Vlad-alco/BuhloWar/docs/STAGE3_MAX31865_PLAN.md

# Этап 3 — Точные датчики: MAX31865 + Pt100/Pt1000

**Статус: черновик для обсуждения. Код не написан.**
По AI_RULES.md: сначала согласование, код — только после «да» автора.
Дата: 2026-10-27. Согласован со старым анализом: `docs/DS18B20_vs_Pt100_BuhloWar.pdf`.

---

## 0. Резюме (TL;DR)

- Что делаем: заменяем DS18B20 на критичных каналах **TSAR и TANK** (опционально все 4) на платиновые датчики сопротивления **Pt1000** через модули **MAX31865**. SensorManager становится **маршрутизатором источников**: оператор выбирает для каждого слота «DS18B20» или «MAX31865», выбор хранится в EEPROM.
- Зачем: решения движка на TSAR принимаются с шагом 0.06 °C (шпора) и гистерезисом 0.24 °C — это размер одного младшего бита DS18B20 (0.0625 °C). Pt1000 + MAX31865 дают шаг ~0.03 °C, преобразование в 10+ раз быстрее и аналоговую измерительную петлю без «подвисаний» 1-Wire.
- Вся защита Этапа 1 (медиана-5, гейт, stale) и SIM-режим Этапа 2 работают поверх без изменений — они стоят выше по конвейеру данных.
- Ответы на вопросы по железу (кратко, подробно в разделах 3–5):
  1. **Pt1000 класс B, 2 контакта, 2 м силиконового кабеля — ПОДОЙДУТ.** Вклад проводов всего ~0.02–0.05 °C, и он постоянный — убирается штатной калибровкой смещения.
  2. **«Универсальных модулей нет» — почти правда.** Сама микросхема MAX31865 универсальна (Pt100 и Pt1000), но на плате запаян опорный резистор, задающий шкалу: **430 Ом — для Pt100, 4300 Ом — для Pt1000**. Напаивать ничего не нужно, если купить модуль под свой датчик (или плату с перемычкой выбора).

---

## 1. Зачем этот этап (проблема DS18B20 на критичных каналах)

DS18B20 — хороший цифровой датчик, и на TSA/AQUA его хватает с запасом: там управление относительное (охлаждение, безопасность), и даже ±0.5 °C ничего не ломает. Совсем другая ситуация на TSAR (ректификация) и TANK (куб):

- **Шпора**: стабилизация по дельте 0.06 °C, минимальная рабочая дельта 0.12 °C. Разрешение DS18B20 — 0.0625 °C, то есть один квант датчика равен целой рабочей дельте. Малейший шум или дрейф «съедает» сигнал.
- **Гистерезис ректификации** 0.24 °C и сравнения с двумя знаками после запятой.
- **Крепость по температуре**: погрешность 0.5 °C в узле отбора — это 1–2 % об. ошибки крепости (с учётом поправки 0.037 °C/мм рт. ст.).
- **СМЕНА ТАРЫ и БАКСТОП** по TANK: пороги 92 °C и 99 °C — тут запас побольше, но куб — вторая по важности точка.
- **1-Wire как шина**: все 4 датчика на одном проводе GPIO3. Подвисания, отдельные выбросы, обрывы — то, что мы уже огородили фильтрами Этапа 1. Фильтры лечат последствия, но не причину.

Pt1000 через MAX31865 убирает саму причину: измерительная петля аналоговая (провод + резистор), опрос в 10+ раз быстрее, «подвисаний» как у цифровой шины не бывает в принципе.

Сравнение в цифрах (для нашего диапазона 20–100 °C):

| Параметр | DS18B20 (как сейчас) | Pt1000 + MAX31865 |
|---|---|---|
| Разрешение | 0.0625 °C (12 бит) | ~0.03 °C (15-бит АЦП, опора 4300 Ом) |
| Время преобразования | 750 мс | 52–70 мс (фильтр 60/50 Гц) |
| Подвисания шины | бывают (1-Wire) | не бывают (аналоговая петля) |
| Влияние проводов 2 м | нет (цифровой) | ~0.02–0.05 °C (2-пров., Pt1000) — калибруется |
| Точность после калибровки смещения | ±0.2–0.5 °C | ±0.3–0.7 °C (класс B), лучше у класса A |
| Стабильность дельт во времени | шум 1–2 кванта | шум < 1 кванта |
| Цена канала (модуль + датчик) | ~50–150 руб | ~250–500 руб |

Главный выигрыш не в «абсолютной точности» (она сопоставима после калибровки), а в **разрешении, скорости и стабильности** — ровно в том, на чём держится шпора 0.06 °C.

---

## 2. Как это работает (объяснение для новичка)

**Pt1000** — это платиновая плёнка в герметичном корпусе-щупе, чьё сопротивление плавно растёт с температурой: 1000 Ом при 0 °C, ~1385 Ом при 100 °C, примерно +3.85 Ом на каждый градус. Это стандарт МЭК 60751, поэтому зависимость сопротивления от температуры описывается известной формулой (Каллендара–Ван Дюзена) — по измеренному сопротивлению температура вычисляется математически.

**Pt100** — то же самое, но 100 Ом при 0 °C и ~0.385 Ом/°C. Обозначение «B» после названия (Pt1000B) — класс допуска: для класса B погрешность не хуже ±(0.3 + 0.005·|t|) °C; класс A вдвое точнее — ±(0.15 + 0.002·|t|) °C.

**MAX31865** — микросхема-«переводчик» с сопротивления на цифру:

1. Пропускает небольшой ток через датчик и через **опорный (референсный) резистор** на плате.
2. 15-битный АЦП измеряет **отношение** падений напряжения «датчик / опора» (ratiometric-измерение). Поэтому точность почти не зависит от стабильности питания и тока — только от качества опорного резистора (на платах стоит прецизионный, 0.1 %).
3. Пересчитывает отношение в сопротивление, а температуру можно взять из формулы для платины.
4. Умеет аппаратно компенсировать сопротивление проводов в 3-проводной схеме и имеет **регистр неисправностей**: обрыв, короткое замыкание, выход за пороги — всё детектируется аппаратно.

Опорный резистор выбирается по правилу **R_опоры ≈ 4 × номинал датчика**: 400–430 Ом для Pt100, 4000–4300 Ом для Pt1000. Это и есть корень «неуниверсальности» плат — см. раздел 4.

---

## 3. Вопрос 1: Pt1000B, 2 контакта, силиконовый кабель 2 м — подойдут?

**Коротко: ДА, подойдут, и это хороший выбор именно для нашей задачи.** Вот вся математика, чтобы решение было осознанным.

### 3.1. Вклад проводов в 2-проводной схеме

В 2-проводной схеме измеряется сопротивление «датчик + оба провода». Кабель обычно 0.35–0.75 мм², медь ≈ 0.0175 Ом·мм²/м:

| Сечение кабеля | Сопротивление одного провода 2 м | Петля туда-обратно (2 провода) |
|---|---|---|
| 0.35 мм² | 0.10 Ом | 0.20 Ом |
| 0.5 мм² | 0.07 Ом | 0.14 Ом |
| 0.75 мм² | 0.05 Ом | 0.09 Ом |

Переводим в градусы:

- **Pt1000** (3.85 Ом/°C): петля 0.09–0.20 Ом = **+0.02…+0.05 °C** к показаниям. Это сдвиг **постоянный** — убирается один раз штатной калибровкой смещения в меню (она уже есть в системе и действует на любой источник). Дрейф: медь меняет сопротивление на 0.39 %/°C, при колебаниях температуры в помещении ±10 °C показания уплывут на ~0.001–0.003 °C — на фоне допуска самого датчика это в сотни раз меньше.
- **Pt100** (0.385 Ом/°C): та же петля дала бы **+0.24…+0.53 °C** — вот тут 3-проводная схема уже желательна. Это иллюстрация, почему выбран именно Pt1000: он в 10 раз менее чувствителен к проводам.

### 3.2. Класс B — достаточно ли?

Класс B: допуск ±(0.3 + 0.005·|t|) °C → при 78 °C это ±0.69 °C «от завода». Звучит страшно, но смотрим, что реально нужно:

- Шпора и гистерезис — это **дельты и стабильность во времени**, а не абсолютная истина. Платина класса B стабильна и монотонна: два отсчёта через минуту честно показывают разницу 0.03 °C, если она есть.
- Абсолютный сдвиг (если он есть) **калибруется** штатным меню смещения — сверили с эталонным термометром в кубе, внесли поправку.
- Остаточная нелинейность класса B гладкая, рывков по кривой нет.

Если попадётся **класс A** за разумную цену — берите, будет чуть лучше без каких-либо изменений в остальном. Но специально переплачивать не нужно.

### 3.3. Силиконовый кабель

Силиконовая изоляция держит 180–200 °C непрерывно. У нас максимум в точке замера — пар до ~100–120 °C (куб/царга). Запас более чем достаточный, гибкость на холоде тоже плюс.

### 3.4. Вывод по вопросу 1

- Для TSAR и TANK — **Pt1000B 2-провод, 2 м — подойдут**. Сдвиг от проводов ~0.03 °C, калибруется, дрейфа практически нет.
- Если встретите **3-проводную** версию Pt1000 — можно взять (компенсация провода аппаратная, «на вырост»), но обязательности нет.
- А вот для гипотетического Pt100 2-провод на 2 м — 3 провода были бы уже важны. Разница между «2 или 3 контакта» — только в этом.

---

## 4. Вопрос 2: «универсальных модулей нет» — что с этим делать

### 4.1. Что именно не универсально

Микросхема **MAX31865 универсальна**: поддерживает и Pt100, и Pt1000, и 2/3/4-проводные схемы — всё это настраивается. **Не универсальна плата-модуль**, и только в одной детали: на ней запаян опорный резистор, который задаёт шкалу измерения (правило: R_опоры ≈ 4 × номинал датчика):

| Опорный резистор на плате | Подходит для | Нельзя ставить с |
|---|---|---|
| **430 Ом** (маркировка «4300») | Pt100 | Pt1000 — шкала уплывает, ток через датчик в ~10 раз выше проектного → самонагрев растёт в разы; выше ~185 °C упёрлись бы в потолок АЦП |
| **4300 Ом** (маркировка «4301») | Pt1000 | Pt100 — разрешение падает в 10 раз, нижний порог обнаружения отказа теряется |

Так что фраза «для разных датчиков нужно напаивать разные сопротивления» — **верна, но относится к опорному резистору на плате**, и решается проще: **напаивать ничего не надо, если купить плату под свой датчик**.

### 4.2. Практические варианты покупки (для наших Pt1000)

1. **Модули «MAX31865 PT1000»** — на них с завода стоит опора 4300 Ом. Самый простой путь: купил, подключил, работает.
2. **Платы с двумя опорами и перемычкой** (бывают, продаются как «PT100/PT1000»): выбор — переставить джампер/перемычку. Тоже без пайки.
3. **Pt100-платы с перепайкой опоры** — только если очень недорого достались: выпаять 430 Ом, впаять 4300 Ом 0.1 % (SMD, маркировка «4301»). Это 5–10 минут пайки, но требует аккуратности и желательно фена. Для нас — последний вариант.

### 4.3. Как проверить купленную плату (30 секунд)

- Посмотреть маркировку SMD-резистора возле надписи REF: **«4300» = 430 Ом (Pt100)**, **«4301» = 4.3 кОм (Pt1000)**.
- Или мультиметром без питания: сопротивление между контактом REF+ и GND платы ≈ 430 Ом или ≈ 4300 Ом.
- В описании товара должно быть явно: «PT1000» / «4300 ohm reference» / «для Pt1000».

### 4.4. Вывод по вопросу 2

Поняли вы правильно, но пугаться нечего: это ограничение **платы, а не микросхемы**, и оно обходится правильным выбором товара. Для нашего плана нужно искать модули **под Pt1000 (опора 4300 Ом)** — либо платы с перемычкой выбора.

---

## 5. Про 2/3/4 провода — как это устроено на плате

- **2 провода**: простое подключение; на плате надо замкнуть перемычки под 2-проводную схему (на типовых модулях это solder-jumpers, подписаны «2/3 Wire» и «2 Wire» — по маркировке конкретной платы). Сопротивление проводов входит в измерение (для Pt1000 при 2 м это ~0.03 °C — см. раздел 3).
- **3 провода**: третий провод позволяет плате **аппаратно вычесть** сопротивление проводов (режим 3-wire в конфигурации микросхемы). Стандарт для промышленных щупов.
- **4 провода**: максимум точности (полное исключение проводов), для нашего диапазона избыточно.
- На прошивку выбор влияет одним параметром конфигурации канала — закладываем поддержку 2- и 3-проводной схем, по умолчанию — та, под которую куплены датчики.

---

## 6. Список покупок

**Минимум (Этап 3 в базовом объёме — TSAR и TANK):**

| Что | Кол-во | Примечание |
|---|---|---|
| Модуль MAX31865 под Pt1000 (опора 4300 Ом) или с перемычкой 430/4300 | 2 | проверить маркировку REF при получении |
| Датчик Pt1000 щуп, класс B (или A) | 2 | 2-провод ок; 3-провод — «на вырост»; силикон 180 °C+ |

**С запасом (перевести все 4 канала сразу):**

| Что | Кол-во | Примечание |
|---|---|---|
| Модуль MAX31865 под Pt1000 | 4 | TSA и AQUA присоединятся позже программно |
| Датчик Pt1000 | 4 | |

Цена вопроса в базовом объёме — ориентировочно 500–1000 руб за всё. Отдельная линия 1-Wire и её питание остаются как есть — DS18B20 остаются источниками по умолчанию и запасным вариантом.

---

## 7. Подключение к ESP32-S3

SPI у платы уже занят SD-картой — модули MAX31865 садятся **на ту же шину**, у каждого свой выбор чипа (CS). Это штатная практика: SPI мультиплексирует устройства по CS, а разные настройки (SD и MAX31865 используют разные SPI-режимы) применяются в рамках отдельных транзакций.

| Сигнал | GPIO | Откуда | Примечание |
|---|---|---|---|
| SCK | 14 | SD_SPI_SCK | общий с SD |
| MISO | 12 | SD_SPI_MISO | общий с SD |
| MOSI | 13 | SD_SPI_MOSI | общий с SD |
| CS модуля №1 (TSAR) | **10** | свободный | выбор канала MAX #1 |
| CS модуля №2 (TANK) | **11** | свободный | выбор канала MAX #2 |
| VCC | 3.3 В | — | питание модуля (НЕ 5 В) |
| GND | GND | — | общий с платой |

Пояснения и предосторожности:

- **Почему 10 и 11**: заведомо свободны на любых вариантах платы. Ранее в свободных фигурировали GPIO 35–36 — на платах с восьмиканальным (Octal) PSRAM (наш N16R8 как раз такой) они заняты памятью, привязываться к ним не будем. GPIO37 уже занят клапаном голов, GPIO38 — клапаном тела, GPIO39–41/45/0/1 оставляем в резерве на будущее (в т.ч. на случай 3–4 модулей: CS тогда на 39–41).
- Монтажные линии SPI (SCK/MOSI/MISO) от ESP32 к модулям — короче 10–15 см, модули размещаем у блока электроники; датчики соединяются с модулями 2-м кабелем — аналоговой петле длина не страшна (это не 1-Wire).
- В зоне силовых реле/ТЭН кабель датчика — витой, а экран (если есть) сажать на GND платы **одним концом** (двумя концами получится антенна-контур).
- Конденсатор по питанию на каждый модуль обычно уже стоит на плате; дополнительно ничего не нужно.

---

## 8. Архитектура в прошивке (без кода — только принципы)

1. **SensorManager — маршрутизатор источников.** Конвейер Этапа 1 (сырой отсчёт → медиана-5 → гейт → stale-детектор → среднее) не меняется. Добавляется только самый первый узел: «откуда брать сырой отсчёт» — из 1-Wire (DS18B20) или из MAX31865. На каждый слот — свой флаг источника.
2. **Драйвер MAX31865** — отдельный небольшой модуль: настройка канала (тип датчика, число проводов, непрерывный режим), чтение результата раз за цикл опроса (темп опроса остаётся тем же, что у DS18B20 — запас по скорости огромный), чтение регистра неисправностей.
3. **Неисправности → знакомая логика.** Обрыв/КЗ по регистру MAX31865 маппится в «датчик не подключён» (isConnected=false) — счётчики СИГНАЛ, SD-лог и поведение движка работают ровно как с обрывом DS18B20, ничего нового оператору учить не надо.
4. **EEPROM**: флаги источников хранятся в конфиге (новое поле добавляется миграционно-безопасно — с сохранением всех текущих настроек; механика версий конфига в preferences уже есть). После перезагрузки выбор источников сохраняется (в отличие от SIM — он и остаётся «пока не выключили»).
5. **Калибровка**: существующие меню смещений по слотам действуют одинаково для обоих источников — калибруем «то, что показывает система», независимо от железа.
6. **SIM-режим**: в активном SIM данные подменяет симулятор **независимо от выбранных источников** — полигон остаётся консистентным, аналогии с Этапом 1 не ломаются (подтвердить — вопрос 2 в разделе 10).
7. **Веб и LCD**: выбор источника — в веб-настройках слотов; в меню LCD (слоты + предзапусковый экран) источник встраивается в Этапе 4, как и планировалось.
8. **Что НЕ делаем** (по правилу AI_RULES №5 — не усложнять ради гипотетики): никакого автопереключения на DS18B20 при сбое MAX без явного решения автора, никакой двойной параллельной записи телеметрии. SPI-совместное использование решается штатными транзакциями — дополнительная синхронизация сверх этого не планируется.

---

## 9. Поэтапный план внедрения (малыми шагами, проверка после каждого)

Каждый шаг: сборка обоих окружений (core 3.x и 2.x), при затрагивании веба — headless-тесты, запись в CHANGELOG, push. Очередной шаг не начинается, пока предыдущий не проверен.

1. **Шаг 1 — драйвер MAX31865** (отдельный модуль) + сервисный вывод в Serial для стендовой проверки чтения. Логика процесса не трогается вообще.
2. **Шаг 2 — маршрутизатор для слота TSAR**: источник по умолчанию DS18B20, EEPROM-поле, миграция настроек без сброса.
3. **Шаг 3 — веб**: выбор источника TSAR в настройках, счётчики СИГНАЛ для MAX-канала. Headless-тесты обеих страниц.
4. **Шаг 4 — слот TANK** (второй модуль, CS GPIO 11). Повтор шагов 2–3 для второго канала.
5. **Шаг 5 — столовый тест** (это НЕ запуск процесса, риск нулевой): стакан с водой/льдом — 0 °C, воздух — комнатная, сравнение с лежащим рядом DS18B20; калибровка смещения.
6. **Шаг 6 — прогоны в SIM** (источники подменяются симулятором), регрессии сессий 20–22, CHANGELOG, итоговый push.

Тест на реальном процессе по-прежнему невозможен (ограничение до полугода) — Этап 3 закрывается стендом + SIM, как и Этапы 1–2.

---

## 10. Открытые вопросы к автору (нужны ответы до кода)

1. **Объём этапа**: переводим 2 канала (TSAR, TANK) или сразу 4 (модули взять партией)? Рекомендация: купить 4 модуля/датчика сразу (дёшево, останется запас), но программно идти по шагам 2→4 (TSAR, потом TANK).
2. **SIM поверх источника**: подтверждаешь, что в активном SIM симулятор перекрывает выбранный источник (как описано в разделе 8)?
3. **Поведение при неисправности MAX31865**: вариант A — показать «датчик неисправен» и оставить как есть (предлагаю: предсказуемо, без сюрпризов); вариант B — авто-возврат на DS18B20, если он физически подключён. Выбирает автор.
4. **CS на GPIO 10 и 11** — подтверждаешь? (35–36 исключил из-за Octal-PSRAM на N16R8.)
5. **Pt1000B 2-провод** — берем (см. раздел 3); если попадётся 3-провод по хорошей цене — брать, прошивка поддержит оба варианта. Подтверди, что 2 шт. уже почти куплены (TSAR + TANK).

---

## 11. Ссылки

- `docs/DS18B20_vs_Pt100_BuhloWar.pdf` — исходный сравнительный анализ (точность, допуски, пороги BuhloWar).
- MAX31865 datasheet — Analog Devices (измерительное ядро, регистр неисправностей, 2/3/4-провод).
- Adafruit MAX31865 guide — практические схемы подключения и перемычки 2/3-провод (референс 430 Ом 0.1 % — для Pt100; для Pt1000 ищем 4300 Ом).
