Vlad-alco/BuhloWar/docs/USER_GUIDE.html

☰

BuhloWar · Руководство оператора

✕

Развернуть всё

↑

# BuhloWar — подробное руководство для новичка

От первого включения до конца первого процесса: что настроить, зачем, на что это влияет и какие результаты ожидать.

Нажимайте на разделы в меню слева (на телефоне — кнопка ☰ сверху). Все разделы можно раскрывать и сворачивать, есть поиск по тексту.

Прошивка: BuhloWar v2.0 · Контроллер: ESP32-S3 · Интерфейсы: LCD 20×4 + Web · Дистилляция и ректификация

1О системе и как пользоваться руководством▶

BuhloWar — это автоматика для домашнего самогонного аппарата на контроллере ESP32-S3. Она берёт на себя рутинный контроль перегонки: управляет нагревом, водой охлаждения, клапанами отбора и мешалкой, следит за температурами и атмосферным давлением, автоматически проходит все этапы процесса и вовремя останавливает отбор. От вас требуется правильно настроить систему один раз, залить брагу и запускать процесс — остальное система сделает сама.

Система поддерживает два основных процесса:

- Дистилляция (DIST) — обычная перегонка браги на спирт-сырец. Быстро, просто, с автоматической сменой тары и остановкой по температуре куба.
- Ректификация (RECT) — работа с колонной: автоматическая стабилизация «на себя», отбор голов по методу (Стандарт или КСС), отбор тела с двумя методами регулировки (Шпора или Стандарт/Overhist) и автоматическим финишем.

Управлять системой можно двумя способами — они равноправны и синхронизированы между собой:

- Дисплей 20×4 с 4 кнопками (ВВЕРХ, ВНИЗ, SET, BACK) — меню на корпусе: запуск, настройки, калибровка датчиков, экран процесса.
- Веб-интерфейс в браузере — с телефона или компьютера: большие цифры, графики-схема аппарата, мониторинг в реальном времени, калибровочные мастера, профили и инженерное меню.

### Как устроено это руководство

Разделы 1–9 — подготовка (железо, первое включение, калибровки и все настройки с пояснениями «что это и на что влияет»). Разделы 10–11 — пошаговые сценарии обоих процессов «от заливки браги до выключения». Разделы 12–16 — мониторинг, аварийные ситуации, обслуживание, частые проблемы и краткая шпаргалка. Если вы уже настроили систему, для повседневной работы вам достаточно разделов 10–11 и 16.

Условные обозначения
Плашка СОВЕТ — полезный практический приём. ВАЖНО — от этого зависит результат. ОПАСНО — риск для оборудования или человека. Значения по умолчанию указаны так: параметр (по умолчанию).

Важно о данныхВсе настройки хранятся в памяти контроллера (EEPROM) и переживают выключение питания. Калибровки датчиков и клапанов хранятся там же. Сброс настроек к заводским происходит только при намеренной очистке EEPROM.

2Безопасность — прочитать до включения▶

Система автоматизирует процесс, но не отменяет элементарных правил работы с самогонным аппаратом. Автоматика — помощник, а не замена вашей ответственности.

Опасно — обязательно к исполнению

- Никогда не оставляйте работающий аппарат полностью без присмотра на длительное время. Система следит за датчиками, но физические проблемы (протечки, засор, обрыв трубки) датчики не видят.
- Проверяйте подачу охлаждающей воды до начала нагрева. Система открывает водяной клапан и показывает экран «WATER TEST» именно для этого — не пропускайте проверку.
- Электрика: силовая часть 220 В должна быть собрана на реле/контакторах с опторазвязкой, корпус аппарата — заземлён. Не трогайте силовые клеммы во время работы.
- Не герметизируйте систему наглухо — в кубе всегда должен быть безопасный путь сброса давления, предусмотренный вашим аппаратом.
- Помещение — с вентиляцией. Пары спирта горючи; никаких открытых огней рядом.

### Что система делает сама, если что-то идёт не так

- Перегрев по датчику TSA (температура выше выставленного лимита tsaLimit) — зуммер подаёт сигнал (3 коротких сигнала каждые 30 секунд), на экране начинается обратный отсчёт «ALARMTSA». Если за время VREAC (по умолчанию 3 мин) температура не вернулась в норму, система сама переходит к процедуре завершения: гасит нагрев, закрывает клапаны, оставляет воду охлаждения открытой.
- Перегрев корпуса/бокса (датчик BME280, температура выше BOX_TPR) — внимание: 2 коротких сигнала каждые 30 секунд и надпись «ATTENT». Аварийного отключения нет — но вам стоит проверить охлаждение электроники.
- Нерабочий датчик — запуск процесса блокируется с указанием проблемных датчиков, пока вы не откалибруете/не почините их.
- Пропажа датчика во время аварии TSA — тревога не сбрасывается, отсчёт VREAC продолжается: система завершит процесс по правилам аварии.

СоветПервые 2–3 процесса наблюдайте за системой рядом. Автоматика отлично держит процесс, но именно первые запуски покажут, правильно ли собрана обвязка, верно ли стоят датчики и совпадают ли ваши ожидания с настройками.

3Из чего состоит система▶

Коротко о «железе», которым управляет прошивка. Понимание состава поможет вам правильно подключить оборудование и понять, о чём система сообщает.

### Контроллер и индикация

Компонент | Что делает | Комментарий
ESP32-S3 | Мозг системы: логика процессов, веб-сервер, WiFi | Плата ESP32-S3-DevKitC-1 (N16R8)
LCD 20×4 | Меню и экран процесса | Подключение по I2C (адрес 0x27 или 0x3F)
4 кнопки | ВВЕРХ / ВНИЗ / SET / BACK | Навигация по всем меню
Зуммер | Сигналы тревоги и внимания | 3 коротких — тревога TSA, 2 коротких — внимание BOX
Карта microSD | Файлы веб-интерфейса (папка /www), WiFi-конфиг, журналы процессов, профили | Без карты веб-интерфейс не откроется
Часы DS3231 | Реальное время (при наличии интернета сверяется с NTP) | На той же шине I2C

### Датчики

Имя | Типовая точка установки | Для чего используется в процессах
TANK | Куб (брага) | Разгон до уставки RAZGON, смена тары (MIDTERM), аварийный стоп BAKSTOP, расчёт крепости в кубе
TSAR | Царга / колонна | Прогрев колонны (WAITING), стабилизация (NASEBYA), опорная температура тела rtsarM, реакции Δ и «Залёт», крепость отбора при RECT
TSA | Верх колонны / паровая зона | Аварийный контроль: превышение TSA ЛИМИТ запускает отсчёт VREAC и аварийное завершение
AQUA | Вода охлаждения / выход дефлегматора | Мониторинг охлаждения (отображается на экране процесса)
BME280 | В корпусе электроники | Атмосферное давление (поправки порогов и крепости), температура и влажность в боксе (контроль перегрева)

ИнфоВсе четыре DS18B20 подключаются на одну шину 1-Wire (резистор 4,7 кОм на +3,3 В). Какой датчик какую роль выполняет — решаете вы при калибровке (раздел 5): система различает их по нагреву.

### Исполнительные механизмы (выходы)

Выход | Нагрузка | Пояснение
Контактор | Главное силовое реле 220 В | Подача питания на нагрев
ТЭН, канал 1 | Реле «рабочего» нагрева | Держит температуру после разгона
ТЭН, канал 2 | Реле «полной» мощности | Включается на разгоне (если FULL PWR/RECT) для быстрого выхода на режим
Клапан ГОЛОВЫ | Электромагнитный клапан 220 В (НЗ) | Отбор головных фракций
Клапан ТЕЛО | Электромагнитный клапан 220 В (НЗ или НО — настраивается) | Отбор тела и (при отсутствии клапана голов) отбор голов
Клапан ВОДА | Соленоид 12 В | Подача охлаждающей воды
Мешалка | Реле 12 В | Периодическое перемешивание браги в кубе (работает циклами вкл/выкл)

Важно про НЗ и НОНЗ (NC — normally closed) клапан закрыт, когда на реле нет напряжения, и открывается при подаче. НО (NO — normally open) — наоборот. Тип клапана тела задаётся настройкой VALVEBODY (NC/NO). Если указать тип неверно, клапан будет «работать наоборот» — закрыт во время отбора и открыт в паузах. При первом запуске проверьте реакцию клапана кнопками ручного управления или тестом клапана.

### Конфигурации клапанов, которые понимает система

- Конфиг 1: есть клапан голов + клапан тела (НЗ) — полный автомат, оба отбора импульсные.
- Конфиг 2: только клапан голов + клапан тела НО — тело отбирается «открытым клапаном», скорость регулируется вручную/дефлегматором.
- Конфиг 3: клапана голов нет — головы и тело отбираются одним НЗ клапаном тела (для голов используется отдельная пропускная способность BCH).
- Конфиг 4: клапана голов нет, клапан тела НО — головы и тело вручную, система отслеживает объёмы по расчёту.

4Первое включение и подключение к Web▶

### Что подготовить до первого включения

1

Карта microSD. Отформатируйте в FAT32 и запишите: папку /www с файлами веб-интерфейса (index.html, index_landscape_knob.html и остальные файлы из репозитория) — без них браузер покажет «File Not Found».

2

WiFi-конфиг (по желанию). Чтобы система сама подключалась к домашней сети, положите на карту файл wifi_config.txt вида:

ssid1=ИмяВашегоРоутера
pass1=ПарольРоутера
ssid2=ЗапаснаяСеть
pass2=ПарольЗапасной

Вторая сеть необязательна — это запасной вариант (например, дача/гараж). Строки можно не все: минимум нужен ssid1.

3

Подключите оборудование по схеме вашего аппарата: датчики в нужные точки, клапаны, воду, ТЭН через контактор. Проверьте каждую клемму до подачи питания.

### Первое включение: что вы увидите

Подайте питание. На LCD последовательно появятся:

- Starting Web… → Web: 192.168.4.1 — система подняла собственную точку доступа и веб-сервер;
- Connecting WiFi… → далее три варианта: IP: x.x.x.x (подключилась к вашей сети), AP: ESP32 (конфига нет или сети недоступны), OFFLINE Mode (нет карты/сети — управление только кнопками);
- стартовый экран BUHLOWAR SYSTEM, затем главное меню: DIST / RECT / SETTINGS / SENSORS.

Инфо о сетиСистема всегда держит включённой собственную точку доступа: имя ESP32, пароль 12345678, адрес 192.168.4.1. Одновременно с этим (режим AP+STA) она может быть подключена к домашнему роутеру — тогда интерфейс доступен и по локальному IP, который показывается на LCD. Значок сети на экране процесса: W — подключено к роутеру, A — только точка доступа, X — офлайн.

### Заходим в веб-интерфейс

1

На телефоне/ноутбуке подключитесь к WiFi ESP32 (пароль 12345678). Некоторые телефоны предупреждают «нет интернета» — соглашайтесь остаться в сети.

2

Откройте браузер и введите 192.168.4.1. Загрузится тёмный интерфейс. Основной вариант — горизонтальный (landscape) с разделами: Мониторинг, Дистилляция, Ректификация, Датчики, Настройки и большой кнопкой СТАРТ/СТОП. Компактный вертикальный вариант — index.html.

3

Если система подключена к вашему роутеру, удобно заходить по её локальному IP (показывается на LCD) — тогда вы останетесь в домашней сети и получите интернет на телефоне.

СоветФайл wifi_config.txt читается только при старте. Изменили его — перезагрузите систему. Если роутер раздаёт и 2,4 ГГц, и 5 ГГц под одним именем — ESP32 видит только 2,4 ГГц.

### Чек-лист первого включения

- ☐ Карта SD вставлена, папка /www на месте
- ☐ LCD включился, меню реагирует на кнопки
- ☐ Точка доступа ESP32 видна, веб-интерфейс открывается
- ☐ Датчики показывают температуры (раздел «Датчики» в web или меню SENSORS на LCD)
- ☐ Вода: ручное открытие клапана воды даёт поток воды
- ☐ Клапаны щёлкают при тесте (раздел 6), направление действия совпадает с типом (NC/NO)
- ☐ Зуммер: кнопка «ТЕСТ ЗВУКА» в Настройках web

5Калибровка датчиков температуры▶

Все четыре датчика DS18B20 одинаковые — система не знает, какой из них воткнут в куб, а какой в царгу. Калибровка = привязка физического датчика к слоту (TANK, TSAR, TSA, AQUA). Пока датчики не откалиброваны, запуск любого процесса блокируется с экраном «SENSOR NOT READY: …».

### Как это работает

При запуске калибровки система сканирует шину и запоминает показания всех найденных датчиков. Дальше нужно нагреть нужный физический датчик примерно на 5 °C (зажать в ладони, приложить тёплый предмет, окунуть в тёплую воду — не горячее 50 °C) в течение 30 секунд. Система увидит, у какого датчика температура выросла больше чем на 5 °C, и привяжет именно его к выбранному слоту. Адрес сохраняется в EEPROM — повторная калибровка нужна только при замене датчика или смене ролей.

### Способ 1 — через LCD

1

Главное меню → SENSORS. На экране четыре строки: TSA, AQUA, TSAR, TANK; у неоткалиброванных написано NOT CALIB, у откалиброванных — текущая температура.

2

Кнопками выберите слот, нажмите SET. В строке появится heat up.

3

Грейте нужный физический датчик, пока система не определит его (адрес сохранится автоматически, в строке появится температура). BACK — отменить калибровку.

### Способ 2 — через Web

1

Откройте страницу «Датчики». Здесь четыре плитки с текущими температурами и статусами.

2

Нажмите плитку нужного слота (например, TANK) и нагрейте соответствующий физический датчик на 5 °C. Подтвердите сохранение в появившемся диалоге.

Практический приёмКалибруйте датчики по очереди и подписывайте провода. Проверка после калибровки: подогрейте один датчик — его температура должна измениться только в его плитке/строке. Если «поехал» другой — перепутаны датчики на шине, перекалибруйте.

ВажноКалибруйте датчики в том виде, в каком они будут работать: длинный TANK-датчик в гильзе куба нагревается медленнее, чем «голый» — прихватите его в ладони вместе с гильзой или используйте тёплую воду. Таймаут калибровки — 30 секунд, не тяните.

### Проверка давлений BME280

BME280 отдельной калибровки не требует. Убедитесь только, что на странице «Датчики»/в мониторинге отображаются давление (примерно 990–1040 гПа), температура и влажность. Если BME280 отсутствует, система продолжит работать: давление примется равным 760 мм рт. ст. (1013,25 гПа), поправки на давление отключатся, а контроль перегрева бокса не будет выполняться — в логе появятся соответствующие предупреждения.

6Клапаны: типы, тайминги, пропускная способность▶

Отбор голов и тела система выполняет импульсами: клапан открывается на open миллисекунд, закрывается на close миллисекунд — и так по кругу. Средняя скорость отбора = пропускная способность клапана × доля открытого состояния. Поэтому системе нужны две группы данных: тайминги (сколько миллисекунд держать клапан в цикле) и capacity (сколько миллилитров в минуту реально проливает полностью открытый клапан).

### Где что настраивается

Параметр | Где | Что задаёт
HEAD OPN / HEAD CLS (1/10 с) | RECT → SETUP (LCD), страница «Ректификация» (web: тайминги клапанов) | Цикл клапана голов: открытие/закрытие, секунды (1–60)
BODY OPN / BODY CLS (2/10 с) | там же | Цикл клапана тела, секунды (1–60)
HCAP, BCAP, B0CAP (мл/мин) | RECT → SETUP (LCD); web: мастер калибровки | Пропускная способность: клапан голов, клапан тела НЗ, клапан тела НО
BCH (мл/мин) | Web: страница «Ректификация» → «Калибровка клапанов» | Пропускная способность НЗ клапана тела на скорости голов (для конфига без клапана голов; 0 = не калиброван, берётся HCAP)
MINOPEN (100 мс) | LCD SETTINGS, web | Минимальное импульсное открытие. База для расчёта циклов: большие скорости = более длинные импульсы (меньше износ клапана), малые = минимальный импульс и длинная пауза
SP_H_COR, SP_B_COR (100 %) | LCD SETTINGS; web: мониторинг, панель «Головы» и «Тело» (кнопки −/+) | Ручная коррекция скорости отбора голов/тела в процентах (10–200 %). 100 % = номинал. 110 % = отбор на 10 % быстрее
VALVEBODY (NC) | RECT → SETUP, web «Ректификация» | Тип клапана тела: НЗ/НО
USE HEAD VALVE (YES) | там же | Есть ли в вашей системе отдельный клапан голов
VALVE USE (NO) | DIST → SETUP, web «Дистилляция» | Использовать ли клапан отбора в дистилляции (NO = отбор постоянно открыт, как в классической перегонке)

### Мастер калибровки клапанов (Web)

Самый удобный способ узнать пропускную способность — калибровочный мастер. Он есть для трёх клапанов: ГОЛОВЫ, ТЕЛО НЗ, ТЕЛО НО (страница «Ректификация» → «Калибровка клапанов» → кнопка «Калибровать»). Проводится на работающей колонне/аппарате, когда есть что проливать:

1

Пролив (сухой тест). Клапан отрабатывает циклы открыть/закрыть заданное время (ПРОЛИВ, по умолчанию 10 с). Так вы слышите/видите, что клапан щёлкает и жидкость идёт.

2

Замер capacity. Клапан открывается импульсами 1 с/1 с в течение КАЛИБР. CAPACITY (по умолчанию 60 с). Подставьте мензурку и соберите дистиллят.

3

Ввод объёма. Введите собранный объём в мл и нажмите «РАССЧИТАТЬ И СОХРАНИТЬ». Система посчитает мл/мин и запишет capacity в EEPROM.

ВажноЕсли во время шага 2–3 прервать калибровку или ввести 0 — в EEPROM запишется ноль, и система будет считать, что клапан не калиброван (для KSS-отбора включится аварийный минимум 1 мл/мин с предупреждением в логе). После «пустой» калибровки обязательно перекалибруйте клапан.

### Тест клапанов и расчёт без мастера

На web-странице клапанов есть раздельные тесты ГОЛОВЫ/ТЕЛА: клапан работает циклами с текущими таймингами заданное время (TESTTIME/тест, 30–300 с), затем система спросит, сколько мл отобралось, и рассчитает фактическую скорость кнопкой «РАССЧИТАТЬ». Это и проверка механики, и способ откалиброваться вручную. Значения capacity также можно задать просто цифрами в HCAP/BCAP/B0CAP.

СоветКалибруйте клапаны в тех условиях, в которых они будут работать: тот же нагрев, то же давление в колонне, та же температура. Capacity «на холодную» будет заметно отличаться от рабочего.

### Ручное управление

Когда процесс не запущен, веб-интерфейс позволяет включать/выключать нагрев, воду, мешалку и открывать/закрывать каждый клапан вручную — используйте это для проверки обвязки перед первым процессом. На LCD ручное управление недоступно — только через Web.

7Общие настройки (SETTINGS)▶

Это настройки, общие для обоих процессов. На LCD: главное меню → SETTINGS. В Web: страница «Настройки». Изменения сохраняются при выходе из меню (LCD) или кнопкой «СОХРАНИТЬ» (web).

Параметр | Диапазон (по умолчанию) | Что это и на что влияет
VREAC — время аварии | 1–10 мин (3) | Сколько минут система ждёт возврата TSA в норму, прежде чем аварийно завершить процесс. Больше — терпеливее к кратковременным скачкам; меньше — быстрее реагирует на реальную проблему.
NASEB — стабилизация «на себя» | 1–30 мин (10) | Длительность первого этапа NASEBYA в ректификации: колонна работает без отбора и выходит на режим. Слишком мало — голов и тела в колонне не разделятся; слишком много — просто потеря времени.
VKLAP — повторная стабилизация | 1–30 мин (10) | Длительность NASEBYA после «Залёта» (заброса колонны) в методе Стандарт. Логика та же, что у NASEB, но для повторных входов.
BOX_TPR — максимум температуры бокса | 50–70 °C (60) | Порог внимания по датчику BME280: превышение — периодический сигнал и надпись ATTENT. Защищает электронику от перегрева (проверьте вентиляцию корпуса, а не снижайте порог наугад).
POWER — мощность, Вт | 100–7000 (3500) | Самый недооценённый параметр. Это не «уровень нагрева», а число для расчёта: все скорости отбора считаются как мл/ч/кВт × кВт. Если POWER не совпадает с реальной мощностью нагрева, головы и тело будут отбираться быстрее или медленнее расчётных. Ставьте фактическую потребляемую мощность.
AS_VOL — объём спирта-сырца, мл | 1000–10000 (5000) | Сколько абсолютного спирта (АС) вы залили в куб. От него считаются объёмы голов (доли) и прогноз времени тела. Указывайте честно: занизите — голов отберётся меньше (плохой продукт), завысите — отберёте больше голов, чем нужно, с потерями спирта.
MINOPEN — мин. открытие | 50–2000 мс (100) | Базовая длительность импульса клапана (см. раздел 6). Влияет на износ клапана и плавность регулировки.
SP_H_COR / SP_B_COR | 10–200 % (100) | Коррекция скорости голов/тела. Быстрая ручка «на глаз» прямо во время процесса из панели мониторинга.
WIFI CHK | 1–5 мин (5) | Как часто система проверяет WiFi и восстанавливает связь. На домашнюю перегонку влияет слабо.

### Настройки, доступные только через Web «Настройки»

- ГОЛОВЫ (мл) — явный объём голов для метода Стандарт (0 = авто: 10 % от АС). Используйте, если считаете головы по своей таблице, а не по проценту.
- Облако — режим ВКЛ/ВЫКЛ, адрес сервера и ключ: удалённый мониторинг через внешний сервис. Не пользуетесь — оставьте ВЫКЛ.
- Логи — кнопка просмотра журнала процессов (что система делала и когда).
- ТЕСТ ЗВУКА — проверка зуммера.
- Профили — сохранить/загрузить комплекты настроек (раздел 9).

Где физически хранитсяВсе значения живут в EEPROM контроллера. Веб-настройки применяются сразу после «СОХРАНИТЬ». LCD-меню сохраняет при выходе из меню кнопкой BACK.

8Инженерное меню (⚙)▶

Инженерное меню открывается шестерёнкой ⚙ в правом верхнем углу страницы «Настройки» веб-интерфейса. Здесь живут «константы технологии» — то, что обычно настраивают один раз под свой аппарат и больше не трогают. Если не уверены, что понимаете параметр — оставьте значение по умолчанию.

### Скорости отбора

Параметр | По умолчанию | Смысл и влияние
ГОЛОВЫ, мл/ч/кВт | 50 | Скорость отбора голов = 50 × кВт. При 3 кВт — 150 мл/ч. Медленный отбор голов — основа чистого продукта. Увеличивать не стоит; уменьшить — можно (дольше, но чище).
ТЕЛО, мл/ч/кВт | 500 | Скорость тела = 500 × кВт (3 кВт → 1500 мл/ч). Основная рабочая скорость ректификации. Завышение ведёт к «размазыванию» колонны и подмесу голов в тело.
ДООТБОР ГОЛОВЫ, мл/ч | 50 | Пока идёт отбор тела, клапан голов продолжает капать с этой скоростью — «хвосты голов» не остаются в колонне. Независимо от мощности.

### Параметры Шпоры (метод тела при CYCLE=1 и НЗ-клапане)

Параметр | По умолчанию | Смысл и влияние
КОЭФФ. СНИЖЕНИЯ ОТБОРА | 1.13 | Во сколько раз снижается скорость тела, когда температура царги поднялась на Δ выше опорной. Меньше (например 1.08) — мягче реакция, больше снижений; больше (1.2) — редкие, но резкие шаги.
СТАБИЛИЗАЦИЯ, сек | 60 | Минимальная пауза между снижениями скорости: колонне нужно время увидеть эффект шага. Слишком часто менять скорость — «качели».
МИН. СКОРОСТЬ ТЕЛО, мл/ч | 300 | Если после снижений скорость упала до этой — тело закончилось, система завершает процесс автоматически. Повышение порога = раньше финиш, меньше «хвостов» в теле.

### Доли отбора голов (в % от объёма АС)

Параметр | По умолчанию | Когда используется
СТАНДАРТ | 10 % | Метод голов ST: отбор одним этапом 10 % от АС (или явный объём «ГОЛОВЫ, мл», если задан)
КСС СПИТ | 2 % | Метод KSS, этап 1: «плевок» — клапан полностью открыт, самая головная часть отбирается быстро
КСС СТАНД. | 3 % | Метод KSS, этап 2: основной медленный отбор голов
КСС АКАТЕЛО | 15 % | Метод KSS, этап 3: «добор» на скорости тела — переходная зона голов→тело

### Давление

Параметр | По умолчанию | Смысл и влияние
КОЭФФ. КОРРЕКЦИИ ПО АД, °C/гПа | 0.028 | Атмосферное давление меняет температуру кипения. Система запоминает опорное давление в начале отбора тела и сдвигает пороги Δ/Залёт на (текущее − опорное) × 0.028. Меньше коэффициент — меньше чувствительность к погоде.

### Время этапов

Параметр | По умолчанию | Смысл и влияние
ОСТАНОВ ОХЛАЖДЕНИЯ, сек | 300 | Сколько секунд длится финальное охлаждение (FINISHING): нагрев выключен, вода льётся, клапаны закрыты. Затем процесс завершается и вода закрывается.
БАКСТОП, сек | 5 | Задержка между «нагрев выключен» (BAKSTOP в дистилляции) и переходом к охлаждению.
ПРОЛИВ, сек | 10 | Длительность первого шага мастера калибровки клапанов (см. раздел 6).
КАЛИБР. CAPACITY, сек | 60 | Длительность замера capacity в мастере калибровки. Увеличьте до 120–300 с для более точного замера малых скоростей.
ЗАДЕРЖКА T ТЕЛА, мин | 5 (0–60) | Задержка фиксации опорной температуры царги (rtsarM) и опорного давления при входе в этап ТЕЛО. Отбор тела начинается сразу, но реакции Δ/Залёт включаются только после захвата опоры — колонна успевает стабилизироваться после перехода с голов на тело. 0 = фиксировать сразу, как в старых версиях.

ВажноИнженерные параметры действуют на оба процесса там, где применимы (скорости — на ректификацию, охлаждение/бакстоп — на оба). После изменения нажмите «СОХРАНИТЬ». Значения из инженерного меню не попадают в профили (профили хранят обычные настройки).

9Профили настроек▶

Профиль — это снимок основных настроек, сохранённый на SD-карте. Удобно, когда систему обслуживают разные «продукты»: один профиль под брагу сахарную, второй под зерновую, третий под сырец второй перегонки.

### Как пользоваться

1

Настройте систему как нужно (дистилляция/ректификация, тайминги, пороги).

2

Страница «Настройки» → СОХР. ПРОФИЛЬ → введите имя → «СОХРАНИТЬ».

3

В другой раз: ЗАГР. ПРОФИЛЬ → выберите имя → параметры применяются мгновенно.

ИнфоПрофили хранятся на SD-карте (папка профилей), поэтому переживают любые перезагрузки и перешивки. В профиль входят основные процессные настройки; инженерное меню (шестерёнка) в профиль не входит — его значения общие для всех профилей.

10Процесс «Дистилляция» — пошагово▶

Схема этапов, которую система проходит автоматически:

WATER TEST→ RAZGON→ WAITING→ OTBOR→ REPLACEMENT→ OTBOR…→ BAKSTOP→ FINISHING→ ENDED

### Шаг 0. Подготовка

1

Залейте брагу в куб, соберите аппарат, убедитесь, что вода подключена и слив организован.

2

Проверьте датчики (все четыре должны показывать), мощность и мешалку при необходимости.

3

Откройте страницу «Дистилляция» (или LCD: DIST → SETUP) и выставьте параметры:

Параметр | Диапазон (по умолчанию) | Что это и на что влияет
РАЗГОН ДО (RAZGON) | 30–80 °C (78) | Температура куба, до которой система греет на максимальной скорости. По её достижении нагрев сбрасывается на рабочий и открывается вода охлаждения. 78 °C — почти кипение: далее колонна/дефлегматор догревается сама на этапе WAITING.
БАКСТОП (bakStopTemp) | 50–100 °C (99) | Температура куба, при которой отбор прекращается совсем (спирт в кубе практически закончился). 98–99 °C — стандарт. Ниже (97–98) — чуть больше спирта останется в браге, но тело будет чище от хвостов.
СМЕНА ТАРЫ (MIDTERM) | 35,0–96,0 °C (92,0) | Температура куба для автоматической смены приёмной ёмкости: система закроет клапан отбора и покажет диалог REPLACEMENT. Используется, чтобы хвосты не попали в основной продукт. Уставка сравнивается с температурой куба, приведённой к 760 мм рт. ст. — срабатывание не «плывёт» от погоды.
СМЕНА ТАРЫ ОТБОР (крепость, %) | 0–98 (не задано) | Альтернатива MIDTERM: сменить тару, когда расчётная крепость в струе упала до заданной (например 40 %). В web достаточно задать один из двух параметров — второй посчитается сам.
ТИП НАГРЕВА (NAGREV) | TEN / IND | TEN — система сама управляет ТЭНом (каналы 1 и 2). IND — газ/индукция/внешний регулятор: система лишь показывает этап, нагрев вы регулируете сами.
РАЗГОН НА ВСЮ (FULL PWR) | YES/NO (YES) | Гнать ли на полной мощности до РАЗГОН ДО. NO — нагрев вполсилы (меньше брызгоунос на узких кубах).
ИСП. КЛ. ОТБОРА (VALVE USE) | YES/NO (NO) | NO — клапан отбора открыт весь этап OTBOR (классика, скорость задаёт дефлегматор/нагрев). YES — клапан закрывается на смене тары и бакстопе автоматически; в остальное время открыт.
МЕШАЛКА + ВКЛ/ВЫКЛ (с) | YES (30/300) | Периодическое перемешивание: 30 сек мешает / 300 сек пауза. Прижигает меньше, равномернее кипит. MIXER ON 1–300 с, MIXER OFF 1–300 с.

4

Нажмите СТАРТ (web) или LCD: DIST → DIST START. Запуск блокируется, если какой-то датчик не готов — тогда на LCD появится список проблемных датчиков.

### Шаг 1. WATER TEST — проверка воды

Система открывает водяной клапан (и включает мешалку, если она включена) и спрашивает: «вода пошла?» На экране LCD — WATER TEST с вариантами YES/NO; в web — диалог с кнопками ДА/НЕТ. ДА — процесс продолжается, начинается разгон. НЕТ — процесс отменяется, вода закрывается. Это ваша страховка от перегрева без охлаждения: не подтверждайте, пока не увидите поток воды.

### Шаг 2. RAZGON — разгон

Нагрев включён (при TEN — на полную, если включено «РАЗГОН НА ВСЮ»; при RECT всегда полная). Куб греется до РАЗГОН ДО. Мешалка работает циклами. Ожидание: 40–90 минут в зависимости от объёма и мощности. По достижении уставки мощность сбрасывается на рабочую, открывается вода.

### Шаг 3. WAITING — выход колонны на режим

Система ждёт, пока температура в зоне датчика TSAR вырастет на +5 °C от значения на входе в этап — признак того, что пар дошёл до дефлегматора и аппарат вышел на рабочий режим. После этого начинается отбор (OTBOR). В дистилляции этот этап короткий.

### Шаг 4. OTBOR — отбор

Основной этап. Система следит за кубом:

- Температура куба (приведённая к 760 мм рт. ст.) достигла СМЕНА ТАРЫ → клапан закрывается, этап REPLACEMENT: меняете приёмную ёмкость и отвечаете ДА (продолжить отбор) или НЕТ (закончить процесс сейчас). Сменённая ёмкость — «хвосты/второй сорт».
- Температура куба достигла БАКСТОП → этап BAKSTOP: нагрев выключается, через БАКСТОП, сек начинается финальное охлаждение.

Ожидаемый результатПри правильных уставках вы получаете: основной продукт до ~92 °C в кубе (крепость струи к этому моменту около 40–45 %), затем смену тары, и «хвосты» до 99 °C. На LCD строка процесса показывает температуры TSA/AQUA/TSAR/TANK, крепость в кубе и в струе, время процесса и уставку бакстопа.

### Шаги 5–6. BAKSTOP → FINISHING → ENDED

Нагрев выключен, вода продолжает идти заданное время (ОСТАНОВ ОХЛАЖДЕНИЯ, 300 с), клапаны закрыты. По завершении вода закрывается, на экране ENDED — процесс окончен. Можно разбирать аппарат и сливать куб.

ВажноЕсли в процессе температура TSA превысила TSA ЛИМИТ и не вернулась за VREAC минут, система сама уйдёт в FINISHING (аварийное завершение). Причина обычно — потеря охлаждения. Устраните причину до повторного запуска (см. раздел 13).

11Процесс «Ректификация» — пошагово▶

Схема этапов ректификации:

WATER TEST→ RAZGON→ WAITING→ NASEBYA→ VALVE CAL *→ SET PW & AS *→ GOLOVY→ GOLOVY OK?→ TELO→ FINISHING→ ENDED

* этапы появляются в зависимости от настроек CALIBRATE и подтверждений.

### Шаг 0. Подготовка и настройки

Залейте спирт-сырец, соберите колонну. Страница «Ректификация» (или LCD: RECT → SETUP):

Параметр | Диапазон (по умолчанию) | Что это и на что влияет
TSA ЛИМИТ | 40–55 °C (40) | Аварийный порог по датчику TSA (верхняя зона). Если пар там горячее лимита — тревога и отсчёт VREAC. 40 °C — консервативно; выше 50–55 — осторожно, это уже признак проблем с разделением или охлаждением.
РАЗГОН ДО | 30–80 °C (78) | Как в дистилляции: разгон куба до 78 °C на полной мощности.
ЦИКЛЫ (CYCLE) | 1–3 (3) | Сколько раз допускается «Залёт» (заброс колонны) до автоматического финиша, метод тела Стандарт. 1 + НЗ-клапан = включается особый метод тела Шпора (см. ниже).
ГИСТЕРЕЗИС | 0,18–5,00 (0,24) | Порог «Залёта»: насколько температура царги должна подняться выше опорной, чтобы система закрыла отбор (Шпора: финиш; Стандарт: на себя). Меньше — строже контроль, чаще остановки; больше — терпимее к скачкам, но рискуете подмесом.
ДЕЛЬТА | 0,06–0,18 (0,06) | Порог мягкой реакции (только Шпора): превышение опоры на Δ → снизить скорость отбора в 1,13 раза. Это «плавная рулька» метода Шпора.
ТИП НАГРЕВА | TEN / IND | Как в дистилляции. Для ректификации управление мощностью критично — с индукцией точность стабилизации зависит от вашего регулятора.
ИСП. КЛ. ГОЛОВ | YES/NO (YES) | Есть ли отдельный клапан голов.
ТИП. КЛ. ТЕЛО | NC / NO (NC) | Тип клапана тела. НЗ (NC) — импульсный автоматический отбор; НО (NO) — открытый отбор (скорость регулируете вы).
МЕТОД ГОЛОВ | ST / KSS (ST) | ST — один этап отбора 10 % от АС (или заданного объёма «ГОЛОВЫ, мл»). KSS — три этапа: Спит 2 % полным потоком → Стандарт 3 % медленно → Акатело 15 % на скорости тела. KSS быстрее добирает головную зону и обычно даёт более чёткую границу.
КАЛИБРОВКА | YES/NO (YES) | Проводить ли мастер калибровки клапанов прямо на колонне после первой стабилизации (этап VALVE_CAL). Если клапаны уже откалиброваны — можно NO.
Тайминги HEAD OPN/CLS, BODY OPN/CLS, TESTTIME, HCAP/BCAP/B0CAP | см. раздел 6 | Импульсы клапанов и их пропускная способность.

Проверьте также в «Настройках»: POWER (реальная мощность!), AS_VOL (объём АС в кубе), NASEB (первая стабилизация), VKLAP (повторная). В инженерном меню — скорости и доли голов (раздел 8), включая ЗАДЕРЖКА T ТЕЛА.

### Шаг 1–3. WATER TEST → RAZGON → WAITING

Как в дистилляции: подтверждаете воду, куб греется до 78 °C, затем ждём +5 °C на TSAR. При RECТ разгон всегда идёт на полной мощности (TEN).

### Шаг 4. NASEBYA — работа «на себя»

Клапаны закрыты, колонна работает без отбора NASEB минут (по умолчанию 10). Цель — устойчивое равновесие: пар и флегма в колонне уравновешиваются. На LCD/Web виден остаток минут. Ожидание: температура царги стабилизируется и перестанет ползти.

### Шаги 5–6. VALVE CAL (опционально) и SET PW & AS

- VALVE CAL — если включено КАЛИБРОВКА: на горячей колонне проходит мастер калибровки (раздел 6). Пролив → замер capacity → ввод мл. После завершения система сама переходит дальше; в web есть кнопка «ДАЛЕЕ» для пропуска.
- SET PW & AS — финальная проверка перед отбором голов: на LCD меню POWER (Вт) / AS_VOL (мл) / GOLOVYRUN (старт); в web — окно с текущими настройками, кнопки −/+ у объёма голов и кнопка «ДАЛЕЕ». Проверьте мощность и объём АС — от них считаются все скорости и объёмы голов.

### Шаг 7. GOLOVY — отбор голов

Система отбирает головы выбранным методом:

- Стандарт (ST): объём = ГОЛОВЫ (мл) из web, если задан (>0), иначе 10 % от АС. Скорость = 50 мл/ч/кВт × кВт (3 кВт → 150 мл/ч). Отбор импульсами клапаном голов.
- KSS: этап 1 «Спит» — 2 % от АС полным потоком (клапан открыт); этап 2 «Стандарт» — 3 % от АС на скорости голов; этап 3 «Акатело» — 15 % от АС на скорости тела. На web-мониторинге видно текущий подэтап, объём и остаток времени.

### Шаг 8. GOLOVY OK? — ваше подтверждение

Когда целевой объём голов отобран, система останавливается и спрашивает: «головы готовы?» (GOLOVY_OK). Посмотрите на струю/понюхайте: если головной запах ещё сильный — дайте допороться вручную или вернитесь (на LCD — YES после допора; в web — ДА). Нажатие ДА переключает систему в этап ТЕЛО.

### Шаг 9. TELO — отбор тела

Сначала система фиксирует опорную температуру царги (rtsarM) и опорное давление — не сразу, а через ЗАДЕРЖКА T ТЕЛА минут (по умолчанию 5). Задержка нужна, чтобы колонна стабилизировалась после переключения с голов на тело; отбор при этом идёт с начальной скоростью, объём копится. До захвата опоры реакции Δ/Залёт отключены — ложных остановок в первые минуты не будет. В логе это видно: «pending (capture in 5 min)», затем «Reference captured».

Дальше работают два метода (выбор автоматический):

| Метод Шпора (CYCLE=1 + НЗ) | Метод Стандарт (Overhist, иначе)
Начальная скорость | 500 мл/ч/кВт × кВт, импульсный отбор | та же; НО-клапан — отбор открыт
Реакция на +Δ (мягкая) | скорость ÷ 1,13 (не чаще раза в 60 с) | нет
Реакция на Залёт (+ГИСТЕРЕЗИС) | финиш процесса | закрыть отбор → NASEBYA VKLAP минут → если царга остыла ниже порога, продолжить; циклов не больше ЦИКЛЫ, иначе финиш
Автофиниш по скорости | да: скорость упала до МИН. СКОРОСТЬ ТЕЛО (300 мл/ч) → финиш | нет (финиш только по Залётам)
Суть | постепенно «притормаживает» отбор по мере выталкивания хвостов; заканчивает, когда держать скорость больше нельзя | работает до резкого заброса температуры; после нескольких забросов — финиш

Во время тела клапан голов продолжает капать 50 мл/ч (доотбор). На мониторинге видны: метод, текущая скорость, накопленный объём тела, прогноз остатка времени. Поправка на атмосферное давление применяется к порогам автоматически.

Ожидаемый результатТело 96,0–96,6 % (при рабочей колонне). Прогноз объёма тела на экране: АС − головы − 15 % (запас на хвосты). Если система часто «Залетает» и уходит в повторную стабилизацию — скорость слишком велика для вашей колонны: уменьшите ТЕЛО, мл/ч/кВт или усильте дефлегмацию.

### Шаг 10. FINISHING → ENDED

Как в дистилляции: нагрев и клапаны выключаются, вода идёт ещё ОСТАНОВ ОХЛАЖДЕНИЯ секунд, затем процесс завершён. Хвосты в ректификации обычно не отбираются — то, что осталось, уйдёт в следующую варку.

12Мониторинг и веб-интерфейс▶

### Страница «Мониторинг» (landscape)

- Схема аппарата (SVG) — куб, колонна, дефлегматор с живыми температурами в точках: TANK (куб), TSAR (царга), TSA (верх), AQUA (вода/выход). Схема меняется под процесс: ректификационная колонна или дистиллятор.
- Панель «Данные» — мощность (Вт), температура бокса/лимит, влажность.
- Статусная строка — этап (mon-stage: RAZGON, NASEBYA, TELO…), бейдж процесса, статус НОРМА/тревога, время процесса, метод отбора (ST/KSS, Шпора/Стандарт).
- Расчёты «Головы» / «Тело» — целевой и накопленный объёмы, расчётная и реальная скорости, подэтап и остаток времени. Здесь же ручки «Коррекция %» (−/+) для скорости голов и тела — самое частое действие во время процесса.
- Системная панель — крепость в кубе и в струе (расчётная), опорная температура царги и опорное давление тела (REF ЦАРГА / REF АД) — то, от чего система считает Δ и Залёты.

### Индикаторы в шапке

- НАГРЕВ / МЕШАЛКА / ВОДА — точечные индикаторы включённости выходов: всегда видно, что реально включено, независимо от этапа.
- Сеть: точка INET (есть ли интернет), бейдж W/A/X (режим подключения), при включённом облаке — возраст данных.

### Экран LCD во время процесса

Четыре строки вида:

78.12 RECT W  ST     ← TSA, процесс, сеть, метод голов
65.30 TELO 1.52Sp    ← AQUA, этап; для Шпоры — скорость л/ч
73.55 NORMA          ← TSAR, статус безопасности
70.88 01:23          ← TANK, время процесса

В дистилляции дополнительно показываются крепость в кубе (строка 0) и крепость в струе (строка 1). Служебные диалоги (WATER TEST, REPLACEMENT, GOLOVY OK?, мастер калибровки) отображаются вместо строк процесса — с ними работают кнопки ВВЕРХ/ВНИЗ/SET.

СоветДержите на телефоне вкладку «Мониторинг» открытой: крепость в струе при RECT считается по температуре царги и давлению, и её удобно видеть рядом со скоростью отбора. Расчётная крепость появляется, только когда температура достигает рабочей зоны (от ~78,5 °C).

13Аварии, сигналы и защита▶

### Таблица сигналов

Сигнал/экран | Звук | Что означает | Что делать
NORMA | — | Всё в норме | Ничего
ALARMTSA 02:31 | 3 коротких каждые 30 с | Температура TSA выше лимита, идёт обратный отсчёт VREAC | Проверьте воду охлаждения немедленно. Если температура вернётся в норму — тревога снимется сама, отсчёт обнулится
EMERGENCY | серия | VREAC истёк — аварийное завершение (FINISHING) | Устраните причину (обычно вода), разбирайте после охлаждения
ATTENT 65C | 2 коротких каждые 30 с | Перегрев корпуса электроники (BME280 > BOX_TPR) | Проверьте вентиляцию корпуса, близость горячих узлов
SENSOR NOT READY | — | Запуск заблокирован: датчики не откалиброваны/не отвечают | Меню SENSORS / страница «Датчики»: калибровка или проверка проводки

### Как система ведёт себя при отказах

- Пропал датчик TSA во время тревоги — тревога не сбрасывается, отсчёт продолжается: система завершит процесс по VREAC. Честнее ошибиться в сторону безопасности.
- Пропал BME280 на этапе тела — поправка по давлению замораживается на последнем значении; если BME не было вообще — поправка отключена на весь этап (давление принимается 760 мм рт. ст.). При восстановлении BME опорное давление перезахватывается, коррекция продолжается.
- Пропал WiFi — процесс не останавливается: логика крутится на контроллере. Система периодически пытается переподключиться (каждые WIFI CHK минут). Web просто перестанет обновляться.
- Пропала SD-карта — веб-интерфейс и журналы недоступны до перезагрузки с картой; процессы продолжают работать.
- Кнопка СТОП (web или LCD STOP) — не мгновенное отключение, а переход к штатному FINISHING: нагрев выключен, клапаны закрыты, вода идёт положенное время. Это безопаснее для аппарата.

ОпасноЕсли случилось то, чего система не видит (потоп, запах гари, лужа под кубом) — обесточьте систему рубильником/вилкой, не разбирайте горячий узел. Автоматика отключает именно те реле, которыми управляет, и не заменяет главный выключатель.

14Завершение работы и обслуживание▶

### После процесса

- Дождитесь ENDED (или BAKSTOP-охлаждения) — не перекрывайте воду раньше времени, куб должен остыть.
- Слейте продукт, промойте куб. Клапаны: протрите капельники; при частых процессах периодически промывайте клапаны от налипаний.
- Посмотрите журнал (Настройки → ЛОГИ) — там записаны все переходы этапов, реакции на Δ/Залёты, аварии с температурами. По нему удобно «анализировать полёты».

### Обновление прошивки и веб-страниц

- Только веб-интерфейс: достаточно заменить файлы в папке /www на SD-карте и перезагрузить систему. Прошивку трогать не нужно.
- Прошивка: скомпилируйте/залейте прошивку (Arduino IDE / PlatformIO). Настройки в EEPROM сохранятся, но при смене версий читайте CHANGELOG — там указано, чего ждать.
- После обновлений, затрагивающих калибровки, проверьте capacity клапанов тестом (раздел 6).

### Периодическое обслуживание

Периодичность | Действие
Каждый процесс | Визуальный осмотр обвязки, воды, клапанов; проверка датчиков на экране «Датчики»
Раз в несколько процессов | Тест клапанов (щелчки, время срабатывания); подзаряд батарейки DS3231 при сбое времени (по паспорту модуля)
Раз в сезон | Проверка capacity клапанов повторной калибровкой (цифры могут «уплыть» от износа); чистка контактов реле/клемм

15Частые проблемы (FAQ)▶

Симптом | Вероятная причина | Решение
«SENSOR NOT READY: TSA TANK» при старте | Датчики не откалиброваны или не отвечают | Меню SENSORS / страница «Датчики» — калибровка; проверьте 1-Wire шину и резистор 4,7 кОм
Клапан работает «наоборот» (открыт в паузах) | Неверно указан тип клапана тела (NC/NO) | Настройка ТИП. КЛ. ТЕЛО: НЗ ↔ НО
KSS «Спит» заканчивается мгновенно / объёмы голов неверные | Capacity клапана = 0 (пустая калибровка) или AS_VOL не соответствует реальности | Перекалибруйте клапан мастером; проверьте КОЛ-ВО АС
Отбор идёт заметно быстрее/медленнее расчётного | POWER не равен реальной мощности; capacity неактуален | Замерьте фактическую мощность, поправьте POWER; перекалибруйте клапан; либо используйте «Коррекция %»
Частые Залёты в теле, процесс уходит «на себя» | Слишком высокая скорость тела для колонны, нехватка дефлегмации, скачки мощности | Снизьте ТЕЛО, мл/ч/кВт (инженерное меню), увеличьте ГИСТЕРЕЗИС на 0,06, стабилизируйте нагрев
В первые минуты тела система «не реагирует» на рост царги | Это нормально: опорная температура фиксируется с задержкой ЗАДЕРЖКА T ТЕЛА (5 мин) | Подождите; в логе появится «Reference captured». Поставьте 0, если хотите прежнее поведение
Web не открывается по 192.168.4.1 | Телефон не подключён к точке ESP32; SD без папки /www; HTTP-кэш старой страницы | Проверьте подключение к WiFi ESP32; убедитесь, что файлы на карте; обновите страницу с очисткой кэша
Web не открывается по локальному IP | WiFi не подключился (сеть 5 ГГц, неверный пароль) | wifi_config.txt: только 2,4 ГГц; проверьте ssid/pass; IP виден на LCD
«File Not Found: index.html» | На SD нет папки /www | Скопируйте файлы веб-интерфейса на карту, перезагрузите
Смена тары срабатывает раньше/позже, чем ожидал | Уставка MIDTERM задана в целых градусах и «плавает» с давлением | Задайте уставку точнее (с десятыми) или задайте желаемую крепость смены тары — система сама пересчитает температуру
Тревога TSA без видимых причин | Лимит слишком строгий для вашей колонны; плохой контакт датчика TSA | Поднимите TSA ЛИМИТ в разумных пределах (40–55), проверьте посадку датчика
После отключения питания настройки сбросились | EEPROM-память не записала конфиг (редко: сбой питания в момент записи) | Перенастройте; проверьте питание. Значения по умолчанию см. в разделах 7–8

16Шпаргалка: краткая справка▶

### Быстрый старт (когда всё уже настроено)

1

Залейте сырьё, соберите аппарат, включите систему.

2

Web → «Дистилляция» или «Ректификация» → проверьте уставки → СТАРТ.

3

WATER TEST: убедитесь, что вода идёт → ДА.

4

Дальше система сама. Следите за Мониторингом; реагируйте на диалоги (смена тары, GOLOVY OK?).

5

По окончании дождитесь ENDED, слейте продукт, выключите питание.

### Формулы, которые использует система

Величина | Формула | Пример при 3 кВт
Скорость голов | 50 мл/ч/кВт × кВт × SP_H_COR | 150 мл/ч
Скорость тела | 500 мл/ч/кВт × кВт × SP_B_COR | 1500 мл/ч
Объём голов (ST) | ГОЛОВЫ(мл) или АС × 10 % | 500 мл при АС 5 л
Объём голов (KSS) | 2 % + 3 % + 15 % от АС | 100+150+750 мл
Порог Δ (Шпора) | rtsarM + ДЕЛЬТА + поправка давления | см. раздел 11
Порог Залёта | rtsarM + ГИСТЕРЕЗИС + поправка давления | см. раздел 11

### Куда нажимать: шпаргалка по интерфейсу

Задача | Где
Запустить/остановить процесс | Большая кнопка СТАРТ/СТОП внизу web; LCD: DIST/RECT → START/STOP
Поменять скорость отбора на ходу | Мониторинг → «Коррекция %» у панелей Головы/Тело
Откалибровать датчик | Web: «Датчики» → нажать плитку и нагреть датчик на 5 °C; LCD: SENSORS → SET
Откалибровать клапан | Web: «Ректификация» → «Калибровка клапанов» → Калибровать
Изменить скорости/доли/задержку T тела | Настройки → шестерёнка ⚙ (инженерное меню)
Сохранить/загрузить набор настроек | Настройки → СОХР. ПРОФИЛЬ / ЗАГР. ПРОФИЛЬ
Посмотреть журнал процесса | Настройки → ЛОГИ (web)
Проверить звук тревоги | Настройки → ТЕСТ ЗВУКА

Последний советНе меняйте много параметров за один раз. Изменили один — прогнали процесс — посмотрели лог. Так вы всегда будете знать, что именно повлияло на результат. Хорошей перегонки!
