Vlad-alco/BuhloWar/CHANGELOG.md

## [2026-10-27 19:49] — Сессия 24
DOC: Этап 3 (MAX31865 + Pt100/Pt1000) — текстовая раскладка «что, зачем, как» БЕЗ кода, по запросу автора. Плюс разбор двух вопросов автора по железу: (1) подойдут ли датчики Pt1000B 2-контактные с силиконовым кабелем 2 м; (2) про «неуниверсальность» модулей MAX31865 и надобность напаивать разные сопротивления.

Задача
Автор: «просто текстовую раскладку "что, зачем, как", без единой строчки кода, можешь сохранить в файл и разместить в репо» + два вопроса: Pt1000B 2 контакта, кабель 2 м — подойдут? И правда ли, что для разных датчиков на MAX31865 нужно напаивать разные сопротивления?

Решение
- Новый документ docs/STAGE3_MAX31865_PLAN.md (только текст, ноль кода): резюме; зачем (шпора 0.06°C = один квант DS18B20); как работает RTD+MAX31865 для новичка; полный ответ на вопрос 1 (Pt1000B 2-пров. 2 м — ПОДОЙДУТ: петля проводов 0.09–0.20 Ом = +0.02…0.05 °C постоянного сдвига, калибруется штатным меню; дрейф меди ±0.001–0.003 °C на ±10 °C помещения; класс B достаточно, критичны дельты, а не абсолют; силикон 180–200 °C с запасом); полный ответ на вопрос 2 (микросхема универсальна — Pt100/Pt1000, 2/3/4-пров.; неуниверсальна ТОЛЬКО опорный резистор платы: 430 Ом=Pt100 / 4300 Ом=Pt1000; напаивать не нужно — купить модуль «под Pt1000» или плату с перемычкой; проверка платы: маркировка SMD «4300»/«4301» или мультиметром REF+↔GND); схемы 2/3/4-пров.; список покупок (минимум 2 модуля+2 датчика, запас — 4+4); подключение (SPI общий с SD: SCK14/MISO12/MOSI13, CS MAX на GPIO 10 и 11); архитектура прошивки без кода (SensorManager — маршрутизатор источников, драйвер поверх SPI-транзакций, регистр неисправностей → isConnected=false → вся логика Этапа 1 как есть, EEPROM-поле миграционно, SIM перекрывает источник, калибровка общая); поэтапный план 6 шагов с проверками; открытые вопросы к автору.
- Ключевая поправка по пинам: GPIO 35–36 ИСКЛЮЧЕНЫ из ранее считавшихся свободных (на N16R8 с Octal-PSRAM заняты памятью); GPIO 37 уже занят клапаном голов (config.h VALVE_HEAD_PIN). Для CS выбраны заведомо свободные GPIO 10 и 11. Связь с новым правилом AI_RULES п.5: усложнения ради гипотетических гонок SPI-шины не планируются — штатные транзакции решают, сверх этого ничего не добавляем.

Почему так решили
- Автор просил материал для чтения без кода — код по Этапу 3 не пишется до ответов на открытые вопросы (AI_RULES: согласование до реализации). Pt1000 выбран вместо Pt100 осознанно: в 10 раз меньше влияние проводов при 2-проводной схеме (согласовано ранее).

Ключевые детали
- Факты по MAX31865 перепроверены перед написанием: референс 430 Ом 0.1% на типовых платах (Adafruit), преобразование 52 мс (60 Гц)/70 мс (50 Гц), перемычки 2/3-пров. на модулях, регистр неисправностей (даташит).
- Прошивка не тронута: 0 изменений в коде, никаких перезаливок на устройство не требуется.

Изменённые файлы
- docs/STAGE3_MAX31865_PLAN.md: новый документ (раскладка Этапа 3 + ответы на вопросы по железу).
- CHANGELOG.md: эта запись.

Как тестировать на устройстве
Ничего не требуется — на устройство этот коммит не влияет (только документация).

## [2026-10-25 16:20] — Сессия 23
FW+UI: Этап 2.1 (доработка режима SIM по решениям автора): выбор хода СУХОЙ/РАБОЧИЙ (сухой — выходы физически не переключаются; рабочий — физическая коммутация для проверки наводок, только на стенде), ПОЛНОЕ ускорение ×1..×30 (таймерные и объёмные этапы тоже идут в сим-времени — полный цикл проходит сам), авто-стоп рабочего хода через 60 минут реального времени (отключаемый тумблер), метка SIM в шапке LCD.

Задача (от автора, все 3 решения подтверждены)
Сверка с GitHub перед работой показала: Этапы 1–2 уже опубликованы в main (сессии 21–22), реализация SIM — runtime-панель, а не флаг компиляции. Автор подтвердил: (1) работаем в main БЕЗ новых веток и репозиториев; (2) включение SIM через веб-панель оставить как есть; (3) добавить выбор хода СУХОЙ/РАБОЧИЙ (рабочий ход нужен для проверки наводок от физической коммутации реле/клапанов на датчики), полное ускорение всего процесса и авто-стоп рабочего хода 60 мин.

Решение
- Ход СУХОЙ/РАБОЧИЙ: точка гейта — OutputChannel::write() (единственное место digitalWrite в системе). 7 силовых каналов (ТЭН рабочий, ТЭН разгонный, контактор, вода, клапан голов, клапан тела, мешалка) помечены physGated; при активном сухом ходе write() обновляет ТОЛЬКО логическое состояние currentState — digitalWrite пропускается: реле/клапаны/ТЭН физически молчат, а весь UI (веб-панели клапанов, LCD, /api/status, SD-лог) видит «виртуальный» процесс как обычно. Баззер НЕ гейтится — звуковая индикация аварий/подтверждений работает всегда. Выход из сухого хода: физика отстала от логики → флаг resyncRequested → ближайший OutputManager::update() вызывает resyncPhysical() (запись физических состояний по логическим, с учётом NC/activeHigh). SIM_OFF тоже сбрасывает сухой ход (SimSensors::stop → dryRun=false + OutputManager::setSimDryRun(false)) — после остановки симулятора пины гарантированно синхронны с логикой (после ФИНИШа логика = безопасно закрытые выходы).
- Полное ускорение: ProcessEngine::procNow() — статические «часы процесса»: в активном SIM возвращают сим-время в мс (новый SimSensors::simNowMs(), тот же базис, что у кривых сценариев: simMsAtChange + (now − changeMs)×speed; перебазируется при смене скорости/сценария вместе с simSecAtChange — часы не прыгают), вне SIM — обычный millis(). На procNow() переведены ВСЕ таймеры логики процесса: stageStartTime во всех changeStage и инициализациях подэтапов (GOLOVY/ТЕЛО/БАКСТОП), processTime/stageTime для веба и LCD, интеграторы объёма (lastVolCalcTime в GOLOVY и TELO — литры теперь тоже ускоряются), отложенный захват опорной температуры/давления ТЕЛО (teloRefDelayMin), стабилизация Шпоры (shporaStabMs), задержка ФИНИША (БАКСТОП/охлаждение), аварийный отсчёт TSA/VREAC. Сознательно НЕ ускорены (реальное время): таймеры тестов клапанов (меряют РЕАЛЬНЫЙ расход), баззер-паттерны и цикловка клапанов OutputManager (физика и звук не ускоряются — при ×1 всё как в жизни), авто-стоп (реальная безопасность).
- Авто-стоп рабочего хода: дедлайн ставится в startProcess() ТОЛЬКО если SIM активен и ход РАБОЧИЙ: millis() + 60 мин РЕАЛЬНОГО времени (не сим!). Проверка каждый тик update(); срабатывание — штатный путь кнопки СТОП: changeStage(FINISHING_WORK) с полным завершением (охлаждение, вода) + запись в SD-лог «[SIM] АВТО-СТОП: 60 мин рабочего хода SIM (защита стенда)». Тумблер SIM_AUTOSTOP{v} (дефолт ВКЛ) меняется в любой момент активного SIM (влияет только на проверку дедлайна). Для СУХОГО хода дедлайн не ставится — там физически ничего не переключается.
- Гварды новых команд: SIM_DRY{v} — только при активном SIM и ВНЕ процесса (смена хода посреди процесса сделала бы непредсказуемым поведение нагрева/воды; иначе 409 → alert); SIM_AUTOSTOP{v} — при активном SIM когда угодно. Дефолт хода — РАБОЧИЙ (поведение сессии 22 сохранено); dryRun не переживает stop()/перезагрузку.
- Метка SIM на LCD: в активном SIM шапка экрана процесса показывает «SIM» вместо «DIST»/«RECT» (формат %-4s — ширина строки 20 символов сохранена, сетка не съезжает). Часы процесса на LCD (строка TANK) идут в сим-времени — визуально видно ускорение.
- /api/status: объект "sim" расширен полями "dry" (1=СУХОЙ/0=РАБОЧИЙ) и "as" (тумблер авто-стопа) — добавка обратно-совместима, старые страницы поле игнорируют.
- Веб (обе страницы): в панель СИМУЛЯТОРА добавлены кнопки «ХОД: СУХОЙ/РАБОЧИЙ» (метка зелёная для сухого, янтарная для рабочего; включение РАБОЧЕГО хода — через confirm «Реле, клапаны и ТЭН будут переключаться ФИЗИЧЕСКИ… ТОЛЬКО НА СТЕНДЕ, БЕЗ ПОДКЛЮЧЕНИЯ К АППАРАТУ») и «АВТО-СТОП: ВКЛ/ВЫКЛ»; бейдж дополнен режимом хода: «СЦЕНАРИЙ ×скорость · ч:мм:сс · РАБОЧИЙ/СУХОЙ [· ⚠ АНОМАЛИЯ]»; шпаргалка-подпись обновлена: скорость ускоряет кривые, ТАЙМЕРЫ и ОБЪЁМЫ (полный цикл идёт сам, диалоги — ДАЛЕЕ), рабочий ход — только на стенде, авто-стоп 60 мин.

Почему так решили
- Сухой ход закрывает 90% виртуальных прогонов (логика этапов, фильтры, диалоги, аварийные ветки) с нулевым риском; рабочий ход — единственный способ проверить наводки от коммутации силовых реле на датчики (просьба автора), поэтому он остаётся доступным, но обвешан предупреждениями и авто-стопом.
- Полное ускорение устраняет главный недостаток сессии 22: раньше таймерные/объёмные этапы жили в реальном времени и полный цикл «сам» не проходил. Теперь движение времени ЕДИНОЕ для кривых, таймеров и литров (один базис simNowMs) — при ×30 полный цикл дистилляции ≈ 6–8 минут, ректификации ≈ 6 минут + диалоги оператора (ТЕСТ ВОДЫ, ГОЛОВЫ ОК, СМЕНА ТАРЫ — решения человека симулятор не подменяет, их пропускаем ДАЛЕЕ).
- Авто-стоп именно в РЕАЛЬНОМ времени: сим-время при ×30 «убежало» бы за минуты, а опасность забытого стенда существует в реальных часах. Штатный путь FINISHING_WORK гарантирует корректное завершение (охлаждение, вода, лог) — никаких «жёстких» обрывов.

Ключевые детали
- Верификация прошивки: pio core3x (espressif32 7.0.1) SUCCESS 28 с, core2x (6.9.0) SUCCESS 39 с; RAM 15.2%, Flash 17.9% (partition 6.5 MB) — запас прежний. platformio.ini пересобран локально (окружение контейнера обновилось, venv потерян; в git не попадает — .git/info/exclude).
- Верификация веба: headless-Chromium 29/29 PASS, 0 JS-ошибок (scripts/session22_verify.py расширен до 29 проверок): обе страницы — кнопки ХОД/АВТО-СТОП существуют, дефолт РАБОЧИЙ+ВКЛ из статуса, POST-параметры SIM_DRY v:1/v:0 и SIM_AUTOSTOP v:0/v:1, confirm РАБОЧЕГО хода показан и принимается, метки и бейдж переключаются по sim.dry/sim.as (зелёный/янтарный), регрессии панели (SIM_ON/SIM_SPIKE/SIM_SPEED, СИГНАЛ, старая прошивка без sim/sig), в портретной тест переходит на страницу «Мониторинг», где живёт панель (как реальный оператор). Регрессия сессии 20: 23/23 PASS (ДАЛЕЕ/вода целы), 0 JS-ошибок.
- Найдено при верификации: панель СИМУЛЯТОРА в портретной странице находится на вкладке «Мониторинг» (не «main») — обновляется только на активной вкладке; в ландшафте панель всегда на экране мониторинга.
- Не тронуто: сценарии кривых и аномалий SimSensors, гарды Этапа 1 (медиана/гейт/stale), калибровка, api.php, CloudManager, облачная телеметрия, тесты клапанов.

Изменённые файлы
- SimSensors.h/.cpp: поля dryRun/autoStop/simMsAtChange; методы isDryRun/setDryRun/isAutoStop/setAutoStop/simNowMs(); перебазирование simMsAtChange в setScenario/setSpeed/start; сброс dryRun в stop(); snapshot() расширен (dry, as).
- OutputManager.h/.cpp: статика simDryRunFlag/resyncRequested; physGated у OutputChannel + гейт в write(); resyncPhysical() + вызов из update(); begin() помечает 7 силовых каналов; setSimDryRun()/isSimDryRun().
- ProcessEngine.h/.cpp: static procNow(); поле simAutoStopAt; перевод таймеров этапов/объёмов/аварий на procNow (17 точек); вооружение авто-стопа в startProcess(); проверка и штатный ФИНИШ по дедлайну в update(); метка SIM в шапке LCD (DIST/RECT line0).
- AppNetwork.cpp: команды SIM_DRY/SIM_AUTOSTOP (гварды, лог); SIM_OFF дополнен сбросом сухого хода OutputManager::setSimDryRun(false); /api/status "sim" + "dry"/"as".
- index.html: кнопки ХОД/АВТО-СТОП в панели (Tailwind); simDryToggle()/simAsToggle(); updateSimPanel читает dry/as (метки+цвета), бейдж с режимом хода; шпаргалка.
- index_landscape_knob.html: то же в inline-стилях.
- CHANGELOG.md: эта запись.

Как тестировать на устройстве (Этап 2.1)
1. Перезалить прошивку, заменить на SD ОБА файла index_landscape_knob.html и index.html.
2. Мониторинг → СИМУЛЯТОР → СТАРТ ДИСТ/РЕКТ. По умолчанию ХОД: РАБОЧИЙ, АВТО-СТОП: ВКЛ. Для виртуальных прогонов нажмите ХОД → СУХОЙ (реле щёлкать не будут), СКОРОСТЬ ×10..×30, запустите процесс штатно — полный цикл проходит сам, диалоги оператора подтверждайте ДАЛЕЕ; LCD покажет SIM в шапке и ускоренные часы.
3. Проверка наводок (стенд!): ХОД → РАБОЧИЙ (confirm), аппарат НЕ подключён; реле/клапаны щёлкают по синтетике; строка СИГНАЛ и SD-лог покажут, рождают ли коммутации отбросы/подвисания. Через 60 минут реального времени — автоматический ФИНИШ с записью в SD-лог.
4. Гварды: смена хода/выключение SIM во время процесса → alert 409 «Stop process first»; после ОСТАНОВИТЬ СИМУЛЯТОР физика выходов синхронна с логикой (все выходы безопасно закрыты после ФИНИШа).

## [2026-10-25 14:07] — Сессия 22
FW+UI: Этап 2 плана «точные датчики температуры» — режим SIM в прошивке: синтетические датчики со сценариями дистилляции/ректификации, инжекция аномалий (выбросы +5..20°C на 1/8 циклов, подвисание 120 с, обрыв 10 с), множитель скорости ×1..×30; панель «СИМУЛЯТОР» на веб-мониторинге обеих страниц.

Задача (от автора, план одобрен целиком)
Реальные процессы недоступны до полугода — все изменения (гарды Этапа 1, будущий маршрутизатор MAX31865 и предзапусковый экран Этапа 4) проверяются виртуально. Этап 2: встроенный симулятор датчиков, чтобы прогонять ПОЛНЫЙ процесс (РАЗГОН → ... → ФИНИШ) с работающими защитами движка и наблюдать счётчики/SD-лог гардов без железа.

Решение
- SimSensors (новый модуль, ядро симулятора): подмена происходит на входе SensorManager::updateSensorData() — в пайплайн Этапа 1 (медиана-5 → гейт → stale → среднее) попадает синтетический СЫРОЙ отсчёт, дальше всё идёт ровно как на реальном железе: фильтры, счётчики, SD-лог «SIGNAL: …», движок, LCD, веб. В SIM-режиме шина 1-Wire не опрашивается вовсе (ни requestTemperatures, ни чтения), темп опроса штатный (~1 с), слоты обновляются ВСЕ (требование калибровки снято — прогон возможен на любом устройстве; isCalibrated не трогается, меню калибровки честны к железу).
- Инерция состояния: у каналов есть «физическое» значение state, движущееся к целевой кривой с ограничением скорости (0.6°C/с × speed, потолок 1.5°C/с — максимум 2.4°C за цикл опроса, гейт 3.0°C не срабатывает на нормальной кривой). Старт симулятора — с ТЕКУЩИХ отфильтрованных температур: после горячего куба первая синтетика 18°C не застревает в гейте навечно (скачок 60°C медианой не спасается).
- Сценарии (якоря сим-времени): t=3240 с — пар дошёл до царги; t=3600 — куб 78°C (дефолт razgonTemp). DIST: тело куба 78→99°C за 90 мин (СМЕНА ТАРЫ ~92 по живой уставке, БАКСТОП 99 на 9000 с), TSAR = TANK−4 после прихода пара (WAITING «+5°C» выполняется), TSA верх 32–38°C — ниже типового лимита 40–55, авария TSA в симе не шумит; AQUA 14→28°C. RECT: прогрев колонны до 79.5 (WAITING), выход «на себя» 79.5→78.25 к t=5040 (NASEBYA), ТЕЛО: база 78.25 + дрейф +0.012°C/мин — Залёт наступает сам, как на реальном процессе. Кривые проверены численно 13/13 (scripts/session22_curves_check.py): РАЗГОН/WAITING/СМЕНА ТАРЫ/БАКСТОП/Залёт сходятся с условиями ProcessEngine при дефолтных уставках.
- Дрейф ТЕЛО копится в РЕАЛЬНОМ времени с множителем speed (не в сим-времени): NASEBYA/ГОЛОВЫ идут по реальным таймерам и объёму клапана — если бы дрейф жил в сим-времени, длинный NASEBYA при ×30 заранее загнал бы TSAR за порог и ТЕЛО не существовало. При ×1 Залёт ~42 мин (как в жизни), при ×30 ~1.4 мин.
- Шум «живого» датчика: два медленных синуса + детерминированный псевдошум (±0.05°C), ПОСЛЕ квантования 0.0625°C — младший бит дёргается каждые несколько секунд, поэтому stale-детектор молчит в норме (порог 60 с) и однозначно срабатывает при инжекции подвисания. В ТЕЛО RECT шум царги ×0.3 — дельта шпоры 0.06°C остаётся осмысленной, Залёт не вызывается шумом.
- Аномалии (в реальном времени, по выбранному каналу): ВЫБРОС ×1 цикл — одиночный выброс +5..20°C, его гасит медиана-5 (счётчик гейта НЕ растёт — демонстрирует первый барьер); СЕРИЯ ×8 циклов — 8 циклов подряд, медиана уже не спасает (3 из 5 в окне), гейт отбрасывает, серия ≥5 → событие в SD-лог + счётчик отбросов + лог восстановления; ПОДВ 120 с — сырое значение замирает бит-в-бит, stale-детектор даёт эпизод на 60-й секунде и лог завершения; ОБРЫВ 10 с — датчик «отваливается» (-127), isConnected=false, после 5 с resetFilter — проверка сброса фильтров Этапа 1. Повторная инжекция перезаписывает предыдущую аномалию канала.
- Скорость ×1/×5/×10/×30: ускоряет кривые сценариев и дрейф (РАЗГОН 60 мин сим-времени → 2 мин реала при ×30). Таймерные/объёмные этапы движка (NASEBYA, ГОЛОВЫ, задержка БАКСТОПА, охлаждение) идут в реальном времени — их пропускают кнопкой ДАЛЕЕ (сессия 20); подсказка есть в панели.
- Потокобезопасность: состояние крутится между ядром 1 (опрос) и ядром 0 (веб-команды) — короткие portMUX-критсекции только над копированием полей, вся математика кривых вне секций, аллокаций/Serial/SD внутри нет. Состояние SIM НЕ пишется в EEPROM: после перезагрузки SIM всегда ВЫКЛ (тестовый режим не может «прилипнуть» к продуктиву).
- API прошивки: команды SIM_ON{scen}/SIM_OFF/SIM_SCEN{scen}/SIM_SPEED{speed}/SIM_SPIKE{ch,cycles,amp}/SIM_FREEZE{ch,sec}/SIM_DROP{ch,sec} — обрабатываются ПРЯМО в handleApiCommand (ядро 0) без очереди UiCommand: SimSensors — листовой модуль, ProcessEngine/меню не затронуты. Гварды: SIM_ON — только вне процесса и калибровки (иначе синтетика подменила бы живую систему; ошибки 409 текстом в alert), SIM_OFF — только вне процесса (внезапная смерть датчиков посреди процесса уводит движок в аварийные ветки); сценарий/скорость/аномалии — в активном SIM когда угодно. /api/status: объект "sim":{on,scen,speed,t,anom,ch[4]} — state каналов без аномалий + маска активных аномалий (бит на канал); поле отсутствует при выключенном SIM (обратно-совместимо).
- Веб (обе страницы): панель «СИМУЛЯТОР» на Мониторинге. Выключена: строка СТАРТ ДИСТ / СТАРТ РЕКТ с confirm-предупреждением («реальные датчики перестают опрашиваться…»). Активна: бейдж «СЦЕНАРИЙ ×скорость · ч:мм:сс» (+ «⚠ АНОМАЛИЯ» по маске), кнопки СЦЕНАРИЙ (ДИСТ↔РЕКТ) и СКОРОСТЬ (×1→×5→×10→×30 по кругу), выбор канала (TSA/AQUA/TSAR/TANK), 4 кнопки аномалий (ВЫБРОС / СЕРИЯ×8 / ПОДВ 120с / ОБРЫВ) и ОСТАНОВИТЬ СИМУЛЯТОР (с confirm); подпись-шпаргалка что какая кнопка проверяет. Исчезновение поля "sim" из ответа (SIM_OFF на устройстве / старая прошивка) возвращает панель в выключенный вид (в ландшафте — явная очистка currentData.sim, как для sig; бейдж сбрасывается в «--»).

Почему так решили
- Подмена на уровне СЫРОГО отсчёта (а не готовых температур) — единственная точка, которая проверяет ВСЁ: медиана/гейт/stale и их логирование, поведение движка на «живых» кривых, реакции аварийных веток — при этом ProcessEngine не тронут ни строкой.
- Сценарии привязаны к ФАКТИЧЕСКИМ условиям переходов движка (TANK≥razgonTemp, TSAR+5°C, СМЕНА ТАРЫ по живому давлению, БАКСТОП, Залёт rtsarM+histeresis) — полный прогон проходит все этапы при дефолтных уставках и не заваливается на TSA-лимите (кривая верха 32–38°C при типовом лимите 40–55; если у оператора лимит ниже — увидит штатную аварию TSA, это тоже тестируемый путь).
- Тест аномалий разделён на ×1/×8 сознательно: одиночный выброс должен молча гаситься медианой (новое поведение Этапа 1), а серия — доходить до гейта и лога; так на устройстве проверяются ОБА барьера по отдельности.

Ключевые детали
- Верификация прошивки: pio core3x (espressif32 7.0.1) SUCCESS 51 с, core2x (6.9.0) SUCCESS 32 с (platformio.ini восстановлен локально по worklog сессии 21 и НЕ коммитится — .git/info/exclude).
- Верификация веба: headless-Chromium 22/22 PASS, 0 JS-ошибок (scripts/session22_verify.py, мок-сервер): панель выкл/вкл, бейдж «ДИСТ ×10 · 1:02:05»/«РЕКТ ×30 · 12:34:56», ⚠-маска аномалий, POST-параметры всех 7 команд (SIM_ON/SIM_OFF/SIM_SCEN/SIM_SPEED/SIM_SPIKE×2/SIM_FREEZE/SIM_DROP), confirm-диалоги, гвард 409 → alert «СИМ: Process running», исчезновение поля sim, свежие загрузки без sim (сценарий старой прошивки). Регрессии: session20 23/23 PASS (ДАЛЕЕ/вода целы), session21 13/13 PASS (СИГНАЛ цел).
- Память: RAM 15.1%, Flash 34.9% (core3x) — запас прежний.
- Не тронуто: ProcessEngine, OutputManager, LCD-меню, калибровка, api.php, CloudManager, облачная телеметрия.

Изменённые файлы
- SimSensors.h/.cpp (НОВЫЕ): класс-симулятор — сценарные кривые, инерция state, шум+квантование 0.0625, аномалии SPIKE/FREEZE/DROP, скорость/сценарий/сим-время, portMUX-критсекции, snapshot для /api/status.
- SensorManager.cpp: include SimSensors.h; update() — SIM-ветка (штатный темп опроса без обращений к шине); updateSensorData() — сырой отсчёт из sim->rawFor(), все 4 слота без требования калибровки.
- AppNetwork.cpp: include SimSensors.h; блок команд "SIM_" в handleApiCommand (гварды + параметрические команды, прямой вызов без UiCommand); объект "sim" в handleApiStatus (после "sig").
- index.html: панель «СИМУЛЯТОР» под строкой СИГНАЛ (Tailwind-стили); currentData.sim в опросе; simApi/simStart/simStop/simScenNext/simSpeedNext/simAnom/updateSimPanel + вызов из обновления Мониторинга.
- index_landscape_knob.html: та же панель в inline-стилях (+CSS .sim-btn/.sim-danger/.sim-warn); currentData.sim с явной очисткой при исчезновении; тот же JS-блок.
- CHANGELOG.md: эта запись.

Как тестировать на устройстве (Этап 2)
1. Перезалить прошивку, заменить на SD ОБА файла index_landscape_knob.html и index.html (панель скрыта не будет — она работает и со старой прошивкой, но команды вернут 400 Unknown Command).
2. Мониторинг → «СИМУЛЯТОР» → СТАРТ ДИСТ (или РЕКТ) с подтверждением; выставить СКОРОСТЬ ×10..×30. Запустить процесс штатно (СТАРТ в Дистилляции/Ректификации) — синтетика прогонит все этапы; таймерные этапы (NASEBYA, ГОЛОВЫ, БАКСТОП-задержка) — кнопкой ДАЛЕЕ.
3. Гарды Этапа 1: строка СИГНАЛ на Мониторинге — ВЫБРОС ×1 не должен менять счётчики (гасит медиана), СЕРИЯ ×8 растит «отбросы» и пишет событие в SD-лог, ПОДВ 120 с растит «подвисания» через ~60 с, ОБРЫВ проваливает датчик и восстанавливает с чистым фильтром.
4. Аварийные ветки движка тоже проверяемы: CТОП, ручная вода, ДАЛЕЕ на любом этапе; SIM не переживает перезагрузку — после ребута система возвращается к реальным датчикам.

## [2026-10-25 13:19] — Сессия 21
FW+UI: Этап 1 плана «точные датчики температуры» — сигнальные гарды SensorManager против скачков и подвисаний показаний DS18B20: медиана-5 (анти-выброс), гейт правдоподобия (3°C за цикл), детектор подвисания 1-Wire (60 с без изменений бита), SD-лог событий, счётчики в /api/status и строка «СИГНАЛ» на веб-мониторинге обеих страниц.

Задача (от автора, план одобрен целиком)
Автор заметил глюки датчиков (скачки, подозрение на подвисания показаний). Принято решение о переходе на смешанную конфигурацию (TSAR/TANK → Pt100/Pt1000 через MAX31865, TSA/AQUA остаются на DS18B20, выбор источника за оператором) — но железо отложено: реальные процессы недоступны до полугода. Этап 1 делаем СЕЙЧАС: программная диагностика и защита, нужные при любом железе, — заодно соберёт статистику глюков для обоснования замены каналов. Ограничение верификации: только виртуальные тесты и сборка, столовые/процессные испытания невозможны.

Решение
- Медиана-5 перед средним (SensorManager::applySignalGuards): сырой отсчёт кладётся в кольцевой буфер 5 значений, в скользящее среднее уходит СРЕДНИЙ элемент отсортированного окна. Одиночный выброс (мусорный отсчёт датчика) исчезает целиком — он не может оказаться в средней позиции при 4 корректных соседях. Прежнее поведение: выброс размазывался средним на +1/5 величины на 5 секунд.
- Гейт правдоподобия: |кандидат − фильтр| > SIGNAL_MAX_JUMP_C (3.0°C за цикл опроса ~1.6 с; физика куба/колонки — не быстрее ~0.3°C/с, запас >5x) → отсчёт отброшен, rejectedTotal++, среднее не трогается. Серия из SIGNAL_REJECT_LOG_N (5) отбросов подряд → ОДНО событие в SD-лог (не спамим SPI/SD), при восстановлении — лог «сигнал восстановлен после N отбросов». Работает только при валидном фильтре (> -120°C): первый отсчёт после обрыва проходит свободно.
- Детектор подвисания (stale): сырые значения сравниваются бит-в-бит; живой датчик хотя бы изредка «дрожит» на младший бит (0.0625°C). Ровное значение дольше STALE_UNCHANGED_MS (60 с) → эпизод staleEpisodes++, одно событие в лог «сырое значение не меняется Nс — возможное подвисание 1-Wire»; при изменении — лог завершения с длительностью заморозки. Детектор стоит ПОСЛЕ гейта: мусор до него не доходит, frozen-датчик проходит гейт (кандидат равен фильтру).
- Сброс фильтров при обрыве (resetFilter): было — после >5 с без валидных данных очищался только filteredTemperature, а буфер среднего держал старые значения → после переподключения среднее ~5-6 с усредняло старое с новым. Теперь очищаются среднее, медиана и серия отбросов — фильтр собирается заново с чистого листа.
- /api/status: поле "sig":{"tsa":[отбросы,подвисания],"aqua":[...],"tsar":[...],"tank":[...]} — монотонные счётчики из SensorManager (чтение с ядра 0 без блокировки безопасно: 32-битные выровненные, диагностика).
- Веб (обе страницы): строка «СИГНАЛ» на Мониторинге (ландшафт — панель «Система» под сеткой, портрет — под сеткой крепостей), формат «TSAR 3/1 · TANK 0/0 · TSA 0/0 · AQUA 0/0»; зелёная при нулях, янтарная при любом ненулевом счётчике; скрыта, если прошивка не отдаёт "sig" (совместимость; в ландшафте отсутствие sig в ответе явно очищает поле currentData).

Почему так решили
- Диагностика вместо немедленной замены: скачок и подвисание имеют разные причины (мусор датчика/помехи шины vs несостоявшаяся конвертация 1-Wire), медиана лечит первое, stale-детектор доказывает второе. Статистика счётчиков за несколько процессов станет основой решения, какой канал переводить на Pt100 (этап 3).
- Все гарды — внутри SensorManager между чтением и средним: ProcessEngine, меню и калибровка не затронуты, поведение процессов не меняется (единственное поведенческое изменение — сброс буфера среднего после обрыва, устраняющий старый артефакт смешения температур).

Ключевые детали
- Верификация прошивки: pio core3x (espressif32 7.0.1) SUCCESS 105 с, core2x (6.9.0) SUCCESS 22 с.
- Верификация веба: headless-Chromium 13/13 PASS, 0 JS-ошибок (мок /api/status): видимость/текст/цвет строки СИГНАЛ на обеих страницах, зелёный/янтарный по счётчикам, скрытие при отсутствии sig (свежие загрузки — сценарий старой прошивки). Регрессия: session20 23/23 PASS (ДАЛЕЕ/вода не задеты).
- Константы гардов — #define в SensorManager.h (SIGNAL_MAX_JUMP_C 3.0, SIGNAL_REJECT_LOG_N 5, STALE_UNCHANGED_MS 60000) — легко пересмотреть по статистике лога.
- Не тронуто: ProcessEngine, OutputManager, LCD-меню, api.php, CloudManager, облачная телеметрия (buildTelemetryJson без sig — телеметрия не раздута).

Изменённые файлы
- SensorManager.h: #define гардов; SensorData +medianBuffer/stale-поля/счётчики, resetFilter(); декларации applySignalGuards() и геттеров getRejectedTotal()/getStaleEpisodes().
- SensorManager.cpp: applySignalGuards() (медиана-5 + гейт + stale + лог); updateSensorData() — среднее получает отсеянное значение, resetFilter при обрыве; resetFilter() и геттеры — реализации.
- AppNetwork.cpp: include SensorManager.h; блок "sig" в handleApiStatus (после полей температур).
- index_landscape_knob.html: строка mon-sig-row в панели «Система»; 'sig' в списке опроса + очистка при отсутствии; updateSignalRow() + вызов из updateMonitoringHUD().
- index.html: строка mon-sig-row под сеткой крепостей; currentData.sig в опросе; updateSignalRow() + вызов.
- CHANGELOG.md: эта запись.

ВНИМАНИЕ: требуется перезаливка ПРОШИВКИ и замена на SD ОБА файла: index_landscape_knob.html и index.html. Без прошивки строка «СИГНАЛ» просто скрыта (страницы совместимы со старой прошивкой).

## [2026-10-13 14:05] — Сессия 20
FW+UI: (1) безопасность индукции — при нагреве индукцией вода после ФИНИША не закрывается (индукцией управляет оператор вручную, закрытая вода = «спиртовая баня»); (2) ручной переход на следующий этап — кнопка «ДАЛЕЕ» в веб для всех этапов обоих процессов; (3) ручное управление клапаном воды из веб-мониторинга.

Задача (от автора, все 3 пункта одобрены)
1. Если нагрев — индукция (heaterType=1), то при любом окончании работы после этапа ФИНИШ вода отключается, а индукция продолжает греть куб (системой она не управляется — ProcessEngine handleRazgon при IND не подаёт команды нагрева). Требование: при IND после ФИНИША воду НЕ закрывать, пока оператор сам не закроет. При ТЭН оставить как было.
2. Возможность при выполнении любого процесса вручную переводить систему на следующий этап.
3. (по вопросу 3 плана) Добавить кнопку открыть/закрыть воду в веб — иначе после IND-финала воду нечем закрыть с телефона.

Решение
- ФИНИШ при IND (ProcessEngine::handleFinishingWork, блок завершения): closeWaterValve только при heaterType==0; при heaterType==1 вода остаётся ОТКРЫТОЙ, в Serial и SD-лог пишется предупреждение «IND mode - water valve LEFT OPEN». Путь покрывает ВСЕ варианты конца работы: естественный финал по таймеру, СТОП (уходит в FINISHING_WORK), аварию TSA/VREAC (тоже уходит в FINISHING_WORK; прямые emergencyStop() — мёртвый код, никем не вызываются; BOX — только предупреждение). При ТЭН поведение 1:1 прежнее.
- Ручной переход «ДАЛЕЕ» (прошивка): обработчик UiCommand::NEXT_STAGE расширен с CAL/SET_PW_AS на ВСЕ этапы. Механизм — одноразовый флаг skipStageRequested: ставится командой, подхватывается ШТАТНЫМ условием завершения этапа (|| skipStageRequested в 7 местах: RAZGON, WAITING, OTBOR midterm + bakstop, BAKSTOP, NASEBYA + возврат из Залёта, FINISHING-охлаждение), сбрасывается в changeStage(). Благодаря этому переход выполняется ровно тем же кодом, что и естественное завершение (инициализация клапанов, логи, побочные эффекты сохранены), дублирования логики нет. GOLOVY -> finishGolovyStage() (клапан продолжает импульсить до подтверждения, по дизайну GOLOVY_OK); TELO -> finishTelo(); GOLOVY_OK -> эквивалент ДА. Все форс-переходы логируются с пометкой «skipped/forced by operator». Гвард: команда игнорируется без запущенного процесса и в аварии.
- Кнопка «ДАЛЕЕ» (обе веб-страницы): в шапке (ландшафт — рядом с СТОП, портрет — в шапках Дистилляция/Ректификация). Видна ТОЛЬКО при запущенном процессе на этапе без собственного диалога (WATER_TEST/REPLACEMENT/GOLOVY_OK имеют диалоги; VALVE_CAL/SET_PW_AS — свою кнопку ДАЛЕЕ). Нажатие открывает диалог подтверждения «РУЧНОЙ ПЕРЕХОД» с описанием, на этапе ФИНИШ — предупреждение «Процесс будет окончен прямо сейчас». Диалог защищён флагом nextConfirmOpen от перезаписи опросом (checkModals).
- Ручная вода (прошивка): UiCommand::MANUAL_VALVE_WATER_OPEN/CLOSE (объявлены давно, были мертвы) — обработка в handleCommand: ТОЛЬКО когда процесс не запущен (гвард ERROR_BUSY; во время процесса водой управляет логика этапов). Открытие не сработает в аварии (штатный гвард openWaterValve), закрытие разрешено всегда. AppNetwork: команды {"cmd":"WATER_OPEN"} / {"cmd":"WATER_CLOSE"}.
- Ручная вода (веб): панель на Мониторинге — ландшафт: блок «Данные» (строка ВОДА + кнопка), портрет: карточка под статус-строкой. Показывает состояние клапана (ОТКРЫТ/ЗАКРЫТ), кнопка toggle; во время процесса — «АВТО» (заблокирована). Сценарий: IND-финал -> вода открыта -> оператор выключает индукцию -> закрывает воду кнопкой.

Почему так решили
- Флаг skipStageRequested вместо ветвления «форс-переходов» исключает расхождение путей: любое изменение штатной логики этапа автоматически применяется и к ручному переходу. Отдельная точка закрытия воды в FINISHING_WORK покрывает все терминальные пути без вмешательства в аварийные подсистемы. Кнопка воды заблокирована во время процесса, чтобы ручные команды не конфликтовали с логикой этапов (иначе этап тут же переоткрыл бы клапан).

Ключевые детали
- Верификация прошивки: pio core3x (espressif32 7.0.1) SUCCESS, core2x (6.9.0) SUCCESS.
- Верификация веба: headless-Chromium 23/23 PASS, 0 JS-ошибок (мок /api/status + /api/command-ловушка): ДАЛЕЕ скрыта в IDLE/WATER_TEST, видна на RAZGON/TELO/FINISHING; диалог подтверждения переживает тик опроса; POST {"cmd":"NEXT_STAGE"} уходит после подтверждения; на FINISHING диалог предупреждает о завершении; вода: АВТО-блокировка в процессе, POST WATER_CLOSE/WATER_OPEN вне процесса; портретная — те же проверки (8/8).
- Не тронуто: LCD-меню (кнопка SET и так работает как ДА/ДАЛЕЕ на диалоговых этапах), api.php, профили, CloudManager.
- Поведение после фикса: при IND вода открыта после любого конца работы до ручного закрытия кнопкой или следующего процесса (тест воды откроет/отменит).

Изменённые файлы
- ProcessEngine.h: член skipStageRequested (одноразовый флаг ручного перехода).
- ProcessEngine.cpp: handleFinishingWork (IND-вода + досрочное охлаждение); NEXT_STAGE (гварды + ветки RAZGON/WAITING/OTBOR/BAKSTOP/NASEBYA/FINISHING_WORK/GOLOVY/TELO/GOLOVY_OK); MANUAL_VALVE_WATER_OPEN/CLOSE (гвард processRunning); changeStage (сброс флага); условия завершения RAZGON/WAITING/OTBOR(midterm+bakstop)/BAKSTOP/NASEBYA(+Залёт) || skipStageRequested; логи «skipped by operator».
- AppNetwork.cpp: маппинг cmd WATER_OPEN/WATER_CLOSE -> UiCommand.
- index_landscape_knob.html: кнопка next-stage-btn в nav; показ по этапам в updateData; confirmNextStage() (диалог, nextConfirmOpen, гвард checkModals); панель ВОДА в блоке «Данные»; manualWaterToggle()/updateWaterControl().
- index.html: next-stage-btn-dist/rect в шапках; updNextBtn в updateUI; confirmNextStage()/manualWaterToggle()/updateWaterControl(); nextConfirmOpen + гвард checkModals; карточка «Клапан воды» на Мониторинге.
- CHANGELOG.md: эта запись.

ВНИМАНИЕ: требуется перезаливка ПРОШИВКИ и замена на SD ОБА файла: index_landscape_knob.html и index.html.

## [2026-10-04 00:17] — Сессия 19
UI: веб-настройки — устранено «не сохраняются значения инженерного меню» (и опасный откат значений кнопкой СОХРАНИТЬ на страницах настроек). Заморозка configDirty заменена снимком правок pendingCfg (вариант 2). Прошивка не менялась.

Задача (от автора)
Автор подключался по локальному IP (интерфейс с SD-карты), менял в инженерном меню минимальную скорость тела (minBodySpeed), но после сохранения видел прежнее значение. По результатам диагностики (задача 22b) утверждён вариант 2 — системный фикс.

Диагноз (воспроизведён headless-тестом, см. Сессию 18 «диагностика»)
- Флаг configDirty ставился в true ЛЮБЫМ нажатием ±/тумблера на страницах настроек (включая автосохраняемые поля: мощность, объём АС, ГОЛОВЫ ml и др., а также кнопки ± в диалоге SET_PW_AS) и сбрасывался ТОЛЬКО кнопкой СОХРАНИТЬ обычных настроек.
- Пока флаг поднят, опрос /api/status не обновлял currentData.cfg: инженерное меню читало замороженный снимок и показывало старые значения ПОСЛЕ успешного сохранения в EEPROM (сохранение работало, экран — нет).
- Хуже: СОХРАНИТЬ на страницах настроек отправляло на устройство ЦЕЛИКОМ устаревший currentData.cfg и откатывало значения инженерного меню (и автосохранённые поля) к старым.

Решение (вариант 2, обе страницы)
- Убран флаг configDirty; опрос /api/status теперь обновляет currentData.cfg ВСЕГДА.
- Введён снимок правок pendingCfg (ленивая копия currentData.cfg при первой правке ±/тумблера БЕЗ автосохранения): экран настроек держит правки (WYSIWYG), СОХРАНИТЬ публикует снимок и сбрасывает его.
- Автосохраняемые поля (cfgAutoSave) пишутся в живой currentData.cfg + POST одного поля, снимок не создают; если снимок уже существует — значение зеркалится в него.
- Инженерное меню всегда читает живой currentData.cfg.eng; после успешного eng-сохранения новые значения сразу записываются в currentData.cfg.eng и в pendingCfg.eng (write-through) — СОХРАНИТЬ на настройках больше не может их откатить.
- Write-through из опроса: capacity клапанов (valve_head/body/0_body/body_heads) устройство меняет само при калибровке — переносятся в живой снимок, чтобы SAVE их не откатил.
- Облачные input'ы (URL/KEY) не перезаписываются опросом, пока поле в фокусе (можно спокойно печатать).

Почему так решили
- Точечный сброс флага (вариант 1) оставлял семантику «глобальной заморозки» с окнами рассинхронизации. Вариант 2 разделяет живые данные (currentData.cfg, всегда свежие) и несохранённые правки (pendingCfg, WYSIWYG) — источник симптома устранён полностью, поведение предсказуемо: «СОХРАНИТЬ сохраняет то, что видно».

Ключевые детали
- Верификация: headless-Chromium 17/17 PASS, 0 JS-ошибок (мок /api/status+/api/settings): чистый путь eng; исходный сценарий бага (± до eng-правки) — теперь сохранённое значение отображается; SAVE настроек не откатывает eng; автосейв без заморозки; WYSIWYG при живом опросе; write-through capacity/eng; после F5 — значение устройства. Обе страницы: портретная smoke 3/3.
- Совместимость: формат POST /api/settings не менялся (полный cfg как раньше); прошивка, LCD-меню и api.php не тронуты; профили не затронуты.
- Поведение после фикса: несохранённые правки живут до СОХРАНИТЬ или перезагрузки страницы (F5 = «отмена»).
- ВНИМАНИЕ: требуется заменить на SD ОБА файла: index_landscape_knob.html и index.html. Прошивку перезаливать НЕ нужно.

Изменённые файлы
- index_landscape_knob.html: decl pendingCfg+getEditCfg; guard опроса (обновление всегда + write-through capacities); updateConfigDisplay (рендер из снимка, защита input'ов в фокусе); adjCfg/toggleCfg (правки в снимок, автосейв в живой cfg); saveSettings (публикует снимок, сброс, sync); saveEngMenu (write-through eng + sync).
- index.html: тот же паттерн (R1-R7): decl, guard, adjCfg/toggleCfg/saveSettings/updateConfigDisplay, облачные input'ы.
- CHANGELOG.md: эта запись.

## [2026-10-03 23:40] — Сессия 18
FW: ректификация — исправлены тайминги отбора голов для НЗ клапана во всех конфигурациях (есть клапан голов / нет). Плюс диагностика облачной синхронизации настроек (см. ниже).

Задача (от автора)
Сделать так, чтобы независимо от метода (Стандарт или KSS) головы через НЗ клапан отбирались корректно в любой конфигурации клапанов. Дополнительно: проверить, почему не сохраняются изменения в инженерном меню (автор тестирует сток-прошивку/интерфейс без правок Сессий 15-17).

Решение (тайминги голов — реализовано)
- Суть бага: duty-цикл импульсов считается как target / (capacity × 60), где capacity должна быть пропускной способностью ИМЕННО ТОГО клапана, который импульсит. В трёх местах подставлялась чужая capacity — фактическая скорость отбора отличалась от настроенной в N раз, а счётчик объёма голов при этом считал по цели (расхождение объёма = отношение реальной capacity к подставленной).
- Исправление 1 (Стандарт, нет клапана голов, НЗ тело — ProcessEngine.cpp ~1287): fallback capacity для голов заменён valve_head_capacity -> valve_body_capacity. Прежний fallback брал capacity НЕСУЩЕСТВУЮЩЕГО клапана голов (дефолт 100 или 0). BCH (valve_body_capacity_heads) сохранён как приоритет для плат с легаси-2-точечной калибровкой.
- Исправление 2 (KSS Standard, те же конфигурации — ~1389): то же самое.
- Исправление 3 (KSS AkaTelo, ЕСТЬ клапан голов — ~1428): capacity клапана голов valve_head_capacity вместо valve_body_capacity — импульсит-то клапан голов. Прежнее давало фактическую скорость target × HCAP/BCAP.
- Исправление 4 (KSS Spit, НЗ тело — ~1313): расчётная capacity приведена к значению счётчика объёма handleGolovy (BCAP при НЗ-теле). Прежде при BCH>0 длительность этапа считалась по BCH, а накопление — по BCAP; теперь согласовано (для полного открытия BCH неприменим физически).
- В лог добавлена строка выбранных target/capacity при старте голов (ST и KSS Standard, конфигурация без клапана голов) — для проверки на железе.

Почему так решили
- BCH калибровался только в удалённой (коммит b9d0f4e, 27.08.2026) двухточечной калибровке и НЕ задается никаким UI — на всех свежих платах равен 0, поэтому решающее значение имел именно fallback. Дефолт valve_head_capacity = 100 (preferences.h) гарантированно давал неверные тайминги у всех, у кого реальный клапан не 100 мл/мин.
- Формула calcValveTiming и PWM (OutputManager::updateCycling) проверены — корректны; клампы (duty 0.001..0.9, closeMs >= 100) в реальных режимах (duty 1-5%) не срабатывают. Ошибка была только в выборе capacity.

Диагностика (инженерное меню — БЕЗ правок кода, требуется решение автора)
- Локальный режим (прямой доступ к ESP32): цепочка сохранения проверена полностью и ЦЕЛА (UI POST /api/settings -> парсинг всех 15 eng-полей (с 531f02b, 08.04.2026) -> setConfig -> saveConfig (EEPROM 422..481, коллизий адресов нет) -> loadConfig). Если проблема воспроизводится локально — нужен Serial-лог (при сохранении должны быть строки "[API] Settings Save Request received" и "Settings SAVED to EEPROM").
- Облачный режим: НАЙДЕН ДЕФЕКТ. Web UI в облачном режиме шлёт настройки на api.php?settings=1; api.php складывает их в файл на сервере, НО не пересылает на устройство. Обратная доставка должна работать через CloudManager::checkSettings() (опрос ?settings=1 раз в 60 с), однако коллбэк onSettingsReceived() не регистрируется нигде в прошивке -> checkSettings() всегда выходит на первом же if (onSettings == nullptr) -> устройство НИКОГДА не забирает облачные настройки. UI при этом показывает статус с устройства (телеметрия ?status=1) -> старые значения -> выглядит как "не сохраняется". Это касается ВСЕХ web-настроек в облачном режиме (не только инженерного меню); команды (?cmd=) работают, поэтому процессы управляются, а настройки — нет.
- Проверка у автора: в Serial-логе при сохранении из облачного режима строка "[API] Settings Save Request received" ОТСУТСТВУЕТ — подтверждение диагноза.
- Варианты исправления (нужно решение автора): (А) доделать облачную синхронизацию: зарегистрировать onSettingsReceived, вынести парсинг handleApiSettings в общую функцию, применить с setConfig+saveConfig+...+loadConfig, хранить последний применённый cloud-ts в EEPROM (защита от затирания локальных правок после перезагрузки); (Б) убрать из UI облачный путь сохранения настроек с явным предупреждением "настройки — только в локальной сети" (проще и безопаснее, но облачных правок не будет).

Ключевые детали
- Компиляция: pio core3x (espressif32 7.0.1) SUCCESS, core2x (6.9.0) SUCCESS.
- Поведение конфигурации "есть клапан голов" на Стандарт/KSS Standard не изменилось (там capacity правильная была и до этого); изменились только AkaTelo (КСС) и конфигурации без клапана голов.
- ВНИМАНИЕ: требуется перезаливка ПРОШИВКИ (изменён только ProcessEngine.cpp; web-файлы не тронуты).
- Облачная синхронизация настроек осталась как была (не активирована) — ждёт решения автора (вариант А или Б).

Изменённые файлы
- ProcessEngine.cpp: 4 точки выбора capacity для отбора голов + 2 строки лога.
- CHANGELOG.md: эта запись.

## [2026-10-03 21:47] — Сессия 17
DOCS: подробное руководство оператора-новичка — интерактивный HTML-файл docs/USER_GUIDE.html, добавлен в репозиторий.

Задача (от автора)
Создать подробный файл с пошаговой инструкцией «как для новичка»: от первого включения системы и её настройки, настройки для каждого процесса и до окончания процесса. С описанием, что и для чего настраивать, на что это повлияет и какие результаты ожидать. Файл сохранить в репозиторий, желательно HTML с интерактивным меню.

Решение
- Новый автономный файл docs/USER_GUIDE.html (без внешних зависимостей, работает офлайн и с SD-карты): 16 раскрывающихся разделов, боковое меню-оглавление с подсветкой текущего раздела (scrollspy), поиск по тексту с подсветкой, кнопки «Развернуть всё»/«Наверх», адаптивная вёрстка (таблицы с горизонтальной прокруткой на телефоне), версия для печати (автораскрытие всех разделов).
- Содержание: 1) о системе; 2) техника безопасности; 3) состав системы (железо, датчики, выходы, конфигурации клапанов); 4) первое включение (SD, /www, wifi_config.txt, точка доступа ESP32/12345678, 192.168.4.1, режимы W/A/X); 5) калибровка датчиков (метод «нагреть на 5°C», LCD и Web); 6) клапаны: типы НЗ/НО, тайминги, HCAP/BCAP/B0CAP/BCH, мастер калибровки (пролив -> capacity -> ввод мл), тесты, MINOPEN, коррекции скорости; 7) общие настройки SETTINGS (таблица: диапазоны, дефолты, влияние); 8) инженерное меню (скорости мл/ч/кВт, параметры Шпоры, доли голов ST/KSS, коэффициент давления, время этапов, ЗАДЕРЖКА T ТЕЛА — Сессия 16); 9) профили; 10) ДИСТИЛЛЯЦИЯ пошагово (WATER TEST -> RAZGON -> WAITING -> OTBOR -> REPLACEMENT -> BAKSTOP -> FINISHING) с таблицей настроек и ожидаемыми результатами; 11) РЕКТИФИКАЦИЯ пошагово (…NASEBYA -> VALVE CAL -> SET PW&AS -> GOLOVY ST/KSS -> GOLOVY_OK -> TELO: Шпора/Стандарт, Δ/Залёт, отложенный захват опоры) с таблицей методов; 12) мониторинг и web-интерфейс (экраны LCD и landscape-страницы); 13) аварии и поведение при отказах (TSA/VREAC, BOX, пропажа BME/WiFi/SD); 14) завершение работы и обслуживание (обновление прошивки/SD, периодические проверки); 15) FAQ «симптом -> причина -> решение»; 16) шпаргалка (быстрый старт, формулы скоростей, «куда нажимать»).
- Все цифры (диапазоны, дефолты, формулы) взяты из кода: preferences.h, menu_*.h, ProcessEngine.cpp, AppNetwork.cpp, config.h — сверены с прошивкой на коммите 64db728.

Почему так решили
Один самодостаточный HTML-файл — самый простой для автора способ хранить и читать руководство (в браузере/на телефоне/при желании через GitHub Pages из папки docs/). Интерактивное меню делает большой объём навигируемым; печать даёт бумажную версию.

Ключевые детали
- Верификация: headless-Chromium — 0 JS-ошибок; 16 разделов и 16 пунктов оглавления совпадают; клик по оглавлению раскрывает раздел; поиск фильтрует и подсвечивает; «Развернуть всё» переключается; скриншоты desktop 1400px и mobile 390px — вёрстка корректна, таблицы прокручиваются, сайдбар прячется за бургер.
- Файл не трогает прошивку и /www — деплой не требуется; в README.md добавлен блок «Руководство оператора» со ссылкой.

Изменённые файлы
- docs/USER_GUIDE.html — новый: руководство оператора (HTML, ~105 КБ).
- README.md — добавлен заголовок проекта и ссылка на руководство.
- CHANGELOG.md — эта запись.

## [2026-10-03 21:15] — Сессия 16
FW+UI: ректификация — отложенный захват опорной температуры царги (rtsarM) и опорного давления (adPressM) при начале отбора тела: фиксируются не мгновенно при входе в ТЕЛО, а через настраиваемую задержку (инженерное меню, по умолчанию 5 минут). Отбор тела начинается сразу, как раньше.

Задача (от автора)
При начале отбора тела температура в царге сохраняется сразу — нужна задержка 5 минут (колонка должна стабилизироваться после перехода с голов на тело). Уточнения автора: захват давления тоже отложить (согласовано); 5 минут — вынести в инженерное меню (согласовано); после паузы NASEBYA — снова ждать задержку (согласовано по умолчанию).

Решение
- Конфиг: новое инженерное поле SystemConfig.teloRefDelayMin (минуты, дефолт 5, 0 = фиксировать сразу — прежнее поведение), EEPROM-адрес 491 (свободен: последний занятый — headsManualMl 487..490; 491..494 < 512). Миграция не нужна: readInt возвращает дефолт 5 на чистой ячейке 0xFF. Серверный кламп 0..60 (handleApiSettings).
- Движок (ProcessEngine::handleTelo): (1) условие инициализации при входе в ТЕЛО упрощено с «rtsarM < 0.1f || (TELO && prev != TELO)» до «TELO && prev != TELO» — при отложенном захвате (rtsarM=0 в ожидании) прежний член запускал бы ре-инициализацию КАЖДЫЙ цикл loop и постоянно обнулял bodyVolDone/скорость (критично); (2) в момент входа: стартовые параметры (начальная скорость, bodyOpenCor, сброс объёма и счётчика Шпоры) задаются сразу — отбор идёт без остановки; rtsarM НЕ присваивается, teloRefTimerStart = millis(), teloRefCaptured = false; (3) новый блок 1b: когда прошло teloRefDelayMin минут — rtsarM = текущая T царги, adPressM = текущее давление (или 760 мм рт.ст. при отсутствии BME) — оба референса согласованы по времени; (4) гварды teloRefCaptured на трёх порогах: реакция Шпоры на Δ, Залёт Шпоры, Залёт Overhist — до захвата отклонение не от чего считать, скорость остаётся начальной.
- Безопасность в первые N минут: отбор тела и накопление объёма работают; ложных срабатываний Залёта нет (главный риск: с rtsarM=0 порог был бы ~1-2°C и срабатывал бы мгновенно); аварии TSA/бокса независимы и активны; повторный вход NASEBYA (порог rtsarM+histeresis) достижим только после первого Залёта, т.е. уже после захвата — защищено автоматически; кламп отрицательных значений в движке (локальная копия) — отрицательное число не превратится в огромный unsigned-интервал (захват бы никогда не случился).
- API: buildCfgJson — teloRefDelayMin в объекте eng; handleApiSettings — чтение + кламп 0..60. В профили НЕ добавлено (консистентно с остальными инженерными полями — их в профилях нет).
- Web (index_landscape_knob.html): инженерное меню, раздел «ВРЕМЯ ЭТАПОВ» — строка «ЗАДЕРЖКА T ТЕЛА, мин» (−/+, шаг 1, кламп 0..60, автозагрузка из cfg.eng). Портретная index.html не тронута — инженерного меню там нет. LCD не тронут.

Почему так решили
Минимальный дифф: одна точка захвата (блок 1b) вместо мгновенного присваивания; все существующие реакции работают как раньше — меняется только момент фиксации референса. 0 = прежнее поведение — безопасный дефолт отката. Вынесение в инженерное меню (по решению автора) даёт гибкость без перекомпиляции. Гварды порогов обязательны: без них с rtsarM=0 система за секунду ушла бы в ложный Залёт (NASEBYA/финиш).

Ключевые детали
- Верификация: компиляция core 3.x (espressif32@7.0.1) и core 2.x (@6.9.0) — SUCCESS; headless-Chromium на моках: инженерное меню — поле отображается, значение загружается из cfg.eng (5), клик «+» -> 6, POST /api/settings содержит "teloRefDelayMin":6, кламп границ 0 и 60 (10× «−» и 70× «+»), JS-ошибок нет.
- Совместимость EEPROM: на действующих платах в ячейке 491 чистый 0xFF -> дефолт 5 (задуманное поведение сразу после обновления).
- Телеметрия: в первые N минут поле rtsarM в web показывает 0.00 — это ожидаемо (референс ещё не зафиксирован); в логе пишется «TELO Start … rtsarM: pending (capture in N min)» и затем «TELO: Reference captured after N min stabilization. rtsarM: XX.XX C».
- Поведение при teloRefDelayMin = 0: захват на первом же обороте — полностью прежняя логика (возврат к до-сессионному поведению без перекомпиляции).

Изменённые файлы
- preferences.h / preferences.cpp: поле teloRefDelayMin, EEPROM-адрес 491, load/save.
- ProcessEngine.h: поля teloRefCaptured, teloRefTimerStart.
- ProcessEngine.cpp: сброс при старте процесса; handleTelo — упрощённое условие инициализации, блок отложенного захвата 1b, гварды teloRefCaptured на Δ/Залётах (3 места).
- AppNetwork.cpp: buildCfgJson (eng.teloRefDelayMin), handleApiSettings (чтение + кламп 0..60).
- index_landscape_knob.html: строка «ЗАДЕРЖКА T ТЕЛА» в инженерном меню + engFields + engRanges.
- CHANGELOG.md — эта запись.

Для ввода в действия
- Перезалить прошивку (скетч) + заменить на SD /www/index_landscape_knob.html.
- Проверка на железе: старт ректификации -> ТЕЛО: в логе «rtsarM: pending (capture in 5 min)», реакции на Δ/Залёт первые 5 минут не срабатывают, отбор идёт с начальной скоростью; через 5 минут в логе «Reference captured…», регулятор работает от свежей температуры; инженерное меню: «ЗАДЕРЖКА T ТЕЛА» меняется и переживает перезагрузку; значение 0 — поведение как раньше.

## [2026-10-03 20:57] — Сессия 15
BUGFIX (web, только горизонтальная страница): ректификация — после выполнения калибровки клапанов пропускная способность не сохранялась: в EEPROM записывался 0, панель «Пропускная способность» показывала «не калибровался», LCD-меню VALVE CALIBRATION — 0 ml/m. Прошивка не менялась.

Задача (от автора)
В процессе ректификации, на этапе калибровки клапанов, после выполнения калибровки данные о пропускной способности клапанов не сохраняются.

Диагноз (проверено по коду и живым POST-запросом)
- index_landscape_knob.html: submitCalibVolume() вызывала _calibSend('CALIB_SET_VOLUME',{volume:...}), но сама функция была объявлена как _calibSend(cmd) — второй аргумент молча игнорировался, в POST /api/command уходило {"cmd","valve"} БЕЗ поля "volume".
- Прошивка (AppNetwork.cpp, обработчик CALIB_SET_VOLUME): поле "volume" в теле не найдено -> volume=0 -> ProcessEngine -> setVolumeFromWeb(0) -> calculateCapacity(0)=0 -> saveCapacity() записывала 0 в cfg.valve_head_capacity / valve_body_capacity / valve0_body_capacity и сохраняла в EEPROM (saveRectConfig).
- Портретная index.html была корректна: там _calibSend(cmd,extra) мержит extra через Object.assign — поэтому на портретной калибровка сохранялась, на горизонтальной — нет.

Решение
- index_landscape_knob.html: сигнатура _calibSend(cmd, extra) + Object.assign({cmd,valve},extra||{}) — в точности как в портретной странице (вызов submitCalibVolume менять не нужно, он уже передавал {volume}).
- Прошивка, API и логика расчёта не менялись: единый путь CALC: volume -> calculateCapacity(volume, testDurationSec) -> saveCapacity() -> saveRectConfig() (EEPROM) работает как задумано.

Почему так решили
Минимальный дифф в одну строку JS устраняет первопричину (потеря поля при сериализации). Дублирующая защита на стороне прошивки (игнорировать volume<=0, чтобы чужой/битый клиент не мог обнулить калибровку) — предложена автору отдельным пунктом, внедряется только после согласования (AI_RULES).

Ключевые детали
- Верификация: мок-сервер + ловушка POST /api/command (scripts/mock_server.py дополнен do_POST с сохранением тела): горизонтальная страница — CALIB_SET_VOLUME теперь шлёт {"cmd":"CALIB_SET_VOLUME","valve":1,"volume":123} и {"valve":3,"volume":456}; команды без extra (CALIB_START_DRY) не содержат volume, как и раньше; портретная страница — {"valve":2,"volume":77} (контроль); JS-ошибок нет на обеих страницах.
- ВАЖНО для железа: на платах, где уже прошла «пустая» калибровка через горизонтальную страницу, в EEPROM уже лежит 0 — клапаны нужно перекалибровать (или ввести capacity вручную через старый путь панели «Расчёт по мл» / LCD-мастер).

Изменённые файлы
- index_landscape_knob.html: 1 строка — _calibSend принимает и мержит extra (fix потери volume).
- CHANGELOG.md — эта запись.

Для ввода в действие
- Заменить на SD /www/index_landscape_knob.html. Перезаливка прошивки НЕ нужна.
- Проверка на железе: горизонтальная страница -> Панель ректификации -> Калибровка любого клапана -> Dry run -> Замер -> ввести измеренный объём -> «Рассчитать и сохранить» -> в меню калибровки и в панели «Пропускная способность» появятся рассчитанные мл/мин; значения переживают перезагрузку ESP.

## [2026-08-30 18:39] — Сессия 14
FW+UI: ректификация — явный объём голов «ГОЛОВЫ (ml)» для метода ST: если задан (>0), система отбирает ровно его (не считая от АС) и после подтверждения GOLOVY_OK переходит к ТЕЛО; 0 = авто — прежний расчёт от АС. Метод KSS и оба существующих расчёта сохранены без изменений. Ввод только через web (LCD не тронут): Настройки + редактируемая строка в стартовом диалоге SET_PW_AS. Скорость отбора — прежняя (от мощности), меняется только источник целевого объёма.

Задача (от автора)
В ректификации объём голов привязан к количеству АС (ST: 10%, KSS: 2%+3%+15%). Добавить возможность указать явное количество голов (только в ST, без привязки к АС) с переходом к ТЕЛО, не убирая расчёт в обоих методах. Уточнения автора: LCD не трогать; подтверждение GOLOVY_OK оставить; 0..3000 мл шаг 50, 0 = авто; обе web-страницы; в диалоге после стабилизации (SET_PW_AS) — тоже редактируемая строка.

Решение
- Конфиг: новое поле SystemConfig.headsManualMl (мл, дефолт 0 = авто), EEPROM-адрес 487 (свободен: последний занятый — байт версии 486; 487..490 < 512). Миграция версии конфига не нужна: readInt сам возвращает дефолт 0 на чистой/старой ячейке (защита 0xFF), существующие данные не переинтерпретируются. Сохранение — в saveConfig() рядом с asVolume.
- Движок (2 точки, только ST-ветка): startStandardGolovy() — цель отбора = headsManualMl (если >0), иначе АС*headsShareStd; updateRectWebInfo() — та же формула для web-панели (иначе цель на экране и реальная разошлись бы). Завершение подэтапа ST_MAIN как раньше: headsVolSub >= цель -> GOLOVY_OK (вопрос оператору) -> ДА -> ТЕЛО. KSS-подэтапы (Spit/Standard/AkaTelo) не изменялись вообще.
- Телеметрия: headsTotalTarget (handleApiStatus + buildTelemetryJson) в ST при ручном объёме показывает его — шапка «ГОЛОВЫ X/Y» совпадает с реальной целью (раньше там были жёстко 10%/20% АС).
- API: buildCfgJson + handleApiSettings (кламп 0..3000 на сервере) + профили (handleSaveProfile/handleLoadProfile; в старых профилях ключа нет — getInt сохраняет текущее значение, не сбрасывает).
- Web (index_landscape_knob.html и index.html, одинаково): строка «ГОЛОВЫ (ml)» в Настройках под «КОЛ-ВО АС» (кнопки −/+, шаг 50, подпись «0 = авто (10% от АС); ручной объём действует только в методе ST»); в диалоге SET_PW_AS — редактируемая строка «Головы: N ml» с кнопками −/+ и той же подписью; при методе KSS добавляется пометка «метод KSS — не используется». Автосохранение при клике (/api/settings), значение в диалоге обновляется со следующим опросом (1 с). Оба значения (панель Настроек и диалог) читают один cfg — рассинхрона нет.

Почему так решили
Минимальный дифф: точка истины одна (cfg.headsManualMl), формулы цели в двух местах сведены к одному выражению, KSS и GOLOVY_OK не тронуты — существующие сценарии не меняются (0 = авто — дефолт и поведение старых плат после обновления). EEPROM-адрес за байтом версии, чтобы не сдвигать существующие адреса и не трогать механизм миграций. Клампы продублированы на клиенте (0..3000, шаг кнопок 50) и на сервере (constrain) — защита от чужих клиентов. LCD не расширялся: экран SET_PW_AS (20x4) занят полностью (POWER/AS_VOL/GOLOVYRUN), по согласованию с автором ввод только через web.

Ключевые детали
- ЭТАП ВВОДА В ДЕЙСТВИЕ ОТЛИЧАЕТСЯ ОТ СЕССИЙ 12-13: изменена ПРОШИВКА — нужна полная перезаливка скетча ESP32 + заменить оба файла /www/index.html и /www/index_landscape_knob.html на SD. Старая прошивка с новыми страницами безопасна (ключ headsManualMl просто игнорируется), новая прошивка со старыми страницами — тоже (0 = авто).
- Совместимость EEPROM: поле читается с адреса 487; на действующих платах там 0xFF -> 0 (авто) — поведение идентично прежнему до первого задания значения.
- Верификация: компиляция core 3.x (espressif32@7.0.1) и core 2.x (@6.9.0) — SUCCESS; хост-тест логики 20/20 PASS (цель ST авто/manual, KSS без изменений, условие завершения, клампы сервер/клиент, телеметрия total, EEPROM 0xFF); headless-Chromium на моках: обе страницы — строка в Настройках, диалог SET_PW_AS с редактируемой строкой, клики −/+ меняют значение с синхронным обновлением диалога и панели (750->800->750), JS-ошибок нет.

Изменённые файлы
- preferences.h / preferences.cpp: поле headsManualMl, EEPROM-адрес 487, load/save.
- ProcessEngine.cpp: цель ST в startStandardGolovy() и updateRectWebInfo() (ручной объём либо АС*доля).
- AppNetwork.cpp: headsTotalTarget x2 (ручной объём в ST), buildCfgJson, handleApiSettings (кламп 0..3000), профили save/load.
- index_landscape_knob.html: строка Настроек + cfgRanges/cfgAutoSave + updateConfigDisplay + диалог SET_PW_AS.
- index.html: строка Настроек + adjCfg (кламп + автосохранение) + updateConfigDisplay + диалог SET_PW_AS.
- CHANGELOG.md — эта запись.

Для ввода в действие
- Перезалить прошивку (Arduino IDE / PIO), заменить на SD /www/index.html и /www/index_landscape_knob.html.
- Проверка на железе: ST с «ГОЛОВЫ (ml)»=0 — отбор как раньше (10% от АС); задать 750 — отбор ровно 750 мл со штатной скоростью, вопрос «Головы отобраны. Перейти к телу?» по достижении; KSS — доли 2/3/15% без изменений при любом значении поля; значения в Настройках и в диалоге совпадают.

## [2026-08-30 17:31] — Сессия 13
UI (index_landscape_knob.html, SVG-схема аппарата) — доработка по обратной связи к Сессии 12: бак дистилляции ×1.7→×2.0 с перестановкой компоновки (труба/дефлегматор/бутыль подняты в пустую верхнюю зону), все шрифты температур увеличены и выровнены (дистилляция 30/42, ректификация 28), заголовок смены тары увеличен и разбит на 2 строки.

Задача (от автора, обратная связь по Сессии 12)
1) Бак вырос незначительно, а в блоке много свободного места — если с увеличением есть проблемы, обсудить. 2) Увеличены не все значения температур, и даже увеличенные — недостаточно. 3) Заголовок смены тары — слишком мелкий шрифт. Также указано перечитать AI_RULES.md (перечитаны, работа по формату «понял → план → вопрос → код после одобрения»; автор одобрил вариант А).

Диагноз (почему в Сессии 12 бак вырос слабо)
При сохранении исходного расположения элементов бак зажат: слева колонка «дефлегматор (400–504) + бутыль (521–647)» с правым краем x=136, справа граница viewBox (400) — свободная ширина 260 ед. давала потолок ×1.78 (поставлено ×1.7). Реальная пустота — верхняя треть сцены (y≈30–290, 400×260, ~36% холста), где был только тонкий прогон П-трубы (y=320).

Решение (вариант А — перестановка, одобрен автором; физика процесса сохранена)
- Дистилляция, компоновка: горизонталь П-трубы y 320→66 (сразу под заголовком); дефлегматор 400–504→142–246 (висит под трубой, Δy=−258), с ним патрубки воды (штуцеры y 471/419→213/161), змеевик, носик-капельник (246–260) и бутыль (translate y 165→−86 → глобально 270–378). Вертикаль П-трубы у бака x 290→238 (центр нового бака), феррул на стыке (226,388).
- Дистилляция, бак: scale 1.7→2.0 (+38% к исходному ×1.45 Сессии 11-UI, +18% к ×1.7), центр (260,440)→(238,400), низ 660. Правый край со сливным краном 394<400, бутыль (низ 378) над куполом бака (верх 400) — зазор 22, змеевик/пропорции не тронуты (scale всей группы). Нагрев расширен под новый бак (полоса 240, свечение rx 125, центр 238).
- Дистилляция, температуры: правая колонка крупных показаний (правый край x=394) в бывшей пустой зоне: ЦАРГА (y=104, у трубы — пар), ВОДА (y=180), TSA + «Лимит» (y=256/273, у капельника); кегли значений 24/28→30, подписи 12→14. T куба на баке 28→42 (x=238, y=542), «Стоп N°» 12→15. Все значения в кадре: колонка занимает x 288–395, вертикаль трубы 226–250 — не пересекаются.
- Заголовок смены тары: 2 строки по центру (в одну крупный шрифт не помещается: расчётная ширина строки при ×1.4 ≈ 425 > 400): «СМЕНА ТАРЫ» 12.5→18 и «ОТБОР 94.5% · КУБ 92.5° (прив. 760)» со значениями 15→21, суффикс 10→12.5. Блок по факту 35..365 — в кадре. id и логика обновления/скрытия (midterm=0) сохранены без изменений.
- Ректификация (компоновка не менялась — сцена заполнена): все 4 значения 22→28 (TSA над дефлегматором y=28; ВОДА в правый верхний угол с якорем по правому краю x=398 — прежний start-якорь x=315 давал выход «99.99°» за viewBox; ЦАРГА слева x=162; БАК на баке x=212), подписи 11→13.

Почему так решили
Пустая верхняя треть — единственный резерв сцены: подъём «холодной» ветки (труба, дефлегматор, бутыль) освобождает баку всю ширину без взаимных наложений, физическая схема (пар из куба вверх → по П-трубе → вниз в дефлегматор → капает в бутыль) не искажается. Анимации не пострадали (проверено по коду и в браузере): пар в трубе идёт по #pipePath — путь обновлён, JS читает его динамически; капли продукта создаются в локальных координатах бутыли и при новом сдвиге падают точно в жидкость (поверхность 344, траектория 146→341); змеевик/патрубки двигаются группой. Цвета и семантика Сессий 10–12 (прив. 760, десятые доли) не затронуты.

Ключевые детали
- Прошивка не менялась; для ввода в действие — только заменить /www/index_landscape_knob.html на SD. Совместимо с текущей прошивкой.
- Верификация: headless-Chromium, моки телеметрии на худший случай «99.99°», getBBox всех текстов обеих групп (всё в 0..400; T куба ректификации изначально x=204 задевал белый термометр на корпусе 150..160 — сдвинут на x=212, зазор 2 ед.), скриншоты обоих режимов, проверка скрытия/показа заголовка при midterm=0/92.5.
- Итоговые размеры: дистилляция — бак ×2.0, T куба 42, колонка показаний 30, заголовок 18/21; ректификация — значения 28. Для сравнения до Сессии 12 было 22 везде.

Изменённые файлы
- index_landscape_knob.html — SVG-блок #apparatusSvg: компоновка apparatusDist (труба/дефлегматор/бутыль/бак/нагрев), шрифты и позиции температур обеих групп, двухстрочный заголовок смены тары.
- CHANGELOG.md — эта запись.

Для ввода в действие
- Заменить на SD файл /www/index_landscape_knob.html; прошивка ESP32 не требуется.
- Проверка на железе: дистилляция — бак заметно крупнее, температуры/заголовок крупные; ректификация — значения крупнее, ничего не налезает; при midterm=0 заголовок скрыт.

## [2026-08-30 16:45] — Сессия 12
UI (index_landscape_knob.html, SVG-схема аппарата): в дистилляции увеличены бак (×1.45→×1.7) и шрифты температур, добавлена верхняя строка-заголовок «СМЕНА ТАРЫ · ОТБОР …% · КУБ …° (прив. 760)»; в ОБЕИХ процессах температура куба перекрашена из оранжевого в контрастный синий с тёмной обводкой (на светлой браш-стали бака оранжевый читался плохо).

Задача (от автора)
1) В режиме Дистилляции увеличить изображение бака и температур — «сейчас мелковато», сохранив пропорции и расположение всех элементов. 2) В дистилляции добавить верхней строкой (типа заголовка) значения смены тары (приёмной ёмкости): крепость в отборе и температуру в баке, при которой меняется приёмная ёмкость — название и значение. 3) В обоих процессах поменять цвет температуры в баке (кубе) на синий или другой более контрастный — «сейчас плохо читаемо».

Решение (только index_landscape_knob.html, блок #apparatusSvg)
- Бак дистилляции (группа tank-domspirt в apparatusDist): равномерный scale 1.45→1.7 (+17% линейных, пропорции и все детали бака сохранены 1:1); верх якоря (y=440) и феррул входа П-трубы не тронуты. Центр сдвинут x 290→260: при прежнем центре правый край основания и сливной кран выходили за viewBox (400) — при ×1.7 геометрия помещается только при центре 255–264. Нагрев под баком смещён ниже (полоса y 642→666, свечение cy 650→678) и расширен (180→210, rx 95→112) под новый низ бака (y 661 вместо 628.5); нижний край сцены 691 < 720 — всё в кадре.
- Температуры дистилляции: БАК и ЦАРГА 22→28 (+27%), TSA и ВОДА 22→24. Больше 24 в левой колонке физически не влезает: колонка зажата дефлегматором, бутылью и левой стойкой П-трубы — текст «99.99°» при кегле 26+ уходит за левый край сцены (проверено численно). Подписи-подстрочники (Лимит/ЦАРГА/ВОДА/Стоп) 11→12; точки привязки TSA/ВОДА сдвинуты на 2–4 ед. вправо (x 85→89/87), чтобы даже «99.99°» не касался носика-капельника и горлышка бутыли.
- Заголовок смены тары (только дистилляция): строка «СМЕНА ТАРЫ · ОТБОР 91.5% · КУБ 93.2° (прив. 760)» по центру верхней кромки SVG (y=28 — в дистилляции верхняя зона пустая, в ректификации она занята TSA, поэтому строка размещена внутри группы apparatusDist и переключается вместе с ней автоматически). Значения обновляются в updateApparatusSVG() из currentData.cfg.midterm_abv и cfg.midterm — телеметрия уже отдаёт %/°C с одним знаком (Сессия 10), пересчётов на клиенте нет. Крепость — янтарным (#facc15, как кольцо TARA), температуру куба — синим (#4da3ff, в цвет T куба на баке). При незаданной уставке (midterm=0) строка скрывается — по тому же правилу, что и кольцо TARA. Суффикс «(прив. 760)» отражает семантику уставки после Сессии 11.
- Цвет температуры куба: #ff7a2f (оранжевый) → #4da3ff (контрастный синий) в ОБЕИХ группах — svg-rect-tank и svg-dist-tank. Поверх светлой полосы браш-стали добавлена тёмная обводка (stroke #0d1420, 3–3.5, paint-order: stroke): чистый цвет сам по себе контраста на светло-сером градиенте бака не даёт ни тёмным, ни светлым — обводка решает это на любом участке. Подпись «Стоп N°» на баке тоже поднята по читаемости: #6b7688 → #b9c6d2 с обводкой 2–2.5. Синий #4da3ff намеренно глубже голубого ВОДЫ (#8fd4ff), чтобы значения не путались.

Почему так решили
Бак увеличивали чистым scale всей группы: это единственный способ сохранить пропорции и вид «как был, но крупнее»; правки отдельных деталей исказили бы стиль. Сдвиг центра на 30 ед. (7.5% ширины) — минимальное изменение композиции, при котором правый край (сливной кран, x_local 78) остаётся в кадре; точка входа П-трубы и феррул не двигались, поэтому сочленение трубы с баком выглядит как прежде. Левые значения (TSA/ВОДА) ограничены кеглем 24: измеренный в headless-браузере реальный рендер показал, что 26 обрезает цифру слева даже при смещении к горлышку бутыли. Обводка текста вместо смены фона выбрана потому, что фон бака — многостоповый градиент (тёмные края, светлая середина): ни один плоский цвет не контрастен сразу всем участкам, а тёмный кант делает читаемым любой цвет заливки.

Ключевые детали
- Прошивка не менялась: правки только в index_landscape_knob.html (+43/−21). JSON, EEPROM, профили — без изменений; страница совместима и со старой прошивкой (при отсутствии cfg.midterm в телеметрии заголовок просто скрыт).
- Верификация: headless-Chromium с мок-данными телеметрии (системный DejaVu шире мобильных system-ui — проверка с запасом). Числовые getBBox-проверки: все тексты дистилляции в пределах 0..400 (TSA 4..89, ВОДА 2..87, БАК 210..310, заголовок 23..377) на самом широком значении «99.99°»; бак в глобальных координатах 134..395 × 440..661 — в кадре. Скриншоты обеих компоновок: наложений текстов на графику нет, заголовок виден только в дистилляции, скрывается при midterm=0.
- Цвет T куба един на баке и в заголовке (КУБ …°) — значение уставки и живое показание читаются как одна сущность.
- Ректификация не масштабировалась (просьба касалась только дистилляции) — там бак и так крупный относительно сцены; изменён только цвет T куба и подписи «Стоп».

Изменённые файлы
- index_landscape_knob.html — SVG: бак dist ×1.7 со сдвигом центра, нагрев под ним, шрифты температур dist 28/24 (+подстрочники 12), заголовок СМЕНА ТАРЫ + его обновление в updateApparatusSVG(), цвет T куба и «Стоп» в обеих группах.
- CHANGELOG.md — эта запись.

Для ввода в действие
- Только обновить на SD файл /www/index_landscape_knob.html; прошивка ESP32 не требуется, перезагрузка контроллера не нужна (страница читается с SD при открытии).
- Проверка на железе: открыть ландшафтный интерфейс в режиме дистилляции — бак крупнее, температуры крупнее; при заданной уставке сверху строка «СМЕНА ТАРЫ · ОТБОР …% · КУБ …° (прив. 760)»; T куба синим с тёмным кантом на баке в обоих процессах.

## [2026-08-30 15:35] — Сессия 11
Согласование давления: уставка смены тары (MIDTERM) теперь хранится как температура куба, приведённая к 760 мм рт.ст., а триггер использует ЖИВОЕ атмосферное давление на всём протяжении этапа ОТБОР. Устранён сдвиг момента срабатывания до ~1.1°C при давлении 730–745 мм рт.ст.

Задача
Семантика давления не была согласована: уставка при вводе крепости в web пересчитывалась в температуру по ТЕКУЩЕМУ давлению (на момент сохранения настроек), а триггер сравнивал приведённую температуру куба по давлению, ЗАМОРОЖЕННОМУ на старте этапа ОТБОР. При рассогласовании этих двух давлений (погода, настройки сохранены в другой день) момент срабатывания сдвигался на 0.037°C × ΔP — до ~1.1°C при 30 мм рт.ст. Кроме того, предварительный фильтр сравнения «сырой» температуры куба с уставкой при P<760 полностью гасил поправку (поправка положительная, но фильтр не пропускал сравнение, пока сырая T не доходила до уставки). Автор утвердил опцию «уставка в приведённой T к 760 мм».

Решение (семантика: уставка = температура куба при 760 мм рт.ст.)
- Уставка cfg.midterm означает температуру куба, ПРИВЕДЁННУЮ к 760 мм рт.ст. — эталону таблицы крепостей. Хранение x10 (Сессия 10) не менялось, миграция EEPROM не требуется.
- Web (AppNetwork.cpp, handleSettingsSave): конверсия крепость↔температура выполняется строго по эталонному давлению 760 (midtermRefPressure); чтение живого BME из обработчика удалено. Уставка перестала зависеть от давления в момент сохранения настроек.
- Триггер (ProcessEngine.cpp, handleDistOtbor): сравнивается приведённая к 760 температура куба T_прив = T_изм + 0.037×(760 − P) при ЖИВОМ давлении; предварительный фильтр по сырой T удалён (именно он блокировал коррекцию при P<760). Физика: при P<760 срабатывание наступает при более НИЗКОЙ сырой температуре куба (та же концентрация кипит ниже), при P>760 — при более высокой.
- Живое давление: обновляется на каждой итерации при доступном BME; при пропаче датчика остаётся последнее известное значение (data.pressure хранит последний корректный отсчёт — заморозка); при восстановлении/первом появлении слежение возобновляется. Если BME не было доступно ни разу за этап — 760 (коррекция отсутствует, лог WARNING).
- Логи: старт ОТБОР — «BME pressure tracking for Midterm. Pressure: …»; пропажа/восстановление — «BME lost! Midterm pressure frozen at: …» / «BME online. Midterm pressure: …»; срабатывание — «midterm reached. T=… (Reduced to 760: …, set …, P=… mmHg)». Лог старта DIST помечает уставку суффиксом «ref760».
- Экраны: подпись поля в index.html — «СМЕНА ТАРЫ В КУБЕ (°C прив. к 760)», в index_landscape_knob.html — «СМЕНА ТАРЫ КУБ (прив. 760)» + tooltip с пояснением; help.html — назначение BME280 уточнено.

Почему так решили
Единая точка привязки к эталону (760 мм рт.ст.) устраняет целый класс ошибок «какое давление где захвачено»: уставка инвариантна к моменту сохранения, а триггер следует фактическому давлению на всём протяжении этапа (включая дрейф погоды за часы перегонки). Хост-тест показывает ошибку старой логики 0.37–1.11°C на реалистичных парах давлений (сохранение/старт ОТБОР) и нулевую (<0.01°C) у новой. При пропаче BME выбрано замораживание последнего известного давления вместо fallback 760: оно точнее, если датчик уже успел поработать. bakStopTemp/razgonTemp сознательно не корректируются — это безопасные стопы по сырой температуре датчика, а не пороги концентрации.

Ключевые детали
- Числовое значение уставки при обновлении НЕ меняется: операторские значения (например 92.5) трактуются как T при 760 мм рт.ст.; при давлении ~745 фактическое срабатывание наступит при сырой T ≈ уставка − 0.55°C — момент виден в логе срабатывания (Reduced to 760).
- Показание «крепость в отборе» на экранах в момент смены тары теперь совпадает с уставкой крепости независимо от погоды: и триггер, и экранные getABV используют одно и то же приведение T_изм + 0.037×(760 − P).
- Совместимость: структура JSON не менялась (°C/% с одним знаком), страницы и профили конвертаций не требуют.
- Хост-тест scripts/test_midterm_pressure.js — 28 кейсов (точка срабатывания при 6 давлениях, обратимость конверсии, сквозной сценарий с дрейфом давления и пропажей/восстановлением BME, срабатывание на замороженном давлении, сравнение со старой логикой) — 28/28 PASS.
- Компиляция PlatformIO: espressif32 7.0.1 (core 3.x) SUCCESS 12.8 c, espressif32 6.9.0 (core 2.x) SUCCESS 12.7 c.

Изменённые файлы
- ProcessEngine.cpp — живое давление вместо замороженного на старте ОТБОР; триггер по приведённой температуре без предфильтра; расширенные логи давления.
- AppNetwork.cpp — handleSettingsSave: конверсия крепость↔T по эталонному 760, чтение живого давления удалено.
- index.html, index_landscape_knob.html — подписи поля уставки с указанием «прив. к 760» + tooltip.
- help.html — уточнено назначение BME280 (компенсация давления).
- CHANGELOG.md — эта запись.

Для ввода в действие
- Прошить ESP32 (ProcessEngine.cpp, AppNetwork.cpp); обновить на SD /www/ (index.html, index_landscape_knob.html, help.html). Порядок не критичен: старая прошивка с новыми страницами работает (подписи уже новые, семантика уставки не изменится, пока не прошит триггер).
- Проверка на железе: в логе старта ОТБОР — «BME pressure tracking for Midterm»; при смене тары — «midterm reached. T=… (Reduced to 760: …, set …, P=… mmHg)»; уставку можно оставить прежней.

## [2026-08-30 14:58] — Сессия 10
Точность уставки смены тары (MIDTERM): хранение в десятых долях — температура куба и крепость отбора с шагом 0.1 (миграция EEPROM v1→v2); крепость с 1 знаком на всех экранах (веб + LCD + API). Таблица «температура куба ↔ крепость куба ↔ крепость отбора» сверена со справочником — актуальна.

Задача
Параметр «Смена тары» задавался целыми числами: температура куба (°C) или крепость в отборе (%), которую система пересчитывает в температуру. Целый градус не давал указать точный момент смены тары: в рабочей зоне 30–60% об. градиент крепости достигает 1.3–2.9% на 0.5°C, ошибка округления уставки доходила до ±2.3% об. Автор утвердил вариант 2 (десятые доли для обоих параметров) с требованием «крепость с 1 знаком на экранах». Дополнительно — проверить актуальность таблицы температуры/крепостей (выполнено в рамках этой же сессии, см. «Анализ»).

Анализ (сверка таблицы крепостей, preferences.cpp)
- Внутренняя согласованность — OK: монотонность, якорь 100°C→0%, струя крепче куба, азеотроп; формулы getABV/getTempForOutputABV/getOutputABVForTemp взаимно обратимы.
- Сверка со справочником равновесия пар–жидкость этанол–вода при 760 мм рт.ст. (весовые % переведены в объёмные по плотностям): abvPot (куб) совпадает со справочником в ОБЪЁМНЫХ % — среднее |d| 0.83%, макс 1.78% (78.5–98.5°C) — таблица куба АКТУАЛЬНА; abvOut (струя) в рабочей зоне 78.5–94.5°C выше равновесного пара на +0.5…+1.6% об. (правдоподобное укрепление царгой аппарата) — согласована; в хвосте 96.5–98.5°C завышение +5.9…+10.3% об. (аппаратная калибровка/экстраполяция — на смену тары не влияет; для добора хвостов показывать с осторожностью). Негладкость abvOut на 94.0–95.0°C (градиент 2.89→1.05→2.31 %/0.5°C) — стоит перепроверить точки замером ареометра-спиртомера.

Решение (вариант 2 + крепость с 1 знаком)
- Хранение: SystemConfig.midterm/midterm_abv — int в ДЕСЯТЫХ долях (920 = 92.0°C, 430 = 43.0%), рабочий диапазон 0..980. int×10 вместо float — без бинарной погрешности, байтовый формат EEPROM (writeInt) не менялся.
- Однократная миграция EEPROM v1→v2 (preferences.cpp, loadConfig, ADDR_CONFIG_VERSION): ×10 для обоих полей; для свежей EEPROM миграция клапанов (этап 3) уже записывает v1, поэтому корректно и на чистой плате (35 → 350). Даунгрейд на прошивку старее Сессии 10 прочитает 920 как «920°C» — уставку нужно будет переустановить.
- Web/API: /api/settings и /api/loadprofile принимают °C/% с одним знаком (getFloat → ×10 → round, клампы 0..980); buildCfgJson и /api/saveprofile отдают десятые доли °C/% (x10/10.0, один знак). Старые профили (целые) совместимы: 92 → 920, 43 → 430.
- Триггер (ProcessEngine, OTBOR): порог float cfg.midterm×0.1 — момент смены тары больше не округляется до целого градуса; семантика учёта давления (приведение по давлению, замороженному на старте ОТБОРА) не менялась.
- Экраны: index.html и index_landscape_knob.html — кнопки ±0.1, отображение toFixed(1), кламп 0..98; LCD-меню (menu_dist_setup.h) — MIDTERM 35.0..96.0°C с шагом 0.1°C (x10, вывод printTenths «92.5»); текущая крепость куба/отбора — LCD %.1f, /api/status и телеметрия — String(…,1).

Почему так решили
Десятые доли градуса сокращают максимальную ошибку крепости уставки с ±2.3% до ~0.7% (в рабочей зоне 40–60% — ~±0.35%). Вариант «триггер по крепости на лету» не внедрялся (выбор автора — вариант 2): он требует пересчёта таблицы в обоих направлениях на каждом цикле и меняет семантику параметра. JSON оставлен в °C/% (а не в десятых долях), чтобы старые профили на SD и страницы продолжали работать без конвертаций. Учёт давления остался прежним (уставка считается по текущему давлению, триггер — по замороженному): согласование «уставка в приведённой T к 760 мм» обсуждалось как отдельная опция и автором пока не утверждалось; при давлении, заметно отличном от 760 мм рт.ст. или сменившемся с момента задания уставки, возможен сдвиг момента срабатывания до ~0.6–1.1°C.

Ключевые детали
- Пересчёт «температура ↔ крепость» идёт по таблице с интерполяцией в float, промежуточных округлений нет; приоритет последнего введённого параметра сохранён (при вводе температуры крепость пересчитывается и наоборот).
- Совместимость «старая прошивка + новая страница»: шаг 0.1 деградирует до целых (getInt усекает дробь) — изменение применяется при пересечении очередного целого значения, поломки нет. «Новая прошивка + старая страница»: кнопки ±1 и целые значения работают как раньше.
- LCD-строки статуса DIST с «%43.0» занимают ровно 20 колонок (формат %7s/%6s) — ширины 20×4 достаточно.
- Хост-тесты: scripts/test_midterm_ui.js — 19 кейсов (шаг 0.1, клампы, накопление ошибки лестницей, парсинг ×10, float-шум, миграция, ветка крепости) — 19/19 PASS. Компиляция PlatformIO: espressif32 7.0.1 (core 3.x) SUCCESS 119 c, 6.9.0 (core 2.x) SUCCESS 20 c.

Изменённые файлы
- preferences.h — поля midterm/midterm_abv в десятых долях (x10), комментарии.
- preferences.cpp — дефолты, однократная миграция v1→v2 (×10), комментарии в saveConfig/saveDistConfig.
- AppNetwork.cpp — handleSettingsSave (getFloat → x10 + клампы), buildCfgJson/handleSaveProfile (°C/% с одним знаком), handleLoadProfile (совместимость старых профилей), str_bak/str_out с одним знаком (телеметрия + /api/status).
- ProcessEngine.cpp — триггер midterm на float-пороге, лог старта (T °C + %) и лог срабатывания с уставкой, крепость на LCD %.1f.
- menu_dist_setup.h — MIDTERM 35.0..96.0°C, шаг 0.1°C, isTenthsItem/printTenths.
- index.html — кнопки ±0.1, toFixed(1), кламп 0..98 в adjCfg.
- index_landscape_knob.html — то же (кламп cfgRanges [0,98] сохранён).
- CHANGELOG.md — эта запись.

## [2026-08-30 12:30] — Сессия 9
Переработка блока ЛОГИ веб-интерфейса: перестановка панелей (ЛОГИ <-> КОРРЕКЦИЯ, блок ДАННЫЕ), накопительный буфер 50 строк, окно лога в /api/status 10 -> 30 строк, строки лога без даты с переносом на 2-ю строку; температуры 2 знака в index.html.

Задача
1) index.html: температуры показывались с 1 знаком после запятой — нужен 2 знак. 2) index_landscape_knob.html: переставить блоки — ЛОГИ на место КОРРЕКЦИИ (только строки логов, максимум ширины), строки Коррекция % — в строки заголовков блоков ГОЛОВЫ и ТЕЛО (после названия блока: «ГОЛОВЫ • Коррекция % • [-] 100 [+]»), на месте бывших ЛОГОВ — блок «ДАННЫЕ» (МОЩН/BOX C/ВЛАЖН); ширину блоков ГОЛОВЫ и ТЕЛО уменьшить без потери информации. 3) Дату в строках лога убрать; длинные строки — переносить на 2-ю строку. 4) Выяснить, почему в блоке ЛОГИ не видны записи [10:20:19] Stage change: WATER_TEST, [10:20:37] WATER TEST: confirmed by operator, [10:20:37] Stage change: RAZGON, что ещё может не попадать в отображение, и принять решение (важно видеть начало этапов и поведение системы).

Диагноз (ответ на п.4)
Фильтра записей нет: ВСЕ logger.log() пишутся в /system.log. Блок ЛОГИ питается из /api/status: getLastLogLinesJson(10) (SDLogger.h, вызов AppNetwork.cpp:760) читает последний 1KB файла и отдаёт только 10 последних строк — блок был «окном», а не историей. Старт этапа пишет 4-6 строк подряд (Process START + параметры + строки OutputManager о клапанах), поэтому Stage change выталкивался из окна за секунды после записи. Найдено два дефекта: (а) если между опросами /api/status (1-2 с) записано >10 строк — «лишние» строки ни разу не доходили до браузера; (б) окно 1KB могло начинаться с середины строки — «надкусанный» фрагмент показывался мусором. Полный лог при этом всегда доступен по кнопке ЛОГИ (/api/logs, 16KB).

Решение (вариант ПОЛНЫЙ — прошивка + фронтенд, по выбору автора из двух предложенных)
Прошивка: SDLogger.h — окно чтения 1KB -> 4KB, лимит 10 -> 30 строк (AppNetwork.cpp: getLastLogLinesJson(30)); неполный первый фрагмент окна пропускается до '\n'; цикл разбора сканирует всё окно без ранней остановки (раньше при остановке по maxLines остаток после него приклеивался одной склейкой из нескольких строк — с окном 4KB и длинными строками это становилось достижимо). 30 строк делают проскок серий невозможным (самая плотная серия в коде — ~6 строк).
Фронтенд (index_landscape_knob.html): клиентский буфер 50 строк с дедупликацией по полному тексту строки (у каждой записи метка времени до секунды — совпадение текста означает ту же запись); пока страница открыта, записи не исчезают с экрана; перерисовка только при появлении новых строк — скролл истории сохраняется, исчезла ежесекундная полная перерисовка. Дата ДД.ММ.ГГГГ отрезается при отрисовке (regex; формат [123s] до NTP не трогается) — на SD и в полном логе дата сохраняется полностью. CSS .log-line: перенос до 2 строк (-webkit-line-clamp: 2) вместо nowrap+многоточие.

Перестановка панелей (index_landscape_knob.html)
- Нижний ряд: grid-колонки 1fr/1fr/1fr -> minmax(0,1fr)/minmax(0,1fr)/minmax(0,2.4fr) — Головы и Тело уже (все 5/4 строк данных сохранены), третья панель — ЛОГИ (место бывшей КОРРЕКЦИИ) с максимумом ширины; консоль логов 116px со скроллом всей истории.
- Заголовки блоков: «Головы • Коррекция % • [-] 100 [+]» и «Тело • Коррекция % • [-] 100 [+]»; переключатели speedHeadCorr/speedBodyCorr перенесены, ID элементов и вызовы adjCfg не менялись — JS-логика не тронута. Отдельная панель «Коррекция» удалена.
- Левый высокий блок: бывшие ЛОГИ -> «Данные» (МОЩН/BOX C/ВЛАЖН — единственное содержимое, равномерно по высоте, значения чуть крупнее). Скрытые служебные span (val-tsa-hud и др.) сохранены — совместимость JS. Правый блок «Система» (КРЕП.КУБ/ОТБОР/REF) не переименовывался.
- index.html: toFixed(1) -> toFixed(2) — главный экран (val-tsa-m/val-tsar-m/val-tank-m/val-aqua-m) и страница Датчики (setS). Объёмы, влажность, BOX C не тронуты.

Почему так решили
Автор выбрал полный вариант: проскок серий >10 строк происходил именно в моменты смены этапов — то, что автору важно видеть. Окно 30 строк в прошивке + буфер 50 строк на клиенте закрывают проблему полностью; буфер дополнительно убирает churn перерисовки. Нагрузка: /api/status +~2KB, чтение SD 4KB вместо 1KB на каждый опрос — незначительно (readLastLog для кнопки ЛОГИ и так читает 16KB по требованию). Компиляция проверена PlatformIO: espressif32 7.0.1 (Arduino core 3.x) и 6.9.0 (2.x) — SUCCESS, RAM 15.1%, Flash 34.2% (без изменений). Алгоритм чтения лога проверен хост-симуляцией C++-логики (10 кейсов: обрез окна, «надкусанная» строка, окно без '\n', кап maxLines, длинные строки, порядок, пустые строки), клиентский буфер — симуляцией опросов (17 кейсов: дедупликация, порядок, лимит 50, отказ от лишних перерисовок, undefined/null в облачном режиме).

Ключевые детали
- Кнопка ЛОГИ (полный текстовый лог /api/logs) и облачный путь new_logs не менялись.
- Для ввода в действие: 1) прошить ESP32 (SDLogger.h + AppNetwork.cpp); 2) обновить на SD-карте /www/: index.html и index_landscape_knob.html. Совместимость: со старой прошивкой новая страница тоже работает — /api/status отдаст 10 строк, буфер их накопит.
- Дедупликация буфера текстовая: две РАЗНЫЕ записи в одну секунду с одинаковым текстом склеятся в одну (практически недостижимо — метки времени в каждой строке).

Изменённые файлы
- index.html — температуры 2 знака (главный экран, страница Датчики).
- index_landscape_knob.html — перестановка панелей (ЛОГИ/ДАННЫЕ/Коррекция % в заголовках), буфер лога 50 строк, отрезание даты, перенос строк на 2-ю строку, CSS.
- SDLogger.h — getLastLogLinesJson: окно 4KB, 30 строк, пропуск неполного первого фрагмента, полный скан окна.
- AppNetwork.cpp — handleApiStatus: getLastLogLinesJson(10) -> (30), комментарии.
- CHANGELOG.md — эта запись.

## [2026-08-30 10:48] — Сессия 8
Плановые работы (бэклог): синхронизация времени DS3231 (RTC) и медленное первое открытие веб-интерфейса. Изменений кода НЕТ — фиксация диагностики и плана.

Задача
30.08.2026 проведено тестирование этапов 1-6 на железе (логи старта в норме: WDT armed, BME OK, Wi-Fi с 1-й попытки, облако подключилось, процесс DIST стартовал). Выявлены две некритичные задачи; по решению автора отложены, но записываются в CHANGELOG, чтобы диагностика (симптом -> диагноз -> план с номерами строк) не потерялась до следующей сессии.

Плановая работа №1 — время DS3231 (RTC): часы на 3 часа позади до NTP-синка
Симптом: в логе старта 30.08.2026 виден мгновенный скачок времени [07:17:03] -> [10:17:03] (+3 ч) в момент NTP-синхронизации.
Диагноз: DS3231 фактически хранит время на 3 часа позади московского (по сути UTC), а код синхронизации (BuhloWar.ino:149-151) построен на допущении, что RTC хранит ЛОКАЛЬНОЕ время, и вычитает tzOffset*3600. В результате после включения системные часы отстают на 3 часа и исправляются только первым NTP-синком (~5-7 с после подключения Wi-Fi).
Почему нужно сделать: пока есть интернет, NTP маскирует проблему — страдают только строки лога загрузки. Но при старте БЕЗ интернета (перебои сети, смена точки доступа) часы на LCD, метки времени в system.log и телеметрии уедут на -3 часа до появления связи. Журнал перегонов — это фактически технологический протокол, неверные метки в нём недопустимы.
План исправления: 1) после успешного NTP-синка записывать скорректированное время обратно в DS3231 (rtc.adjust) — тогда RTC всегда хранит актуальное время и офлайн-старт идёт с верными часами; 2) сверить фактическое содержимое RTC с допущением кода (либо изменить допущение в коде, либо один раз выставить время модуля); 3) контрольный тест: отключить роутер, перезагрузить систему, убедиться что метки лога верные.

Плановая работа №2 — медленное первое открытие веб-интерфейса по локальному IP
Симптом: страница открывается только через заметный промежуток после подачи питания. По логу 30.08 окно «молчания» веба = 7 с (RTC -> System Ready); при медленном Wi-Fi/ретраях — до 30-35 с. После открытия всё работает стабильно.
Диагноз (по коду e82a065): главный фактор — флаг systemReady: AppNetwork::update() не вызывает server->handleClient(), пока setup() не дошёл до setSystemReady(true) (BuhloWar.ino:303; AppNetwork.cpp:469). Всё это время HTTP-запросы браузера принимаются TCP-стеком, но никем не обрабатываются. Внутри циклов подключения Wi-Fi handleClient тоже обёрнут в этот флаг (AppNetwork.cpp:177, 205, 348...). Второстепенные факторы: checkInternet() блокирует NetworkTask до 1 с каждые 10/30 с (AppNetwork.cpp:1187); SD работает на 4 МГц, а index.html — 150 КБ (~1-2 с только чтение); WiFi.setSleep(false) не включён — выше задержки в STA-режиме.
Почему не критично: задержка только сразу после старта, функционал полный.
Почему нужно сделать: оператор после включения не может понять, «жива» ли система — страница не отвечает до 10-30 с, что похоже на поломку; при ретраях Wi-Fi окно растёт до полуминуты. Второстепенные факторы дают микрозависания и в уже открытой странице.
План исправления (требует согласования перед внедрением): 1) раздавать статику (/www/, index.html) сразу с момента старта сервера, оставив гейт systemReady ТОЛЬКО на /api/*-обработчики (им без инициализированного движка нельзя — существующая crash-защита); недоступный до готовности API отвечает 503, JS страницы штатно переспрашивает; 2) WiFi.setSleep(false) после подключения STA — быстрее отклик (+~30 мА, для сети питания несущественно); 3) перенести LCD-задержки delay(800)x2 после setSystemReady(true) — минус ~1.6 с окна; 4) опционально, тестом на железе: SPI SD 4->20 МГц для быстрой раздачи статики (при нестабильности карты откат одной строкой).

Почему так решили
Обе задачи не влияют на безопасность процесса перегонки, приоритет — за автором. Правки кода по правилам AI_RULES выполняются только после согласования плана, поэтому сессия завершена документированием. Диагностика выполнена статически по коду коммита e82a065 и подтверждена логом устройства 30.08.2026; регрессия этапов 1-6 исключена — гейт systemReady, блокирующий begin() и порядок RTC-синка существовали до аудита и правками 1-6 не менялись.

Ключевые детали
- Логи старта 30.08.2026 подтвердили на железе все 6 этапов: [WDT] loopTask watchdog armed: 30s; BME280 initialized successfully; Wi-Fi 1-я попытка (4 с); Cloud Connected; Process START: DIST -> WATER_TEST -> RAZGON.
- Скачок времени в логе (+3 ч) — НЕ ошибка этапа 6 (перенос configManager.begin()): TZ читается из EEPROM корректно, смещение UTC+3 применено; причина — сами данные RTC отстают (см. работу №1).
- Оценка окна «молчания» веба: 5-10 с при хорошем Wi-Fi, 20-35 с при ретраях SSID1/SSID2 (3 попытки x 5 с на каждую сеть).

Изменённые файлы
CHANGELOG.md — только эта запись; код не менялся.

## [2026-08-29 14:36] — Сессия 7
Этапы 3-6 аудита кода за один заход: единицы измерения (план A), C2 двухъядерная гонка, C4 безопасность api.php, надёжность датчиков. Проверка компиляции.

Задача
По согласованной дорожной карте выполнены оставшиеся 4 этапа аудита за одну сессию (указание автора): 3) приведение единиц клапанных таймингов к секундам; 4) устранение двухъядерной гонки доступа к SystemStatus/SystemConfig; 5) безопасность облачного api.php; 6) надёжность датчиков и логгера. После правок — проверка на ошибки компиляции.

Решение
ЭТАП 3 (единицы, план A — секунды как эталон):
1. Поля SystemConfig headOpenMs/headCloseMs/bodyOpenMs/bodyCloseMs переименованы в headOpenSec/headCloseSec/bodyOpenSec/bodyCloseSec. Значения всегда были секундами (меню, TEST_HEAD умножал на 1000, веб передавал секунды) — имена «мс» обманывали. JSON-ключи (headOpenMs и т.д.) НЕ менялись для совместимости с index.html и сохранёнными профилями.
2. Дефолты loadConfig: 1200/2200/1100/2100 (мс-семантика) заменены на 1/10/2/10 сек — как в структуре и по ТЗ.
3. Одноразовая миграция EEPROM: байт ADDR_CONFIG_VERSION=486 (был свободен). Если версия не записана (0xFF), значения таймингов >60 сек считаются остатками мс-эпохи и делятся на 1000, значения <1 поднимаются до 1; после миграции пишется версия 1 — второй раз миграция не сработает.
4. Клампы 1..60 сек в /api/settings (handleSettingsSave) и при загрузке профилей (handleLoadProfile) — отсекают 0 и «миллисекундный» мусор.
5. Удалён мёртвый код: структура RectConfig (ProcessCommon.h) и член ProcessEngine::rectConfig — объявлены, но нигде не использовались, при этом содержали те же поля с ДРУГИМИ дефолтами и единицами. bodyOpenCor оказался живым (используется в TELO) — оставлен, исправлен его комментарий (мс → секунды).
6. GlobalConfig.tsaLimit (мёртвая структура) 95→45 по решению Q1 (рабочий диапазон 40-55 °C).

ЭТАП 4 (C2, вариант 1 — мьютексы + двойной буфер):
Выбран вариант 1 как минимально инвазивный (приоритет №1: не ломать соседей; вариант 2 с POD-конверсией потребовал бы переписывания всех LCD-меню и был бы рискован без железа под рукой).
1. statusMutex/configMutex (common.h extern, создаются в setup() рядом с sdMutex).
2. SystemStatus: писатель один (ядро 1). В конце update() статус целиком копируется в «задний» буфер-снимок (publishA/publishB — ping-pong), указатель front переключается под мьютексом (микросекунды). Web-задача (ядро 0) читает ТОЛЬКО через новый getStatusCopy(out) — всегда получает цельный готовый снимок. String-поля буферов переиспользуют ёмкость — в установившемся режиме без аллокаций.
3. AppNetwork: handleApiStatus, buildTelemetryJson читают статус/датчики/конфиг через копии; записывающие обработчики (handleSettingsSave, handleLoadProfile, handleCalcValve) теперь правят ЛОКАЛЬНУЮ копию конфига и целиком записывают её через setConfig (под мьютексом). Прямое редактирование общей структуры из Web-потока устранено.
4. getConfigCopy/setConfig в ConfigManager — под configMutex. Прямая ссылка getConfig() сохранена для LCD-меню (ядро 1, как и писатель).

ЭТАП 5 (api.php, C4):
1. checkApiKey(): ключ 'api_key' объявлялся, но не проверялся. Теперь Bearer-авторизация (hash_equals — защита от timing-атак) на всех изменяющих состояние эндпоинтах: telemetry, push, register_device, commands, cmd, settings (GET+POST). Открыты остались status/logs для дашборда. ESP32 уже отправлял Bearer во всех запросах (CloudManager) — совместимо.
2. writeJson() и записи лога — с LOCK_EX (параллельные записи повреждали JSON).
3. Дебаунс пушей: телеметрия шла каждые 2 с, push — на каждый пакет при аварии. Теперь: пуш немедленно при переходе на уровень тревоги, повторы не чаще 60 с (авария) / 300 с (внимание); состояние в buhlo_alert_state.json, пишется только при изменениях.
4. SSL_VERIFYPEER false→true (OAuth-токен и FCM) — без проверки сертификата возможен MITM с перехватом ключей; добавлено error_log при сбоях curl, закрыт curl_close в getAccessToken.
5. cloudApiKey маскируется в buildCfgJson (первые 4+****+последние 4); значение со звёздочками при сохранении настроек игнорируется — настоящий ключ не затирается маской.
6. Проверки lock.locked в readNewLog, handleSaveProfile, handleLoadProfile — раньше при занятой SD обращение к файлу шло В ОБХОД мьютекса.

ЭТАП 6 (датчики и логгер):
1. BME280: если датчик не найден при старте или отвалился после ошибки чтения, update() пробует переинициализацию раз в 30 сек (initBME() вынесена из begin()). Восстановление без перезагрузки.
2. TSA-тревога удерживается при пропаже датчика: раньше мгновенный сброс валидности обнулял тревогу и отсчёт VREAC (дребезг мог бесконечно откладывать аварию). Теперь тревога и таймер сохраняются до возврата датчика; если время вышло, пока датчик висит — FINISHING_WORK по правилу VREAC.
3. SDLogger: currentFileSize теперь восстанавливается из реального размера /system.log при первом обращении после ребута — раньше ротация не срабатывала, файл распухал до 200 КБ при лимите 100 КБ.
4. DS18B20-калибровка неблокирующая: startCalibration() больше не останавливает ядро 1 на ~750 мс (скан шины асинхронный, результат в update() через 800 мс), checkCalibrationDelta() больше не делает блокирующую конвертацию на каждый опрос (то же самое делала и меню, и веб-калибровка). isCalibrating() возвращает true во время скана — меню не показывает ложный «NOT FND».
5. Часовой пояс: configManager.begin() перенесён РАНЬШЕ синхронизации DS3231 — раньше RTC-синк брал дефолтный TZ (UTC+3) вместо сохранённого в EEPROM.

Почему так решили
Все правки минимально инвазивны: логика процессов, меню и веб-интерфейса не изменена; JSON-контракты сохранены; единицы приведены к фактическим (секунды). Вариант 1 этапа 4 выбран вместо POD-рефакторинга ради безопасности смежных модулей. Каждое изменение снабжено комментарием «как было / почему / как стало» для новичка.

Ключевые детали
- ПРОВЕРКА КОМПИЛЯЦИИ: полная сборка PlatformIO (espressif32 7.0.1 / Arduino core 3.x) — SUCCESS, и второй env (espressif32 6.9.0 / Arduino core 2.x) — SUCCESS (проверены ОБЕ ветки #if WDT-кода). RAM 15.1%, Flash 34.2%. Предупреждения — только ранее существовавшие (Cyrillic case-labels в transliterate(), redefine в сторонней библиотеке BME); изменённый код даёт 0 новых предупреждений.
- Остаточные принятые риски (документированы): точечные чтения int-полей конфига через getConfig() в 3 местах (атомарные 32-битные чтения на Xtensa безопасны); SensorData читается Web-потоком копией (риск torn-чтения только при переименовании датчика — микросекундное окно); saveConfig из Web может гоняться с редким редактированием меню на LCD.
- Найдено при реализации: член ProcessEngine::distConfig тоже мёртв (объявлен, не используется) — НЕ удалялся (не входил в согласование), кандидат на следующий этап.
- emergencyStop() по-прежнему не вызывается нигде — вне согласованного объёма, предложено обсудить отдельно.

Изменённые файлы
BuhloWar.ino: определение statusMutex/configMutex; создание мьютексов в setup(); configManager.begin() перенесён раньше RTC-синка (TZ)
ProcessCommon.h: удалена мёртвая RectConfig; GlobalConfig.tsaLimit 95→45
preferences.h: поля *Ms→*Sec; ADDR_*_SEC; ADDR_CONFIG_VERSION=486; объявлен getConfigCopy()
preferences.cpp: дефолты 1/10/2/10 сек; одноразовая миграция единиц с версией; getConfigCopy()/setConfig под configMutex
ProcessEngine.h: удалён rectConfig; комментарий bodyOpenCor; publishA/publishB/publishFront; getStatusCopy/publishStatus
ProcessEngine.cpp: публикация снимка в конце update(); getStatusCopy; удержание TSA-тревоги при пропаже датчика; переименования *Sec
AppNetwork.cpp: потокобезопасные копии статуса/конфига во всех обработчиках; локальная правка+setConfig в записывающих; клампы 1..60; маска cloudApiKey + защита от самозамены; lock.locked в профилях; JSON-ключи сохранены
common.h: extern statusMutex/configMutex + include semphr
SDLogger.h: восстановление currentFileSize после ребута; lock.locked в readNewLog
SensorManager.h/.cpp: асинхронный скан шины калибровки; неблокирующий checkCalibrationDelta; isCalibrating учитывает скан; отмена скана
SensorAdapter.h/.cpp: initBME() выделена; авто-восстановление BME280 раз в 30 сек
menu_rect_setup.h: переименования *Sec (case 10-13)
api.php: checkApiKey на защищённых эндпоинтах; LOCK_EX; дебаунс пушей 60/300 с; SSL_VERIFYPEER=true; curl_error логи; curl_close

## [2026-08-29 13:51] — Сессия 6
Этап 2 аудита кода: C3 — телеметрия собиралась на каждом обороте loop (фрагментация кучи); WDT — зависание loopTask не обнаруживалось; L3 — поясняющий комментарий

Задача
Этап 2 дорожной карты (согласован с автором): 1) устранить сборку телеметрии JSON на каждом обороте loop() — она выполнялась сотни раз в секунду при отправке раз в 2 секунды; 2) добавить автоматическое восстановление при зависании процессной логики (watchdog); 3) добавить согласованный поясняющий комментарий к powerOffBodyValve() (вывод по находке L3).

Решение
1. C3: в loop() сбор телеметрии ограничен 1 разом в 2 секунды (static lastTelemetryMs + millis-гейт). buildTelemetryJson() собирает JSON из ~40 String-конкатенаций — тысячи аллокаций кучи в секунду фрагментировали кучу за часы/дни работы. Логика CloudManager не изменялась.
2. WDT: loopTask подписан на сторожевой таймер (30 с, trigger_panic=true); кормление esp_task_wdt_reset() в начале каждого loop(). Если процессная логика на ядре 1 зависнет — ESP32 перезагрузится сама; причина ESP_RST_TASK_WDT уже различается в журнале загрузки. Совместимость ядер ESP32 2.x/3.x через #if ESP_ARDUINO_VERSION_MAJOR (разный API: секунды vs структура конфигурации в мс).
3. L3: к powerOffBodyValve() добавлен комментарий: для НО-клапана (bodyValveNC == false) LOW = клапан физически ОТКРЫТ; это сознательно — вызов при завершении работы, когда система уже обесточена и отбора нет (решение автора по Q3). Код функции не изменялся.

Почему так решили
Минимальные правки: один основной файл (BuhloWar.ino) и комментарий в OutputManager.cpp. Смежные модули (CloudManager, AppNetwork, ProcessEngine) не затронуты. Частота отправки телеметрии на сервер не изменилась (2 с) — изменилась только частота сборки JSON. Разбор облачных команд теперь идёт с каденсом <=2 с, что совпадает с собственным опросом команд в cloud-задаче (commandCheckIntervalMs=2000).

Ключевые детали
- Телеметрия: было ~сотни сборов JSON/с, стало 1 сбор/2 с; куча больше не фрагментируется; веб /api/status не затронут (отдельный путь).
- WDT: до правки loopTask не был подписан на esp_task_wdt вовсе; зависание loop() не обнаруживалось — веб отвечал при мёртвом процессе. После: зависание >30 с → паника → перезагрузка → запись «Watchdog Timeout» в журнале загрузки.
- Таймаут 30 с выбран по замерам самой длинной легальной блокировки loop(): запись SD ~1 с, сообщение в меню датчиков 1.5 с, прогрев при старте процесса 1 с — 15-кратный запас, ложных срабатываний нет.
- Первый сбор телеметрии — в первые 2 секунды после старта loop(): задержки облачной синхронизации нет. Очередь облачных команд (5 эл.) не переполняется: источник опрашивает сервер тоже раз в 2 с.

Изменённые файлы
BuhloWar.ino: include-блок (esp_task_wdt.h, esp_arduino_version.h); setup() — блок 9: подписка loopTask на WDT (30 с, panic=true, выбор API по версии ядра); loop() — кормление WDT и millis-гейт телеметрии 2 с
OutputManager.cpp: поясняющий комментарий к powerOffBodyValve() (без изменения кода)

## [2026-08-29 13:20] — Сессия 5
Этап 1 аудита кода: C1 — ре-инициализация TELO каждый цикл loop; L1 — мутация cfg.nasebTime; L2 — ложный выход из WAITING при неготовом датчике TSAR

Задача
Полный аудит кода выявил три бага в ProcessEngine (этап 1 дорожной карты, согласован с автором):
1. C1 (критичный): в handleTelo() не обновлялся previousStage — условие ре-инициализации (previousStage != Stage::TELO) было истинно на каждом обороте loop(). Инициализация выполнялась сотни раз в секунду: rtsarM перезахватывался (порог залёта «убегал» вместе с температурой), speedShpora сбрасывался к 500*koff (Шпора не снижала скорость), bodyVolDone обнулялся (объём в вебе ≈ 0), лог «TELO Start» раздувал SD-лог. Итог: ТЕЛО никогда не завершалось автоматически ни в Шпоре (нет снижений скорости и порога minBodySpeed), ни в Стандарте (залёты не детектировались, counter не рос). Регрессия внесена коммитом 6d1499d.
2. L1: при повторной стабилизации после залёта код выполнял cfg.nasebTime = cfg.reklapTime прямо над общим объектом конфигурации. Искажённое значение переживало процесс, показывалось в вебе/LCD и попадало в EEPROM при любом последующем сохранении настроек.
3. L2: если на входе в WAITING датчик TSAR был не валиден, точкой отсчёта ставился 0 °C. Выход из этапа (tsar >= initial + 5 °C) срабатывал сразу после восстановления датчика — любая горячая колонна выше 5 °C, реальный прогрев не проверялся.

Решение
1. C1: в конец блока инициализации handleTelo() добавлен previousStage = Stage::TELO — восстановлен общий паттерн этапов (handleWaiting, handleDistOtbor, handleDistBakstop, handleNasebya делают то же самое). Инициализация теперь выполняется один раз при входе в этап и один раз после каждого возврата из NASEBYA (как и задумано комментарием условия).
2. L1: введён член класса nasebTimeOverride (0 = использовать cfg.nasebTime). При залёте ставится nasebTimeOverride = cfg.reklapTime (общий конфиг не трогается); учитывается в таймере handleNasebya(), в логе «target: Xmin» (теперь показывает фактическую цель) и в LCD-остатке стабилизации; сбрасывается в startProcess().
3. L2: точка отсчёта при невалидном датчике НЕ фиксируется нулём; при первом валидном замере выполняется динамический захват (флаг waitingRefCaptured, лог «WAITING: TSAR ready. Reference captured»). Выход из этапа требует waitingRefCaptured && isTsarValid() && tsar >= initial + 5.

Почему так решили
- Минимальный дифф в двух файлах: смежные модули (OutputManager, SensorManager, меню, веб, api.php) не затронуты, формулы и порядок логики сохранены 1-в-1.
- Для L1 поведение идентично прежнему (повторная стабилизация = reklapTime), но защита конфига/EEPROM теперь явная.
- Для L2 нормальный путь (исправный датчик на входе) не изменён вовсе.

Ключевые детали
- Восстановлен автофиниш ТЕЛО: Шпора — снижения скорости по delta (с паузой shporaStabMs) до порога minBodySpeed; Стандарт — залёты, counter/cycleLim. Первые 1-2 перегонки рекомендуются под присмотром.
- Лог «TELO Start. Method: …» пишется один раз на вход/возврат (перестал раздувать SD-лог).
- bodyVolDone, ETA тела и остаточное время в вебе считаются корректно.
- waitingRefCaptured сбрасывается при каждом новом заходе в WAITING; перезахвата посреди этапа нет (при моргании датчика после захвата поведение прежнее).
- nasebTimeOverride сбрасывается в startProcess() — подмена не переживает процесс.

Изменённые файлы
ProcessEngine.h: добавлены члены nasebTimeOverride, waitingRefCaptured (с комментариями)
ProcessEngine.cpp: handleTelo — previousStage = Stage::TELO (C1), nasebTimeOverride вместо мутации конфига (L1); handleNasebya — фактическая цель в логе и в таймере этапа (L1); updateDisplayData — LCD-остаток стабилизации от фактической цели (L1); startProcess — сброс nasebTimeOverride (L1); handleWaiting — динамический захват точки отсчёта (L2)

## [2026-08-28 21:00] — Сессия 4
Рефакторинг: упрощённая методика калибровки клапанов (цикл 1с/1с)

Задача
Три проблемы в мастере калибровки:
1. Импульсный тест на низкой duty cycle (2-5%) давал 2-3 импульса за 60 сек — недостаточно для точного измерения
2. Web wizard: полная рассинхрон маппинга шагов ESP (CalibStep enum) ↔ Web (stepToElId), из-за чего BODY_NC и BODY_NO перепрыгивали шаги
3. Двухточечная калибровка BODY_NC (capacity на скорости голов + на скорости тела) — ненужная сложность, физический capacity клапана при 100% открытии один

Решение
1. Единый метод замера для ВСЕХ клапанов: после пролива запускается цикл 1 сек открыт / 1 сек закрыт на 60 секунд. За 60 сек — 30 импульсов, клапан открыт суммарно 30 сек. Duty = 0.5, capacity = volume × 2 (мл/мин)
2. Убрана двухточечная калибровка BODY_NC — один capacity для всех клапанов
3. Упрощён wizard: 2 шага (пролив → замер) + ввод объёма + результат. Все типы клапанов одинаковы
4. Исправлен маппинг шагов ESP ↔ Web (CalibStep: 0=IDLE, 1=DRY, 2=CAPACITY, 3=INPUT, 4=RESULT)

Почему так решили
- Фиксированный цикл 1с/1с даёт стабильные 30 импульсов — достаточно для точного измерения
- Один capacity на клапан — это физическое свойство клапана+трубки, не зависящее от целевой скорости отбора
- Процесс (calcValveTiming) сам рассчитывает duty по формуле: duty = targetSpeed / (capacity × 60)
- Упрощение с 7 состояний/шагов до 4 убрало все баги синхронизации

Ключевые детали
- startCyclingForTest() теперь не принимает параметров, использует константы CALIB_CYCLE_OPEN_MS=1000, CALIB_CYCLE_CLOSE_MS=1000
- backCalculateCapacity() переименована в calculateCapacity() (та же формула, но с фиксированным duty)
- BODY_NC больше не использует valve_body_capacity_heads для калибровки (поле остаётся в EEPROM для совместимости)
- Команды CALIB_START_CAP_HEADS и CALIB_START_CAP_BODY удалены из UiCommand enum
- capacityHeads и headsTestVolume удалены из CalibWizard status struct

Изменённые файлы
ValveCalMenu.h: полная переработка — удалены WIZARD_CAP_HEADS/BODY, WIZARD_INPUT2, CalibStep::CAPACITY_HEADS/BODY/INPUT_VOLUME2, isTwoPointCalibration(), needsCyclingForCapacity(), getHeadsTargetSpeed(), getBodyTargetSpeed(), startCapHeadsFromWeb(), startCapBodyFromWeb(). startCyclingForTest() теперь фиксированный 1с/1с
ProcessCommon.h: удалены CALIB_START_CAP_HEADS/CALIB_START_CAP_BODY из UiCommand, удалены capacityHeads/headsTestVolume из CalibWizard struct
ProcessEngine.cpp: удалены обработчики CALIB_START_CAP_HEADS/CALIB_START_CAP_BODY, удалено присвоение capacityHeads/headsTestVolume
AppNetwork.cpp: удалён парсинг CALIB_START_CAP_HEADS/CALIB_START_CAP_BODY, удалён capacityHeads из calibWizard JSON
index.html: удалены шаги 2a/2b/3b, исправлен stepToElId, упрощены все JS функции wizard'а
index_landscape_knob.html: те же изменения, адаптированы под style.display вместо classList

## [2026-08-28 20:00] — Сессия 3
Фикс: восстановлено объявление cfg в startCyclingForTest()

Задача
При предыдущем коммите (ce22ddf) в startCyclingForTest() была удалена строка SystemConfig& cfg = config->getConfig() вместе с заменой cfg.minOpenTime на CALIB_MIN_OPEN. Без этой строки обращения к cfg.valve_head_capacity, cfg.valve_body_capacity, cfg.valve0_body_capacity на строках 148-155 вызывали ошибку компиляции: 'cfg' was not declared in this scope.

Решение
Добавлена строка SystemConfig& cfg = config->getConfig(); после объявления CALIB_MIN_OPEN.

Почему так решили
Строка была случайно удалена при редактировании — cfg используется для чтения текущих значений capacity как начальной оценки для расчёта duty cycle. Без неё функция не компилируется.

Ключевые детали
Затронута только одна строка, логика не изменена.

Изменённые файлы
ValveCalMenu.h: добавлено SystemConfig& cfg = config->getConfig(); в startCyclingForTest()

## [2026-08-28 19:30] — Сессия 2
Фикс: калибровка клапанов — расчёт capacity через ESP + импульсы при 500 мс

Задача
Два критических бага в мастере калибровки клапанов:
1. Web-мастер сохранял сырой измеренный объём (мл) как capacity вместо расчёта через backCalculateCapacity()
2. При калибровке использовался cfg.minOpenTime (1000 мс), что давало 1-2 импульса за 60 сек — недостаточно для точного измерения

Решение
1. Web теперь отправляет CALIB_SET_VOLUME в ESP. ESP рассчитывает реальный capacity через backCalculateCapacity() и сохраняет в EEPROM
2. startCyclingForTest() использует фиксированный minOpen = 500 мс (вместо cfg.minOpenTime), что даёт ~7 импульсов за 60 сек

Почему так решили
- backCalculateCapacity() учитывает duty cycle теста и извлекает истинную пропускную способность. Без него при duty=2% ошибка в 50 раз
- 500 мс ближе к реальной работе клапана в процессе, даёт достаточно импульсов для точного измерения, не затрагивает calcValveTiming() в рабочем процессе

Ключевые детали
- Добавлена команда CALIB_SET_VOLUME в ProcessEngine.cpp и AppNetwork.cpp
- В JSON-статус calibWizard добавлено поле capacityHeads (раньше отсутствовало — Web всегда получал 0)
- Web submitCalibVolume/submitCalibVolume2 переписаны: вместо прямого POST /api/settings отправляют команду в ESP
- updateCalibWizardUI() теперь вызывает updateValveCalibrationStatus() при показе результата

Изменённые файлы
ValveCalMenu.h: startCyclingForTest() — фиксированный CALIB_MIN_OPEN = 500 вместо cfg.minOpenTime
AppNetwork.cpp: добавлен парсинг CALIB_SET_VOLUME с извлечением volume из JSON; добавлено capacityHeads в calibWizard JSON
ProcessEngine.cpp: добавлен обработчик UiCommand::CALIB_SET_VOLUME → valveCalMenu->setVolumeFromWeb()
index.html: submitCalibVolume() и submitCalibVolume2() переписаны на отправку CALIB_SET_VOLUME в ESP
index_landscape_knob.html: те же исправления submitCalibVolume/submitCalibVolume2 + updateValveCalibrationStatus при RESULT

---

## [2026-08-28 12:00] — Сессия 1
Фикс: система не подключается к SSID2 при старте

Задача
При смене роутера система не подключалась к новой точке доступа (SSID2), хотя обе сети прописаны в конфиге. Система всегда оставалась в AP_MODE.

Решение
В `begin()` после 3 неудачных попыток SSID1 добавлены 3 попытки подключения к SSID2 (по аналогии с `connectToWiFi()`). Добавлена переменная `connectedSSID` для корректного логирования подключённой сети.

Почему так решили
Метод `begin()` содержал цикл только для SSID1. Метод `connectToWiFi()` (пробующий обе сети) существовал, но нигде не вызывался — мёртвый код. Реконнект в `update()` тоже умеет пробовать SSID2, но срабатывает только в STA_MODE, а система застревала в AP_MODE.

Ключевые детали
- Перед переключением на SSID2 вызывается `WiFi.disconnect(false)` + `WiFi.mode(WIFI_AP_STA)` — безопасный сброс без убийства AP режима
- Логирование Serial теперь показывает какой SSID пробуется: `(SSID1: имя)` или `(SSID2: имя)`
- logger.log записывает реальное имя подключённой сети, а не всегда ssid1
- Не затрагивает: update(), tryReconnectOnce(), startAPMode(), handleClient(), API handlers

Изменённые файлы
AppNetwork.cpp: добавлен блок попыток SSID2 в begin() (строки 187-214), переменная connectedSSID (строка 155), исправлен logger.log (строка 228)

---

## [2026-07-22 20:00] — WebUI: устранение остаточной блокировки

### AppNetwork.cpp — Убран блокирующий checkInternet() из update()
- `update()` каждые 10 сек вызывал `checkInternet()` → `WiFiClient.connect("google.com",80)` блокировал WebUI на 4-5 сек при недоступном интернете
- `setTimeout(1)` устанавливал таймаут **чтения**, а не подключения — connect висел до дефолтного TCP-таймаута ESP32
- **Решение**: в `update()` определяется `online = (WiFi.status() == WL_CONNECTED)` — мгновенно, без DNS/TCP запросов
- `checkInternet()` сохранён только в `begin()` при начальном старте (1 раз, не в горячем пути)
- Реальная проверка доступности облака переложена на CloudManager: если HTTPS-запрос упал — `online` скорректируется

### Изменённые файлы
- AppNetwork.cpp

---

## 2026-07-22 18:00] — Рефакторинг: стабильность и миграция EEPROM

### BuhloWar.ino — Оптимизация и порядок инициализации
- `logger.init()` перенесён сразу после `initSD()` — SD должна быть готова до логирования
- Убран `Serial.setDebugOutput(true)` — мешал чтению данных с датчиков
- Задержки 1000ms/2000ms уменьшены до 50ms/100ms — старт ускорен на ~3 секунды
- TZ-строка исправлена с `"MSK-3"` на правильный POSIX-формат
- `xQueueSend(commandQueue, ...)` в setup/loop заменён на лямбду с `auto` для избежания копирования структуры
- Убран дубль `outputManager.update()` из loop() — вызов уже есть внутри `processEngine.update()`

### ProcessEngine.h/cpp — Статическая память → член-переменные
- 4 static-переменные в `handleTelo()` (`bmeWasAvailable`, `bmeReferenceCaptured`, `lastOpenMs`, `lastCloseMs`) перенесены в члены класса с префиксом `telo` — устранено недетерминированное поведение при перезапуске процесса
- В `startProcess()` добавлен сброс этих переменных
- Условие реинита TELO расширено: `currentStage == TELO && previousStage != TELO` — корректный возврат из NASEBYA
- Тесты клапанов: добавлен авто-таймаут 5 минут для состояния `awaitingInput`
- Введена функция `sensorNameToIndex()` — заменены 4 копипастных if-else цепочки в update() и handleCommand()

### AppNetwork.cpp — Null-safe API хендлеры
- Добавлены проверки `configManager != nullptr` в `handleApiSettings()`, `handleSaveProfile()`, `handleLoadProfile()`, `handleCalcValve()`

### preferences.cpp — EEPROM writeInt/readInt: корректный big-endian
- `writeInt` переписан на стандартный big-endian: `[31:24, 23:16, 15:8, 7:0]`
- `readInt` с авто-детектом старого формата `[15:8, 7:0, 31:24, 23:16]`: если bytes[2:3] == 0x00 — читает как старый формат (миграция), иначе как новый big-endian

### Изменённые файлы
- BuhloWar.ino
- ProcessEngine.h
- ProcessEngine.cpp
- AppNetwork.cpp
- preferences.cpp

---

## 2026-07-22 14:00] — Сессия 9

Задача
Перенести отображение температур на SVG-аппарат (в обоих режимах), переименовать блок «ТЕМПЕРАТУРЫ» в «ЛОГИ» с выводом строк из логов системы. Модифицировать ESP32 код для передачи логов в /api/status.

Решение
Что было сделано

Этап 1: Температуры на SVG
Добавлены text элементы поверх SVG-аппарата в обоих режимах:
- Ректификация: TSA над дефлегматором, ВОДА справа от патрубка, ЦАРГА слева от колонны, БАК на баке
- Дистилляция: БАК на баке, TSA слева от носика-капельника, ЦАРГА над П-трубой, ВОДА слева от патрубка
Размер 22px, weight 660, tabular-nums, цветовая кодировка (amber/cyan/orange/blue).
JS-логика обновления в updateApparatusSVG().

Этап 2: Блок ТЕМПЕРАТУРЫ → Логи
- Заголовок: «Логи» (было «Температуры»)
- Консоль логов: моноширинный шрифт (Consolas 10px), прокрутка
- Новые строки сверху, старые внизу
- МОЩН / BOX C / ВЛАЖН — в самом низу блока
- Скрытые span элементы сохранены для совместимости с JS
- JS-логика в syncData(): если newData.logs — массив, перерисовывает консоль

Этап 3: Модификация ESP32 кода
SDLogger.h — новый метод getLastLogLinesJson(int maxLines = 10):
- Читает только 1KB с SD (вместо 16KB у readLastLog) — не нагружает систему
- Возвращает готовый JSON-массив: ["строка1","строка2",...]
- Мьютекс с таймаутом 500мс

AppNetwork.cpp — добавлена одна строка перед server->send():
json += ",\"logs\":" + logger.getLastLogLinesJson(10);

Изменённые файлы
- index_landscape_knob.html — температуры на SVG + блок Логи + JS-логика
- distillation_preview.html — температуры на SVG (синхронизировано)
- SDLogger.h — новый метод getLastLogLinesJson()
- AppNetwork.cpp — logs в JSON /api/status

---
## 2026-07-22 12:00] — Сессия 8

Задача
Доработка режима дистилляции в distillation_preview.html:
1. Непропорциональные размеры бака и дефлегматора — увеличить бак
2. Приёмная бутыль не под дефлегматором — выровнять
3. Серый квадрат-артефакт на бутыли — исправить
4. Направление потока воды на входе (синий) — вода должна идти В дефлегматор
5. Нагрев под баком — оранжевый только при активном нагреве, иначе серый
6. Водяные патрубки дефлегматора — оба слева (ввод снизу, вывод сверху)
7. П-труба — толще, верхний участок выше

Решение
Что было сделано
1. Бак ×1.45 — transform translate(290, 440) scale(1.45), заметно крупнее дефлегматора
2. Дефлегматор напрямую — вместо rotate(180) нарисован в нужной ориентации
3. П-труба 24px (было 18px), верхний участок на y=320, входит по центру дефлегматора (x=100)
4. Водяные патрубки слева: синий ввод снизу (y=490), оранжевый вывод сверху (y=410). Синий путь развёрнут (вода течёт В дефлегматор)
5. Бутыль под дефлегматором — translate(-188, 165), центр x=100, соосна с носиком-капельником
6. bottleClipDist — перенесён из defs внутрь группы бутыли (фикс серого квадрата)
7. Капли продукта — координаты исправлены (cx=288, cy=232 в локальной системе)
8. Нагрев: heat-on (оранжевый) / heat-off (серый #3a4248) с переключением через JS
9. Носик-капельник — перемещён с x=137 на x=100 (соосно горлу бутыли)

Изменённые файлы
- distillation_preview.html — полная переработка apparatusDist + нагрев
- index_landscape_knob.html — синхронизированы те же изменения + нагрев в apparatusRect

---

##2026-07-14 12:00] — Сессия 1

Задача
Изменить визуальную стилистику интерфейса index_landscape_knob.html по образцу референса https://rect.marz-ban.ru/: заменить киберпанк-неоновый HUD на тёмный glassmorphism с циан-акцентом, заменить круговую диаграмму в центре мониторинга на анимированную SVG-схему аппарата, удалить PowerKnob (SVG-потенциометр), перенести блоки времени/этапа/процесса под SVG в строку статуса.

Решение
Что было сделано
Палитра — переведена на палитру референса: фон #05070d, glass-карточки rgba(255,255,255,0.045) с backdrop-filter: blur(16px), циан #35e0d0 как основной акцент, amber #ffb24d, heat #ff7a2f, reflux #8fd4ff. Все оригинальные имена CSS-переменных (--neon-blue, --panel-bg, --panel-border и т.д.) сохранены — изменены только их значения, чтобы не сломать существующие правила.
Фон — добавлены два дрейфующих aurora-блоба (teal сверху-слева, indigo снизу-справа) с blur(90px) и mix-blend-mode: screen. Сетку заменили на тонкие горизонтальные линии (каждые 34px) + radial-glow сверху-центр.
Шрифт — system-ui, -apple-system, "Segoe UI", Roboto, sans-serif вместо Consolas. Везде tabular-nums для чисел, letter-spacing: -0.02em для крупных значений, +0.06em для uppercase-меток.
Компоненты — все панели/карточки/диалоги/кнопки переведены на glass-стиль: радиусы 22/18/16/12px, pill-бейджи (999px) для статусов, glow-тени только на активных индикаторах. Навигационные кнопки — pill-shape. Диалоговые кнопки — pill-shape с цветными бордерами.
Центр мониторинга — <canvas id="gaugeCanvas"> заменён на инлайн SVG viewBox="0 0 400 720" со схемой аппарата: дефлегматор Димрота с протоком, стеклянная царга с 6 медными тарелками (по 3 bubble caps каждая), узел отбора с игольчатым клапаном, приёмная бутыль, кламп, куб с sight glass и жидкостью, нагревательный элемент. Все элементы анимированы (пар 16 частиц, 12 капель флегмы, 8 пузырьков, 3 капли продукта, glow нагрева, проток в змеевике, glass-shine).
PowerKnob — полностью удалён: контейнер <div id="power-knob-container">, весь IIFE-скрипт const PowerKnob=(function(){...})() и его вызовы в updateConfigDisplay() и DOMContentLoaded. Текстовое отображение мощности «МОЩН 3000W» в темп-панели сохранено.
Статус-бар — .gauge-center-info удалён (display:none). Время/этап/процесс-бейдж перемещены в .gauge-status-bar под SVG, рядом со статус-тегом/счётчиком/методом. Status-bar теперь в потоке (был absolute).
SVG-анимации — добавлены CSS-правила для .coilflow, .vapor, .bubble, .drip, .product, .heatglow, .glass-shine с @keyframes для каждой. Учтён prefers-reduced-motion.
Логика синхронизации — добавлена функция updateApparatusSVG(), вызываемая из updateMonitoringHUD() каждую секунду. Обновляет: поворот иглы клапана (0°/80°) по stage, цвет клапана (циан/серый) по valveOpen, видимость капель продукта по valveOpen, opacity нагрева/пара/пузырьков по heaterOn, паузу протока в дефлегматоре по waterValveOpen. Не добавляет новых API-вызовов — использует уже существующие поля currentData.
Почему так решили
Сохранение имён CSS-переменных — позволяет изменить палитру во всех существующих правилах без переписывания CSS. Не ломает логику.
Ранний возврат в drawGauge() — функция остаётся (вызывается из updateMonitoringHUD), но if(!cv)return; отрабатывает корректно, так как canvas удалён. Это минимальное изменение, не требующее правок в логике синхронизации.
SVG частицы генерируются JS один раз при загрузке — как в референсе. Это даёт случайные параметры (длительность, задержка, позиция) для естественного движения, но не нагружает цикл синхронизации.
updateApparatusSVG() только читает currentData — не делает новых fetch-запросов, не изменяет состояние. Полностью пассивная функция.
Stage → valveOpen маппинг — клапан считается открытым на стадиях GOLOVY / GOLOVY_OK / TELO / NASEBYA (когда идёт активный отбор). На других стадиях клапан закрыт визуально.
Ключевые детали
Размер SVG: 400×720 viewBox, рендерится ~315×567px в доступном пространстве. PreserveAspectRatio по умолчанию (xMidYMid meet) — колонка сохраняет пропорции и центрируется.
Анимации CSS vs JS: все циклические анимации (пар, капли, пузырьки, glow, проток) сделаны на CSS @keyframes с custom properties (--vdur, --vx, --bdur, --ddur, --pdur) для передачи параметров из JS. Состояние (видим/скрыт, пауза) управляется через style.display и style.animationPlayState.
scanline оставлена, но приглушена: opacity 0.04, период 12с (было 8с). Сохраняет атмосферу, не отвлекает.
Шрифт: переменные веса 640/650/660/670 вместо 700/800 для более тонкого «engineered» вида (как в референсе).
Изменённые файлы
download/index_landscape_knob.html — рестайлинг + замена canvas на SVG + удаление PowerKnob + добавление updateApparatusSVG() и initApparatusSVG() IIFE
download/CHANGELOG.md — этот файл (новый)
Что НЕ менялось (контрольный список)
❌ JS-логика: syncData, sendCommand, saveSettings, adjCfg, toggleCfg, autoSaveSetting, checkModals, калибровочный мастер, инженерное меню, профили, облачный режим
❌ API-эндпоинты: /api/status, /api/command, /api/settings, /api/saveprofile, /api/listprofiles, /api/loadprofile, /api/calcvalve
❌ Все ID элементов, на которые ссылается JS (248 шт., проверено — нет дубликатов)
❌ Все 64 ключевые функции (проверено — все определены)
❌ Все 33 onclick-обработчика (проверено — все привязаны к функциям)
❌ Страницы: Мониторинг, Дистилляция, Ректификация, Датчики, Настройки
❌ Диалоги: alert, save/load profile, calc, calibration wizard, engineering menu
❌ TSAR bar (только перекрашен в новую палитру)
❌ Барометр (только перекрашен)
❌ Конфигурационные параметры и их диапазоны
❌ Сообщения этапов (WATER_TEST, REPLACEMENT, GOLOVY_OK, SET_PW_AS, VALVE_CAL, ...)
Проверка
✅ HTML валиден (парные теги <style> 1/1, <script> 3/3)
✅ 248 ID, без дубликатов
✅ Все 64 ключевые функции определены
✅ Все 7 API-эндпоинтов на месте
✅ PowerKnob полностью удалён (0 ссылок в коде, 3 упоминания только в комментариях)
✅ Браузер-тест: страница загружается без JS-ошибок, SVG рендерится (1 svg, 56 эллипсов тарелок, 16 частиц пара, 8 пузырьков, 12 капель, 3 капли продукта, 8 coilflow-путей)
✅ Навигация работает (переходы между страницами, открытие инженерного меню и калибровочного мастера)
[2026-07-14 14:30] — Сессия 2

Задача
Сделать две компоновки SVG-аппарата, переключаемые по режиму процесса:

Ректификация (process=2) — текущий вид: дефлегматор сверху, царга с тарелками, бак снизу
Дистилляция (process=1) — перевёрнутый дефлегматор слева, П-образная труба из нержавейки 2" соединяет верх бака с верхом дефлегматора, бутыль под дефлегматором
IDLE (process=0) — показывать последний активный режим (запоминать в localStorage)
Главное: анимация потока воды в дефлегматоре (.coilflow) должна работать только когда waterValveOpen === true — в обоих режимах
Заменить примитивный бак на реалистичный бак Domspirt 37L (по образцу domspirt.ru): домообразная крышка с три-клампами, 2 боковые ручки с чёрными грипами, цифровой термометр, сливной кран с синей ручкой, клапан безопасности
Решение
Что было сделано
Структура SVG — разделена на две группы внутри одного <svg>:
<g id="apparatusRect"> — ректификация (видна по умолчанию)
<g id="apparatusDist" style="display:none"> — дистилляция (скрыта по умолчанию)
Общие <defs> с градиентами для стекла, меди, стали и нового бака
Новый бак Domspirt 37L (в обеих группах, через transform="translate(cx, cy)"):
Корпус: вертикальный цилиндр из браш-стали (url(#tankBody) — 7-стоповый градиент с вертикальными бликами)
Домообразная крышка (url(#tankLid)) с центральным 2" три-кламп феррулом
2 три-клампа по бокам от феррула (с красными болтами #c93030)
Красный клапан безопасности слева на куполе
2 боковые U-образные ручки (url(#steelV)) с чёрными резиновыми грипами (#1a1a1a)
Цифровой термометр слева на корпусе (белый корпус #e8e8e8, синий экран #3a5a8a, зелёные цифры #7ff0cf)
Сливной шаровый кран с синей пластиковой ручкой (#2a6fc9) справа внизу
Стальные кольца-усиления сверху и снизу корпуса
Трапециевидное основание (url(#tankBase))
Перевёрнутый дефлегматор в dist-режиме:
Использован transform="translate(-144, 364) rotate(180 200 98)" для поворота на 180° вокруг центра (200, 98) и сдвига влево-вниз
После transform: патрубки воды снизу (y=510), вход пара сверху (y=410)
Змеевик и анимация .coilflow сохраняются (работают в обоих режимах через document.querySelectorAll('.coilflow'))
П-образная труба из нержавейки 2":
Внешний контур: stroke="url(#pipeSteel)" шириной 18px с радиусами 14px на изгибах
Внутренний блик: stroke="#e8eef2" шириной 3px, opacity 0.55
Тёмная тень: stroke="#1a2028" шириной 2px, смещение (3, 3)
Феррул 2" три-кламп на стыке с баком
Путь: M248 502 L248 394 Q248 380 234 380 L70 380 Q56 380 56 394 L56 410
Также определён как <path id="pipePath"> в <defs> для использования в <animateMotion>
Анимация пара по П-трубе:
8 частиц (круги с url(#vaporg))
Каждая использует <animateMotion> с path=pipePath для движения по пути бак→дефлегматор
Дополнительная пульсация opacity через <animate> (0→0.9→0.9→0)
Случайные длительности (2.4-3.6s) и задержки для естественного движения
Логика переключения режимов в updateApparatusSVG():
Определение displayProcess: если currentData.process = 1 или 2 — его; иначе lastActiveProcess из localStorage
Запоминание: localStorage.setItem('lastActiveProcess', ...) при активном процессе
По умолчанию (если ничего не запомнено) — ректификация (process=2)
Переключение display стиля групп apparatusRect и apparatusDist
Анимация потока воды (главное требование!):
document.querySelectorAll('.coilflow').forEach(c => { c.style.animationPlayState = waterOn ? 'running' : 'paused'; c.style.opacity = waterOn ? '1' : '0.35'; })
Работает для всех 16 элементов .coilflow (8 в rect + 8 в dist, но видимы только в активной группе)
Когда waterValveOpen === false: анимация на паузе, прозрачность 0.35
Когда waterValveOpen === true: анимация работает, полная прозрачность
Бутыль в dist-режиме — слева под дефлегматором, через transform="translate(-232, 64)" от исходной позиции
3 капли продукта (.product-layer-dist) — видны когда heaterOn (конденсат капает при нагреве)
Уменьшены отступы панели: padding: 14px 14px 8px → padding: 6px 6px 4px для большего пространства под SVG
CSS-анимация для pipe-vapor (через offset-path) добавлена, но фактически используется <animateMotion> как более надёжный кросс-браузерный вариант
Почему так решили
Дублирование бака в обеих группах вместо <use> — потому что <use> с градиентами и class-селекторами для анимации работает нестабильно в некоторых браузерах. Дублирование надёжнее.
<animateMotion> для пара в П-трубе вместо CSS offset-path — animateMotion поддерживается всеми браузерами с SVG, включая старые. CSS offset-path может не работать в некоторых рендерах.
localStorage для lastActiveProcess — простое решение, переживает перезагрузку страницы. Если localStorage недоступен (приватный режим) — fallback на ректификацию.
displayProcess логика — если процесс активен (1 или 2), показываем его и запоминаем. Если IDLE (0) — показываем последний запомненный. Это даёт пользователю возможность видеть, чем он занимался последний раз.
Капли продукта в дистилляции зависят от heaterOn — в дистилляции нет клапана отбора, конденсат капает самотёком пока идёт нагрев. Когда нагрев выключен — капли скрыты.
Ключевые детали
16 элементов .coilflow: 8 в rect-группе (6 дуг змеевика + 2 патрубка) + 8 в dist-группе (те же 6+2, но перевёрнутые). Все управляются единым querySelectorAll('.coilflow').
8 частиц пара в П-трубе: каждая с собственной <animateMotion> и <animate>. При heaterOn=false частицы скрываются через display:none.
3 капли продукта в каждой группе: координаты разные (rect: 288,232; dist: 56,530), но логика отображения разная (rect: valveOpen; dist: heaterOn).
Бак Domspirt нарисован на основе детального описания с domspirt.ru: домообразная крышка, 2 три-клампа с красными болтами, клапан безопасности, 2 U-образные ручки с чёрными грипами, цифровой термометр с синим экраном, сливной кран с синей ручкой.
Изменённые файлы
download/index_landscape_knob.html — заменён весь SVG-блок, добавлены новые градиенты (tankBody, tankLid, tankBase, pipeSteel), обновлён initApparatusSVG() (генерация частиц в обеих группах + animateMotion для П-трубы), обновлён updateApparatusSVG() (переключение режимов + localStorage), уменьшен padding панели
download/CHANGELOG.md — этот файл (дополнение)
Что НЕ менялось (контрольный список)
❌ Все JS-функции, API, ID элементов (кроме добавления новых: apparatusRect, apparatusDist, pipePath, bottleClipDist)
❌ Логика синхронизации currentData
❌ Страницы, диалоги, навигация
❌ CSS-переменные и стили (только padding панели + новые keyframes для pipe-vapor)
❌ TSAR bar, барометр, темп-панель
❌ Все остальные анимации (vapor, drip, bubble, product, heatglow, glass-shine)
Проверка
✅ HTML валиден (парные теги <style> 1/1, <script> 3/3)
✅ Все ключевые ID на месте: apparatusRect, apparatusDist, apparatusSvg, valveMark, valveBody, pipePath
✅ Все классы на месте: plates-layer (4), vapor-layer (3), reflux-layer (2), product-layer (3), product-layer-dist (2), pipe-vapor-layer (2), coilflow (32), tank-domspirt (4), heatglow (4)
✅ Функции initApparatusSVG и updateApparatusSVG определены
✅ localStorage для lastActiveProcess работает
✅ animateMotion используется для пара в П-трубе
✅ Браузер-тест: страница загружается без JS-ошибок
✅ Режим ректификации: apparatusRect видим, apparatusDist скрыт, 16 coilflow анимаций работают, 56 эллипсов тарелок, 16 частиц пара
✅ Режим дистилляции: apparatusRect скрыт, apparatusDist видим, 8 частиц пара в П-трубе видимы
✅ При waterValveOpen=false: все 16 coilflow анимаций на паузе (главное требование выполнено!)
✅ Визуальная проверка скриншотов: оба режима рендерятся корректно, бак Domspirt узнаваем, П-труба из нержавейки видна
[2026-07-14 16:00] — Сессия 3

Задача
Изменить плашку «Контроль ЦАРГИ» — заменить вертикальный бар с ярким цветным градиентом на стилизованную стеклянную колбу термометра. Привести цвета и шрифты к общей стилистике glassmorphism. Текущее значение оставить в нижней части плашки.

Решение
Что было сделано
CSS: .tsar-bar-cur-val — увеличен размер с 22px → 28px для лучшей читаемости. Добавлен transition: color .4s для плавной смены цвета. Подпись «ТЕКУЩАЯ °C» — letter-spacing: 0.14em (было 0.12em), добавлен margin-top: 2px.
HTML: легенда — обновлены цвета квадратиков на палитру:
BASE: #22d3ee → #35e0d0 (cyan)
DELTA: #f59e0b → #ffb24d (amber)
HYST: #ef4444 → #e5484d (red)
JS: drawTsarBar() полностью переписана — теперь рисует стеклянную колбу термометра вместо вертикального бара:
Геометрия колбы:
Стеклянная трубка: 14px ширина, с закруглённым верхом (radius 7px)
Резервуар-шарик снизу: радиус 10.5px (1.5× трубки), как у лабораторного термометра
Path колбы построен через arcTo (закругления верха) + arc (резервуар) для единого контура
Угол дуги резервуара рассчитан через acos((tubeW/2)/bulbR) для плавного перехода трубка→резервуар
«Ртуть» внутри колбы:
Резервуар всегда полный, трубка заполняется до текущего значения
Однородный цвет по состоянию (как в настоящем термометре):
tsar < delta → reflux blue #8fd4ff (normal)
delta ≤ tsar < hyst → amber #ffb24d (warn)
tsar ≥ hyst → red #e5484d (danger)
Лёгкий горизонтальный градиент-блик (left→right) для эффекта жидкости: белый блик слева, тень справа
Заливка обрезается по форме колбы через ctx.clip()
Стекло:
Лёгкая тонировка rgba(255,255,255,0.04) (TELO) / rgba(255,255,255,0.015) (не TELO)
Обводка 1.2px: rgba(255,255,255,0.22) (TELO) / rgba(255,255,255,0.08) (не TELO)
Вертикальный блик 1.5px слева внутри трубки (rgba(255,255,255,0.18))
Пороги B/D/H слева от трубки:
Цветная риска 10px (1.8px ширина): B=cyan, D=amber, H=red
Буква (bold 10px system-ui) + значение (600 10px system-ui) слева от риски
Шрифт system-ui (был Consolas 7px — нечитаемо)
Шкала справа от трубки:
Только крупные деления 0.1°C (было 0.05°C мелкие + 0.1°C крупные — слишком шумно)
Риска 6px (0.8px ширина): rgba(255,255,255,0.22) (TELO) / rgba(255,255,255,0.08) (не TELO)
Подпись 9px system-ui, цвет --ink-3 (#6b7688)
Стрелка текущего значения:
Пунктирная линия через трубку (4-3 dash, 1.5px ширина, цвет --neon-green #7ff0cf)
Стрелка ▶ справа от трубки (bold 12px system-ui)
Saturation (приглушение когда не TELO):
Сохранена логика sat = isTelo ? 1.0 : 0.3 — все цвета кроме стекла приглушаются
Функция sc(hex) конвертирует цвет в grayscale с насыщенностью sat
Логика расчёта порогов полностью сохранена:
hasRef = rtsarM > 0.1 — есть ли эталонное значение
baseVal / deltaVal / hystVal — расчёт с учётом pressCorr (коррекция по давлению)
isTelo = hasRef && (stage === 'TELO' || stage === 'NASEBYA') — активна ли плашка
rangeMin/rangeMax — динамический диапазон ±0.5°C от порогов, округлённый до 0.1°C
Обновление tsar-bar-cur (cyan/warn/danger классы) — сохранено
Почему так решили
Однородный цвет ртути вместо градиента по высоте — изначально сделал градиент (reflux blue снизу → amber в зоне delta → red в зоне hyst), но при заливке до текущего значения основная масса ртути оставалась в синей зоне, и VLM-проверка показала, что в режимах WARN/DANGER цвет не отличим от NORMAL. Однородный цвет по состоянию — нагляднее и соответствует логике классического термометра.
Только 0.1°C деления шкалы — 0.05°C деления создавали визуальный шум, особенно при мелком шрифте. 0.1°C достаточно для контроля температуры царги (диапазон ±0.5°C).
system-ui вместо Consolas — приведение к общей стилистике (весь интерфейс на system-ui после Сессии 1).
Цвета из палитры — раньше использовались «стандартные» tailwind-цвета (#22d3ee, #f59e0b, #ef4444), сейчас — из CSS-переменных проекта.
Ключевые детали
Размер canvas: адаптивный, wrap.clientWidth × wrap.clientHeight, с поддержкой DPR ( retina-экраны)
Колба центрирована по горизонтали: tubeX = Math.round(cw/2)
Clip-path: используется ctx.save() + ctx.clip() для обрезки ртути по форме колбы, затем ctx.restore() для рисования стекла поверх
Path колбы построен один раз, используется дважды: для clip (ртуть) и для fill+stroke (стекло)
Резервуар всегда полный — это даёт визуальную опору (как у настоящего термометра), даже когда tsar=0 (тогда трубка пустая, резервуар полный)
Изменённые файлы
download/index_landscape_knob.html — CSS (.tsar-bar-cur-val 22→28px, transition), HTML (цвета легенды), JS (полная перерисовка drawTsarBar())
download/CHANGELOG.md — этот файл (дополнение)
Что НЕ менялось (контрольный список)
❌ ID элементов: tsarBarCanvas, tsar-bar-cur — сохранены
❌ Структура HTML: .tsar-bar-body, .tsar-bar-values, .tsar-bar-legend — сохранена
❌ JS-логика расчёта порогов (rtsarM, delta, hyst, pressCorr, isTelo) — полностью сохранена
❌ Логика обновления tsar-bar-cur (cyan/warn/danger классы) — сохранена
❌ Заголовок «Контроль ЦАРГИ» — остался --neon-green (цветной, как у других панелей)
❌ Все остальные плашки (Температуры, Атмосфера, Система) — не тронуты
❌ SVG-аппарат (apparatusRect/apparatusDist) — не тронут
❌ Все JS-функции, API, диалоги, навигация — не тронуты
Проверка
✅ HTML валиден, нет JS-ошибок при загрузке
✅ Canvas корректно рендерится во всех 4 состояниях:
IDLE (tsar=78.15, не TELO) — приглушённые цвета, ртуть синяя
NORMAL (TELO, tsar=78.10 < delta) — насыщенная ртуть reflux blue
WARN (TELO, tsar=78.20 между delta и hyst) — насыщенная ртуть amber
DANGER (TELO, tsar=78.30 > hyst) — насыщенная ртуть red
✅ VLM-верификация подтвердила корректные цвета ртути во всех 3 активных состояниях
✅ Структура колбы (трубка + резервуар-шарик) узнаваема
✅ Пороги B/D/H слева с буквами и значениями читаемы (10px system-ui)
✅ Шкала 0.1°C справа чистая, без шума
✅ Стрелка ▶ и пунктирная линия отображаются
✅ Текущее значение 28px под колбой меняет цвет (cyan/amber/red)
[2026-07-14 17:00] — Сессия 4

Задача
Доработки плашки «Контроль ЦАРГИ» и SVG-аппарата по результатам визуального тестирования:

Пороги B/D/H: буква + значение в одну строку (было в две)
Стрелка текущего значения: развернуть на 180° (▶ → ◀) и сместить правее, чтобы не залезала на шкалу
Стекло колбы: голубые линии вместо серых (больше похоже на стекло)
Колба: сделать чуть шире
Колба: не масштабировалась при изменении размера окна — починить
Решение
Что было сделано
Пороги B/D/H в одну строку — переписана функция drawThreshold():
Значение (600 weight 10px) выравнивается по правому краю, ближе к риске
Буква (bold 10px) левее значения с зазором 4px
Ширина значения измеряется через ctx.measureText() для точного позиционирования
Стрелка ◀ — изменена с ▶ (right-pointing) на ◀ (left-pointing):
Позиция: Math.min(cw - 10, tubeRight + 42) — справа от шкалы с защитой от выхода за край canvas
Выравнивание: textAlign='center', textBaseline='middle'
Размер: bold 13px system-ui
Голубое стекло колбы:
Тонировка: rgba(143,212,255,0.06) (TELO) / rgba(143,212,255,0.02) (не TELO) — было rgba(255,255,255,0.04)
Обводка: rgba(143,212,255,0.55) (TELO) / rgba(143,212,255,0.22) (не TELO) — было rgba(255,255,255,0.22)
Блик: rgba(255,255,255,0.22) шириной 1.8px — было 0.18 opacity, 1.5px
Адаптивная ширина колбы:
tubeW = Math.max(18, Math.min(34, Math.round(cw * 0.14))) — была фиксированная 14px
При 1600px viewport: ~30px, при 1100px: ~25px
Resize-listener для немедленной перерисовки:
window.addEventListener('resize', ...) с debounce 80мс
Сбрасывает кэш _tsarBarW=0; _tsarBarH=0;
Вызывает drawTsarBar() сразу (без ожидания следующего syncData через 1с)
Убрана избыточная проверка currentData.stage !== undefined (блокировала перерисовку без ESP32)
Изменённые файлы
download/index_landscape_knob.html — CSS (голубое стекло), JS (drawThreshold(), стрелка ◀, адаптивная tubeW, resize-listener)
Проверка
✅ Пороги B/D/H в одну строку: «B 78.00», «D 78.13», «H 78.25»
✅ Стрелка ◀ справа от шкалы, не залезает на подписи
✅ Стекло голубое, похоже на настоящее
✅ Колба шире (18-34px адаптивно)
✅ Масштабирование при resize работает (1600px → 317px canvas, 1100px → 211px canvas)
[2026-07-14 18:00] — Сессия 5

Задача
Перерисовать царгу (стеклянная колонна) по образцу Domspirt:

Стекло царги — голубое тонированное (как колба термометра)
Тарелки — убрать перемычки (downcomer tubes), оставить только диски с bubble caps
Стекло термометра в КОНТРОЛЬ ЦАРГИ — сделать таким же голубым
Создать отдельный файл для просмотра SVG при запущенной дистилляции
Решение
Что было сделано
Стекло царги (landscape, apparatusRect):
Обводка: rgba(143,212,255,0.55) — было #3a5674 (серо-синяя)
Голубая тонировка поверх стекла: rgba(143,212,255,0.04)
Правый блик: rgba(143,212,255,0.18) — было rgba(255,255,255,0.07)
Вертикальный блик (glass-shine анимация) — сохранён
Тарелки без перемычек — изменена функция генерации в initApparatusSVG():
Удалён downcomer tube (вертикальные медные трубки между тарелками)
Осталось: диск (ellipse) + 3D-тень + блик + 3 bubble caps
7 тарелок (как было)
Стекло термометра КОНТРОЛЬ ЦАРГИ — уже было голубым после Сессии 4, стиль единый со стеклом царги
Файл distillation_preview.html — отдельный HTML с встроенной симуляцией:
Кнопки переключения режимов: Ректификация / Дистилляция / IDLE
Кнопки Вода ВКЛ/ВЫКЛ, Нагрев ВКЛ/ВЫКЛ
Живые данные каждые 500мс (температуры с колебаниями, давление, влажность)
4 колонки: Температуры | SVG-аппарат | TSAR-термометр | Барометр+Система
Не требует ESP32, не делает fetch-запросов
Сначала был через iframe, но из-за cross-origin ограничений file:// переписан как единый HTML
Изменённые файлы
download/index_landscape_knob.html — стекло царги (голубая обводка + тонировка + блик), тарелки без перемычек
download/distillation_preview.html — новый файл для локального тестирования SVG
Проверка
✅ Стекло царги голубое, визуально похоже на Domspirt
✅ Тарелки без перемычек (только диски с bubble caps)
✅ distillation_preview.html работает: переключение режимов, вода/нагрев ВКЛ/ВЫКЛ, живые данные
✅ VLM-верификация: оба режима рендерятся корректно, бак Domspirt узнаваем, П-труба видна
[2026-07-14 19:00] — Сессия 6

Задача
Переделать портретный режим (index_portrait.html) под новый glassmorphism-стиль:

CSS-палитра + фон + шрифт (как в landscape)
Рестайлинг компонентов (panels, nav, dialogs, badges, barometer)
Убрать gauge canvas (диаграмму) — просто удалить, без замены на SVG
Сохранить весь функционал управления
Решение
Что было сделано
CSS-палитра — переведена на glassmorphism:
Фон #05070d + aurora-блобы (teal + indigo)
Glass-карточки rgba(255,255,255,0.045) + backdrop-filter: blur(16px)
Палитра: cyan #35e0d0, amber #ffb24d, red #e5484d, green #7ff0cf, reflux #8fd4ff, violet #9085e9
Шрифт system-ui (был Consolas)
Pill-бейджи (radius 999px), скругления 18-22px
Все Tailwind-override классы (bg-gray-800, text-blue-400 и т.д.) перекрашены в новую палитру
Диаграмма удалена:
<canvas id="gaugeCanvas"> удалён из HTML
chart.umd.js отключён
drawGauge() и animateGaugeEntry() оставлены как no-op функции (чтобы не сломать вызовы)
updateBarometer() восстановлена (случайно удалённая вместе с gauge-блоком)
Рестайлинг компонентов:
Header, top control bar, glass-card — glass-стиль
Барометр — mercury gradient #1baf7a → cyan → cyan-soft с голубым glow
Диалоговые панели — glass + amber-бордер, blur(16px)
Bool-toggle — pill-shaped
Setting-inputs кнопки ± — radius 6px, cyan с hover
BME-badge, net-mode-badge — pill-style
Status-icon-box — glass с blur
Исправление светлого фона — изначально правило .bg-gray-900 { background-color: transparent !important; } убирало тёмный фон, который Tailwind применял к <body class="bg-gray-900">. Исправлено: убрано переопределение .bg-gray-900, добавлены background-color + background-image + background-size для body.
Изменённые файлы
download/index_portrait.html — полный рестайлинг + удаление диаграммы
Что НЕ менялось
❌ Все JS-функции (syncData, sendCommand, saveSettings, adjCfg, toggleCfg, showPage, updateUI, updateCalculationsBlock, checkModals и др. — 16 ключевых функций идентичны оригиналу)
❌ Все 29 onclick-обработчиков
❌ Все 8 API-эндпоинтов
❌ Все 6 страниц (main, monitoring, distillation, rectification, sensors, settings)
❌ Все 6 диалоговых панелей
❌ Все 11 стадий процесса
❌ Все 12 команд ESP32
❌ Все 20 конфиг-параметров
Проверка
✅ Фон тёмный (near-black #05070d) на всех 5 страницах
✅ Glass-панели с blur видны
✅ Цвета cyan, amber, red, green отображаются
✅ Диаграмма удалена, на её месте время + «ЭТАП»
✅ Нет сломанных элементов
[2026-07-14 20:00] — Сессия 7

Задача
Доработка портретного режима:

Шрифты маленькие, нечитаемые — увеличить как в landscape
Блок температур маленький — увеличить; время и этап перенести в статус-строку (как в landscape)
Статус-строка: ← | время+этап | НОРМА+счётчик
Решение
Что было сделано
Увеличены шрифты (как в landscape):
Температуры: 22px, weight 660, tabular-nums, letter-spacing: -0.02em (было ~14-16px)
Подписи температур: 11px (было 9px)
Заголовок страницы: 15px (было 13px)
Значения в верхней панели: 14px + tabular-nums
Стадия/процесс/статус: 12-13px (было 11px)
Время: 22px, weight 670 (было 20px)
Заголовки секций h3: 11px, weight 600 (было 10px)
Кнопки: 12px, weight 600
Setting-row label: 11px, span: 14px (было 12-13.6px)
Bool-toggle: 11px + увеличенный padding
Статус-строка (как в landscape):
Слева: кнопка «←» (Unicode-символ вместо Lucide-иконки — работает без lucide.js)
Центр: время 22px + этап + процесс-бейдж (pill)
Справа: статус «НОРМА» (pill) + счётчик
Заменила отдельный «Header Row» + центральный блок времени/этапа
Блок температур увеличен:
4 крупные строки по 22px (было 4 мелких блока по 14-16px)
Каждая температура в своей карточке с цветным акцентом
Барометр справа от температур (вертикальный)
Адаптивный статус-бар с flex-wrap (Вариант A):
flex-wrap на контейнере — элементы переносятся на новую строку при нехватке места
margin-left: auto + justify-content: flex-end на правом кластере — при переносе на новую строку он прижимается вправо
white-space: nowrap на pill-бейджах — они не ломаются внутри
Unicode ← вместо Lucide-иконки — работает без lucide.js
Изменённые файлы
download/index_portrait.html — CSS (увеличенные шрифты), HTML (статус-строка + крупный блок температур)
Проверка
✅ Шрифты читаемые (22px температур, 11-15px остальных)
✅ Статус-строка с временем/этапом/НОРМА вверху
✅ 4 крупные температуры + барометр
✅ Расчёты видны без скроллинга
✅ Адаптивный статус-бар: на 320px переносится на 2 строки, НОРМА справа на 2-й строке
✅ Проверено на 3 ширинах: 320px, 420px, 768px
Файлы в /home/z/my-project/download/
index_landscape_knob.html — landscape-интерфейс (рестайлинг + SVG-аппарат)
index_portrait.html — портретный интерфейс (рестайлинг + удаление диаграммы)
distillation_preview.html — файл для локального тестирования SVG
CHANGELOG.md — этот файл
reference_screenshots/ — скриншоты референса rect.marz-ban.ru
tank_reference/ — скриншоты и анализ бака Domspirt## 2026-07-09 — Фич: двухточечная калибровка клапанов (BODY NC)

**Задача**
Для клапанов BODY NC (нормально закрытые) один замер capacity недостаточен — импульсный режим при разных duty cycle (скорость голов vs скорость тела) даёт разную эффективную пропускную способность. Нужны два отдельных замера для точного расчёта.

**Изменения в логике калибровки:**

Для BODY NC — **4 шага** вместо 3:
1. Пролив системы (10 сек, 100% open) — общий для всех клапанов
2. **Capacity на скорости голов** (60 сек, импульсный режим с duty cycle для голов)
3. **Capacity на скорости тела** (60 сек, импульсный режим с duty cycle для тела)
4. Ввод двух объёмов → расчёт и сохранение двух значений capacity

Для HEADS — 3 шага (пролив → импульс на скорости голов 50 мл/ч → ввод объёма).
Для BODY NO — 3 шага (пролив → 100% open 60 сек → ввод объёма).

**Принцип работы:**
- Для импульсного теста используется текущий capacity как оценка для расчёта duty cycle.
- Обратный расчёт: `capacity_true = V × 60 / (dutyCycle × T)` — бэкенд знает точный duty cycle теста.
- BODY NC хранит два значения: `valve_body_capacity_heads` (BCH) и `valve_body_capacity` (тело).
- При работе процесса (головы) BODY NC использует `valve_body_capacity_heads` для расчёта импульсных таймингов.

**Изменённые файлы:**
- `ValveCalMenu.h`: полный рерайт — двухточечный wizard, `startCyclingForTest()`, `backCalculateCapacity()`, `saveCapacity()`, Web-методы
- `ProcessCommon.h`: новые команды `CALIB_START_CAP_HEADS`, `CALIB_START_CAP_BODY`, `CALIB_SET_VOLUME`; поле `capacityHeads` в `CalibWizard`
- `preferences.h/cpp`: поле `valve_body_capacity_heads` (BCH) с EEPROM-адресом
- `ProcessEngine.cpp`: обработчики новых команд, передача объёма в `setVolumeFromWeb()`
- `AppNetwork.cpp`: парсинг новых команд, `capacityHeads`/`headsTestVolume` в JSON статуса, `valve_body_capacity_heads` в конфиге
- `AppNetwork.h`: декларация новых методов

---

## 2026-07-09 — Фич: Web UI — двухточечная калибровка клапанов

**Задача**
Обновить Web-интерфейс (index.html + index_landscape_knob.html) для нового 4-шагового flow калибровки BODY NC.

**Изменения в UI:**

- BODY NC wizard: 5 экранов (dry run → cap heads → cap body → input 1 → input 2 → result)
- HEADS/BODY NO wizard: 3 экрана (без изменений логики)
- Новый экран результата для BODY NC: отображает два значения capacity (головы / тело)
- Настройки BODY NC: показаны два поля capacity — «головы» и «тело»
- Статус калибровки BODY NC: показывает оба значения, например `✓ 120 мл/мин (H:45)`
- Команды: `CALIB_START_CAP_HEADS`, `CALIB_START_CAP_BODY` вместо единого `CALIB_START_CAP`
- Маппинг шагов бэкенда (0-7) на UI-элементы через `stepToElId`
- Обратная совместимость: HEADS и BODY NO работают как раньше

**Изменённые файлы:**
- `index.html`: wizard panel — новые шаги 2a/2b/3b, dual result, обновлённый JS
- `index_landscape_knob.html`: аналогичные изменения с inline-стилями

---

## 2026-07-09 — Фикс: зависание Web-интерфейса (Причина №5 — handleListProfiles безлимитное чтение)

**Задача**
Продолжение исправления периодических зависаний Web-интерфейса. Причина №5: `handleListProfiles()` перебирает все файлы в `/profiles/`, для каждого читает содержимое целиком посимвольно через `content += (char)file.read()`. Нет лимита количества файлов и размера читаемого файла.

**Проблемы:**
1. Посимвольное `String::+=` — тысячи реаллокаций кучи (антифрагментация), заметная пауза при 10+ профилях.
2. Нет лимита файлов — при «мусорной» директории (сотни файлов) функция крутится секунды, блокируя WebServer.
3. Каждый файл читается целиком (бывает 5-10 КБ), хотя нужно только поле `"name"` из начала файла.

**Решение** (3 изменения):

1. **Лимит 50 профилей** — цикл останавливается после 50 `.json` файлов. Остальные пропускаются.
2. **Лимит 2 КБ на файл** — читается только начало файла (имя профиля всегда в начале). Если `"name"` не найдено в первых 2 КБ — используется fallback (имя файла без `.json`).
3. **Буферное чтение по 256 байт** — вместо `content += (char)file.read()` используется `file.read(buf, 256)` + `content.concat(buf, bytesRead)`. Сокращает реаллокации String с тысяч до единиц. `content.reserve(2048)` — единственная аллокация.
4. **Проверка `lock.locked`** — если sdMutex недоступен (500мс таймаут из фикса №4), возвращается 503 вместо работы без мьютекса.
5. **`profilesDir.close()`** — директория явно закрывается после обхода (раньше не закрывалась).

**Изменённые файлы**:
- `AppNetwork.cpp`: `handleListProfiles()` — лимиты, буферное чтение, проверка мьютекса, close директории

---

## 2026-07-09 — Фикс: зависание Web-интерфейса (Причина №4 — sdMutex блокирует до 5 сек)

**Задача**
Продолжение исправления периодических зависаний Web-интерфейса. Причина №4: обработчик главной страницы `/` и `SDScopeLock` (логгер) используют `sdMutex` с таймаутом 5000мс. Если Core 1 держит мьютекс (пишет лог) — Core 0 (WebServer) ждёт до 5 секунд. И наоборот.

**Решение** (2 изменения):

1. **Убран sdMutex из обработчика `/`** — чтение `index.html` не требует мьютекса: `serveStatic()` на строке ниже тоже читает файлы с SD без мьютекса и работает стабильно. ESP32 SD библиотека thread-safe для чтения. Мьютекс нужен только для записи (логгер).

2. **Таймаут SDScopeLock уменьшен с 5000мс до 500мс** — `SDScopeLock` теперь возвращает флаг `locked` (успех/неудача захвата). `logger.log()` пропускает запись если мьютекс недоступен (выводит в Serial вместо SD). `readLastLog()` возвращает `"Log unavailable (SD busy)"` если мьютекс недоступен.

**Изменённые файлы**:
- `AppNetwork.cpp`: обработчик `/` — убраны `xSemaphoreTake/Give(sdMutex)`
- `SDLogger.h`: `SDScopeLock` — таймаут 5000→500мс, добавлен флаг `locked`; `log()` — пропуск записи при занятом мьютексе; `readLastLog()` — возврат ошибки при занятом мьютексе

---

## 2026-07-09 — Фикс: зависание Web-интерфейса (Причина №3 — syncNTP блокирует до 2 сек)

**Задача**
Продолжение исправления периодических зависаний Web-интерфейса. Причина №3: `syncNTP()` вызывает `getLocalTime()` с таймаутом 2000мс. Вызывается из `update()` при восстановлении интернета (`!online → online`) — блокирует WebServer до 2 секунд.

**Решение** (1 изменение):

Таймаут `getLocalTime()` уменьшен с 2000мс до **500мс**. `configTime()` уже запускает фоновый SNTP-клиент ESP32, который продолжает синхронизацию автоматически (каждый час). `getLocalTime()` — лишь проверка, что первая синхронизация прошла. Если NTP не ответил за 500мс — фоновый SNTP догонит сам.

**Изменённые файлы**:
- `AppNetwork.cpp`: `syncNTP()` — таймаут `getLocalTime()` 2000 → 500 мс

---

## 2026-07-09 — Фикс: зависание Web-интерфейса (Причина №2 — connectToWiFi блокирует до 9 сек)

**Задача**
Продолжение исправления периодических зависаний Web-интерфейса. Причина №2: при потере WiFi в STA_MODE вызывался `connectToWiFi()`, который делает до 6 попыток (3 × SSID1 + 3 × SSID2), каждая до 1.5 сек. Итого — до **9 секунд единой блокировки** в потоке Core 0, где работает WebServer.

**Решение** (2 изменения):

1. **Пошаговый реконнект вместо единого блока** — вместо `connectToWiFi()` (до 9 сек) при потере WiFi теперь делается **1 попытка (~1.5 сек) за цикл `update()`**. Между попытками WebServer нормально обслуживает запросы. Новые методы: `startReconnect()`, `tryReconnectOnce()`, `resetReconnect()`.

2. **Защитная задержка 3 сек перед реконнектом** — при обнаружении потери WiFi система ждёт 3 секунды (через `millis()`, НЕ через `delay()`). Если WiFi «моргнул» и вернулся сам — реконнект не начинается вообще. Это устраняет зависания при кратковременных сбоях WiFi.

**Влияние на остальные модули**:
- Оригинальный `connectToWiFi()` сохранён и используется только в `beginNetwork()` для начального подключения при старте (там блокировка допустима — `systemReady = false`).
- Логика перехода STA→AP→OFFLINE сохранена полностью.
- Скорость восстановления WiFi при реальном обрыве: вместо мгновенных 9 сек — несколько циклов `update()` (каждые 30 сек), но Web-интерфейс **не зависает**.

**Изменённые файлы**:
- `AppNetwork.h`: добавлены переменные `reconnectAttempt`, `reconnectSSID`, `reconnecting`, `wifiLostTime`; добавлены методы `startReconnect()`, `tryReconnectOnce()`, `resetReconnect()`
- `AppNetwork.cpp`: блок реконнекта в `update()` переписан на пошаговый; добавлены 3 новых метода; `connectToWiFi()` помечен как «только для beginNetwork()»

---

## 2026-07-09 — Фикс: зависание Web-интерфейса (Причина №1 — checkInternet блокирует WebServer)

**Задача**
Web-интерфейс периодически подвисает (даже при локальном IP). Зависания начались после изменений от 2026-05-31 (фиксы AP→STA перехода, Kernel Panic, CloudManager стек).

**Анализ корневой причины**
`checkInternet()` вызывается из `update()`, который выполняется в `networkTaskWrapper` на Core 0 — единственной FreeRTOS задаче, вызывающей `server->handleClient()`. Блокировка внутри `checkInternet()` = WebServer не обслуживает запросы.

Две конкретные точки блокировки:
1. **AP→STA переход** (строка 418): при обнаружении фонового подключения WiFi сразу вызывались `checkInternet()` (до 3 сек) + `syncNTP()` (до 2 сек) = **до 5 сек блокировки** в момент перехода.
2. **Периодическая проверка** (строка 974): `checkInternet()` делал 3 попытки × 1 сек таймаут = **до 3 сек** каждые 10-30 сек.

**Решение** (2 изменения, только `AppNetwork.cpp`):

1. **`checkInternet()` — 1 попытка вместо 3** — максимальная блокировка ~1 сек вместо 3 сек. Точность проверки не критична (влияет только на флаг `online` для NTP/облака), повторная проверка через 10-30 сек компенсирует ложное отрицание.

2. **AP→STA переход — отложить checkInternet/syncNTP** — переход AP→STA теперь мгновенный (смена `networkMode`, установка флага `switchedToSTA`). `checkInternet()` и `syncNTP()` выполнятся автоматически в следующем цикле `update()` при попадании в блок `STA_MODE` (строка 446), где они и так вызываются периодически.

**Изменённые файлы**:
- `AppNetwork.cpp`: `checkInternet()` — убран цикл из 3 попыток; блок AP→STA — убраны вызовы `checkInternet()` и `syncNTP()`

---

## 2026-06-30 — Сессия N+2 (открытая проблема)
### Завышение реальной скорости отбора относительно расчётной после калибровки клапанов

**Задача**:
Зафиксировать проблему — текущий механизм калибровки клапанов даёт значение `capacity` (мл/мин), при котором **реальная скорость отбора в импульсном режиме получается выше расчётной**. Система рассчитывает `openMs`/`closeMs` исходя из заниженной эффективной пропускной способности, фактический отбор идёт быстрее целевого.

**Контекст**:
- Калибровка клапанов запускается автоматически после завершения этапа NASEBYA (см. `ProcessEngine.cpp:931-940` — `if (cfg.calibration) changeStage(Stage::VALVE_CAL)`), то есть при горячей системе и установившемся паровом режиме. Гипотеза о «холодной калибровке» отброшена.
- Текущий алгоритм (`ValveCalMenu.h`): клапан открывается **непрерывно на 60 сек**, пользователь вводит объём в мензурку, `capacity = объём / 1 мин`.
- В реальной работе клапан работает в **импульсном режиме** (openMs/closeMs из `calcValveTiming`, `ProcessEngine.cpp:981`).

**Практические данные**:
- Калиброванное `valve_body_capacity = 120 мл/мин` (7200 мл/ч при 100% открытии).
- Целевая скорость при 2.7 кВт / 600 мл/ч/кВт = 1620 мл/ч.
- Расчётный dutyCycle = 1620 / 7200 = 22.5%.
- По субъективной оценке оператора — реальный отбор **быстрее** целевого. Точный замер мерным стаканом за 1 минуту пока не выполнен.

**Гипотеза причины**:
При непрерывном открытии (калибровка) поток в отборной трубке установившийся, гидростатический напор на клапан минимальный, пропускная способность стационарная.
При импульсной работе (реальный отбор) между импульсами в отборной трубке **накапливается столб жидкости**, который при открытии создаёт дополнительный гидростатический напор → мгновенный расход выше стационарного → средняя скорость отбора выше расчётной.
Чем меньше dutyCycle (медленнее отбор), тем больше накопление и тем сильнее эффект.

**Дополнительные факторы** (менее значимые):
- Инерция столба жидкости в трубке (движущаяся жидкость ускоряется легче, чем старт с нуля при калибровке).
- Разница плотности дистиллята при разной температуре (импульсный режим → теплее → ниже плотность → больше объём при той же массе).
- Избыточное давление паров в дефлегматоре между импульсами → всплеск при открытии.

**Рассмотренные варианты решения** (выбор отложен до получения реальных замеров):

1. **Вариант F — импульсная калибровка**: калибровать клапан не непрерывным открытием, а типичными импульсами openMs/closeMs, которые используются в реальной работе. Накопление столба жидкости учтётся автоматически.
   - Плюсы: точная модель, не требует доп. параметров.
   - Минусы: нужно менять UI мастера калибровки, зависимость от `minOpenTime`.

2. **Вариант C — поправочный коэффициент `dutyFactor > 1`**: ввести множитель в `calcValveTiming`:
   ```cpp
   float effectiveCapacity = capacity * dutyFactor;
   float dutyCycle = targetSpeed / (effectiveCapacity * 60.0f);
   ```
   Подобрать за одну пробную перегонку.
   - Плюсы: минимальные изменения кода, низкий риск.
   - Минусы: требует подбора, может отличаться для голов/тела.

3. **Вариант G — мульти-дьюти калибровка**: калибровать на 3 разных dutyCycle (10%, 30%, 60%), интерполировать. Отброшен — слишком сложно, ломает структуру `SystemConfig` и UI.

**Что нужно сделать до выбора решения**:
- ✅ Выполнить **реальный замер мерным стаканом за 1 минуту** при стабильной работе в импульсном режиме тела (мощность 2.7 кВт, целевая 1620 мл/ч).
- По результату рассчитать `dutyFactor = реальная_скорость / 1620`.
- Оценить величину эффекта (ожидаемый диапазон 1.2–1.5).
- После получения цифр — вернуться к обсуждению и выбрать между F и C.

**Изменённые файлы**:
- `CHANGELOG.md`: добавлена эта запись (без изменений в коде — проблема зафиксирована для будущей сессии).

**Статус**: 🟡 ОТКРЫТО. Ожидает реальных замеров от пользователя.

---
## 2026-06-11 — Аналитика: архитектура управления мощностью для BuhloWar v3.0

### Исследование замены РМ2М на программное управление мощностью ТЭНа

**Задача**: определить архитектуру управления мощностью для BuhloWar v3.0 — замена ручного регулятора РМ2М (фиксированные, устанавливаемые оператором значения) на систему программного управления, позволяющую ESP32-S3 полностью управлять подаваемой мощностью.

**Контекст**:
В BuhloWar v2.0 оператор вручную устанавливает мощность на РМ2М. Система «видит» температуру через DS18B20, но не может влиять на нагрев. Для v3.0 требуется замкнутый контур: температура → алгоритм → мощность → ТЭН → температура.

**Исходные данные**:
- ТЭН до 40А при 220В (до 8.8 кВт)
- ESP32-S3 DevKitC-1 (N16R8), двухъядерный: Core 0 (сеть), Core 1 (логика)
- Робочий процесс: ректификация — мощность постоянная на всём этапе отбора (головы и тело отбираются при одной мощности)
- Рассмотренный товар: RobotDyn AC Dimmer 40A + плата DIMMERLINK (UART/I2C), AliExpress, производитель rbdimmer.com

**Ключевое исправление понимания процесса ректификации**:
Первоначально была предложена модель с переменной мощностью по этапам (головы 5-15%, тело 25-40%, хвосты 40-60%). Это **ошибочно**. При ректификации мощность поддерживается **постоянной** на протяжении всего процесса отбора. Разделение фракций происходит за счёт изменения скорости/объёма отбора (кран), а не за счёт изменения мощности. Мощность меняется только дважды: разогрев → рабочая мощность.

**Рассмотренные варианты управления мощностью**:

1. **RobotDyn AC Dimmer 40A + DIMMERLINK (UART/I2C)** — фазоимпульсный регулятор:
   - Детектор перехода через ноль (zero-cross) + фазоимпульсное управление симистором (BTA41 или аналог)
   - DIMMERLINK — коммуникационная плата с собственным MCU, снимает с ESP32 задачу точного тайминга
   - Интерфейсы: UART или I2C, команда «установить мощность X%»
   - Каскадирование до ~16 диммеров на одну шину DIMMERLINK
   - Изучена библиотека RBDDimmer (GitHub: RobotDynOfficial/RBDDimmer, 280 stars):
     - Прямое GPIO-управление: 2 пина (ZC input + DIM output)
     - ISR каждые 30 мкс (аппаратный Timer 0 ESP32), прерывание по RISING на ZC пине
     - Функции: `setPower(0-99%)`, `setState(ON/OFF)`, `NORMAL_MODE/TOGGLE_MODE`
     - Проблема для ESP32-S3: ISR каждые 30 мкс — серьёзная нагрузка, конфликт с WiFi на Core 0
   - DIMMERLOGINK решает эту проблему: выносит тайминг на отдельный MCU, ESP32 общается только по UART/I2C
   - Сайт производителя rbdimmer.com заблокирован Cloudflare, документация по протоколу DIMMERLOGINK недоступна

2. **SSR + время-импульсный метод (burst fire)** — включение на N полных периодов из M:
   - Твёрдотельное реле (SSR) с zero-cross — включение только при переходе через ноль
   - Нулевые электромагнитные помехи — полные синусоиды, не обрезанные
   - Минимальная нагрузка на ESP32 — 1 GPIO, никаких ISR и таймеров
   - Для ТЭНа с тепловой инерцией в минуты — разрешение более чем достаточное
   - Окно 2 сек при 50 Гц = 100 полупериодов → шаг 1%

3. **RobotDyn Dimmer + прямое GPIO (без DIMMERLOGINK)**:
   - ISR каждые 30 мкс на ESP32-S3 с WiFi + PSRAM — потенциальная нестабильность
   - Заняты Timer 0 + 2 GPIO — конфликты с другими библиотеками
   - Помехи от фазоимпульсного управления могут влиять на 1-Wire (DS18B20)
   - **Не рекомендуется** для ESP32-S3 с WiFi

**Ключевой вопрос: стабилизация мощности при нестабильном напряжении сети**:
- Burst fire **сам по себе** не стабилизирует мощность — управляет скважностью, но не амплитудой напряжения
- Фазоимпульсный диммер **тоже** не стабилизирует — только обрезает полуволну
- Для стабилизации нужен **замкнутый контур** с измерением реальной мощности, независимо от метода управления
- Датчик: **PZEM-004T v3.0** — измеряет V (80-260В), I (0-100А), P (0-22кВт), PF, частоту, энергию; UART (Modbus-RTU, 9600 бод); встроенная гальваническая развязка; обновление ~200 мс

**Сравнение подходов с обратной связью (PZEM-004T)**:

| Параметр | Burst fire + SSR + PZEM | RobotDyn + DIMMERLOGINK + PZEM |
|---|---|---|
| Скорость реакции | 2-5 сек (достаточно для ТЭНа) | 10-20 мс (избыточно для ТЭНа) |
| Помехи | Нулевые | Фазоимпульсные (влияние на 1-Wire) |
| Нагрузка на ESP32 | Минимальная (1 UART + 1 GPIO) | Минимальная (2 UART) |
| Стоимость | ~$30-45 (SSR + PZEM + реле) | ~$30-45 (Dimmer + DIMMERLOGINK + PZEM) |
| Дополнительные данные | V, I, P, PF, Freq, Energy | V, I, P, PF, Freq, Energy |
| Разрешение | 1% (окно 2 сек) | 1% (100 шагов на полуволну) |

**Принятое решение: Burst fire + SSR (zero-cross) + PZEM-004T v3.0**

Обоснование:
1. Мощность при ректификации — почти константа, плавная регулировка 0-100% нужна только для разогрева и подстройки рабочего значения
2. Нулевые помехи → DS18B20 работает стабильно, не нужны экранирование и ферриты
3. Минимальная нагрузка на ESP32 → нет ISR, нет конфликтов с WiFi и 1-Wire
4. PZEM-004T даёт «бесплатный» вольтметр/амперметр/ваттметр для оператора
5. Скорость реакции 2-5 сек более чем достаточна — инерция ТЭНа и куба на порядки больше
6. Проще, дешевле, надёжнее фазоимпульсного решения

**Архитектура подключения к ESP32-S3**:
- GPIO17/GPIO18 → UART1 (PZEM-004T v3.0, Modbus-RTU)
- GPIO5 → SSR Control (burst fire)
- GPIO6 → Emergency Relay (аварийное отключение ТЭН)
- GPIO3 → 1-Wire (DS18B20 x4) [существующий]
- GPIO8/GPIO9 → I2C (BME280) [существующий]

**Алгоритм стабилизации мощности**:
- П-регулятор с ограничением скорости изменения (не PID)
- Kp ≈ 0.15, max_step = 5% за цикл, период цикла 2 сек
- Причина отказа от PID: интегральная составляющая вызывает перерегулирование при инерционной системе, дифференциальная усиливает шум PZEM
- Чистый П-регулятор + ограничение скорости = стабильное плавное регулирование

**Режимы работы PowerManager**:
| Режим | Описание | Стабилизация |
|---|---|---|
| OFF | ТЭН выключен | Нет |
| RAMP_UP | Плавный разогрев 0→100% за N мин | Нет |
| FULL_POWER | Максимальная мощность (100%) | Нет |
| STABILIZE | Стабилизация мощности | Да (П-регулятор + PZEM) |
| MANUAL | Ручное задание мощности | Опционально |

**Безопасность**:
- Аппаратная: автомат 40А + УЗО 30мА + аварийное реле + биметаллический термостат на кубе (105°C)
- Программная: watchdog PZEM (3 таймаута → emergency OFF), P_max защита, T_куба мониторинг
- SSR безопасное состояние: GPIO LOW = ТЭН выключен (по умолчанию при перезагрузке)

**Интеграция в архитектуру BuhloWar**:
```
Core 0: AppNetwork + CloudManager (WiFi, web, cloud)
Core 1: ProcessEngine + SensorManager + PowerManager ← НОВЫЙ МОДУЛЬ
```

**Стоимость решения**:
| Компонент | Цена |
|---|---|
| SSR 60А zero-cross (Fotek) + радиатор | ~$8-12 |
| PZEM-004T v3.0 с CT 100А | ~$5-8 |
| Аварийное реле + транзистор | ~$2-3 |
| Автомат 40А + УЗО | ~$10-15 |
| Монтаж, клеммы, провода | ~$5 |
| **Итого** | **~$30-45** |

**Дополнительные данные от PZEM-004T для оператора**:
- Напряжение сети — видна причина «процесс не идёт»
- Power Factor — для ТЭНа должен быть ~1.0, если ниже — проблема
- Частота сети — стабильные 50 Гц = норма
- Накопленная энергия (кВт·ч) — расчёт стоимости процесса и КПД
- Ток — детекция аномалий (деградация ТЭНа, КЗ, утечка)

**Деградация при потере PZEM-004T**:
- Вариант 1: аварийное отключение (безопасно, но прерывает процесс)
- Вариант 2: деградация режима — переход на open-loop (фиксированный duty без стабилизации) с предупреждением оператору
- Для ректификации вариант 2 имеет смысл: мощность и так почти постоянная

**Ссылки**:
- AliExpress (рассмотренный товар): https://aliexpress.ru/item/1005006211999051.html?sku_id=12000056231193209
- Сайт производителя: https://rbdimmer.com (недоступен — Cloudflare)
- Библиотека RBDDimmer: https://github.com/RobotDynOfficial/RBDDimmer

---

## 2026-06-11 — Аналитика: сравнение датчиков температуры DS18B20 vs Pt100 + алгоритмы обнаружения шпоры

### Исследование применимости DS18B20 и Pt100 в системе BuhloWar v2.0

**Задача**: провести детальное сравнение текущих датчиков DS18B20 (4 шт., 1-Wire, GPIO3) и платиновых термометров сопротивления Pt100 для принятия решения о целесообразности замены.

**Контекст**:
Система BuhloWar v2.0 использует 4 датчика DS18B20 (TSA, AQUA, TSAR, TANK) на единой 1-Wire шине и BME280 для атмосферного давления. Ключевые температурные параметры: hysteresis = 0.24°C, delta (шпора) = 0.06°C (параметр), минимальное рабочее значение delta = 0.12°C.

**Результаты сравнения**:

1. **Точность**:
   - DS18B20: ±0.5°C во всём диапазоне
   - Pt100 кл. A: ±0.15°C при 0°C, ±0.35°C при 100°C (в 1.4-1.6x лучше в диапазоне 78-100°C)
   - Pt100 кл. B: ±0.30°C при 0°C, ±0.80°C при 100°C (существенно хуже кл. A при высоких T)

2. **Дистилляция**: DS18B20 полностью достаточен — пороги разделены интервалами 7-14°C, погрешность 0.5°C не влияет на управление процессом. Основная неопределённость от тепловой инерции системы (30-60 сек), а не от датчика.

3. **Ректификация**: Pt100 кл. A даёт преимущество в расчёте крепости (±0.3-0.7% об. вместо ±1-2% об. при погрешности DS18B20 0.5°C), но для обнаружения шпоры преимущество минимально (см. п.5).

4. **Стоимость замены**:
   - DS18B20 (4 шт.): ~420 руб.
   - Pt100 + 4x MAX31865: ~6200-8200 руб. (нужны 4 SPI-чипа, 16 GPIO)
   - Pt100 + ADS124S08: ~5400-7400 руб. (1 АЦП, 4 GPIO, но сложнее ПО)
   - Разница: 13-20x, плюс переработка PCB и 60-120 часов разработки ПО

5. **Ключевой инсайт — относительная vs абсолютная точность**:
   - Для управления процессом (шпора, гистерезис, пороги) важна **относительная** точность — способность обнаруживать *изменения* температуры, а не абсолютное значение
   - DS18B20 с разрешением 0.0625°C и краткосрочной стабильностью ±1 LSB надёжно отслеживает изменения
   - При delta = 0.12°C (минимальное реальное рабочее значение) пороговый метод уже работает надёжно — шум ±0.0625°C не может дать ложное срабатывание на 0.12°C

6. **Алгоритм обнаружения шпоры по производной**:
   - Рассмотрен метод: вместо «температура выше порога?» спрашивать «растёт ли температура?»
   - dT/dt при стабильной ректификации ≈ 0 (шум с нулевым средним)
   - dT/dt при шпоре > 0 (устойчивый рост)
   - Метод эффективен при delta = 0.06°C (1 LSB), где шум даёт ложные срабатывания порогового метода
   - **При delta = 0.12°C (2 LSB) метод производной не даёт значимого преимущества** — пороговый метод уже работает надёжно, шум физически не может дать скачок 0.12°C

7. **Калибровка DS18B20** (без замены аппаратуры):
   - Одноточечная: лёд+вода (0°C) → offset → погрешность ±0.2-0.3°C
   - Двухточечная: лёд+вода (0°C) + кипящая вода (100°C) → offset + gain → погрешность ±0.1-0.2°C
   - Трёхточечная: + кипящий спирт (~78°C) → кусочно-линейная → ±0.05-0.15°C в рабочем диапазоне
   - Хранение: 4 датчика × 2 float (offset+gain) = 36 байт в EEPROM

**Выводы и рекомендации**:

1. **DS18B20 оставляем** — для дистилляции точность достаточна, для ректификации при delta=0.12°C — тоже
2. **Калибровка DS18B20** — имеет смысл только для расчёта крепости (абсолютная точность), для управления процессом не нужна
3. **Pt100** — рассматривать только для BuhloWar v3.0 как опцию для TSAR (один канал), остальное DS18B20
4. **Метод производной** — не актуален при delta=0.12°C, пороговый метод работает надёжно

**Сгенерированные файлы**:
- `docs/DS18B20_vs_Pt100_BuhloWar.pdf` — полный аналитический отчёт (13 стр., 7 таблиц)
- `download/generate_sensor_comparison.py` — скрипт генерации PDF

---

## 2026-05-31 — Фикс: CloudManager не инициализируется при фоновом переходе AP→STA + LCD не обновляет символ сети

### BuhloWar.ino + AppNetwork.h + AppNetwork.cpp — CloudManager init + LCD network symbol

**Задача**: при фоновом переходе AP→STA (WiFi подключился в фоне) CloudManager не инициализируется, телеметрия не отправляется, символ сети на LCD не меняется с 'A' на 'W'.

**Анализ корневой причины**:

1. **CloudManager не инициализируется** — в `setup()` CloudManager создаётся только при `netMode == STA_MODE`. При фоновом переходе AP→STA в `update()` этот код не выполняется повторно. `cloudManager.isConfigured()` возвращает false → телеметрия не шлётся.

2. **LCD символ не обновляется** — `processEngine.updateNetworkStatus()` вызывается только внутри `if (processEngine.isProcessRunning())`. В idle режиме (процесс не запущен) символ 'A' на LCD не меняется на 'W' даже после перехода в STA_MODE.

**Решение** (3 изменения):

1. **Флаг `didSwitchToSTA()`** — в AppNetwork добавлен флаг `switchedToSTA`, который устанавливается при переходе AP→STA в `update()`. Метод `didSwitchToSTA()` возвращает true один раз и сбрасывает флаг. Аналог edge-trigger.

2. **Инициализация CloudManager в loop()** — при обнаружении `didSwitchToSTA()` в основном цикле, CloudManager инициализируется с теми же параметрами (URL, API key, command callback), что и в `setup()`. Защита от повторной инициализации: `!cloudManager.isConfigured()`.

3. **Обновление LCD символа сети всегда** — добавлен блок в `loop()` который отслеживает изменение символа сети (`W`/`A`/`X`) через static-переменную `lastNetSymbol`. При изменении — вызывает `processEngine.updateNetworkStatus()` независимо от того, запущен процесс или нет.

**Изменённые файлы**:
- `AppNetwork.h`: добавлен метод `didSwitchToSTA()` и поле `switchedToSTA`
- `AppNetwork.cpp`: реализация `didSwitchToSTA()`, установка `switchedToSTA=true` при AP→STA переходе
- `BuhloWar.ino`: блок инициализации CloudManager при `didSwitchToSTA()`, обновление LCD символа сети в idle

---

## 2026-05-31 — Фикс: Kernel Panic — WiFi.disconnect(true) убивает AP режим + переполнение стека CloudManager

### AppNetwork.cpp + CloudManager.h — безопасный WiFi disconnect + увеличенный стек + мониторинг

**Задача**: система падает с Kernel Panic через 5-8 минут после запуска. WiFi подключается, Cloud работает, затем краш и перезагрузка. Циклично.

**Анализ корневой причины**:

1. **WiFi.disconnect(true) убивает AP режим** — предыдущий фикс добавил `WiFi.disconnect(true)` перед `WiFi.begin()`, но `disconnect(true)` полностью выключает WiFi радио (WIFI_OFF). К этому моменту AP режим уже запущен через `startWebServerEarly()` — WebServer и DNS сервер привязаны к AP интерфейсу. Когда WiFi выключается, эти объекты остаются привязаны к несуществующему интерфейсу → Kernel Panic при обращении к ним.

2. **Переполнение стека CloudManager** — cloud задача запущена со стеком 8KB, но SSL/TLS требует 6-10KB стека, а JSON парсинг и буферы ещё ~4KB. При большом JSON телеметрии стек переполняется → Kernel Panic.

**Решение** (3 изменения):

1. **Безопасный WiFi disconnect** — `WiFi.disconnect(false)` вместо `disconnect(true)`. Параметр `false` отключается от STA точки доступа, но НЕ выключает WiFi радио. AP режим остаётся живым. Дополнительно `WiFi.mode(WIFI_AP_STA)` гарантирует dual режим.

2. **Увеличенный стек CloudManager** — 16KB вместо 8KB. SSL/TLS требует 6-10KB, JSON + буферы ещё ~4KB. 16KB даёт безопасный запас.

3. **Мониторинг стека в CloudManager** — каждые 60 сек логируется свободный остаток стека (`uxTaskGetStackHighWaterMark`). При остатке < 2KB — предупреждение. Помогает диагностировать переполнение до Kernel Panic.

**Изменённые файлы**:
- `AppNetwork.cpp`: `WiFi.disconnect(true)` → `WiFi.disconnect(false)` + `WiFi.mode(WIFI_AP_STA)`
- `CloudManager.h`: стек 8192 → 16384, мониторинг стека каждые 60 сек

---

## 2026-05-31 — Фикс: система не переходит из AP в STA режим при подключении WiFi

### AppNetwork.cpp — обнаружение фонового подключения WiFi + чистый старт + увеличенный таймаут

**Задача**: при подключении к другой точке WiFi (данные на SD карте) система получает IP от роутера, веб-интерфейс доступен по этому IP, но система показывает режим "A" (AP_MODE) вместо "W" (STA_MODE). В результате телеметрия не отправляется на хостинг.

**Анализ корневой причины**:
1. `startWebServerEarly()` устанавливает `networkMode = AP_MODE`
2. `begin()` пытается подключиться к WiFi с таймаутом 9 сек, но при подключении к новой AP этого времени может не хватить
3. `networkMode` остаётся `AP_MODE`
4. ESP32 в фоне продолжает попытки и подключается к роутеру (поэтому IP есть)
5. В `update()` проверка `if (networkMode == STA_MODE)` — false, код внутрь не заходит
6. Режим навсегда остаётся AP_MODE, хотя WiFi реально подключён

**Решение** (4 изменения):

1. **WiFi.disconnect(true) перед WiFi.begin()** — при смене точки доступа WiFi может "застрять" на старых креденшиалах. `disconnect(true)` очищает кэш WiFi и позволяет чисто подключиться к новой AP. Вызывается перед каждой попыткой `WiFi.begin()` в `begin()`.

2. **Увеличенный таймаут в begin()** — 3 попытки × 5 сек = 15 сек максимум (было 3×3=9 сек). При подключении к новой AP ESP32 может требовать больше времени.

3. **Обнаружение фонового подключения (AP→STA)** — добавлена проверка в `update()`: если `networkMode == AP_MODE`, но `WiFi.status() == WL_CONNECTED` — переключаемся в STA_MODE, проверяем интернет, синхронизируем NTP. Это ключевое исправление: без него система навсегда оставалась в AP_MODE.

4. **Ускоренная проверка в AP режиме** — интервал периодической проверки сети в AP_MODE уменьшен с 30 до 10 сек, чтобы быстрее обнаружить подключение WiFi в фоне и переключиться в STA_MODE.

**Изменённые файлы**:
- `AppNetwork.cpp`:
  - `begin()`: WiFi.disconnect(true) + delay(100) перед WiFi.begin(), tries < 50 вместо < 30
  - `update()`: блок перехода AP→STA при WiFi.status() == WL_CONNECTED
  - `update()`: safeInterval = 10000 для AP_MODE (было 30000 единый для всех)

---

## 2026-04-11 — Web UI: индикатор статуса датчика давления BME280

### AppNetwork.cpp + index_landscape_knob.html + index_mobile.html — маркер BME +/-

**Задача**: оператор должен видеть работает ли датчик давления BME280. При неработающем датчике давление показывается как 760 мм рт.ст. (fallback), коррекция температур считается от этого значения. Нужно визуально показать статус датчика.

**Анализ логики работы**:
1. При инициализации (`SensorAdapter::begin()`) вызывается `bme.begin()` — если датчик не найден, `bmeInitialized = false`
2. При чтении данных — если получены NaN значения, датчик помечается как неработающий
3. При `!bmeInitialized`: `pressure = 0.0f`, в web `currentData.pressure || 760` — показывается 760
4. Коррекция температур (`pressCorr`) также считается от 760 — логика вычислений не ломается

**Решение**:
1. **API**: добавлено поле `bmeWorking: true/false` в JSON ответ (AppNetwork.cpp)
2. **index_landscape_knob.html**: маркер **BME +** (cyan) / **BME -** (red) под шкалой давления в блоке АТМОСФЕРА
3. **index_mobile.html**: маркер **BME +** (cyan) / **BME -** (red) в шапке после иконок НАГРЕВ/МЕШАЛКА/ВОДА

**Исправление (баг-фикс)**:
- Поле `bmeWorking` было добавлено только в `handleApiStatus()`, но отсутствовало в `buildTelemetryJson()` (для облачного режима)
- Добавлено поле `bmeWorking` в `buildTelemetryJson()` — теперь статус BME корректно показывается в обоих режимах

**КРИТИЧЕСКОЕ ИСПРАВЛЕНИЕ #1**:
- При неработающем BME `pressure = 0.0f`, и коррекция температур давала ошибку +28°C!
- Добавлен метод `getPressureMmHg()` в SensorData с fallback на 760 мм рт.ст.
- Исправлены все места расчёта коррекции: ProcessEngine.cpp, AppNetwork.cpp

**КРИТИЧЕСКОЕ ИСПРАВЛЕНИЕ #2 — Логика работы TELO и Midterm при потере/восстановлении BME**:

Правила работы коррекции давления:
1. **Нет референса при старте этапа** → коррекция отключена на ВЕСЬ этап, давление = 760 мм рт.ст.
2. **Референс получен + потеря BME** → используются замороженные последние данные
3. **Потеря + восстановление BME** → динамическая коррекция восстанавливается

Реализация для **РЕКТИФИКАЦИЯ (TELO)**:
- Добавлен флаг `bmeReferenceCaptured` — был ли захвачен референс при старте
- Если BME не работает при старте TELO: `adPressM = 1013.25 гПа` (760 мм рт.ст.), коррекция = 0 на весь этап
- Если BME работал, потом пропал: давление замораживается на последнем значении
- Если BME восстановился: `adPressM` обновляется, динамическая коррекция возобновляется

Реализация для **ДИСТИЛЛЯЦИЯ (OTBOR → Midterm)**:
- Добавлены статические переменные: `distBmeReferenceCaptured`, `distMidtermPressureMmHg`
- Аналогичная логика: нет референса → 760 мм рт.ст., потеря → заморозка, восстановление → обновление

**Изменённые файлы**:
- `ProcessCommon.h`: добавлен метод `getPressureMmHg()` с fallback
- `ProcessEngine.cpp`: 
  - TELO: флаг bmeReferenceCaptured, логика захвата/заморозки/восстановления давления
  - OTBOR: аналогичная логика для Midterm
- `AppNetwork.cpp`: добавлено поле bmeWorking, исправлен расчёт pressure_mmHg
- `index_landscape_knob.html`: CSS .bme-badge, HTML badge, JS обновление статуса
- `index_mobile.html`: CSS .bme-badge, HTML badge, JS обновление статуса

---

## 2026-04-11 — Web UI: индикатор облачных данных + кнопка LANDSCAPE

### index_landscape_knob.html — «Данные: X сек назад» в шапке при облачном режиме

**Задача**: в облачном режиме (CLD) в шапке после надписи CLD показать сколько секунд назад были получены данные с хостинга.

**Решение**:
1. Добавлен новый `<span id="cloud-data-age">` после `conn-mode-label` с текстом «Данные: X сек»
2. По умолчанию скрыт (`display:none`), показывается только при `cloudMode=true`
3. Значение обновляется в том же цикле что и CLD/LOK label, вычисляется как `Date.now()/1000 - cloudLastUpdate`

### index_mobile.html — кнопка LANDSCAPE в блоке облачного режима

**Задача**: в «Общие настройки» в блоке «☁️ ОБЛАЧНЫЙ РЕЖИМ» добавить кнопку для перехода к landscape-интерфейсу.

**Решение**:
- Заголовок блока переделан в flex-контейнер: слева заголовок, справа кнопка «LANDSCAPE»
- Кнопка использует стиль `btn-cyan-outline`, открывает `index_landscape_knob.html` на том же хосте
- При работе на хостинге — переход между мобильной и landscape версиями в один клик

**Изменённые файлы**:
- `index_landscape_knob.html`: HTML span cloud-data-age, JS обновление возраста данных
- `index_mobile.html`: кнопка LANDSCAPE в заголовке блока облачного режима

---

## 2026-04-11 — Фикс: WiFi подключение при холодном старте

### AppNetwork.cpp — увеличен таймаут для Power On

**Задача**: при первом включении (Power On) система уходила в AP mode, хотя WiFi был доступен. При нажатии Reset — подключение успешно. Причина: таймаут 2 сек недостаточен для инициализации WiFi радио при холодном старте.

**Анализ**:
- `begin()`: 1 попытка × 20 итераций × 100мс = **2 сек** — слишком мало
- `connectToWiFi()`: 3 попытки × 15 итераций = **4.5 сек** — работает при переподключении
- При Power On: WiFi радио выключено, кэш пуст → нужно 3-5 сек
- При Reset: радио уже работало, кэш есть → 1-2 сек достаточно

**Решение**: увеличен таймаут в `begin()`:
- 3 попытки по 30 итераций (3 сек) = до 9 сек максимум
- Аналогично логике `connectToWiFi()`
- Минимальное увеличение времени загрузки при успешном подключении

**Изменённые файлы**:
- `AppNetwork.cpp`: цикл повторных попыток в `begin()`, увеличен таймаут

---

## 2026-04-10 — Полосковый индикатор контроля ЦАРГИ

### index_landscape_knob.html — вертикальная шкала с зумом диапазона BASE/HYST

**Задача**: риска teloEnd на кольце ЦАРГА в gauge была неинформативна — при реальной работе расстояние от текущей температуры до порога залёта ~0.2°C, и на шкале 0-105°C риска сливается с полоской текущего значения. Нужен визуально различимый индикатор приближения к порогам DELTA (снижение скорости) и HYST (завершение отбора).

**Решение**: новый блок «Контроль ЦАРГИ» — вертикальная полоска с динамическим диапазоном ~0.6°C (base-0.2 .. hyst+0.2), расположенная между диаграммой и правой колонкой.

1. **Layout**: grid 3→4 колонки (`minmax(140px,1.2fr)` для нового блока), `min-width: 680px`.
2. **Canvas `drawTsarBar()`**: рисует полоску с градиентом (cyan→green→amber→red), риски BASE/DELTA/HYST, пунктирную линию текущей температуры, шкалу с шагом 0.05°C, значения с точностью 0.01°C. Подсветка зоны DELTA-HYST.
3. **До этапа ТЕЛО**: индикатор обесцвечен (saturation 0.25) — видны серые контуры, но не отвлекает. BASE = текущая tsar, DELTA/HYST с дефолтными смещениями.
4. **При ТЕЛО/NASEBYA**: полная цветная версия — BASE=rtsarM, DELTA=rtsarM+delta+pressCorr, HYST=rtsarM+hyst+pressCorr. Обновляется real-time с учётом давления.
5. **Под полоской**: текущее значение ЦАРГИ, цвет меняется на amber при достижении DELTA и red при HYST.
6. **Убрана риска teloEnd с gauge** — заменена этим индикатором.

**Изменённые файлы**:
- `index_landscape_knob.html`: CSS grid 4 col, CSS tsar-bar-panel, HTML tsar-bar panel, JS drawTsarBar(), убран teloEnd marker из gauge

---

## 2026-04-10 — Фикс: устранение мерцания шкалы температур в блоке Контроль ЦАРГИ

### index_landscape_knob.html — округление диапазона до 0.1°C

**Задача**: до начала ТЕЛО шкала температур справа от полоски периодически пропадала/появлялась — «мерцание». Причина: при колебаниях tsar на ±0.05°C диапазон `rangeMin=baseVal-0.20` и `rangeMax=hystVal+0.20` сдвигался каждую секунду, и числовые значения справа менялись.

**Решение**: округление `rangeMin` вниз и `rangeMax` вверх до шага 0.1°C с запасом ±0.5°C:
```js
rangeMin = Math.floor((baseVal-0.50)*10)/10
rangeMax = Math.ceil((hystVal+0.50)*10)/10
```

**Почему это работает**:
- При tsar=25.03°C: range=24.5–25.7 (округлено), при tsar=25.07°C: range всё ещё 24.5–25.7 — диапазон стабильный
- При ТЕЛО: rtsarM фиксирован один раз, pressCorr меняется очень медленно (~0.003-0.028°C/час) — диапазон практически константа
- Запас ±0.5°C (вместо 0.2°C) даёт устойчивость при колебаниях до ±0.1°C

**Изменённые файлы**:
- `index_landscape_knob.html`: вычисление rangeMin/rangeMax в drawTsarBar() с округлением

---

## 2026-04-10 — Фикс: логика активации полоски ЦАРГИ и защита от нулевого диапазона

### index_landscape_knob.html — isTelo проверяет rtsarM

**Задача**: полоска ЦАРГИ активировалась (становилась цветной) при NASEBYA даже когда rtsarM ещё не был установлен. Также при определённых условиях цифры шкалы исчезали.

**Причина**:
1. `isTelo` проверял только `stage`, но не проверял установлен ли `rtsarM`
2. При `rangeW < 0.1` (нулевом или отрицательном диапазоне) отрисовка могла давать NaN

**Решение**:
1. Добавлена переменная `hasRef = rtsarM > 0.1` — проверка что опорная температура установлена
2. Изменена логика активации: `isTelo = hasRef && (stage==='TELO' || stage==='NASEBYA')`
   - Полоска цветная только когда rtsarM установлен И идёт TELO/NASEBYA
   - При ГОЛОВЫ, НАГРЕВ и других этапах — серая
3. Добавлена защита от нулевого диапазона: `if(rangeW<0.1)rangeW=0.1`

**Изменённые файлы**:
- `index_landscape_knob.html`: логика isTelo в drawTsarBar() + guard для rangeW

---

## 2026-04-10 — Фикс: компоновка шкалы и значений в блоке Контроль ЦАРГИ

### index_landscape_knob.html — значения рисок правее шкалы

**Задача**: значения BASE/DELTA/HYST налезали на шкалу температур справа от полоски — все элементы использовали одинаковый X-отступ `barX+barW+9`.

**Решение**:
1. **Полоска сдвинута влево**: `barX=14` (отступ слева), ширина `barW=40px` — освобождено место справа
2. **Шкала**: отступ от полоски `scaleOffset=barX+barW+3` (минимальный)
3. **Значения рисок**: отступ `valOffset=barX+barW+42` — правее шкалы, не пересекаются
4. **Текущая температура**: только стрелка слева, значение уже показывается под полоской
5. **Шрифт уменьшен**: 8px→7px для компактности
6. **Подписи рисок сокращены**: BASE→B, DELTA→D, HYST→H — один символ слева от полоски

**Геометрия (при ширине блока ~140px)**:
- Слева: 14px (отступ+B/D/H) + 40px (barW) + 3px (gap) + ~30px (шкала) + ~30px (значения) = ~117px — вписывается

**Изменённые файлы**:
- `index_landscape_knob.html`: barX фиксированный, scaleOffset/valOffset, уменьшен шрифт

---

## 2026-04-10 — Фикс: конверсия единиц давления в расчёте teloEnd

### index_landscape_knob.html — исправлена формула расчёта порога окончания ТЕЛО

**Задача**: риска на кольце ЦАРГА показывала неверную позицию и неверное значение рядом с ней.

**Решение**: в исходной формуле `pressure` с ESP32 приходит в мм.рт.ст. (`sensors.pressure * 0.75`), а `adPressM` — в сырых гПа (как хранится внутри ProcessEngine). Разница давлений считалась напрямую между разными единицами. Исправлено: `adPressM × 0.75` → перевод в мм.рт.ст., разница `/ 0.75` → обратно в гПа для умножения на `pressureCoeff` (0.028 °C/гПа). Теперь формула полностью эквивалентна C++: `rtsarM + histeresis + ((pressure_mmHg - adPressM_mmHg) / 0.75) × pressureCoeff`.

**Изменённые файлы**:
- `index_landscape_knob.html`: конверсия adPressM гПа→мм.рт.ст., пересчёт разницы в гПа для pressureCoeff

---

## 2026-04-10 — Мониторинг: сохранение объёмов голов/тела после финиша

### index_landscape_knob.html — данные ГОЛОВЫ/ТЕЛО остаются видимыми при FINISHWORK

**Задача**: при переходе системы в FINISHWORK данные по отобранным объёмам голов и тела в блоках ГОЛОВЫ/ТЕЛО пропадали (затирались `--`). Нужно чтобы они оставались до выключения системы или запуска нового процесса.

**Решение**:
- Добавлены переменные `preservedHeadsVolDone`, `preservedBodyVolDone`, `preservedHeadsTotalTarget`, `preservedAsVolume` — сохраняют последние ненулевые значения при каждом poll.
- В `else`-ветках `updateCalculationsHUD()` (когда stage не GOLOVY/TELO) вместо `--` выводятся сохранённые значения.
- При старте нового процесса (`stage === NAGREV` или `NAGREV_DEFL`) все сохранённые значения обнуляются.

**Изменённые файлы**:
- `index_landscape_knob.html`: preserved-переменные, логика сохранения/очистки в syncData(), обновлённые else-ветки в updateCalculationsHUD()

---

## 2026-04-10 — Царга: риска расчётной температуры окончания ТЕЛО (real-time)

### index_landscape_knob.html — динамический маркер порога окончания отбора на кольце ЦАРГА

**Задача**: добавить на кольцо ЦАРГА риску, показывающую температуру при которой завершится отбор ТЕЛО (Шпора — финиш, Стандарт — повторная стабилизация). Значение рассчитывается в реальном времени с учётом коррекции по давлению.

**Решение**:
- **Формула** (полная аналогия C++ ProcessEngine): `rtsarM + histeresis + (текущее давление − adPressM) × pressureCoeff`
- **Скрытие до начала ТЕЛО**: `show: teloEnd > 0 && teloEnd < GS.maxT`. Пока `rtsarM ≤ 0.1` (этап ТЕЛО не начался) — риски нет на диаграмме.
- **Обновление в реальном времени**: `pressureCorrection` пересчитывается каждую секунду при отрисовке диаграммы, риска плавно сдвигается при изменении давления.
- **Цвет** `#00ff88` (как кольцо царги), **подпись** — значение с 1 знаком после запятой (например `78.5`).

**Изменённые файлы**:
- `index_landscape_knob.html`: markers array (+teloEnd маркер), расчёт порога в drawGauge()

** Не удачное решение**
Нужно переделать Проверил, получается не информативно, поскольку в реальной работе обычно расстояние от текущей температуры и температуры залета отличается на 2 с небольшим десятых градуса, и получается риска на дуге царги вплотную к показаниям полоски на дуге. Надо придумать что то другое, давай подумаем как можно визуально отслеживать подход температуры в царге к показаниям для снижения скорости отбора и окончании отбора в методе шпора и окончании отбора в методе стандарт для отбора тело.

---

## 2026-04-10 — Кольцо ВОДА: риска 50°C и предупреждение перегрева

### index_landscape_knob.html — серая риска на 50°C и красное кольцо при превышении

**Задача**: добавить на кольцо ВОДА визуальный маркер 50°C и индикацию перегрева — кольцо становится красным при температуре выше 50°C, без уведомлений/аварий, просто смена цвета.

**Решение**:
1. **Серая риска на 50°C**: добавлен маркер `{val:50, label:'50', color:'#666666', ringKey:'aqua', show:true}` в массив markers диаграммы. Риска пересекает кольцо ВОДА (как маркеры TSA/СТОП/TARA на своих кольцах), цвет серый `#666666`, подпись «50» у наружного края.
2. **Красное кольцо при t > 50°C**: добавлено условие `if(ring.key==='aqua'&&temp>50) {rc='#ff3355'; rb='rgba(255,51,85,0.15)';}` в цикле отрисовки колец (аналог TSA-лимита). При снижении температуры ниже 50°C кольцо автоматически возвращается к обычному цвету `#00f0ff`.

**Изменённые файлы**:
- `index_landscape_knob.html`: markers array (+aqua 50°C), ring color override для aqua > 50°C

---

## 2026-04-10 — Компоновка index_landscape_knob.html

### index_landscape_knob.html — 4 правки по результатам тестирования

**Задача**: корректировки компоновки, точности данных и стиля по результатам проверки на ESP32.

**Решение**:
1. **Power Knob поднят к ВОДА**: убраны padding/margin контейнера потенциометра (`padding:4px 0 2px` → `margin:0;padding:0`), ручка максимально близко к значению ВОДА. Убран `margin-top:auto` у блока МОЩН/BOX/ВЛАЖН — он расталкивал контент вниз панели, создавая пустое место между потенциометром и МОЩН. Padding блока уменьшен `10px→6px`.
2. **Точность датчиков на Мониторинге — 2 знака**: функция `setTemp()` на странице Мониторинг выводила `toFixed(1)`, в то время как на страницах Дистилляция/Ректификация и на LCD — `toFixed(2)`. Исправлено: `toFixed(1)` → `toFixed(2)` для единообразия.
3. **Навигационные кнопки прижаты к контенту**: grid-layout `.hud-container` имел `grid-template-rows: 44px 1fr 36px` — навбар был привязан к нижнему краю экрана. Первая правка (`36px→auto`) не помогла, т.к. `1fr` всё равно растягивал main на весь экран. Финально изменено на `44px auto auto` — кнопки идут сразу после контента.
4. **Шкала диаграммы в стиле PowerKnob**:
   - Цвета: крупные деления (10°) и подписи — `#ff8c00` (amber), средние (5°) и мелкие (1°) — `#00f0ff` (cyan). Шрифт подписей 8→9px.
   - Убраны фоновое свечение и декоративный контур за шкалой (были `rgba(0,240,255,0.08)` и `0.12`).
   - Направление рисок: из наружу→внутрь (как у PowerKnob), подписи перенесены на наружный край.
   - Длины рисок: крупные 12px, средние 12px (было 8px), мелкие 6px (было 3px = половина от крупных).
   - Фоновые дуги колец температур оставлены без изменений.

**Изменённые файлы**:
- `index_landscape_knob.html`: CSS grid-rows (1fr→auto), setTemp toFixed(2), PowerKnob padding, убран margin-top:auto, gauge scale colors

---

## 2026-04-09 — Power Knob: SVG-потенциометр для отображения мощности

### power_knob.html + power_knob.js + index_landscape_knob.html — визуальная ручка-потенциометр

**Задача**: создать визуальный элемент-потенциометр (как на физических приборах) для отображения заданной мощности в блоке Температуры на странице Мониторинг. Оригинальный `index_landscape.html` не трогать — работа в отдельном файле.

**Решение**:

1. **Стенд-alone компонент `power_knob.html`** — автономная страница для отладки:
   - SVG ручка-потенциометр в стиле Sci-Fi HUD (металлический 3D, knurling 60 насечек, втулка, белый указатель)
   - Дуга 270°, диапазон 100–7000W, деления каждые 100W
   - Подписи 0–7 (кВт), нулевая риска
   - Мелкие риски #00f0ff (cyan), тысячные риски и подписи #ff8c00 (amber)
   - Шкала близко к ручке (радиус делений 68px, подписи 82px)
   - JS-функция `setPower(watts)` для обновления указателя
   - Плавная CSS-анимация поворота 0.6s cubic-bezier

2. **Модульная версия `power_knob.js`** — IIFE-компонент `PowerKnob` для встраивания:
   - API: `PowerKnob.init(containerId)`, `PowerKnob.update(watts)`, `PowerKnob.initialized`
   - Автоматическое создание SVG внутри контейнера, все ID с префиксом `pk` для изоляции

3. **Интеграция `index_landscape_knob.html`** — копия `index_landscape.html` с потенциометром:
   - Потенциометр размещён в блоке Температуры: ниже датчика ВОДА, выше строки МОЩН
   - Код PowerKnob встроен инлайн (без внешних зависимостей, работает автономно)
   - Инициализация при загрузке страницы (дефолт 3000W, виден без ESP32)
   - Автообновление указателя при получении `cfg.power` от ESP32 и при изменении через +/- кнопки

**Итерации разработки** (5 версий по обратной связи):
- v1: базовый потенциометр с кнопками и отображением значения → убраны кнопки и значение
- v2: реалистичная ручка с knurling, шкала снаружи → радиус шкалы уменьшен
- v3: шкала ближе к ручке (68px), убрано отображение значения
- v4: фикс поворота указателя (+90°), нулевая риска, подписи без 'k'
- v5: подписи 1–7 (без нулей), яркие цвета #ff8c00/#00f0ff

**Изменённые файлы**:
- `power_knob.html`: стенд-alone компонент (новый)
- `power_knob.js`: модульная версия для встраивания (новый)
- `index_landscape_knob.html`: копия index_landscape.html с интегрированным потенциометром (новый)
- `index_landscape.html`: **НЕ изменён**

---

## 2026-04-09 — Очистка репозитория от системных файлов

### .gitignore — убрано 410 файлов из трекинга

**Задача**: в репозитории появились системные папки `skills/`, `.env`, submodule-папки `BuhloWar/`, `repo/` и изменённые `.md` файлы от автосинхронизации.

**Решение**:
- Создан `.gitignore`: `skills/`, `.env`, `BuhloWar/`, `repo/`
- Удалено из git tracking: `git rm --cached -r` (410 файлов)
- Оригинальные рабочие файлы не затронуты

**Изменённые файлы**:
- `.gitignore`: создан (новый)

---

## 2026-04-09 — Фикс: minOpenTime ограничивался 1000 при загрузке из API

### index_landscape.html — старые хардкоды при загрузке конфига не совпадали с cfgRanges

**Задача**: minOpenTime невозможно задать больше 1000 в WEB, хотя cfgRanges разрешает до 2000.

**Решение**: при загрузке конфига из API (функция обновления UI) были найдены старые хардкодные проверки диапазонов, которые не были обновлены при создании cfgRanges:
- `minOpenTime`: `>=10 && <=1000` → `>=50 && <=2000` (сбрасывал значение >1000 на дефолт 100)
- `speedHeadCorr`: `>=0 && <=200` → `>=10 && <=200` (позволял 0, хотя cfgRanges min=10)
- `speedBodyCorr`: `>=0 && <=200` → `>=10 && <=200` (аналогично)

**Изменённые файлы**:
- `index_landscape.html`: строки валидации при загрузке конфига приведены к cfgRanges

---

## 2026-04-08 — Диапазоны параметров WEB интерфейса + синхронизация с LCD

### index_landscape.html + menu_settings.h — cfgRanges для всех 21 параметра

**Задача**: провести аудит и установить диапазоны (min/max) для ВСЕХ параметров в WEB интерфейсе и LCD меню, чтобы исключить ввод некорректных значений. Диапазоны должны быть общими для LCD и WEB.

**Решение**:
1. **Инфраструктура**: создан объект `cfgRanges` в WEB (аналог `engRanges` для инженерного меню). Функция `adjCfg()` переписана на использование `cfgRanges` вместо хардкодных проверок. Также добавлен массив `cfgAutoSave` — параметры с автосохранением при изменении (расширен с 3 до 9 полей).
2. **Общие настройки (10 параметров)** — диапазоны установлены, LCD синхронизирован:
   - emergencyTime: min=1, max=**10** (было max=5 в LCD)
   - nasebTime: min=1, max=30 (=LCD)
   - reklapTime: min=1, max=30 (=LCD)
   - boxMaxTemp: min=50, max=70 (=LCD)
   - power: min=100, max=**7000** (было max=3500)
   - asVolume: min=1000, max=10000 (=LCD)
   - speedHeadCorr: min=**10**, max=200 (было min=0 в WEB)
   - speedBodyCorr: min=**10**, max=200 (было min=0 в WEB)
   - minOpenTime: min=50, max=**2000** (было max=500 в LCD, max=1000 в WEB)
   - chekwifi: min=1, max=5 (=LCD)
3. **Дистилляция (6 параметров)** — диапазоны установлены (в LCD этих параметров нет, они настраиваются в меню процесса):
   - razgonTemp: min=40, max=99
   - bakStopTemp: min=50, max=99
   - midterm: min=0, max=98 (связан с midterm_abv через температурно-крепостную зависимость)
   - midterm_abv: min=0, max=98 (связан с midterm через getOutputABVForTemp/getTempForOutputABV)
   - mixerOnTime: min=5, max=300
   - mixerOffTime: min=1, max=120
4. **Ректификация (5 параметров)** — диапазоны установлены:
   - tsaLimit: min=40, max=55 (=LCD)
   - cycleLim: min=1, max=**5** (было без лимитов в WEB)
   - histeresis: min=0.06, max=1.00
   - delta: min=0.06, max=1.00

**Изменённые файлы**:
- `index_landscape.html`: добавлен cfgRanges (21 параметр), cfgAutoSave, adjCfg() переписана
- `menu_settings.h`: emergencyTime max 5→10, power max 3500→7000, minOpenTime max 500→2000

---

## 2026-04-08 — Доработки инженерного меню WEB интерфейса

### index_landscape.html — переименования + перенос кнопки + фикс бага shporaStabMs

**Задача**: доработать инженерное меню по результатам тестирования — переименования, компактность, исправление критического бага с единицами измерения.

**Решение**:
1. **Кнопка ⚙ перенесена** в строку заголовка страницы «Настройки» (у правого края). Старый блок «ИНЖЕНЕРНОЕ МЕНЮ» с подписью и кнопкой внизу страницы удалён — экономия высоты.
2. **Переименования подписей** (только HTML label, логика и JSON ключи не затронуты):
   - СКОРОСТИ ЭКСТРАКЦИИ → СКОРОСТИ ОТБОРА
   - ДО ОТБОРА → ДООТБОР ГОЛОВЫ
   - КОЭФФ. → КОЭФФ.СНИЖЕНИЯ ОТБОРА
   - СТАБИЛИЗАЦИЯ → СТАБИЛИЗАЦИЯ (до след.снижения)
   - МИН. ТЕЛО → МИН.СКОРОСТЬ ТЕЛО
   - ДОЛИ ОТБОРА → ДОЛИ ОТБОРА ГОЛОВ
   - КОРРЕКЦИЯ → КОЭФФ.КОРРЕКЦИИ ПО АД
   - ВРЕМЕНА ПРОЦЕССОВ → ВРЕМЯ ЭТАПОВ
   - ОХЛАЖДЕНИЕ → ОСТАНОВ ОХЛАЖДЕНИЯ
   - КАЛИБР. СУХОЙ → ПРОЛИВ
3. **Критический баг: shporaStabMs мс↔сек** — C++ хранит `shporaStabMs = 60000` (мс), но UI показывала raw-значение "60000" вместо "60 сек". Диапазон UI `[10,300]` приводил к скачку на 300 при редактировании, а сохранённое значение `300` интерпретировалось как 300 мс = 0.3 сек (вместо 300 сек). Фикс:
   - Добавлен массив `engMsFields = ['shporaStabMs']`
   - `openEngMenu()`: делит на 1000 при загрузке (60000 → 60)
   - `saveEngMenu()`: умножает на 1000 при сохранении (60 → 60000)
   - Убраны мёртвые параметры `displayMul` из `adjEng()` вызовов
4. **Проверка всех остальных параметров** — coolingDurationSec, bakstopDelaySec, calibDrySec, calibCapacitySec хранятся и используются в секундах, конвертация не нужна, багов нет. Доли (headsShare*) корректно конвертируются %↔доля через engPctFields.

**Изменённые файлы**:
- `index_landscape.html`: HTML подписи, кнопка инженерного меню, JS конвертация shporaStabMs

---

## 2026-04-08 — План: Инженерное меню + фикс NTP таймзоны

### Анализ хардкод-констант (~70 найдено)

**Задача**: вынести настраиваемые константы из C++ кода в Engineering Menu (WEB интерфейс), чтобы пользователь мог менять их без перекомпиляции. Параллельно — исправить баг NTP таймзоны и провести аудит диапазонов существующих настроек.

**Решение — согласованный план (пункты 1-6 + фикс NTP):**

1. **Базовые скорости экстракции** (ProcessEngine.cpp:1004-1005, 1499)
   - Головы: 50 мл/ч/кВт (distillation heads: 50 мл/ч)
   - Тело: 500 мл/ч/кВт
   - Перегон голов: 50 мл/ч

2. **Параметры Шпоры** (ProcessEngine.cpp:5-6)
   - CORRELATION_COEFF: диапазон 1.05–1.50, шаг 0.01, по умолч. 1.13
   - SHPORA_STABILIZATION: диапазон 10–300 сек, шаг 10, по умолч. 60

3. **MIN_BODY_SPEED** (ProcessEngine.cpp:1428)
   - Диапазон 100–800 мл/ч, шаг 50, по умолч. 300

4. **Доли отбора** (ProcessEngine.cpp:1098, 1148, 1195, 1238)
   - Стандарт головы: 5–20%, шаг 1, по умолч. 10
   - КСС спит: 1–5%, шаг 0.5, по умолч. 2
   - КСС стандарт: 1–10%, шаг 0.5, по умолч. 3
   - КСС акатело: 5–30%, шаг 1, по умолч. 15

5. **Коррекция давления** (ProcessEngine.cpp:919, 1370)
   - Коэффициент: 0.020–0.040, шаг 0.001, по умолч. 0.028 (теоретич. ~0.03°С/мм)
   - Дельта ЦАРГ: 2.0–15.0°С, шаг 0.5, по умолч. 5.0

6. **Времена процессов** (ProcessEngine.cpp:385, 393, 878, 1568; OutputManager.h:98)
   - Охлаждение: 60–600 сек, шаг 30, по умолч. 300
   - Safe shutdown: 60–600 сек, шаг 30, по умолч. 300
   - Бакстоп задержка: 0–30 сек, шаг 1, по умолч. 5
   - Калибровка сухой тест: 5–30 сек, шаг 5, по умолч. 10
   - Калибровка capacity: 30–120 сек, шаг 10, по умолч. 60

7. **Предельные температуры** — НЕ трогать (ABSOLUTE_MAX_TEMP, ABSOLUTE_MIN_TEMP в config.h закомментированы)

8. **Баг NTP таймзоны** (AppNetwork.cpp:~857)
   - `syncNTP()` хардкодит `3 * 3600` вместо чтения `configManager.getConfig().timezoneOffset`
   - Фикс: заменить `configTime(3 * 3600, ...)` на `configTime(tzOffset * 3600, ...)`
   - Также: дублирование `timezoneOffset` в SystemConfig (preferences.h) и GlobalConfig (ProcessCommon.h)

**UI Инженерного меню:**
- Кнопка с иконкой wrench в странице Настройки
- Всплывающее окно «ИНЖЕНЕРНОЕ МЕНЮ»
- Подтверждение при открытии: «Вы уверены? Эти параметры влияют на процесс»
- Все параметры с диапазонами, шагами и значениями по умолчанию
- Кнопка СОХРАНИТЬ внутри диалога

**Дополнительно:**
- Аудит диапазонов/шагов в существующих настройках интерфейса
- Давление 0.0278 дублируется в двух местах (строки 919 и 1370) — объединить

**Изменённые файлы** (план):
- `ProcessEngine.cpp`: замена хардкодов на cfg.поля
- `OutputManager.h`: SAFE_SHUTDOWN_DURATION → cfg
- `preferences.h` / `preferences.cpp`: новые поля в SystemConfig
- `AppNetwork.cpp`: фикс NTP таймзоны
- `index_landscape.html`: инженерное меню (UI)
- `AI_RULES.md`: новое правило GitHub-сверки

---

## 2026-04-07 — Последние штрихи интерфейса

### index_landscape.html — подписи клапанов и унификация кнопок

**Задача**: мелкие правки перед тестированием на системе.

**Решение**:
1. **Подписи клапанов в ректификации**: КЛ.ГОЛОВ → ИСП.КЛ.ГОЛОВ, КЛ.ТЕЛО → ТИП.КЛ.ТЕЛО.
2. **Унификация кнопок**: добавлен CSS класс `.action-btn` (padding:10px, font-size:12px, letter-spacing:0.15em) — такой же размер как `.save-btn` в Дистилляции. Цветные варианты: `.amber`, `.green`, `.blue`, `.purple`. Добавлен `.action-btn-grid` для сетки 2 колонки.
3. **Окно Настройки**: все кнопки (СОХРАНИТЬ, ТЕСТ ЗВУКА, СОХР. ПРОФИЛЬ, ЗАГР. ПРОФИЛЬ, ИНСТРУКЦИЯ, ЛОГИ) переведены на `.action-btn` класс. Сгруппированы в сетки 2×2 для компактности: СОХРАНИТЬ+ТЕСТ ЗВУКА, СОХР.ПРОФИЛЬ+ЗАГР.ПРОФИЛЬ, ИНСТРУКЦИЯ+ЛОГИ.

**Изменённые файлы**:
- `index_landscape.html`: CSS классы, подписи клапанов, кнопки Настроек

---

## 2026-04-07 — Сессия N

### index_landscape.html — UI доработки нового ландшафтного интерфейса

**Задача**: мелкие замечания к Sci-Fi HUD интерфейсу.

**Решение**:
1. **Шапка**: убрана кнопка ⚙ Настройки (есть внизу в навигации), убраны индикаторы `760 mm` и `3000 W` (дублируют барометр и блок МОЩН), аббревиатуры заменены на полные названия: НГР→НАГРЕВ, МШЛ→МЕШАЛКА, ВДА→ВОДА. Убраны JS-обновления удалённых элементов.
2. **Заголовки блоков**: все заголовки сделаны цветными (Температуры=amber, Атмосфера=blue, Система=green, Головы=amber, Тело=green, Коррекция=purple, Настройки=blue, Калибровка=green, Облако=blue).
3. **Текст параметров ярче**: `.temp-label` #4a5568→#8a95a8, `.sys-label` #3a4a60→#6a7588, `.s-row label` #7a8598→#a0a8b8, `.calc-row-data .label` #4a5568→#8a95a8, `.temp-limit` #3a4558→#5a6577.
4. **Обводка блоков**: `--panel-border` rgba(0,240,255,0.12)→rgba(0,240,255,0.22). Border-bottom заголовков: rgba(0,0,0,0.03)→rgba(255,255,255,0.06).
5. **Мониторинг**: из блока Коррекция убраны КРЕП.КУБ и КРЕП.ОТБОР (дублируют блок Система). Удалены соответствующие HTML-элементы и JS-обновления.
6. **Тест звука**: кнопка перенесена из шапки в страницу Настройки (после блока WIFI ЧЕК).
7. **Анимация диаграммы**: добавлена 3-фазная анимация `animateGaugeEntry()` — раскрытие колец до макс→пауза→схлопывание к реальным значениям. Запускается при переключении на страницу Мониторинг. Барометр анимируется одновременно. Во время анимации обновление барометра заблокировано.

**Изменённые файлы**:
- `index_landscape.html`: все 7 пунктов

---

## 2026-04-05

### index.html — Мобильная адаптивность WEB интерфейса
`98459a2` (+ `a3ea466`, `7e6d590`, `35726ac`, `da336fd` — тестовые итерации через `index_mobile.html`)

- **Проблема**: WEB интерфейс не помещался на экране мобильного телефона (375px). Control Bar разбивался на 2 строки, gauge диаграмма обрезала содержимое справа, общая компоновка не влезала по ширине.
- **Итеративное решение** через отдельный тестовый файл `index_mobile.html` (4 раунда тестирования):
  1. Сначала `overflow-x-hidden` — обрезал контент справа (отменено).
  2. Уменьшение реальных размеров: gauge `w-40`, padding `p-3` — частично помогло.
  3. Уменьшение `gap` в Control Bar — не решило перенос на 2 строки.
  4. **Финальное решение**: замена `grid grid-cols-8` на `flex` + уменьшение кнопок/шрифта на мобилке.
- **Итоговые изменения в `index.html`**:
  - **Header**: `gap-6` → `gap-2 sm:gap-6` — иконки нагрева/мешалки/воды компактнее на мобилке.
  - **Top Control Bar**: `grid grid-cols-8` → `flex items-center justify-between` + кнопки `w-7 sm:w-8` + шрифт `text-[9px] sm:text-[10px]` + `flex-shrink-0` на всех элементах — всё помещается в одну строку на 375px.
  - **Gauge**: `w-52` → `w-40 sm:w-52`, canvas масштабируется через CSS `style="width:100%;height:100%"` с сохранением `width="208" height="208"` для корректного рисования.
  - **Карточка мониторинга**: `p-4` → `p-3 sm:p-4` — чуть компактнее на мобильных.
- Все изменения используют Tailwind responsive (`sm:` breakpoint 640px), на десктопе отображение не изменилось.

### index.html — Favicon подключён
`eaf57c0`

- Добавлен `<link rel="icon" type="image/svg+xml" href="favicon.svg">` в `<head>`.
- Favicon: SVG иконка vintage copper аламбик-дистиллятор.

### ProcessEngine.cpp + index.html — WEB мониторинг тела в Стандарт методе: отображение при NASEBYA и фикс фантомного объёма
`cc40528`

**Проблема 1: WEB не показывает данные тела при переходе "на себя"**
- При залёте в Стандарт методе система переходит в NASEBYA (стабилизация "на себя"). WEB мониторинг показывал `"--"` для метода, скорости, цикла, расч/факт.
- C++ `updateRectWebInfo()` обнулял `bodyMethodName`, `bodySpeed`, `bodyCycle` при любом этапе кроме TELO.
- JS `index.html` показывал блок тела только при `stage == 'TELO'`.
- **Фикс C++**: добавлена ветка `else if (currentStage == Stage::NASEBYA)` — при "на себя" данные тела сохраняются, не обнуляются.
- **Фикс JS**: три места в `index.html` изменены с `stage == 'TELO'` на `stage == 'TELO' || stage == 'NASEBYA'`. При NASEBYA рядом с циклом показывается пометка `⏳`.

**Проблема 2: Фантомный объём при возврате из NASEBYA**
- При возврате из NASEBYA в TELO первый расчёт `dt_h` охватывал всё время "на себя" (10-20 мин), и `bodyVolDone += скорость × время_NASEBYA` прибавлял объём за время когда клапан был закрыт.
- **Фикс**: `lastVolCalcTime = millis()` перед `changeStage(Stage::TELO)` в `handleNasebya()`. Отсчёт интервала начинается заново, `bodyVolDone` сохраняется и продолжает корректно накапливаться.

**Влияние на Шпору**: Шпора при залёте вызывает `finishTelo()` и никогда не переходит в NASEBYA. Ни одно изменение не затрагивает логику Шпоры.

### CloudManager.h — FreeRTOS задача: нулевая блокировка loop
`0ccf4ae`

- **Все HTTP-запросы вынесены в отдельную FreeRTOS задачу на core 0** (там WiFi/TCP стек). Основной loop на core 1 больше никогда не блокируется, независимо от состояния сервера.
- **Архитектура**: cloud задача (core 0, приоритет 0, стек 8KB) выполняет все HTTP-запросы, backoff, управление `_client`. Основной loop вызывает `update()` — который копирует телеметрию через mutex (~2 мкс), читает очереди команд/настроек, вызывает callbacks. Задержка — ноль.
- **Связь loop↔cloud**: телеметрия — mutex (запись из loop, чтение из cloud); команды и настройки — FreeRTOS очереди (cloud→loop, неблокирующее чтение).
- **Callbacks** `onCommand`/`onSettings` вызываются из контекста основного loop — безопасно, без race conditions.
- **Ресурсы**: ~16KB heap (8KB стек задачи + 7KB очереди + 1KB overhead).
- Публичный API идентичен — **никаких изменений в других файлах**.

### CloudManager.h — _client.stop() только при ошибках
`8d9caea`

- Предыдущая версия вызывала `_client.stop()` перед каждым запросом, что заставляло делать новый TLS handshake каждый раз (2-5 сек overhead). Web-интерфейс с SD карты начал притормаживать, система зависала.
- Теперь `_client.stop()` вызывается **только при `errorCount > 0`** (предыдущий запрос завершился ошибкой = мёртвое TCP соединение). При успехе соединение переиспользуется с нулевой задержкой.

### CloudManager.h — Предотвращение 3-минутного зависания loop
`c302901`

- **Причина**: при недоступности сервера TCP ретрансмиссии на переиспользуемом мёртвом соединении блокировали loop на 1→2→4→8→16 сек суммарно до 3 минут.
- **Решение**: `_client.stop()` перед `http.begin()` (закрывает мёртвое TCP), экспоненциальный backoff при ошибках (интервалы: 2→4→8→16→32 сек, макс. множитель x5), обновление lastCheckMs даже при ошибке.
- Добавлено логирование backoff: `[Cloud] Backoff: errorCount=N, next interval=X ms`.

### CloudManager.h + api.php — Fix ложного errorCount от settings check
`dabe4f6`

- `checkSettings()` возвращал `false` при `onSettings == nullptr` (callback никогда не подключался в проекте). Cloud задача считала это сетевой ошибкой → `errorCount = 1` каждую минуту.
- Исправлено: при `onSettings == nullptr` возвращается `true` (не ошибка, фича не используется). Ложный backoff убран.
- `api.php` GET settings не возвращал `settings_last_update` → ESP32 не могла определить новизну настроек → механизм cloud→device settings был мёртв.
- Исправлено: добавлено `settings_last_update` в ответ GET settings.

### Анализ: LOOP Slow 56-126 мс — не является проблемой
Исследование, без изменений кода

- `[LOOP] Slow: 56-126 ms` появляется ~2.5 раза/сек — это нормально для контроллера.
- Причина: `buildTelemetryJson()` вызывается каждый loop (~150 раз/сек), делает 60+ конкатенаций String + `logger.readNewLog()` открывает SD-файл. На слабых итерациях совпадает с обновлением DS18B20/BME280.
- 56-126 мс не влияет на работу: процессы идут с секундными интервалами, LCD раз в 500 мс.
- NetMgr, CloudManager и MEM check — выполняются в отдельных FreeRTOS задачах на core 0, не блокируют loop на core 1.
- Если потребуется ускорить — вызывать `buildTelemetryJson()` раз в 2 сек вместо каждого loop.

### AppNetwork.h/cpp + BuhloWar.ino — Fix Kernel Panic при загрузке от раннего HTTP запроса
`5041d94`

- **Причина**: NetworkTask запускается на core 0 до `processEngine.begin()` (строка 188 vs 271 в setup). Если браузер успевал сделать запрос в это окно (~1-2 сек), `processEngine->getSensorData()` обращался к `sensorAdapter = nullptr` → Core 0 panic (LoadProhibited).
- **Решение**: добавлен флаг `systemReady` в AppNetwork. Все вызовы `server->handleClient()` защищены проверкой `systemReady`. API handlers недоступны до полной инициализации системы.
- `appNetwork.setSystemReady(true)` вызывается в setup() после **всей** инициализации (строка 292) — после `processEngine.begin()`, создания всех меню и LCD.
- Защищены все точки вызова `handleClient()`: `update()`, `beginNetwork()`, `connectToWiFi()` (обе сети), `checkInternet()`.

### Документация: REF TSAR/REF АД и коррекция давления в TELO
Вопросы при тестировании Стандарт метода:

- **REF TSAR** (`rtsarM`) и **REF АД** (`adPressM`) в WEB мониторинге — это расчётные значения, зафиксированные **один раз** при входе в TELO (`rtsarM < 0.1`). Не меняются весь процесс, ни при залётах, ни при переходах NASEBYA → TELO. Обнуляются только при сбросе/начале новой колонны. Одинаковы для Стандарт и Шпора.
- **Коррекция давления** `(data.pressure - adPressM) * 0.0278` — применяется в обоих методах:
  - **Шпора**: учитывается для delta (снижение скорости) и hysteresis (залёт).
  - **Стандарт**: учитывается только для hysteresis (залёт → NASEBYA или finishTelo). Delta нет, так как в Стандарте нет механизма плавного снижения скорости — только бинарное решение "залёт / не залёт".
  - При росте давления (фронт с низким уходит): пороги повышаются → залёт позже. При падении: пороги снижаются → залёт раньше.

### ProcessEngine.cpp — Диагностика: лог cycleLim и bodyValveNC при старте TELO
`07d5cec`

- Добавлена печать обоих переменных в лог при старте ТЕЛО для диагностики бага (SPORA метод активируется при `cycleLim==3` вместо ожидаемого `cycleLim==1`).
- Формат: `TELO Start. Method: SPORA (cycleLim=3, bodyValveNC=true)`.

---

## 2026-04-03

### ProcessEngine.cpp — Пересчёт оставшегося времени ТЕЛО (Шпора)
`02372fa`

- Старая формула `(predictVol / speedShpora) - elapsedSec` завышала оставшееся время при каждом снижении скорости отбора, т.к. предполагала что текущая (сниженная) скорость была с самого начала.
- Новая формула `(predictVol - bodyVolDone) / speedShpora` правильно считает остаток объёма при текущей скорости. `bodyVolDone` аккумулируется на фактической скорости, поэтому расчёт всегда корректен.

### BuhloWar.ino, help.html — Обновление рабочих файлов
`4052e02`

- Обновлён `help.html` — переописан для новичков, простой язык, пошаговая инструкция.
- Мелкое исправление в `BuhloWar.ino`.

### index.html — Мелкое исправление
`712a886`

---

## 2026-03-31

### cloud/index.html — Калибровка из облачного интерфейса
`f8e81c2`, `704f23a`

- Добавлена поддержка команд калибровки клапанов через облачный режим (`cloud/index.html`).
- Исправлен формат `params` для команд калибровки — корректная передача параметров через облако.

### index.html — Восстановление блока ТЕЛО в мониторинге
`f3676ee`

- Восстановлены потерянные изменения блока ТЕЛО: объединены ПРОГНОЗ и ОТОБРАНО в единый формат `--/-- мл` по аналогии с блоком ГОЛОВЫ.
- Удалены дублирующие строки, заменены `bodyPredictEl`/`bodyVolEl` на `bodyTotalEl`/`bodyDoneEl`.

### AppNetwork.cpp — Удалены orphan реализации Telegram-методов
`72d7014`

- Удалены реализации `queueMessage`, `isTelegramReady`, `sendTelegramNow`, `processMessageQueue` — остались без объявлений в `.h` после чистки Telegram-зависимости (вызывали ошибки компиляции).

### CloudManager.h — Fix Kernel Panic от фрагментации кучи
`fa52998`

- `WiFiClientSecure` стал полем класса (`_client`) вместо локальной переменной в каждом методе.
- Ранее каждый вызов `sendTelemetry()`/`checkCommands()`/`checkSettings()` создавал новый TLS контекст (~20KB), вызывая фрагментацию кучи и Kernel Panic.
- Инициализация через `ensureClient()` — один раз при первом вызове.

### AppNetwork.h / AppNetwork.cpp — Удаление зависимости UniversalTelegramBot
`fa52998`

- `#include <UniversalTelegramBot.h>` закомментирован.
- Убраны: создание `bot`, загрузка `TELEGRAM_CERTIFICATE_ROOT` (~1.5KB RAM), очередь сообщений Telegram. Экономия ~20KB RAM.

### ValveCalMenu.h — Мастер калибровки: ввод объёма целыми числами
`fa52998`

- Шаг изменён с 0.1 на 1 (целые мл).
- `enteredVolume` инициализируется из текущего `cap` при переходе на шаг ввода (оператор редактирует, а не вводит с нуля).

### index.html — Мастер калибровки: целые числа + фикс сброса
`fa52998`

- Шаг +1/-1 мл вместо 0.1.
- Значение инициализируется из `cap` в настройках.
- Добавлен флаг `_lastInputStep` для защиты от сброса при обновлении статуса.

### ProcessEngine.cpp — NEXT_STAGE заблокирован на этапе VALVE_CAL
`b8faf64`

- Баг: блок `if (currentStage == VALVE_CAL) { return OK; }` стоял ДО обработчика `NEXT_STAGE` и глотал команду кнопки ДАЛЕЕ.
- Обработчик `NEXT_STAGE` перенесён перед блоком `VALVE_CAL`.
- Добавлен лог `[WebCmd] NEXT_STAGE received, currentStage=X` для диагностики.

### ProcessEngine.cpp — Команды калибровки из Web перехватывались
`362da00`

- Команды `CALIB_START_DRY`, `CALIB_START_CAPACITY`, `CALIB_CANCEL` перехватывались ранним `return` в блоке `VALVE_CAL`.
- Обработчики перенесены ДО проверки текущего этапа.

### index.html — Калибровка из Web + блок ТЕЛО мониторинг
`362da00`, `b49ec3a`

- Блок ТЕЛО: добавлен расчёт/факт (`--/-- мл`), убраны дублирующие ОТОБРАНО и ПРОГНОЗ.
- Мастер калибровки: fetch-запросы через `getCloudCommandUrl()` (работает через облако и локально с SD-карты).
- Автоматическое закрытие окна мастера через 2 сек после расчёта пропускной способности.
- Добавлена проверка TSA лимита с уведомлением и звуком (флаг `prevTsaAlarmState`).

---

## 2026-03-29

### index.html — Мониторинг: блок АД перемещён внутрь карточки с диаграммой
`05186ee`, `a7537a3`

- Давление (АД) перемещено из отдельного блока внутрь карточки с температурной диаграммой (справа от температур).
- Инфопанель: убрано давление из верхней панели (теперь в карточке), layout `grid-cols-5`.

### index.html — Мобильная адаптивность через CSS media queries
`fd4c34d`, `01db37f`

- Телефон (портрет): 1 колонка меню, компактные элементы.
- Телефон (ландшафт): компактный режим.
- Планшет: увеличенные элементы.
- ПК: широкий контейнер (1024px).
- Большой монитор: максимальная ширина (1280px).
- Исправлена адаптивность для портретной и ландшафтной ориентации.

### index.html — Мелкие фиксы веб-интерфейса
`8e6256f`, `fa464f2`

- Null guard для `pressure-value` (updateUI падал без элемента).
- Облако показывало «-1 сек назад» — исправлено через `Math.max(0, floor(...))`.

---

## 2026-03-28

### CloudManager.h — Оптимизация: ротация запросов (один за вызов)
`f83ecef`

- Максимальная блокировка loop снижена с 6 сек до 2 сек.
- Интервал проверки settings увеличен с 30 сек до 60 сек.
- Удалён неиспользуемый `ProcessConfigs.h` (дубликат структур).

### BuhloWar.ino — LCD обновление: интервал 500 мс
`595eb2d`

- Снижена нагрузка на I2C шину в 2.5 раза (было 200 мс). 2 обновления/сек достаточно для процесса.

---

## 2026-03-25

### help.html — Переописание для новичков
`e9b70f9`

- Полностью переписан `help.html` — простой язык, пошаговая инструкция для начинающих.

### Множество файлов — Fix GOLOVY_OK loop, LCD кнопки, cloud logs
`8cff9f5`

- Исправлен зацикленный GOLOVY_OK.
- Исправлены кнопки на LCD.
- Добавлены облачные логи (`cloud/api.php`, `AppNetwork.cpp`, `SDLogger.h`).

---

## 2026-03-24

### cloud/index.html, AppNetwork.cpp, menu_main.h — Звуковые уведомления
`584f1ea`

- Добавлен звуковой сигнал при срабатывании тревоги (W/A/X на LCD, safety_detail).

### Множество файлов — Оптимизация Шпора + первая крупная загрузка проекта
`e24cfc1`

- Оптимизация клапана Шпора: `minOpenTime`, снижение износа, мин. скорость 300 мл/ч.
- Расширенное логирование, GOLOVY_OK fix, LCD статус сети.
- Размер лога увеличен до 100KB.
- Загружены все основные файлы проекта: `ProcessEngine.cpp/.h`, `CloudManager.h`, `OutputManager.cpp/.h`, `SensorAdapter.cpp/.h`, `SensorManager.cpp/.h`, `ValveCalMenu.h`, `SetPwAsMenu.h`, `SDLogger.h`, `ProcessCommon.h`, `AppNetwork.h/.cpp`, `BuhloWar.ino`, `menu_*.h`, `config.h`, `preferences.cpp/.h`, `common.h`.
- Загружены файлы Android-приложения (`android/BuhloWarApp/`).
- Облачные скрипты (`cloud/api.php`, `cloud/index.html`).

---

## 2026-03-23

### cloud/index.html — Статус облака в баннере
`913e399`

- Статус подключения к облаку перемещён в баннер — всегда виден. Локальный режим отображается серым.

### CloudManager.h — Revert: WiFiClient reuse вызывал watchdog crash
`7073b01`

- Отменена попытка переиспользования WiFiClient (вызывала сброс watchdog).
- Вернуто создание нового клиента для каждого запроса.

### cloud/ — Оптимизация загрузки веб-интерфейса
`0bd9533`

- Убран цикл повторных попыток чтения с SD-карты, ускоряющий загрузку.
