Vlad-alco/BuhloWar/AppNetwork.cpp

#include "AppNetwork.h"
#include "config.h"
// Подключаем ProcessEngine, чтобы брать из него данные
#include "ProcessEngine.h" 
#include "preferences.h"
#include "SDLogger.h"
#include <freertos/FreeRTOS.h>
#include <freertos/task.h>
#include <freertos/queue.h>
#include <freertos/semphr.h>
#include "SensorManager.h"
#include "SimSensors.h"
// Подключаем внешний объект логера
extern SDLogger logger;
// Внешний мьютекс для SD карты (создаётся в .ino)
extern SemaphoreHandle_t sdMutex;
// Внешняя очередь команд (создаётся в .ino)
extern QueueHandle_t commandQueue;

// === ИНИЦИАЛИЗАЦИЯ SD КАРТЫ (отдельная функция) ===
bool AppNetwork::initSD() {
    SPI.begin(SD_SPI_SCK, SD_SPI_MISO, SD_SPI_MOSI, SD_SPI_CS);
    Serial.println("[NetMgr] Mounting SD Card...");

    if(!SD.begin(SD_SPI_CS)) {
        Serial.println("[NetMgr] SD Card Mount FAILED!");
        sdInitialized = false;
        return false;
    }

    Serial.println("[NetMgr] SD Card Mounted OK.");
    sdInitialized = true;
    return true;
}

// === РАННИЙ ЗАПУСК WEBSERVER (В AP РЕЖИМЕ) ===
// Вызывается сразу после initSD() в setup()
// WebServer доступен по 192.168.4.1 даже до подключения к WiFi
void AppNetwork::startWebServerEarly() {
    if (webServerStarted) return;  // Уже запущен
    
    // Запускаем AP режим для раннего доступа к Web
    Serial.println("[NetMgr] Starting AP mode for early Web access...");
    
    IPAddress local_IP(192, 168, 4, 1);
    IPAddress gateway(192, 168, 4, 1);
    IPAddress subnet(255, 255, 255, 0);
    
    if (!WiFi.softAPConfig(local_IP, gateway, subnet)) {
        Serial.println("[NetMgr] AP Config FAILED!");
        return;
    }
    
    if (!WiFi.softAP(AP_SSID, AP_PASS, AP_CHANNEL)) {
        Serial.println("[NetMgr] AP Start FAILED!");
        return;
    }
    
    // Запускаем DNS сервер (Captive Portal)
    if (dnsServer) {
        dnsServer->stop();
        delete dnsServer;
    }
    dnsServer = new DNSServer();
    dnsServer->start(53, "*", WiFi.softAPIP());
    
    // Создаём и настраиваем WebServer
    if (server) {
        server->stop();
        delete server;
    }
    server = new WebServer(80);
    
    // Регистрируем обработчики API
    server->on("/api/status", [this]() { handleApiStatus(); });
    server->on("/api/command", HTTP_POST, [this]() { handleApiCommand(); });
    server->on("/api/settings", HTTP_POST, [this]() { handleApiSettings(); });
    server->on("/api/calcvalve", HTTP_POST, [this]() { handleCalcValve(); });
    server->on("/api/saveprofile", HTTP_POST, [this]() { handleSaveProfile(); });
    server->on("/api/listprofiles", HTTP_GET, [this]() { handleListProfiles(); });
    server->on("/api/loadprofile", HTTP_POST, [this]() { handleLoadProfile(); });
    server->on("/api/logs", HTTP_GET, [this]() {
        String logContent = logger.readLastLog();
        server->send(200, "text/plain", logContent);
    });

    // Главная страница
    // sdMutex НЕ используется: serveStatic() (строка ниже) тоже читает SD
    // без мьютекса и работает стабильно. Мьютекс нужен только для записи
    // (logger.log на Core 1). Чтение — thread-safe на уровне ESP32 SD библиотеки.
    server->on("/", HTTP_GET, [this]() {
        // SD.open с retry
        File file;
        for (int retry = 0; retry < 3; retry++) {
            file = SD.open("/www/index.html", "r");
            if (file) break;
            delay(10);
        }
        
        if (file) {
            server->streamFile(file, "text/html");
            file.close();
        } else {
            server->send(404, "text/plain", "File Not Found: index.html");
        }
    });

    // Статика с кешированием
    server->serveStatic("/", SD, "/www/", "max-age=86400");

    server->onNotFound([this]() {
        server->send(404, "text/plain", "Not Found");
    });
    
    server->begin();
    webServerStarted = true;
    networkMode = NetworkMode::AP_MODE;
    
    Serial.println("[NetMgr] WebServer started (AP mode, IP: 192.168.4.1)");
    Serial.println("[NetMgr] Connect to WiFi: " + String(AP_SSID));
    logger.log("WebServer: AP mode started");
}

// === ОСНОВНАЯ ИНИЦИАЛИЗАЦИЯ (БЕЗ БЛОКИРОВКИ) ===
void AppNetwork::begin(int checkIntervalMinutes) {
    // Защита от нулевого интервала (минимум 1 минута)
    if (checkIntervalMinutes < 1) checkIntervalMinutes = 1;
    checkIntervalMs = checkIntervalMinutes * 60000;
    Serial.printf("[NetMgr] Check interval: %d min (%d ms)\n", checkIntervalMinutes, checkIntervalMs);

    // 1. SD карта уже инициализирована (initSD вызван раньше)
    if (!sdInitialized) {
        Serial.println("[NetMgr] SD not initialized! Cannot load WiFi config.");
        return;
    }

    // 2. Чтение конфигурации WiFi
    if (!loadConfigFromSD()) {
        Serial.println("[NetMgr] WiFi config not found. AP mode only.");
        return;
    }
    
    // 3. WebServer должен быть уже запущен через startWebServerEarly()
    if (!webServerStarted) {
        Serial.println("[NetMgr] WARNING: WebServer not started! Call startWebServerEarly() first.");
        startWebServerEarly();
    }
    
    // 4. Пробуем подключиться к WiFi (с повторными попытками)
    Serial.println("[NetMgr] Trying to connect to WiFi...");
    
    // === Увеличенный таймаут для холодного старта ===
    // При Power On WiFi радио требует больше времени на инициализацию
    // 3 попытки по 5 сек = до 15 сек максимум
    // При подключении к новой точке доступа ESP32 может требовать больше времени
    // Переменная для логирования — какой SSID реально подключился
    String connectedSSID = ssid1;

    bool connected = false;
    // === Попытка подключения к SSID1 ===
    for (int attempt = 0; attempt < 3 && !connected; attempt++) {
        Serial.printf("[NetMgr] WiFi connect attempt %d/3 (SSID1: %s)\n", attempt + 1, ssid1.c_str());

        // === Безопасный сброс WiFi перед новой попыткой ===
        // disconnect(false) — отключиться от STA, но НЕ выключать WiFi радио.
        // disconnect(true) ВЫКЛЮЧАЕТ WiFi полностью (WIFI_OFF), что УБИВАЕТ AP режим,
        // который уже запущен через startWebServerEarly(). WebServer и DNS при этом
        // остаются привязаны к несуществующему интерфейсу → Kernel Panic при обращении.
        // WiFi.mode(WIFI_AP_STA) — гарантирует dual режим (AP+STA), AP остаётся живым.
        WiFi.disconnect(false);
        WiFi.mode(WIFI_AP_STA);
        delay(100);  // Короткая пауза для применения режима

        WiFi.begin(ssid1.c_str(), pass1.c_str());
        
        int tries = 0;
        while (WiFi.status() != WL_CONNECTED && tries < 50) {  // 5 сек на попытку
            delay(100);
            if (server && systemReady) server->handleClient();
            yield();
            tries++;
        }
        
        if (WiFi.status() == WL_CONNECTED) {
            connected = true;
        }
    }

    // === Попытка подключения к SSID2 (если SSID1 не удалось и SSID2 задан) ===
    if (!connected && ssid2.length() > 0) {
        Serial.printf("[NetMgr] SSID1 failed. Trying SSID2: %s\n", ssid2.c_str());
        connectedSSID = ssid2;  // Запоминаем для логирования

        for (int attempt = 0; attempt < 3 && !connected; attempt++) {
            Serial.printf("[NetMgr] WiFi connect attempt %d/3 (SSID2: %s)\n", attempt + 1, ssid2.c_str());

            // Безопасный сброс перед переключением на другую сеть
            WiFi.disconnect(false);
            WiFi.mode(WIFI_AP_STA);
            delay(100);

            WiFi.begin(ssid2.c_str(), pass2.c_str());
            
            int tries = 0;
            while (WiFi.status() != WL_CONNECTED && tries < 50) {  // 5 сек на попытку
                delay(100);
                if (server && systemReady) server->handleClient();
                yield();
                tries++;
            }
            
            if (WiFi.status() == WL_CONNECTED) {
                connected = true;
            }
        }
    }
    
    if (WiFi.status() == WL_CONNECTED) {
        wifiConnected = true;
        networkMode = NetworkMode::STA_MODE;
        
        // === ВАЖНО: НЕ отключаем AP режим! ===
        // Двойной режим (AP+STA) обеспечивает无缝 переход
        // 192.168.4.1 всегда доступен, 192.168.1.x когда WiFi подключен
        // Это решает проблему долгой загрузки при переключении
        Serial.println("[NetMgr] WiFi connected! (AP+STA dual mode)");
        
        Serial.print("[NetMgr] STA IP: "); Serial.println(WiFi.localIP());
        Serial.print("[NetMgr] AP IP: "); Serial.println(WiFi.softAPIP());
        logger.log("WiFi: Connected to " + connectedSSID + " (dual mode)");
        
        // Проверяем интернет (неблокирующе)
        online = checkInternet();
        
        if (online) {
            // Telegram ОТКЛЮЧЁН — не инициализируем
            // client.setCACert(TELEGRAM_CERTIFICATE_ROOT);
            // if (tgToken.length() > 0) { bot = new UniversalTelegramBot(tgToken, client); }
            
            // NTP синхронизация (неблокирующе)
            syncNTP();
            
            Serial.println("[NetMgr] Internet OK. NTP enabled.");
            
            // Telegram disabled
            // String msg = "System " + String(FIRMWARE_VERSION) + " started. IP: " + WiFi.localIP().toString();
            // queueMessage(msg);
        } else {
            Serial.println("[NetMgr] No internet. Web only mode.");
        }
        
        logger.log("Network: STA mode, IP: " + WiFi.localIP().toString());
        
    } else {
        // WiFi не подключился - остаёмся в AP режиме (Web уже работает!)
        Serial.println("[NetMgr] WiFi connection failed. Staying in AP mode.");
        Serial.println("[NetMgr] Web interface: http://192.168.4.1");
        logger.log("WiFi: Connection failed, AP mode");
        // WebServer уже работает в AP режиме!
    }
    
    networkInitialized = true;
}

// === ПОШАГОВЫЙ РЕКОННЕКТ (Причина №2) ===
// startReconnect() — инициализация переменных для пошагового реконнекта.
// Вызывается один раз, когда решено начинать попытки подключения.
void AppNetwork::startReconnect() {
    reconnecting = true;
    reconnectAttempt = 0;
    reconnectSSID = 1;  // Начинаем с первой сети
    Serial.println("[NetMgr] Starting incremental reconnect (SSID1, attempt 1)...");
}

// tryReconnectOnce() — делает ровно 1 попытку подключения к текущей SSID.
// Блокировка: максимум ~1.5 сек (15 итераций × 100мс).
// Возвращает true если подключился, false если нет.
bool AppNetwork::tryReconnectOnce() {
    // Определяем, какую сеть пробуем в этой попытке
    const String& ssid = (reconnectSSID == 1) ? ssid1 : ssid2;
    const String& pass = (reconnectSSID == 1) ? pass1 : pass2;

    Serial.printf("[NetMgr] Reconnect try: %s (attempt %d/3)\n",
                  reconnectSSID == 1 ? "SSID1" : "SSID2", reconnectAttempt + 1);

    WiFi.begin(ssid.c_str(), pass.c_str());

    // Ждём подключения: 15 итераций × 100мс = 1.5 сек максимум
    int tries = 0;
    while (WiFi.status() != WL_CONNECTED && tries < 15) {
        delay(100);
        // handleClient каждые 5 итераций (500мс) — WebServer не теряет отзывчивость
        if (tries % 5 == 0 && server && systemReady) server->handleClient();
        yield();
        tries++;
    }

    if (WiFi.status() == WL_CONNECTED) {
        wifiConnected = true;
        return true;
    }

    // Не подключилось — продвигаем счётчик
    reconnectAttempt++;

    if (reconnectAttempt >= 3) {
        // 3 попытки текущей SSID исчерпаны
        reconnectAttempt = 0;
        if (reconnectSSID == 1 && ssid2.length() > 0) {
            // Переходим ко второй SSID
            reconnectSSID = 2;
            Serial.println("[NetMgr] SSID1 exhausted. Switching to SSID2.");
        } else {
            // Все сети исчерпаны — реконнект провален
            Serial.println("[NetMgr] All reconnect attempts failed. Switching to AP...");
            resetReconnect();
            wifiLostTime = 0;
            if (startAPMode()) {
                networkMode = NetworkMode::AP_MODE;
            } else {
                networkMode = NetworkMode::OFFLINE;
            }
        }
    }
    return false;
}

// resetReconnect() — сброс всех переменных пошагового реконнекта.
// Вызывается при успешном подключении или при полном отказе (переход в AP/OFFLINE).
void AppNetwork::resetReconnect() {
    reconnecting = false;
    reconnectAttempt = 0;
    reconnectSSID = 1;
}

// === АСИНХРОННАЯ ПЕРЕПОДКЛЮЧЕННАЯ К WIFI (начальное подключение при старте) ===
// Вызывается из beginNetwork() один раз при запуске системы.
// Здесь блокировка допустима — WebServer ещё не обрабатывает пользовательские запросы
// (systemReady = false, API handlers заблокированы).
bool AppNetwork::connectToWiFi() {
    // Пробуем первую сеть (до 3 раз, 15 итераций × 100мс = 1.5 сек на попытку)
    for (int i = 0; i < 3; i++) {
        Serial.printf("[NetMgr] Try %s (Attempt %d)\n", ssid1.c_str(), i+1);
        WiFi.begin(ssid1.c_str(), pass1.c_str());
        
        int tries = 0;
        while (WiFi.status() != WL_CONNECTED && tries < 15) {
            delay(100);
            // handleClient каждые 5 итераций — WebServer не подвисает
            if (tries % 5 == 0 && server && systemReady) server->handleClient();
            yield();
            tries++;
        }
        
        if (WiFi.status() == WL_CONNECTED) return true;
        if (server && systemReady) server->handleClient();
        yield();
    }
    
    // Пробуем вторую сеть
    if (ssid2.length() > 0) {
        for (int i = 0; i < 3; i++) {
            Serial.printf("[NetMgr] Try %s (Attempt %d)\n", ssid2.c_str(), i+1);
            WiFi.begin(ssid2.c_str(), pass2.c_str());
            
            int tries = 0;
            while (WiFi.status() != WL_CONNECTED && tries < 15) {
                delay(100);
                if (tries % 5 == 0 && server && systemReady) server->handleClient();
                yield();
                tries++;
            }
            
            if (WiFi.status() == WL_CONNECTED) return true;
            if (server && systemReady) server->handleClient();
            yield();
        }
    }
    
    return false;
}

// === ЗАПУСК ТОЧКИ ДОСТУПА (AP MODE) ===
bool AppNetwork::startAPMode() {
    Serial.println("[NetMgr] Starting AP Mode...");
    Serial.print("[NetMgr] SSID: "); Serial.println(AP_SSID);
    Serial.print("[NetMgr] IP: "); Serial.println(AP_IP_ADDR);
    
    // Настройка IP адреса
    IPAddress local_IP(192, 168, 4, 1);
    IPAddress gateway(192, 168, 4, 1);
    IPAddress subnet(255, 255, 255, 0);
    
    if (!WiFi.softAPConfig(local_IP, gateway, subnet)) {
        Serial.println("[NetMgr] AP Config FAILED!");
        return false;
    }
    
    // Запуск точки доступа
    if (!WiFi.softAP(AP_SSID, AP_PASS, AP_CHANNEL)) {
        Serial.println("[NetMgr] AP Start FAILED!");
        return false;
    }
    
    Serial.println("[NetMgr] AP Mode started successfully!");
    
    // DNS сервер (Captive Portal)
    if (dnsServer) {
        dnsServer->stop();
        delete dnsServer;
    }
    dnsServer = new DNSServer();
    dnsServer->start(53, "*", WiFi.softAPIP());
    Serial.println("[NetMgr] DNS Server started (Captive Portal)");
    
    // WebServer должен быть уже запущен через startWebServerEarly()
    if (!webServerStarted) {
        Serial.println("[NetMgr] ERROR: WebServer not started!");
        return false;
    }
    
    logger.log("Network: AP Mode");
    return true;
}

// === ПОЛУЧЕНИЕ РЕЖИМА СЕТИ ===
NetworkMode AppNetwork::getNetworkMode() {
    return networkMode;
}

// === ФЛАГ ПЕРЕХОДА AP→STA (сбрасывается после чтения) ===
bool AppNetwork::didSwitchToSTA() {
    if (switchedToSTA) {
        switchedToSTA = false;  // Сброс после чтения
        return true;
    }
    return false;
}

// === СИМВОЛ СЕТИ ДЛЯ LCD ===
char AppNetwork::getNetworkSymbol() {
    switch (networkMode) {
        case NetworkMode::STA_MODE: return 'W';
        case NetworkMode::AP_MODE:  return 'A';
        default:                    return 'X';
    }
}


void AppNetwork::setEngine(ProcessEngine* engine, ConfigManager* cfgMgr) {
    this->processEngine = engine;
    this->configManager = cfgMgr;
}

void AppNetwork::setSystemReady(bool ready) {
    systemReady = ready;
    if (ready) {
        Serial.println("[NetMgr] System ready — API handlers enabled");
    }
}


void AppNetwork::update() {
    if (!server) return; 
    unsigned long now = millis();
    
    // === ЗАЩИТА: не обрабатываем HTTP до полной инициализации системы ===
    // Без этого processEngine->getSensorData() крашит (sensorAdapter = nullptr)
    // Время window: между startTask() и processEngine.begin() (~1-2 сек при загрузке)
    // =========================================================================
    if (!systemReady) {
        return;  // Браузер подождёт, запрос обработается после systemReady
    }
    
    // === ДИАГНОСТИКА ПАМЯТИ (каждые 5 минут) ===
    static unsigned long lastMemCheck = 0;
    if (now - lastMemCheck > 300000) {
        lastMemCheck = now;
        Serial.printf("[MEM] Free heap: %u bytes\n", ESP.getFreeHeap());
    }
    // ===========================================
    
    // === ПЕРВЫМ ДЕЛОМ: WebServer (самый приоритетный!) ===
    server->handleClient();
    
    // === DNS SERVER (всегда, если активен) ===
    // В dual mode (AP+STA) DNS нужен для AP интерфейса
    // 3 итерации вместо 10 — достаточно для отзывчивости, не перегружает CPU
    if (dnsServer) {
        for (int i = 0; i < 3; i++) {
            dnsServer->processNextRequest();
        }
    }
    
    // === ПЕРИОДИЧЕСКАЯ ПРОВЕРКА СЕТИ ===
    // В AP режиме проверяем чаще (каждые 10 сек), чтобы быстрее обнаружить
    // подключение WiFi в фоне. В STA режиме — по настроенному интервалу (минимум 30 сек).
    unsigned long safeInterval;
    if (networkMode == NetworkMode::AP_MODE) {
        safeInterval = 10000;  // 10 сек в AP режиме — быстрее обнаружим подключение
    } else {
        safeInterval = (checkIntervalMs > 30000) ? checkIntervalMs : 30000;
    }
    
    if (networkInitialized && (now - lastCheckTime > safeInterval || lastCheckTime == 0)) {
        lastCheckTime = now;
        
        // === ПЕРЕХОД AP → STA: WiFi подключился в фоне ===
        // Если при старте begin() не удалось подключиться за отведённое время,
        // но ESP32 в фоне всё-таки подключился к роутеру — переводим в STA режим.
        // Без этой проверки система навсегда оставалась в AP_MODE даже при
        // работающем WiFi (IP получен, веб-интерфейс доступен, но телеметрия не шлётся).
        if (networkMode == NetworkMode::AP_MODE) {
            if (WiFi.status() == WL_CONNECTED) {
                wifiConnected = true;
                networkMode = NetworkMode::STA_MODE;
                switchedToSTA = true;  // Сигнал для loop() — инициализировать CloudManager
                
                Serial.println("[NetMgr] WiFi connected in background! Switching AP -> STA mode.");
                Serial.print("[NetMgr] STA IP: "); Serial.println(WiFi.localIP());
                Serial.print("[NetMgr] AP IP: "); Serial.println(WiFi.softAPIP());
                logger.log("WiFi: Background connected -> STA mode (AP+STA dual)");

                // checkInternet() и syncNTP() НЕ вызываем здесь!
                // Они блокируют на 1-3 сек, а update() работает в том же потоке
                // что и WebServer (Core 0). Вызов отложен в следующий цикл update(),
                // где в блоке STA_MODE они выполнятся при периодической проверке.
                Serial.println("[NetMgr] Internet/NTP check deferred to next cycle.");
            }
        }
        
        if (networkMode == NetworkMode::STA_MODE) {
            // === Проверка WiFi ===
            if (WiFi.status() != WL_CONNECTED) {
                // --- Пошаговый реконнект (Причина №2) ---
                // Старый код: connectToWiFi() блокировал до 9 сек (6 попыток × 1.5 сек)
                // Новый код: 1 попытка за цикл update(), WebServer «дышит» между попытками.

                // Если реконнект ещё не начат — запускаем (с 3-сек защитной задержкой)
                if (!reconnecting) {
                    // Защита от «морганий» WiFi: ждём 3 сек перед началом реконнекта.
                    // Если WiFi вернётся сам за эти 3 сек — вообще не нужно реконнектиться.
                    if (wifiLostTime == 0) {
                        wifiLostTime = now;  // Запоминаем момент потери
                        Serial.println("[NetMgr] WiFi lost. Waiting 3s before reconnect...");
                    } else if (now - wifiLostTime >= 3000) {
                        // 3 секунды прошли, WiFi не вернулся — начинаем пошаговый реконнект
                        startReconnect();
                    }
                    // Пока ждём 3 сек — выходим, WebServer продолжит работать
                }

                // Если реконнект активен — делаем 1 попытку за этот цикл
                if (reconnecting) {
                    if (tryReconnectOnce()) {
                        // Подключение успешно!
                        Serial.println("[NetMgr] WiFi reconnected (incremental).");
                        resetReconnect();
                        wifiLostTime = 0;
                        // Не проверяем интернет здесь — он проверится
                        // в следующем цикле update() в блоке ниже
                    }
                    // Если не получилось — просто выходим, следующая попытка
                    // в следующем цикле update() (через ~30 сек или при следующей проверке)
                }
            } else {
                // WiFi подключен — сбрасываем состояние реконнекта на всякий случай
                if (reconnecting) {
                    resetReconnect();
                    wifiLostTime = 0;
                }
                if (wifiLostTime != 0) {
                    wifiLostTime = 0;
                    // WiFi вернулся сам (до начала реконнекта)
                }

                // === Статус интернета = WiFi connected (без блокировки) ===
                if (WiFi.status() == WL_CONNECTED) {
                    if (!online) {
                        online = true;
                        syncNTP();
                        Serial.println("[NetMgr] Internet restored (WiFi up).");
                    }
                } else if (online) {
                    online = false;
                    Serial.println("[NetMgr] Internet lost (WiFi down).");
                }
            }
        }
    }

    // === TELEGRAM ОТКЛЮЧЁН ===
    // if (processEngine && online) {
    //     const SystemStatus& status = processEngine->getStatus();
    //     const SensorData& sensors = processEngine->getSensorData(); 
    //     if (status.safety == SafetyState::WARNING_TSA || status.safety == SafetyState::EMERGENCY) {
    //         if (now - lastAlarmTgTime > 60000) {
    //             lastAlarmTgTime = now;
    //             String msg = "🔥 АВАРИЯ! TSA: " + String(status.currentTsa, 1) + "C (Limit: " + String(configManager->getConfig().tsaLimit) + "C)";
    //             sendMessage(msg);
    //         }
    //     }
    //     else if (status.safety == SafetyState::WARNING_BOX) {
    //         if (now - lastAlarmTgTime > 60000) {
    //             lastAlarmTgTime = now;
    //             String msg = "⚠️ ВНИМАНИЕ! Перегрев бокса: " + String(sensors.boxTemp, 1) + "C";
    //             sendMessage(msg);
    //         }
    //     }
    //     else {
    //         lastAlarmTgTime = 0;
    //     }
    // }
    // processMessageQueue();
}

// ================== API HANDLERS ==================

void AppNetwork::handleApiStatus() {
    if (!processEngine || !configManager) {
        server->send(500, "application/json", "{\"error\":\"Engine not linked\"}");
        return;
    }

    // Этап 4 (C2): читаем СТАТУС и КОНФИГ через потокобезопасные копии.
    // Web-задача крутится на ядре 0, процесс — на ядре 1; прямая ссылка на
    // общие структуры могла «порваться» под одновременной записью.
    SystemStatus status;                       // Локальная копия статуса
    processEngine->getStatusCopy(status);      // Снимок целиком (двойной буфер)
    SensorData sensors = processEngine->getSensorData(); // Копия датчиков (не ссылка!)
    SystemConfig cfg;                          // Локальная копия конфига
    configManager->getConfigCopy(cfg);

    // Формируем JSON вручную
    String json = "{";

    // --- Сеть и Время ---
    json += "\"online\":" + String(online ? "true" : "false") + ",";
    json += "\"network_mode\":\"" + String(getNetworkSymbol()) + "\",";
    json += "\"time\":" + String(status.processTimeSec) + ",";
    
    // --- Статус системы (Safety) ---
    int safetyCode = 0;
    String safetyText = "НОРМА";
    String safetyDetail = "";
    
    if (status.safety == SafetyState::WARNING_BOX) { 
        safetyCode = 1; 
        safetyText = "ВНИМАНИЕ: Перегрев"; 
        safetyDetail = "Температура корпуса: " + String(sensors.boxTemp, 1) + "C";
    }
    else if (status.safety == SafetyState::WARNING_TSA) { 
        safetyCode = 2; 
        safetyText = "АВАРИЯ: TSA"; 
        safetyDetail = "TSA: " + String(status.currentTsa, 1) + "C (лимит: " + String(configManager->getConfig().tsaLimit, 0) + "C)";
    }
    else if (status.safety == SafetyState::EMERGENCY) { 
        safetyCode = 3; 
        safetyText = "АВАРИЯ: VREAC"; 
        safetyDetail = "Температура: " + String(status.currentTsa, 1) + "C";
    }
    
    json += "\"safety_code\":" + String(safetyCode) + ",";
    json += "\"safety_text\":\"" + safetyText + "\",";
    json += "\"safety_detail\":\"" + safetyDetail + "\",";

    // --- Процесс ---
    json += "\"process\":" + String(processEngine->getActiveProcessType()) + ",";
    json += "\"stage\":\"" + status.stageName + "\",";

    // --- Датчики ---
    json += "\"tsa\":" + String(status.currentTsa) + ",";
    json += "\"tsar\":" + String(status.currentTsar) + ",";
    json += "\"aqua\":" + String(status.currentAqua) + ",";
    json += "\"tank\":" + String(status.currentTank) + ",";

    // === Этап 1: счётчики качества сигнала (медиана/гейт/stale) ===
    // Формат: "sig":{"tsa":[отбросы,подвисания],...} — счётчики монотонно
    // растут, веб показывает их как TSAR x/y. Счётчики живут в SensorManager
    // (ядро 1), веб-хендлер — на ядре 0. Чтение 32-битного выровненного
    // счётчика без блокировки безопасно: худшее — значение на один опрос
    // старее. Диагностика, не управляющие данные — синхронизация не нужна.
    {
        SensorManager* sm = SensorManager::getInstance();
        json += "\"sig\":{\"tsa\":[" + String((unsigned long)sm->getRejectedTotal(SENSOR_TSA)) + "," + String((unsigned long)sm->getStaleEpisodes(SENSOR_TSA)) + "]";
        json += ",\"aqua\":[" + String((unsigned long)sm->getRejectedTotal(SENSOR_AQUA)) + "," + String((unsigned long)sm->getStaleEpisodes(SENSOR_AQUA)) + "]";
        json += ",\"tsar\":[" + String((unsigned long)sm->getRejectedTotal(SENSOR_TSAR)) + "," + String((unsigned long)sm->getStaleEpisodes(SENSOR_TSAR)) + "]";
        json += ",\"tank\":[" + String((unsigned long)sm->getRejectedTotal(SENSOR_TANK)) + "," + String((unsigned long)sm->getStaleEpisodes(SENSOR_TANK)) + "]";
        json += "},";
    }

    // === Этап 2: состояние СИМУЛЯТОРА датчиков (панель «СИМУЛЯТОР» в вебе).
    // Объект "sim" отсутствует, когда SIM выключен — страницы обратно-совместимы
    // и показывают только кнопку запуска. state каналов — «физические» значения
    // симулятора (без аномалий; аномалии видны по маске "anom": бит на канал).
    {
        float simState[SimSensors::CH_COUNT];
        uint8_t simScen = 0, simMask = 0;
        float simSpd = 1.0f;
        unsigned long simT = 0;
        bool simDry = false, simAs = false;
        if (SimSensors::getInstance()->snapshot(simState, simScen, simSpd, simT, simMask, simDry, simAs)) {
            json += "\"sim\":{\"on\":1,\"scen\":" + String(simScen);
            json += ",\"speed\":" + String(simSpd, 0);
            json += ",\"t\":" + String(simT);
            json += ",\"anom\":" + String(simMask);
            // Этап 2.1: режим хода (dry: 1=СУХОЙ/0=РАБОЧИЙ) и тумблер авто-стопа (as)
            json += ",\"dry\":" + String(simDry ? 1 : 0);
            json += ",\"as\":" + String(simAs ? 1 : 0);
            json += ",\"ch\":[" + String(simState[0], 2) + "," + String(simState[1], 2) + "," + String(simState[2], 2) + "," + String(simState[3], 2) + "]},";
        }
    }
    
    // --- Крепость (Сессия 10: один знак после запятой — согласовано с уставкой 0.1%) ---
    json += "\"str_bak\":" + String(status.currentStrengthBak, 1) + ",";
    json += "\"str_out\":" + String(status.currentStrength, 1) + ",";
    json += "\"str_bak_valid\":" + String(status.strengthBakValid ? "true" : "false") + ",";
    json += "\"str_out_valid\":" + String(status.strengthOutValid ? "true" : "false") + ",";
    json += "\"pressure\":" + String(sensors.pressure * 0.75) + ",";
    json += "\"box_temp\":" + String(sensors.boxTemp) + ",";
    json += "\"humidity\":" + String(sensors.humidity, 1) + ",";
    json += "\"bmeWorking\":" + String(sensors.bmeStatus == SensorStatus::OK ? "true" : "false") + ",";
    
    // --- Калибровка датчиков ---
    json += "\"webCalibStatus\":" + String(status.webCalibStatus) + ",";
    json += "\"webCalibSensorName\":\"" + status.webCalibSensorName + "\",";

    // === RECT INFO ===
    json += "\"rectMethodName\":\"" + status.rectMethodName + "\",";
    json += "\"rectSubStage\":\"" + status.rectSubStage + "\",";
    json += "\"rectTimeRemaining\":" + String(status.rectTimeRemaining) + ",";
    json += "\"rectVolumeTarget\":" + String(status.rectVolumeTarget) + ",";
    json += "\"bodyMethodName\":\"" + status.bodyMethodName + "\",";
    json += "\"bodySpeed\":" + String(status.bodySpeed, 1) + ",";
    json += "\"bodyVolDone\":" + String(status.bodyVolDone, 1) + ",";
    json += "\"headsSpeed\":" + String(status.headsSpeed, 1) + ",";
    json += "\"headsSpeedCalc\":" + String(status.headsSpeedCalc, 1) + ",";
    json += "\"bodyCycle\":" + String(status.bodyCycle) + ",";
    
    // === Накопленный объём ===
    json += "\"headsVolDone\":" + String(status.headsVolDone, 0) + ",";
    json += "\"headsVolSub\":" + String(status.headsVolSub, 1) + ",";
    json += "\"headsVolTarget\":" + String(status.headsVolTarget) + ",";
    json += "\"finishingRemainSec\":" + String(status.finishingRemainSec) + ",";
    json += "\"stageTimeSec\":" + String(status.stageTimeSec) + ",";
    json += "\"alarmTimerSec\":" + String(status.alarmTimerSec) + ",";
    
    // === Статусы выходов ===
    json += "\"heaterOn\":" + String(processEngine->isHeaterOn() ? "true" : "false") + ",";
    json += "\"mixerOn\":" + String(processEngine->isMixerOn() ? "true" : "false") + ",";
    json += "\"waterValveOpen\":" + String(processEngine->isWaterValveOpen() ? "true" : "false") + ",";
    
    // === Референтные значения ===
    json += "\"rtsarM\":" + String(processEngine->getRtsarM(), 2) + ",";
    json += "\"adPressM\":" + String(processEngine->getAdPressM(), 1) + ",";
    
    // === Общий объём голов ===
    // Сессия 14: в ST при заданном ручном объёме показываем его (иначе шапка
    // «ГОЛОВЫ X/Y» показывает 10% АС, а реальная цель — ручная)
    float headsTotalTarget = cfg.headsTypeKSS ? (cfg.asVolume * 0.20f)
                                              : (cfg.headsManualMl > 0 ? (float)cfg.headsManualMl : (cfg.asVolume * 0.10f));
    json += "\"headsTotalTarget\":" + String((int)headsTotalTarget) + ",";

    // --- Настройки ---
    json += "\"power\":" + String(cfg.power) + ",";
    json += "\"heater\":" + String(cfg.heaterType) + ",";
    json += "\"cfg\": " + buildCfgJson();

    // --- Статус тестов клапанов ---
    json += ",\"headTest\":{";
    json += "\"active\":" + String(status.headTestActive ? "true" : "false") + ",";
    json += "\"remainingSec\":" + String(status.headTestRemainingSec) + ",";
    json += "\"totalSec\":" + String(status.headTestTotalSec);
    json += "}";
    json += ",\"bodyTest\":{";
    json += "\"active\":" + String(status.bodyTestActive ? "true" : "false") + ",";
    json += "\"remainingSec\":" + String(status.bodyTestRemainingSec) + ",";
    json += "\"totalSec\":" + String(status.bodyTestTotalSec);
    json += "}";
    json += ",\"testAwaitingInput\":" + String(status.testAwaitingInput ? "true" : "false");
    json += ",\"testAwaitingType\":\"" + status.testAwaitingType + "\"";

    // === СОСТОЯНИЕ МАСТЕРА КАЛИБРОВКИ ===
    json += ",\"calibWizard\":{";
    json += "\"valve\":" + String(status.calibWizard.valve) + ",";
    json += "\"step\":" + String(status.calibWizard.step) + ",";
    json += "\"isRunning\":" + String(status.calibWizard.isRunning ? "true" : "false") + ",";
    json += "\"remainingSec\":" + String(status.calibWizard.remainingSec) + ",";
    json += "\"totalSec\":" + String(status.calibWizard.totalSec) + ",";
    json += "\"volume\":" + String(status.calibWizard.volume, 1) + ",";
    json += "\"capacity\":" + String(status.calibWizard.capacity, 1);
    json += "}";
    
    json += "}";
    
    // === ЛОГИ: последние 30 строк из SD как JSON-массив ===
    // Добавляется в конец JSON, после calibWizard.
    // Сессия 9: было 10 строк / окно 1KB — старт этапа (4-6 строк подряд)
    // выталкивал важные записи (Stage change) из окна, а серии >10 строк
    // между опросами вообще не доходили до браузера. Теперь 30 строк / 4KB.
    // Использует getLastLogLinesJson() — читает ~4KB с SD, быстро.
    // Формат: ,"logs":["строка1","строка2",...]
    // Новые строки сверху (индекс 0), старые внизу.
    // Фронтенд (index_landscape_knob.html) поверх этого ведёт свой буфер на 50 строк.
    json = json.substring(0, json.length() - 1); // Убираем последнюю }
    json += ",\"logs\":" + logger.getLastLogLinesJson(30);
    json += "}";
    
    server->send(200, "application/json", json);
}

String AppNetwork::buildTelemetryJson() {
    if (!processEngine || !configManager) {
        return "{}";
    }

    // Этап 4 (C2): потокобезопасные копии статуса/конфига/датчиков (см. handleApiStatus)
    SystemStatus status;
    processEngine->getStatusCopy(status);
    SensorData sensors = processEngine->getSensorData();
    SystemConfig cfg;
    configManager->getConfigCopy(cfg);

    float headsTotalTarget = cfg.headsTypeKSS ? (cfg.asVolume * 0.20f)
                                              : (cfg.headsManualMl > 0 ? (float)cfg.headsManualMl : (cfg.asVolume * 0.10f));

    String json = "{";
    json += "\"time\":" + String(status.processTimeSec) + ",";
    json += "\"stage\":\"" + status.stageName + "\",";
    json += "\"process\":" + String(processEngine->getActiveProcessType()) + ",";
    json += "\"tsa\":" + String(status.currentTsa) + ",";
    json += "\"tsar\":" + String(status.currentTsar) + ",";
    json += "\"aqua\":" + String(status.currentAqua) + ",";
    json += "\"tank\":" + String(status.currentTank) + ",";
    json += "\"str_bak\":" + String(status.currentStrengthBak, 1) + ",";
    json += "\"str_out\":" + String(status.currentStrength, 1) + ",";
    json += "\"str_bak_valid\":" + String(status.strengthBakValid ? "true" : "false") + ",";
    json += "\"str_out_valid\":" + String(status.strengthOutValid ? "true" : "false") + ",";
    json += "\"safety\":" + String((int)status.safety) + ",";
    json += "\"pressure\":" + String(sensors.pressure * 0.75) + ",";
    json += "\"box_temp\":" + String(sensors.boxTemp) + ",";
    json += "\"humidity\":" + String(sensors.humidity, 1) + ",";
    json += "\"bmeWorking\":" + String(sensors.bmeStatus == SensorStatus::OK ? "true" : "false") + ",";
    json += "\"alarmTimerSec\":" + String(status.alarmTimerSec) + ",";
    json += "\"stageTimeSec\":" + String(status.stageTimeSec) + ",";
    json += "\"finishingRemainSec\":" + String(status.finishingRemainSec) + ",";
    json += "\"rectMethodName\":\"" + status.rectMethodName + "\",";
    json += "\"rectSubStage\":\"" + status.rectSubStage + "\",";
    json += "\"rectTimeRemaining\":" + String(status.rectTimeRemaining) + ",";
    json += "\"rectVolumeTarget\":" + String(status.rectVolumeTarget) + ",";
    json += "\"bodyMethodName\":\"" + status.bodyMethodName + "\",";
    json += "\"bodySpeed\":" + String(status.bodySpeed, 1) + ",";
    json += "\"bodyVolDone\":" + String(status.bodyVolDone, 1) + ",";
    json += "\"bodyCycle\":" + String(status.bodyCycle) + ",";
    json += "\"headsSpeed\":" + String(status.headsSpeed, 1) + ",";
    json += "\"headsSpeedCalc\":" + String(status.headsSpeedCalc, 1) + ",";
    json += "\"headsVolDone\":" + String(status.headsVolDone, 0) + ",";
    json += "\"headsVolSub\":" + String(status.headsVolSub, 1) + ",";
    json += "\"headsVolTarget\":" + String(status.headsVolTarget) + ",";
    json += "\"headsTotalTarget\":" + String((int)headsTotalTarget) + ",";
    json += "\"heaterOn\":" + String(processEngine->isHeaterOn() ? "true" : "false") + ",";
    json += "\"mixerOn\":" + String(processEngine->isMixerOn() ? "true" : "false") + ",";
    json += "\"waterValveOpen\":" + String(processEngine->isWaterValveOpen() ? "true" : "false") + ",";
    json += "\"running\":" + String(processEngine->isProcessRunning() ? "true" : "false") + ",";
    json += "\"rtsarM\":" + String(processEngine->getRtsarM(), 2) + ",";
    json += "\"adPressM\":" + String(processEngine->getAdPressM(), 1) + ",";
    json += "\"useHeadValve\":" + String(cfg.useHeadValve ? "true" : "false") + ",";
    json += "\"bodyValveNC\":" + String(cfg.bodyValveNC ? "true" : "false") + ",";
    json += "\"headsTypeKSS\":" + String(cfg.headsTypeKSS ? "true" : "false") + ",";
    json += "\"heaterType\":" + String(cfg.heaterType) + ",";
    json += "\"power\":" + String(cfg.power) + ",";
    json += "\"asVolume\":" + String(cfg.asVolume) + ",";
    json += "\"headOpenMs\":" + String(cfg.headOpenSec) + ",";
    json += "\"headCloseMs\":" + String(cfg.headCloseSec) + ",";
    json += "\"bodyOpenMs\":" + String(cfg.bodyOpenSec) + ",";
    json += "\"bodyCloseMs\":" + String(cfg.bodyCloseSec) + ",";
    json += "\"valve_head_capacity\":" + String(cfg.valve_head_capacity) + ",";
    json += "\"valve_body_capacity\":" + String(cfg.valve_body_capacity) + ",";
    json += "\"minOpenTime\":" + String(cfg.minOpenTime) + ",";
    json += "\"speedHeadCorr\":" + String(cfg.speedHeadCorr) + ",";
    json += "\"speedBodyCorr\":" + String(cfg.speedBodyCorr);
    json += ",";
    // Используем готовый buildCfgJson()
    json += "\"cfg\": " + buildCfgJson();
    
    // === ОТПРАВКА НОВЫХ ЛОГОВ В ОБЛАКО ===
    String newLogs = logger.readNewLog(lastLogSize);
    if (newLogs.length() > 0) {
        newLogs.replace("\\", "\\\\");
        newLogs.replace("\"", "\\\"");
        newLogs.replace("\n", "\\n");
        newLogs.replace("\r", "");
        json += ",\"new_logs\":\"" + newLogs + "\"";
    }
    // =========================================
    
    json += "}";
    
    return json;
}

void AppNetwork::handleApiCommand() {
    if (!server->hasArg("plain")) {
        server->send(400, "text/plain", "Bad Request");
        return;
    }

    String body = server->arg("plain");
    Serial.println("[API] Command: " + body);

    auto sendCmd = [](UiCommand cmd, int param = 0) {
        CommandMessage msg = { cmd, param };
        xQueueSend(commandQueue, &msg, 0);
    };
    
    auto getValveParam = [&body]() -> int {
        int idx = body.indexOf("\"valve\":");
        if (idx > 0) {
            int start = idx + 8;
            int end = body.indexOf(',', start);
            if (end == -1) end = body.indexOf('}', start);
            String valStr = body.substring(start, end);
            valStr.trim();
            return valStr.toInt();
        }
        return 0;
    };

    if      (body.indexOf("\"cmd\":\"START_DIST\"") > 0)        sendCmd(UiCommand::START_DIST);
    else if (body.indexOf("\"cmd\":\"START_RECT\"") > 0)        sendCmd(UiCommand::START_RECT);
    else if (body.indexOf("\"cmd\":\"STOP\"") > 0)              sendCmd(UiCommand::STOP_PROCESS);
    else if (body.indexOf("\"cmd\":\"STOP_TEST\"") > 0)         sendCmd(UiCommand::STOP_TEST);
    // === Сессия 20: ручное управление клапаном воды из веб-мониторинга ===
    // Действует только когда процесс не запущен (гвард в ProcessEngine::handleCommand):
    // сценарий — после IND-финала закрыть воду, оставленную открытой ради безопасности
    else if (body.indexOf("\"cmd\":\"WATER_OPEN\"") > 0)        sendCmd(UiCommand::MANUAL_VALVE_WATER_OPEN);
    else if (body.indexOf("\"cmd\":\"WATER_CLOSE\"") > 0)       sendCmd(UiCommand::MANUAL_VALVE_WATER_CLOSE);
    else if (body.indexOf("\"cmd\":\"FINISH_CALIBRATION\"") > 0) sendCmd(UiCommand::FINISH_CALIBRATION);
    else if (body.indexOf("\"cmd\":\"DIALOG_YES\"") > 0)        sendCmd(UiCommand::DIALOG_YES);
    else if (body.indexOf("\"cmd\":\"DIALOG_NO\"") > 0)         sendCmd(UiCommand::DIALOG_NO);
    else if (body.indexOf("\"cmd\":\"NEXT_STAGE\"") > 0)        sendCmd(UiCommand::NEXT_STAGE);
    else if (body.indexOf("\"cmd\":\"TEST_HEAD\"") > 0)         sendCmd(UiCommand::TEST_HEAD);
    else if (body.indexOf("\"cmd\":\"TEST_BODY\"") > 0)         sendCmd(UiCommand::TEST_BODY);
    else if (body.indexOf("\"cmd\":\"CALIB_START_DRY\"") > 0)   sendCmd(UiCommand::CALIB_START_DRY, getValveParam());
    else if (body.indexOf("\"cmd\":\"CALIB_START_CAP\"") > 0)   sendCmd(UiCommand::CALIB_START_CAPACITY, getValveParam());
    else if (body.indexOf("\"cmd\":\"CALIB_CANCEL\"") > 0)      sendCmd(UiCommand::CALIB_CANCEL);
    // === CALIB_SET_VOLUME: передаём измеренный объём (мл) для расчёта capacity ===
    else if (body.indexOf("\"cmd\":\"CALIB_SET_VOLUME\"") > 0) {
      // Извлекаем volume из JSON: {"cmd":"CALIB_SET_VOLUME","valve":1,"volume":15}
      int volIdx = body.indexOf("\"volume\":");
      int volume = 0;
      if (volIdx > 0) {
        int start = volIdx + 9;
        int end = body.indexOf(',', start);
        if (end == -1) end = body.indexOf('}', start);
        String volStr = body.substring(start, end);
        volStr.trim();
        volume = (int)volStr.toFloat();
      }
      sendCmd(UiCommand::CALIB_SET_VOLUME, volume);
    }
    else if (body.indexOf("\"cmd\":\"IDENTIFY_") > 0) {
        if      (body.indexOf("TSAR") > 0) sendCmd(UiCommand::IDENTIFY_TSAR);
        else if (body.indexOf("TANK") > 0) sendCmd(UiCommand::IDENTIFY_TANK);
        else if (body.indexOf("AQUA") > 0) sendCmd(UiCommand::IDENTIFY_AQUA);
        else if (body.indexOf("TSA") > 0)  sendCmd(UiCommand::IDENTIFY_TSA);
    }
    // === Этап 2: команды СИМУЛЯТОРА датчиков ===
    // Обрабатываются ПРЯМО здесь (ядро 0), без очереди UiCommand:
    // SimSensors — изолированный листовой модуль с короткими portMUX-
    // критсекциями, ProcessEngine и меню не затрагиваются. Гварды:
    //  - SIM_ON — только вне процесса и калибровки (иначе синтетика
    //    подменила бы показания работающей системы);
    //  - SIM_OFF — только вне процесса (внезапная смерть всех датчиков
    //    посреди процесса уводит движок в аварийные ветки);
    //  - сценарий/скорость/аномалии — в активном SIM когда угодно.
    // Состояние SIM НЕ пишется в EEPROM: после перезагрузки SIM всегда ВЫКЛ.
    else if (body.indexOf("\"cmd\":\"SIM_") > 0) {
        SimSensors* sim = SimSensors::getInstance();
        bool procRunning = processEngine && (processEngine->getActiveProcessType() != PROCESS_NONE);
        auto getIntP = [&body](const char* key, int defVal) -> int {
            String k = String("\"") + key + "\":";
            int p = body.indexOf(k);
            if (p < 0) return defVal;
            int s = p + k.length();
            int e = body.indexOf(',', s);
            if (e < 0) e = body.indexOf('}', s);
            return body.substring(s, e < 0 ? (int)body.length() : e).toInt();
        };
        auto getFloatP = [&body](const char* key, float defVal) -> float {
            String k = String("\"") + key + "\":";
            int p = body.indexOf(k);
            if (p < 0) return defVal;
            int s = p + k.length();
            int e = body.indexOf(',', s);
            if (e < 0) e = body.indexOf('}', s);
            return body.substring(s, e < 0 ? (int)body.length() : e).toFloat();
        };

        if (body.indexOf("\"cmd\":\"SIM_ON\"") > 0) {
            if (procRunning) { server->send(409, "text/plain", "Process running"); return; }
            SensorManager* sm = SensorManager::getInstance();
            for (int i = 0; i < SimSensors::CH_COUNT; i++) {
                if (sm->isCalibrating((SensorIndex)i)) { server->send(409, "text/plain", "Calibration running"); return; }
            }
            // Старт с текущих отфильтрованных температур (см. SimSensors::start):
            // синтетика продолжает с того, что видели датчики — гейт правдоподобия
            // не застревает на вечном отбросе после старта симуляции.
            float curTemps[SimSensors::CH_COUNT];
            curTemps[0] = sm->getTSA();  curTemps[1] = sm->getAQUA();
            curTemps[2] = sm->getTSAR(); curTemps[3] = sm->getTANK();
            sim->start((uint8_t)getIntP("scen", 0), curTemps);
        } else if (body.indexOf("\"cmd\":\"SIM_OFF\"") > 0) {
            if (procRunning) { server->send(409, "text/plain", "Stop process first"); return; }
            sim->stop();
            // Этап 2.1: ход сброшен к РАБОЧЕМУ (SimSensors::stop) — физика могла
            // отстать от логики в сухом ходе; ближайший update() OutputManager
            // пересинхронизирует пины с логическими состояниями.
            OutputManager::setSimDryRun(false);
        } else if (body.indexOf("\"cmd\":\"SIM_DRY\"") > 0) {
            // Этап 2.1: выбор хода — СУХОЙ (v:1) / РАБОЧИЙ (v:0).
            // Гварды: SIM активен и вне процесса (смена хода посреди процесса
            // делает непредсказуемым поведение нагрева/воды).
            if (procRunning) { server->send(409, "text/plain", "Stop process first"); return; }
            if (!sim->isActive()) { server->send(409, "text/plain", "SIM not active"); return; }
            bool d = getIntP("v", 0) != 0;
            sim->setDryRun(d);
            OutputManager::setSimDryRun(d);   // при выключении сухого хода — пересинк физики
            Serial.println(String("[SIM] Ход: ") + (d ? "СУХОЙ (выходы физически не переключаются)"
                                                            : "РАБОЧИЙ (реле/клапаны физические — ТОЛЬКО НА СТЕНДЕ)"));
        } else if (body.indexOf("\"cmd\":\"SIM_AUTOSTOP\"") > 0) {
            // Этап 2.1: тумблер авто-стопа рабочего хода (60 мин реального времени).
            // Разрешён в любой момент активного SIM (влияет только на проверку дедлайна).
            if (!sim->isActive()) { server->send(409, "text/plain", "SIM not active"); return; }
            sim->setAutoStop(getIntP("v", 1) != 0);
            Serial.println(String("[SIM] Авто-стоп рабочего хода: ") + (sim->isAutoStop() ? "ВКЛ (60 мин)" : "ВЫКЛ"));
        } else if (body.indexOf("\"cmd\":\"SIM_SCEN\"") > 0) {
            if (!sim->isActive()) { server->send(409, "text/plain", "SIM not active"); return; }
            sim->setScenario((uint8_t)getIntP("scen", 0));
        } else if (body.indexOf("\"cmd\":\"SIM_SPEED\"") > 0) {
            if (!sim->isActive()) { server->send(409, "text/plain", "SIM not active"); return; }
            sim->setSpeed(getFloatP("speed", 1.0f));
        } else if (body.indexOf("\"cmd\":\"SIM_SPIKE\"") > 0) {
            if (!sim->isActive()) { server->send(409, "text/plain", "SIM not active"); return; }
            int ch = getIntP("ch", -1);
            if (ch < 0 || ch >= SimSensors::CH_COUNT) { server->send(400, "text/plain", "Bad channel"); return; }
            float amp = getFloatP("amp", 0.0f);
            if (amp <= 0.0f) amp = random(50, 201) / 10.0f;   // случайный 5..20C (по плану)
            sim->injectSpike((uint8_t)ch, amp, getIntP("cycles", 1));
        } else if (body.indexOf("\"cmd\":\"SIM_FREEZE\"") > 0) {
            if (!sim->isActive()) { server->send(409, "text/plain", "SIM not active"); return; }
            int ch = getIntP("ch", -1);
            if (ch < 0 || ch >= SimSensors::CH_COUNT) { server->send(400, "text/plain", "Bad channel"); return; }
            sim->injectFreeze((uint8_t)ch, getFloatP("sec", 120.0f));   // 120 с — по плану Этапа 2
        } else if (body.indexOf("\"cmd\":\"SIM_DROP\"") > 0) {
            if (!sim->isActive()) { server->send(409, "text/plain", "SIM not active"); return; }
            int ch = getIntP("ch", -1);
            if (ch < 0 || ch >= SimSensors::CH_COUNT) { server->send(400, "text/plain", "Bad channel"); return; }
            sim->injectDrop((uint8_t)ch, getFloatP("sec", 10.0f));      // 10 с: >5 с — сработает resetFilter
        } else {
            server->send(400, "text/plain", "Unknown SIM Command");
            return;
        }
        server->send(200, "text/plain", "OK");
        return;  // не проваливаться в общий ответ ниже
    }
    else {
        server->send(400, "text/plain", "Unknown Command");
        return;
    }

    server->send(200, "text/plain", "OK");
}

void AppNetwork::handleApiSettings() {
    if (!server->hasArg("plain")) {
        server->send(400, "text/plain", "Bad Request");
        return;
    }
    
    String body = server->arg("plain");
    Serial.println("[API] Settings Save Request received.");

    if (!configManager) {
        server->send(500, "application/json", "{\"error\":\"Config not ready\"}");
        return;
    }
    // Этап 4 (C2): Web-задача (ядро 0) пишет конфиг в ЛОКАЛЬНУЮ копию,
    // в конце обработчика она целиком отправляется в configManager
    // под мьютексом (setConfig). Прямое редактирование общей структуры
    // гоняло процесс на ядре 1 с Web-потоком.
    SystemConfig cfg;
    configManager->getConfigCopy(cfg);

    auto getInt = [&](const char* key, int defaultVal) -> int {
        String searchKey = "\"" + String(key) + "\":";
        int pos = body.indexOf(searchKey);
        if (pos != -1) {
            int start = pos + searchKey.length();
            int end = body.indexOf(',', start);
            if (end == -1) end = body.indexOf('}', start);
            String valStr = body.substring(start, end);
            valStr.trim();
            if (valStr.equalsIgnoreCase("true")) return 1;
            if (valStr.equalsIgnoreCase("false")) return 0;
            return valStr.toInt();
        }
        return defaultVal;
    };

    auto getFloat = [&](const char* key, float defaultVal) -> float {
        String searchKey = "\"" + String(key) + "\":";
        int pos = body.indexOf(searchKey);
        if (pos != -1) {
            int start = pos + searchKey.length();
            int end = body.indexOf(',', start);
            if (end == -1) end = body.indexOf('}', start);
            String valStr = body.substring(start, end);
            return valStr.toFloat();
        }
        return defaultVal;
    };

    auto getBool = [&](const char* key, bool defaultVal) -> bool {
        String searchKey = "\"" + String(key) + "\":";
        int pos = body.indexOf(searchKey);
        if (pos != -1) {
            int start = pos + searchKey.length();
            int end = body.indexOf(',', start);
            if (end == -1) end = body.indexOf('}', start);
            String valStr = body.substring(start, end);
            valStr.trim();
            if (valStr == "1" || valStr.equalsIgnoreCase("true")) return true;
            return false;
        }
        return defaultVal;
    };

    // Обновляем настройки (если ключ отсутствует в JSON — сохраняем текущее значение)
    cfg.emergencyTime = getInt("emergencyTime", cfg.emergencyTime);
    cfg.nasebTime = getInt("nasebTime", cfg.nasebTime);
    cfg.reklapTime = getInt("reklapTime", cfg.reklapTime);
    cfg.boxMaxTemp = getInt("boxMaxTemp", cfg.boxMaxTemp);
    cfg.power = getInt("power", cfg.power);
    cfg.asVolume = getInt("asVolume", cfg.asVolume);
    // Сессия 14: явный объём голов (мл), 0 = авто. Кламп 0..3000 — защита от
    // случайного значения из чужого клиента (web сам клампит тем же диапазоном).
    cfg.headsManualMl = constrain(getInt("headsManualMl", cfg.headsManualMl), 0, 3000);
    cfg.chekwifi = getInt("chekwifi", cfg.chekwifi);

    cfg.razgonTemp = getInt("razgonTemp", cfg.razgonTemp);
    cfg.bakStopTemp = getInt("bakStopTemp", cfg.bakStopTemp);

    // Midterm логика (Сессия 10): хранение x10 (десятые доли), JSON — °C/% с одним знаком.
    // Десятые доли дают точный момент смены тары по крепости отбора (целые градусы
    // давали ошибку крепости до ±2.3% об. в рабочей зоне). Ключи отсутствуют = не менять.
    //
    // Сессия 11: уставка — температура куба, ПРИВЕДЁННАЯ к 760 мм рт.ст. Конверсия
    // крепость<->температура идёт по эталонной таблице (P=760) БЕЗ поправки на текущее
    // давление: триггер в ProcessEngine сам приводит живую температуру куба к 760 по
    // формуле T_прив = T_изм + (760 - P)*0.037. Раньше уставка считалась по давлению
    // в момент сохранения настроек, а триггер использовал давление, замороженное на
    // старте OTBOR, — при их рассогласовании сдвиг срабатывания доходил до ~1.1C.
    const float midtermRefPressure = 760.0f; // эталонное давление таблицы крепостей
    float newMidtermAbvF = getFloat("midterm_abv", -1.0f);
    float newMidtermF = getFloat("midterm", -1.0f);

    // Перевод в x10 с округлением до 0.1; отрицательное = «не передано»
    int newMidterm = (newMidtermF >= 0.0f) ? (int)round(newMidtermF * 10.0f) : -1;
    int newMidtermAbv = (newMidtermAbvF >= 0.0f) ? (int)round(newMidtermAbvF * 10.0f) : -1;

    if (newMidterm != -1 && newMidterm != cfg.midterm) {
        cfg.midterm = constrain(newMidterm, 0, 980); // 0..98.0°C (x10) — приведённая к 760
        int calcAbv = (int)round(configManager->getOutputABVForTemp(cfg.midterm * 0.1f, midtermRefPressure) * 10.0f);
        cfg.midterm_abv = constrain(calcAbv, 0, 980);
    } 
    else if (newMidtermAbv != -1 && newMidtermAbv > 0) {
        cfg.midterm_abv = constrain(newMidtermAbv, 0, 980); // 0..98.0% (x10)
        cfg.midterm = (int)round(configManager->getTempForOutputABV(cfg.midterm_abv * 0.1f, midtermRefPressure) * 10.0f);
        cfg.midterm = constrain(cfg.midterm, 0, 980);
    }
    // Если ключи не переданы — НЕ меняем cfg.midterm и cfg.midterm_abv

    cfg.heaterType = getInt("heaterType", cfg.heaterType);
    cfg.fullPwr = getBool("fullPwr", cfg.fullPwr);
    cfg.valveuse = getBool("valveuse", cfg.valveuse);
    cfg.mixerEnabled = getBool("mixerEnabled", cfg.mixerEnabled);
    cfg.mixerOnTime = getInt("mixerOnTime", cfg.mixerOnTime);
    cfg.mixerOffTime = getInt("mixerOffTime", cfg.mixerOffTime);

    cfg.tsaLimit = getInt("tsaLimit", cfg.tsaLimit);
    cfg.cycleLim = getInt("cycleLim", cfg.cycleLim);
    cfg.histeresis = getFloat("histeresis", cfg.histeresis);
    cfg.delta = getFloat("delta", cfg.delta);
    cfg.useHeadValve = getBool("useHeadValve", cfg.useHeadValve);
    cfg.bodyValveNC = getBool("bodyValveNC", cfg.bodyValveNC);
    cfg.headsTypeKSS = getBool("headsTypeKSS", cfg.headsTypeKSS);
    cfg.calibration = getBool("calibration", cfg.calibration);
    
    // Этап 3 (план A): поля renamed *Ms→*Sec; JSON-ключи НЕ менялись
    // (совместимость с index.html и сохранёнными профилями).
    cfg.headOpenSec = getInt("headOpenMs", cfg.headOpenSec);
    cfg.headCloseSec = getInt("headCloseMs", cfg.headCloseSec);
    cfg.bodyOpenSec = getInt("bodyOpenMs", cfg.bodyOpenSec);
    cfg.bodyCloseSec = getInt("bodyCloseMs", cfg.bodyCloseSec);
    // Клампы клапанных таймингов 1..60 сек (этап 3): отсекаем 0 и
    // «миллисекундные» значения вроде 1200, пришедшие из старых профилей.
    cfg.headOpenSec  = constrain(cfg.headOpenSec,  1, 60);
    cfg.headCloseSec = constrain(cfg.headCloseSec, 1, 60);
    cfg.bodyOpenSec  = constrain(cfg.bodyOpenSec,  1, 60);
    cfg.bodyCloseSec = constrain(cfg.bodyCloseSec, 1, 60);
    cfg.active_test = getInt("active_test", cfg.active_test);
    cfg.valve_head_capacity = getInt("valve_head_capacity", cfg.valve_head_capacity);
    cfg.valve_body_capacity = getInt("valve_body_capacity", cfg.valve_body_capacity);
    cfg.valve_body_capacity_heads = getInt("valve_body_capacity_heads", cfg.valve_body_capacity_heads);
    cfg.valve0_body_capacity = getInt("valve0_body_capacity", cfg.valve0_body_capacity);
    cfg.minOpenTime = getInt("minOpenTime", cfg.minOpenTime);
    cfg.speedHeadCorr = getInt("speedHeadCorr", cfg.speedHeadCorr);
    cfg.speedBodyCorr = getInt("speedBodyCorr", cfg.speedBodyCorr);

    // === ОБЛАЧНЫЕ НАСТРОЙКИ ===
    auto getString = [&](const char* key, char* dest, size_t maxLen) {
        String searchKey = "\"" + String(key) + "\":\"";
        int pos = body.indexOf(searchKey);
        if (pos != -1) {
            int start = pos + searchKey.length();
            int end = body.indexOf("\"", start);
            if (end == -1) end = body.indexOf("}", start);
            String val = body.substring(start, end);
            val.trim();
            val.toCharArray(dest, maxLen);
        }
    };
    
    getString("cloudUrl", cfg.cloudUrl, sizeof(cfg.cloudUrl));
    // Этап 5 (C4): защита от «самозамены» ключа маской.
    // Веб-клиент получает ключ замаскированным (см. buildCfgJson) и возвращает
    // его в той же форме при сохранении настроек. Если записать маску как есть,
    // настоящий ключ был бы безвозвратно затёрт звёздочками. Поэтому значение
    // со звёздочками игнорируем — сохраняется только ПОЛНОСТЬЮ новый ключ.
    {
        String incomingKey;
        {
            String searchKey = "\"cloudApiKey\":\"";
            int pos = body.indexOf(searchKey);
            if (pos != -1) {
                int start = pos + searchKey.length();
                int end = body.indexOf("\"", start);
                if (end == -1) end = body.indexOf("}", start);
                incomingKey = body.substring(start, end);
                incomingKey.trim();
            }
        }
        if (incomingKey.length() > 0 && incomingKey.indexOf('*') == -1) {
            incomingKey.toCharArray(cfg.cloudApiKey, sizeof(cfg.cloudApiKey));
        }
    }
    // ============================

    // === ИНЖЕНЕРНОЕ МЕНЮ ===
    cfg.speedGolovyBase = getInt("speedGolovyBase", cfg.speedGolovyBase);
    cfg.speedTeloBase = getInt("speedTeloBase", cfg.speedTeloBase);
    cfg.distHeadsSpeed = getInt("distHeadsSpeed", cfg.distHeadsSpeed);
    cfg.shporaCorr = getFloat("shporaCorr", cfg.shporaCorr);
    cfg.shporaStabMs = getInt("shporaStabMs", cfg.shporaStabMs);
    cfg.minBodySpeed = getInt("minBodySpeed", cfg.minBodySpeed);
    cfg.headsShareStd = getFloat("headsShareStd", cfg.headsShareStd);
    cfg.headsShareKssSpit = getFloat("headsShareKssSpit", cfg.headsShareKssSpit);
    cfg.headsShareKssStd = getFloat("headsShareKssStd", cfg.headsShareKssStd);
    cfg.headsShareKssAkatelo = getFloat("headsShareKssAkatelo", cfg.headsShareKssAkatelo);
    cfg.pressureCoeff = getFloat("pressureCoeff", cfg.pressureCoeff);
    cfg.coolingDurationSec = getInt("coolingDurationSec", cfg.coolingDurationSec);
    cfg.bakstopDelaySec = getInt("bakstopDelaySec", cfg.bakstopDelaySec);
    cfg.calibDrySec = getInt("calibDrySec", cfg.calibDrySec);
    cfg.calibCapacitySec = getInt("calibCapacitySec", cfg.calibCapacitySec);
    // Сессия 16: задержка захвата опорной T царги в ТЕЛО (мин). Кламп 0..60:
    // отрицательное значение в движке превратилось бы в огромный unsigned-
    // интервал (захват не случился бы никогда), огромное — в вечное ожидание.
    cfg.teloRefDelayMin = constrain(getInt("teloRefDelayMin", cfg.teloRefDelayMin), 0, 60);
    // =========================

    Serial.println("[API] Saving config...");
    // Этап 4 (C2): перед сохранением целиком записываем локальную копию
    // в общий конфиг (под мьютексом внутри setConfig)
    configManager->setConfig(cfg);
    configManager->saveConfig();
    configManager->saveDistConfig();
    configManager->saveRectConfig();
    
    // Перезагружаем конфиг в память чтобы ProcessEngine увидел изменения
    configManager->loadConfig();
    
    Serial.println("[API] Settings SAVED to EEPROM.");
    server->send(200, "text/plain", "Settings Saved");
}

// === Загрузка конфигурации WiFi с SD ===
bool AppNetwork::loadConfigFromSD() {
    File file = SD.open("/wifi_config.txt");
    if (!file) {
        Serial.println("[NetMgr] wifi_config.txt not found");
        return false;
    }
    
    while(file.available()) {
        String line = file.readStringUntil('\n');
        line.trim();
        
        if (line.startsWith("ssid1=")) ssid1 = parseLine(line, "ssid1");
        else if (line.startsWith("pass1=")) pass1 = parseLine(line, "pass1");
        else if (line.startsWith("ssid2=")) ssid2 = parseLine(line, "ssid2");
        else if (line.startsWith("pass2=")) pass2 = parseLine(line, "pass2");
        else if (line.startsWith("tg_token=")) tgToken = parseLine(line, "tg_token");
        else if (line.startsWith("tg_chat=")) tgChatId = parseLine(line, "tg_chat");
    }
    file.close();
    
    if (ssid1.length() == 0) return false;
    return true;
}

String AppNetwork::parseLine(String line, String key) {
    int idx = line.indexOf('=');
    if (idx == -1) return "";
    String val = line.substring(idx + 1);
    val.trim();
    return val;
}

void AppNetwork::syncNTP() {
    Serial.println("[NetMgr] Syncing NTP...");
    int tzOffset = configManager ? configManager->getConfig().timezoneOffset : 3;
    configTime(tzOffset * 3600, 0, "pool.ntp.org", "time.nist.gov");
    
    struct tm timeinfo;
    // Таймаут 500 мс: достаточно для ответа NTP-сервера при наличии интернета.
    // configTime() уже запустил фоновый SNTP-клиент ESP32 — он продолжит
    // синхронизацию автоматически, даже если первая попытка не успела.
    // getLocalTime() здесь — лишь проверка, что время уже получено.
    // Было 2000 мс — слишком долго для update() в потоке WebServer (Core 0).
    if (!getLocalTime(&timeinfo, 500)) {
        Serial.println("[NetMgr] NTP Failed");
        return;
    }
    Serial.println("[NetMgr] NTP Sync OK");
}

bool AppNetwork::checkInternet() {
    WiFiClient testClient;
    testClient.setTimeout(1);  // 1 сек таймаут TCP-подключения

    // 1 попытка: максимальная блокировка ~1 сек вместо 3 сек (было 3 попытки).
    // checkInternet() вызывается из update() (Core 0), который также
    // обслуживает WebServer через handleClient(). Каждая лишняя секунда
    // блокировки = зависание веб-интерфейса.
    // Точность не критична — проверка повторится через 10-30 сек.
    if (testClient.connect("google.com", 80)) {
        testClient.stop();
        Serial.println("[NetMgr] Internet check: OK");
        return true;
    }

    testClient.stop();
    Serial.println("[NetMgr] Internet check: FAILED");
    return false;
}

// === TELEGRAM ОТКЛЮЧЁН ===

void AppNetwork::sendMessage(const String& text) {
    // Telegram disabled - do nothing
}

bool AppNetwork::isOnline() {
    return online;
}

String AppNetwork::getTimeStr() {
    struct tm timeinfo;
    if(!getLocalTime(&timeinfo)){
        return "??:??";
    }
    char buf[6];
    strftime(buf, sizeof(buf), "%H:%M", &timeinfo);
    return String(buf);
}

// === FREERTOS TASK ===
static void networkTaskWrapper(void* param) {
    AppNetwork* self = static_cast<AppNetwork*>(param);
    for (;;) {
        self->update();
        // 10мс вместо 2мс - меньше нагрузка на CPU
        vTaskDelay(pdMS_TO_TICKS(10));
    }
}

void AppNetwork::startTask() {
    xTaskCreatePinnedToCore(
        networkTaskWrapper,
        "NetworkTask",
        8192,
        this,
        1,
        &networkTaskHandle,
        0
    );
}

// === ВСПОМОГАТЕЛЬНЫЕ ===

String AppNetwork::buildCfgJson() {
    if (!configManager) return "{}";
    // Этап 4 (C2): потокобезопасная копия конфига
    SystemConfig cfg;
    configManager->getConfigCopy(cfg);
    
    String json = "{";
    json += "\"emergencyTime\":" + String(cfg.emergencyTime) + ",";
    json += "\"nasebTime\":" + String(cfg.nasebTime) + ",";
    json += "\"reklapTime\":" + String(cfg.reklapTime) + ",";
    json += "\"boxMaxTemp\":" + String(cfg.boxMaxTemp) + ",";
    json += "\"power\":" + String(cfg.power) + ",";
    json += "\"asVolume\":" + String(cfg.asVolume) + ",";
    json += "\"headsManualMl\":" + String(cfg.headsManualMl) + ","; // Сессия 14: явный объём голов (0 = авто)
    json += "\"chekwifi\":" + String(cfg.chekwifi) + ",";
    json += "\"razgonTemp\":" + String(cfg.razgonTemp) + ",";
    json += "\"bakStopTemp\":" + String(cfg.bakStopTemp) + ",";
    // Сессия 10: midterm/midterm_abv хранятся x10 — в JSON отдаём °C/% с одним знаком
    json += "\"midterm\":" + String(cfg.midterm * 0.1f, 1) + ",";
    json += "\"midterm_abv\":" + String(cfg.midterm_abv * 0.1f, 1) + ",";
    json += "\"heaterType\":" + String(cfg.heaterType) + ",";
    json += "\"fullPwr\":" + String(cfg.fullPwr ? "true" : "false") + ",";
    json += "\"valveuse\":" + String(cfg.valveuse ? "true" : "false") + ",";
    json += "\"mixerEnabled\":" + String(cfg.mixerEnabled ? "true" : "false") + ",";
    json += "\"mixerOnTime\":" + String(cfg.mixerOnTime) + ",";
    json += "\"mixerOffTime\":" + String(cfg.mixerOffTime) + ",";
    json += "\"tsaLimit\":" + String(cfg.tsaLimit) + ",";
    json += "\"cycleLim\":" + String(cfg.cycleLim) + ",";
    json += "\"histeresis\":" + String(cfg.histeresis, 2) + ",";
    json += "\"delta\":" + String(cfg.delta, 2) + ",";
    json += "\"useHeadValve\":" + String(cfg.useHeadValve ? "true" : "false") + ",";
    json += "\"bodyValveNC\":" + String(cfg.bodyValveNC ? "true" : "false") + ",";
    json += "\"headsTypeKSS\":" + String(cfg.headsTypeKSS ? "true" : "false") + ",";
    json += "\"calibration\":" + String(cfg.calibration ? "true" : "false") + ",";
    json += "\"headOpenMs\":" + String(cfg.headOpenSec) + ",";
    json += "\"headCloseMs\":" + String(cfg.headCloseSec) + ",";
    json += "\"bodyOpenMs\":" + String(cfg.bodyOpenSec) + ",";
    json += "\"bodyCloseMs\":" + String(cfg.bodyCloseSec) + ",";
    json += "\"active_test\":" + String(cfg.active_test) + ",";
    json += "\"valve_head_capacity\":" + String(cfg.valve_head_capacity) + ",";
    json += "\"valve_body_capacity\":" + String(cfg.valve_body_capacity) + ",";
    json += "\"valve_body_capacity_heads\":" + String(cfg.valve_body_capacity_heads) + ",";
    json += "\"valve0_body_capacity\":" + String(cfg.valve0_body_capacity) + ",";
    json += "\"minOpenTime\":" + String(cfg.minOpenTime) + ",";
    json += "\"speedHeadCorr\":" + String(cfg.speedHeadCorr) + ",";
    json += "\"speedBodyCorr\":" + String(cfg.speedBodyCorr) + ",";
    json += "\"cloudUrl\":\"" + String(cfg.cloudUrl) + "\",";
    // Этап 5 (C4): НЕ отдаём API-ключ веб-клиентам в открытом виде —
    // страница могла быть открыта на чужом компьютере/в общей сети.
    // Отправляем маску: первые 4 и последние 4 символа, середина — звёздочки.
    {
        String key = String(cfg.cloudApiKey);
        String masked;
        if (key.length() > 8) {
            masked = key.substring(0, 4) + "****" + key.substring(key.length() - 4);
        } else if (key.length() > 0) {
            masked = "****";
        } // пустой ключ — остаётся пустым
        json += "\"cloudApiKey\":\"" + masked + "\"";
    }
    json += ",\"eng\":{";
    json += "\"speedGolovyBase\":" + String(cfg.speedGolovyBase) + ",";
    json += "\"speedTeloBase\":" + String(cfg.speedTeloBase) + ",";
    json += "\"distHeadsSpeed\":" + String(cfg.distHeadsSpeed) + ",";
    json += "\"shporaCorr\":" + String(cfg.shporaCorr, 2) + ",";
    json += "\"shporaStabMs\":" + String(cfg.shporaStabMs) + ",";
    json += "\"minBodySpeed\":" + String(cfg.minBodySpeed) + ",";
    json += "\"headsShareStd\":" + String(cfg.headsShareStd, 2) + ",";
    json += "\"headsShareKssSpit\":" + String(cfg.headsShareKssSpit, 2) + ",";
    json += "\"headsShareKssStd\":" + String(cfg.headsShareKssStd, 2) + ",";
    json += "\"headsShareKssAkatelo\":" + String(cfg.headsShareKssAkatelo, 2) + ",";
    json += "\"pressureCoeff\":" + String(cfg.pressureCoeff, 4) + ",";
    json += "\"coolingDurationSec\":" + String(cfg.coolingDurationSec) + ",";
    json += "\"bakstopDelaySec\":" + String(cfg.bakstopDelaySec) + ",";
    json += "\"calibDrySec\":" + String(cfg.calibDrySec) + ",";
    json += "\"calibCapacitySec\":" + String(cfg.calibCapacitySec) + ",";
    json += "\"teloRefDelayMin\":" + String(cfg.teloRefDelayMin); // Сессия 16
    json += "}";
    json += "}";
    
    return json;
}

String AppNetwork::transliterate(String input) {
    String result = "";
    for (unsigned int i = 0; i < input.length(); i++) {
        char c = input.charAt(i);
        switch (c) {
            case 'а': result += 'a'; break;
            case 'б': result += 'b'; break;
            case 'в': result += 'v'; break;
            case 'г': result += 'g'; break;
            case 'д': result += 'd'; break;
            case 'е': result += 'e'; break;
            case 'ё': result += 'e'; break;
            case 'ж': result += 'zh'; break;
            case 'з': result += 'z'; break;
            case 'и': result += 'i'; break;
            case 'й': result += 'y'; break;
            case 'к': result += 'k'; break;
            case 'л': result += 'l'; break;
            case 'м': result += 'm'; break;
            case 'н': result += 'n'; break;
            case 'о': result += 'o'; break;
            case 'п': result += 'p'; break;
            case 'р': result += 'r'; break;
            case 'с': result += 's'; break;
            case 'т': result += 't'; break;
            case 'у': result += 'u'; break;
            case 'ф': result += 'f'; break;
            case 'х': result += 'h'; break;
            case 'ц': result += 'ts'; break;
            case 'ч': result += 'ch'; break;
            case 'ш': result += 'sh'; break;
            case 'щ': result += 'sch'; break;
            case 'ъ': result += ""; break;
            case 'ы': result += 'y'; break;
            case 'ь': result += ""; break;
            case 'э': result += 'e'; break;
            case 'ю': result += 'yu'; break;
            case 'я': result += 'ya'; break;
            default: result += c; break;
        }
    }
    return result;
}

// === PROFILE HANDLERS ===

void AppNetwork::handleSaveProfile() {
    if (!server->hasArg("plain")) {
        server->send(400, "text/plain", "Bad Request");
        return;
    }
    
    String body = server->arg("plain");
    int nameIdx = body.indexOf("\"name\":\"");
    if (nameIdx < 0) {
        server->send(400, "text/plain", "Missing name");
        return;
    }
    
    int nameStart = nameIdx + 8;
    int nameEnd = body.indexOf("\"", nameStart);
    if (nameEnd < 0) {
        server->send(400, "text/plain", "Invalid name");
        return;
    }
    
    String name = body.substring(nameStart, nameEnd);
    name.trim();
    if (name.length() == 0) {
        server->send(400, "text/plain", "Empty name");
        return;
    }
    
    if (!configManager) {
        server->send(500, "application/json", "{\"error\":\"Config not ready\"}");
        return;
    }

    // Создаём имя файла
    String filename = transliterate(name);
    filename.replace(" ", "_");
    filename.toLowerCase();
    filename = "/profiles/" + filename + ".json";
    
    // Сохраняем текущий конфиг
    // Этап 4 (C2): потокобезопасная копия конфига
    SystemConfig cfg;
    configManager->getConfigCopy(cfg);
    
    String json = "{";
    json += "\"name\":\"" + name + "\",";
    json += "\"emergencyTime\":" + String(cfg.emergencyTime) + ",";
    json += "\"nasebTime\":" + String(cfg.nasebTime) + ",";
    json += "\"reklapTime\":" + String(cfg.reklapTime) + ",";
    json += "\"boxMaxTemp\":" + String(cfg.boxMaxTemp) + ",";
    json += "\"power\":" + String(cfg.power) + ",";
    json += "\"asVolume\":" + String(cfg.asVolume) + ",";
    json += "\"headsManualMl\":" + String(cfg.headsManualMl) + ","; // Сессия 14: в профиле, как asVolume
    json += "\"razgonTemp\":" + String(cfg.razgonTemp) + ",";
    json += "\"bakStopTemp\":" + String(cfg.bakStopTemp) + ",";
    // Сессия 10: в профиле midterm/midterm_abv тоже в °C/% с одним знаком;
    // старые профили (целые) совместимы — парсер переводит их в x10 (см. handleLoadProfile)
    json += "\"midterm\":" + String(cfg.midterm * 0.1f, 1) + ",";
    json += "\"midterm_abv\":" + String(cfg.midterm_abv * 0.1f, 1) + ",";
    json += "\"heaterType\":" + String(cfg.heaterType) + ",";
    json += "\"fullPwr\":" + String(cfg.fullPwr ? "true" : "false") + ",";
    json += "\"valveuse\":" + String(cfg.valveuse ? "true" : "false") + ",";
    json += "\"mixerEnabled\":" + String(cfg.mixerEnabled ? "true" : "false") + ",";
    json += "\"mixerOnTime\":" + String(cfg.mixerOnTime) + ",";
    json += "\"mixerOffTime\":" + String(cfg.mixerOffTime) + ",";
    json += "\"tsaLimit\":" + String(cfg.tsaLimit) + ",";
    json += "\"cycleLim\":" + String(cfg.cycleLim) + ",";
    json += "\"histeresis\":" + String(cfg.histeresis, 2) + ",";
    json += "\"delta\":" + String(cfg.delta, 2) + ",";
    json += "\"useHeadValve\":" + String(cfg.useHeadValve ? "true" : "false") + ",";
    json += "\"bodyValveNC\":" + String(cfg.bodyValveNC ? "true" : "false") + ",";
    json += "\"headsTypeKSS\":" + String(cfg.headsTypeKSS ? "true" : "false") + ",";
    json += "\"calibration\":" + String(cfg.calibration ? "true" : "false") + ",";
    json += "\"headOpenMs\":" + String(cfg.headOpenSec) + ",";
    json += "\"headCloseMs\":" + String(cfg.headCloseSec) + ",";
    json += "\"bodyOpenMs\":" + String(cfg.bodyOpenSec) + ",";
    json += "\"bodyCloseMs\":" + String(cfg.bodyCloseSec) + ",";
    json += "\"active_test\":" + String(cfg.active_test) + ",";
    json += "\"valve_head_capacity\":" + String(cfg.valve_head_capacity) + ",";
    json += "\"valve_body_capacity\":" + String(cfg.valve_body_capacity) + ",";
    json += "\"valve_body_capacity_heads\":" + String(cfg.valve_body_capacity_heads) + ",";
    json += "\"valve0_body_capacity\":" + String(cfg.valve0_body_capacity) + ",";
    json += "\"minOpenTime\":" + String(cfg.minOpenTime) + ",";
    json += "\"speedHeadCorr\":" + String(cfg.speedHeadCorr) + ",";
    json += "\"speedBodyCorr\":" + String(cfg.speedBodyCorr);
    json += "}";
    
    // Сохраняем файл
    SDScopeLock lock;
    // Этап 5: проверяем, что мьютекс реально захвачен. Без проверки при
    // занятой SD (запись лога на ядре 1) мы бы открыли файл В ОБХОД мьютекса
    // и могли повредить SPI-шину.
    if (!lock.locked) {
        server->send(503, "text/plain", "SD busy, try again");
        return;
    }
    File file = SD.open(filename.c_str(), FILE_WRITE);
    if (!file) {
        server->send(500, "text/plain", "Failed to create file");
        return;
    }
    file.print(json);
    file.close();
    
    Serial.println("[Profile] Saved: " + filename);
    logger.log("[Profile] Saved: " + name);
    
    server->send(200, "text/plain", "Profile saved: " + name);
}

void AppNetwork::handleListProfiles() {
    String json = "{\"profiles\":[";
    
    SDScopeLock lock;
    if (!lock.locked) {
        server->send(503, "application/json", "{\"error\":\"SD busy\"}");
        return;
    }
    
    File profilesDir = SD.open("/profiles");
    if (!profilesDir || !profilesDir.isDirectory()) {
        json += "]}";
        server->send(200, "application/json", json);
        return;
    }
    
    // Лимиты (Причина №5):
    // MAX_PROFILES — защита от «мусорных» директорий с сотнями файлов.
    // 50 профилей — более чем достаточно для ректификации.
    const int MAX_PROFILES = 50;
    // MAX_FILE_READ — имя профиля ("name":"...") всегда в начале файла.
    // Читаем максимум 2 КБ — достаточно для поиска "name", не читаем весь файл.
    const int MAX_FILE_READ = 2048;
    // Буфер для чтения файла кусками вместо посимвольного += (антифрагментация)
    char buf[256];
    
    bool first = true;
    int count = 0;
    File file = profilesDir.openNextFile();
    while (file && count < MAX_PROFILES) {
        if (!file.isDirectory() && String(file.name()).endsWith(".json")) {
            count++;
            // Читаем имя профиля из файла
            String filename = String(file.name());
            
            // Fallback-имя: имя файла без .json
            String name = filename.substring(0, filename.length() - 5);
            
            // Буферное чтение файла (до MAX_FILE_READ байт)
            // Вместо content += (char)file.read() — тысячи реаллокаций String
            String content = "";
            content.reserve(MAX_FILE_READ);  // Резервируем сразу, без фрагментации
            int totalRead = 0;
            while (file.available() && totalRead < MAX_FILE_READ) {
                int toRead = min((int)file.available(), 256);
                if (totalRead + toRead > MAX_FILE_READ) toRead = MAX_FILE_READ - totalRead;
                int bytesRead = file.read((uint8_t*)buf, toRead);
                if (bytesRead <= 0) break;
                content.concat(buf, bytesRead);
                totalRead += bytesRead;
            }
            
            // Ищем "name" в прочитанном фрагменте
            int nameIdx = content.indexOf("\"name\":\"");
            if (nameIdx >= 0) {
                int nameStart = nameIdx + 8;
                int nameEnd = content.indexOf("\"", nameStart);
                if (nameEnd > nameStart) {
                    name = content.substring(nameStart, nameEnd);
                }
            }
            
            if (!first) json += ",";
            json += "{\"file\":\"" + filename + "\",\"name\":\"" + name + "\"}";
            first = false;
        }
        file = profilesDir.openNextFile();
    }
    
    profilesDir.close();
    json += "]}";
    server->send(200, "application/json", json);
}

void AppNetwork::handleLoadProfile() {
    if (!server->hasArg("plain")) {
        server->send(400, "text/plain", "Bad Request");
        return;
    }
    
    String body = server->arg("plain");
    int fileIdx = body.indexOf("\"file\":\"");
    if (fileIdx < 0) {
        server->send(400, "text/plain", "Missing file");
        return;
    }
    
    int fileStart = fileIdx + 8;
    int fileEnd = body.indexOf("\"", fileStart);
    if (fileEnd < 0) {
        server->send(400, "text/plain", "Invalid file");
        return;
    }
    
    String filename = body.substring(fileStart, fileEnd);
    filename.trim();
    if (!filename.endsWith(".json")) {
        filename += ".json";
    }
    filename = "/profiles/" + filename;
    
    SDScopeLock lock;
    // Этап 5: без проверки lock.locked чтение шло бы В ОБХОД мьютекса
    if (!lock.locked) {
        server->send(503, "text/plain", "SD busy, try again");
        return;
    }
    File file = SD.open(filename.c_str());
    if (!file) {
        server->send(404, "text/plain", "Profile not found");
        return;
    }
    
    String content = "";
    while (file.available()) {
        content += (char)file.read();
    }
    file.close();

    if (!configManager) {
        server->send(500, "application/json", "{\"error\":\"Config not ready\"}");
        return;
    }
    
    // Парсим и применяем настройки
    // Этап 4 (C2): профиль применяется к ЛОКАЛЬНОЙ копии конфига, в конце
    // обработчика она целиком записывается в configManager под мьютексом.
    SystemConfig cfg;
    configManager->getConfigCopy(cfg);
    
    auto getInt = [&](const char* key, int defaultVal) -> int {
        String searchKey = "\"" + String(key) + "\":";
        int pos = content.indexOf(searchKey);
        if (pos != -1) {
            int start = pos + searchKey.length();
            int end = content.indexOf(',', start);
            if (end == -1) end = content.indexOf('}', start);
            String valStr = content.substring(start, end);
            valStr.trim();
            if (valStr.equalsIgnoreCase("true")) return 1;
            if (valStr.equalsIgnoreCase("false")) return 0;
            return valStr.toInt();
        }
        return defaultVal;
    };
    
    auto getFloat = [&](const char* key, float defaultVal) -> float {
        String searchKey = "\"" + String(key) + "\":";
        int pos = content.indexOf(searchKey);
        if (pos != -1) {
            int start = pos + searchKey.length();
            int end = content.indexOf(',', start);
            if (end == -1) end = content.indexOf('}', start);
            String valStr = content.substring(start, end);
            return valStr.toFloat();
        }
        return defaultVal;
    };
    
    auto getBool = [&](const char* key, bool defaultVal) -> bool {
        String searchKey = "\"" + String(key) + "\":";
        int pos = content.indexOf(searchKey);
        if (pos != -1) {
            int start = pos + searchKey.length();
            int end = content.indexOf(',', start);
            if (end == -1) end = content.indexOf('}', start);
            String valStr = content.substring(start, end);
            valStr.trim();
            return valStr == "1" || valStr.equalsIgnoreCase("true");
        }
        return defaultVal;
    };
    
    cfg.emergencyTime = getInt("emergencyTime", cfg.emergencyTime);
    cfg.nasebTime = getInt("nasebTime", cfg.nasebTime);
    cfg.reklapTime = getInt("reklapTime", cfg.reklapTime);
    cfg.boxMaxTemp = getInt("boxMaxTemp", cfg.boxMaxTemp);
    cfg.power = getInt("power", cfg.power);
    cfg.asVolume = getInt("asVolume", cfg.asVolume);
    // Сессия 14: явный объём голов в профиле. В старых профилях ключа нет —
    // getInt вернёт текущее значение (не сбрасываем), кламп тот же 0..3000.
    cfg.headsManualMl = constrain(getInt("headsManualMl", cfg.headsManualMl), 0, 3000);
    cfg.razgonTemp = getInt("razgonTemp", cfg.razgonTemp);
    cfg.bakStopTemp = getInt("bakStopTemp", cfg.bakStopTemp);
    // Сессия 10: midterm/midterm_abv в профиле — °C/% (один знак); хранение x10.
    // Старые профили с целыми значениями совместимы: 92 -> 920, 43 -> 430.
    cfg.midterm = constrain((int)round(getFloat("midterm", cfg.midterm * 0.1f) * 10.0f), 0, 980);
    cfg.midterm_abv = constrain((int)round(getFloat("midterm_abv", cfg.midterm_abv * 0.1f) * 10.0f), 0, 980);
    cfg.heaterType = getInt("heaterType", cfg.heaterType);
    cfg.fullPwr = getBool("fullPwr", cfg.fullPwr);
    cfg.valveuse = getBool("valveuse", cfg.valveuse);
    cfg.mixerEnabled = getBool("mixerEnabled", cfg.mixerEnabled);
    cfg.mixerOnTime = getInt("mixerOnTime", cfg.mixerOnTime);
    cfg.mixerOffTime = getInt("mixerOffTime", cfg.mixerOffTime);
    cfg.tsaLimit = getInt("tsaLimit", cfg.tsaLimit);
    cfg.cycleLim = getInt("cycleLim", cfg.cycleLim);
    cfg.histeresis = getFloat("histeresis", cfg.histeresis);
    cfg.delta = getFloat("delta", cfg.delta);
    cfg.useHeadValve = getBool("useHeadValve", cfg.useHeadValve);
    cfg.bodyValveNC = getBool("bodyValveNC", cfg.bodyValveNC);
    cfg.headsTypeKSS = getBool("headsTypeKSS", cfg.headsTypeKSS);
    cfg.calibration = getBool("calibration", cfg.calibration);
    // Этап 3: переименование полей, JSON-ключи профиля сохранены (совместимость)
    cfg.headOpenSec = getInt("headOpenMs", cfg.headOpenSec);
    cfg.headCloseSec = getInt("headCloseMs", cfg.headCloseSec);
    cfg.bodyOpenSec = getInt("bodyOpenMs", cfg.bodyOpenSec);
    cfg.bodyCloseSec = getInt("bodyCloseMs", cfg.bodyCloseSec);
    // Клампы 1..60 сек (этап 3): старые профили могли хранить «миллисекунды»
    cfg.headOpenSec  = constrain(cfg.headOpenSec,  1, 60);
    cfg.headCloseSec = constrain(cfg.headCloseSec, 1, 60);
    cfg.bodyOpenSec  = constrain(cfg.bodyOpenSec,  1, 60);
    cfg.bodyCloseSec = constrain(cfg.bodyCloseSec, 1, 60);
    cfg.active_test = getInt("active_test", cfg.active_test);
    cfg.valve_head_capacity = getInt("valve_head_capacity", cfg.valve_head_capacity);
    cfg.valve_body_capacity = getInt("valve_body_capacity", cfg.valve_body_capacity);
    cfg.valve_body_capacity_heads = getInt("valve_body_capacity_heads", cfg.valve_body_capacity_heads);
    cfg.valve0_body_capacity = getInt("valve0_body_capacity", cfg.valve0_body_capacity);
    cfg.minOpenTime = getInt("minOpenTime", cfg.minOpenTime);
    cfg.speedHeadCorr = getInt("speedHeadCorr", cfg.speedHeadCorr);
    cfg.speedBodyCorr = getInt("speedBodyCorr", cfg.speedBodyCorr);
    
    // Этап 4 (C2): целиком записываем локальную копию в общий конфиг
    configManager->setConfig(cfg);
    configManager->saveConfig();
    configManager->saveDistConfig();
    configManager->saveRectConfig();
    
    // Перезагружаем конфиг в память чтобы ProcessEngine увидел изменения
    configManager->loadConfig();
    
    Serial.println("[Profile] Loaded: " + filename);
    logger.log("[Profile] Loaded: " + filename);
    
    server->send(200, "text/plain", "Profile loaded");
}

void AppNetwork::handleCalcValve() {
    if (!server->hasArg("plain")) {
        server->send(400, "text/plain", "Bad Request");
        return;
    }
    
    String body = server->arg("plain");
    
    // Парсим ml и type
    int mlIdx = body.indexOf("\"ml\":");
    int typeIdx = body.indexOf("\"type\":\"");
    
    if (mlIdx < 0 || typeIdx < 0) {
        server->send(400, "text/plain", "Missing ml or type");
        return;
    }
    
    int mlStart = mlIdx + 5;
    int mlEnd = body.indexOf(',', mlStart);
    if (mlEnd < 0) mlEnd = body.indexOf('}', mlStart);
    String mlStr = body.substring(mlStart, mlEnd);
    mlStr.trim();
    float ml = mlStr.toFloat();
    
    int typeStart = typeIdx + 8;
    int typeEnd = body.indexOf("\"", typeStart);
    String type = body.substring(typeStart, typeEnd);
    
    if (!configManager) {
        server->send(500, "application/json", "{\"error\":\"Config not ready\"}");
        return;
    }

    // Расчёт capacity
    int testDuration = configManager->getConfig().active_test;
    float capacity = ml / (testDuration / 60.0f);  // мл/мин
    
    // Сохраняем в конфиг
    // Этап 4 (C2): правим локальную копию и целиком записываем под мьютексом
    SystemConfig cfg;
    configManager->getConfigCopy(cfg);
    if (type == "head") {
        cfg.valve_head_capacity = (int)capacity;
    } else {
        cfg.valve_body_capacity = (int)capacity;
    }
    configManager->setConfig(cfg);
    configManager->saveRectConfig();
    
    Serial.printf("[CalcValve] type=%s, ml=%.1f, capacity=%.1f ml/min\n", type.c_str(), ml, capacity);
    logger.log("[CalcValve] " + type + ": " + String(ml, 1) + "ml -> " + String(capacity, 1) + " ml/min");
    
    String json = "{\"capacity\":" + String(capacity, 1) + "}";
    server->send(200, "application/json", json);
}
