Vlad-alco/BuhloWar/ProcessEngine.cpp

#include "ProcessEngine.h"
#include <math.h>
#include "SDLogger.h" 
#include "SimSensors.h" // Этап 2.1: сим-часы procNow() + режим хода/авто-стоп
// === КОНСТАНТЫ ===
const float MAX_CYCLE_TIME_MS = 10000.0f; // Максимальное время цикла (мс)

// === Этап 2.1: УСКОРЕННЫЕ ЧАСЫ ПРОЦЕССА ===
// В активном SIM — сим-время в мс (растёт speed× быстрее реального),
// вне SIM — обычный millis(). Все таймеры этапов и объёмные интеграторы
// движка идут от procNow(), поэтому полный разгон охватывает таймерные
// и объёмные этапы (НАСЕБЯ, ГОЛОВЫ, задержки, литры), а не только кривые.
// Баззер-паттерны, цикловка клапанов (OutputManager) и таймеры тестов
// клапанов остаются в РЕАЛЬНОМ времени — физика и звук не ускоряются.
unsigned long ProcessEngine::procNow() {
    SimSensors* sim = SimSensors::getInstance();
    if (sim->isActive()) return sim->simNowMs();
    return millis();
}

// ==================== ИНИЦИАЛИЗАЦИЯ ====================

void ProcessEngine::begin(LiquidCrystal_I2C* lcd, SensorAdapter* sensors, OutputManager* outputs, ConfigManager* cfgMgr) {
    this->sensorAdapter = sensors;
    this->outputManager = outputs;
    this->configManager = cfgMgr;

    // +++ ПЕРЕДАЕМ ПАРАМЕТР ТИПА КЛАПАНА +++
    // getConfig() возвращает ссылку на SystemConfig
    outputManager->begin(configManager->getConfig().bodyValveNC); 

    valveCalMenu = new ValveCalMenu(lcd, configManager, outputs);
    setPwAsMenu = new SetPwAsMenu(lcd, configManager);
    
  
    
    currentStatus.activeProcess = PROCESS_NONE;
    currentStatus.isRunning = false;
    currentStatus.stageName = "IDLE";
    Serial.println("[ProcessEngine] Initialized");
    logger.log("[ProcessEngine] Initialized");
    printStartupInfo();
}

void ProcessEngine::syncConfig() {}
void ProcessEngine::updateNetworkStatus(char networkSymbol) {
    currentStatus.networkSymbol = String(networkSymbol);
}
void ProcessEngine::handleUiUp() {
    if (currentStage == Stage::VALVE_CAL) valveCalMenu->handleUpButton();
    else if (currentStage == Stage::SET_PW_AS) setPwAsMenu->handleUpButton();
}
void ProcessEngine::handleUiDown() {
    if (currentStage == Stage::VALVE_CAL) valveCalMenu->handleDownButton();
    else if (currentStage == Stage::SET_PW_AS) setPwAsMenu->handleDownButton();
}
void ProcessEngine::handleUiSet() {
    if (currentStage == Stage::VALVE_CAL) valveCalMenu->handleSetButton();
    else if (currentStage == Stage::SET_PW_AS) setPwAsMenu->handleSetButton();
    
    else if (currentStage == Stage::WATER_TEST) handleCommand(UiCommand::DIALOG_YES);
    else if (currentStage == Stage::REPLACEMENT) handleCommand(UiCommand::DIALOG_YES);
    else if (currentStage == Stage::GOLOVY_OK) handleCommand(UiCommand::DIALOG_YES);
    // =====================
}
void ProcessEngine::handleUiBack() {
    if (currentStage == Stage::VALVE_CAL) valveCalMenu->handleBackButton();
    else if (currentStage == Stage::SET_PW_AS) setPwAsMenu->handleBackButton();
    // === ДОБАВИТЬ ЭТО ===
    else if (currentStage == Stage::WATER_TEST) handleCommand(UiCommand::DIALOG_NO); // Это остановит процесс
    else if (currentStage == Stage::REPLACEMENT) handleCommand(UiCommand::DIALOG_NO); // Это перейдет в BAKSTOP
    // =====================
}

// === ВСПОМОГАТЕЛЬНАЯ: имя датчика → индекс ===
static SensorIndex sensorNameToIndex(const String& name) {
    if (name == "AQUA") return SENSOR_AQUA;
    if (name == "TSAR") return SENSOR_TSAR;
    if (name == "TANK") return SENSOR_TANK;
    return SENSOR_TSA;
}
// =============================================

// ==================== ОСНОВНОЙ ЦИКЛ ====================

void ProcessEngine::update() {
    outputManager->update();
    checkSafety();
        // === ПРОВЕРКА СТАТУСА WEB КАЛИБРОВКИ ===
    if (currentStatus.webCalibStatus == 1) { // Если в режиме поиска
        SensorIndex idx = sensorNameToIndex(currentStatus.webCalibSensorName);

        DeviceAddress addr;
        if (SensorManager::getInstance()->checkCalibration(idx, addr)) {
            currentStatus.webCalibStatus = 2; // Найден
            Serial.println("[WebCalib] Sensor Found!");
            logger.log("[WebCalib] Sensor Found!");
        }
        
        // Таймаут (30 сек)
               // Простая проверка времени (менеджер сбросит флаг inProgress при таймауте)
if (!SensorManager::getInstance()->isCalibrating(idx) && currentStatus.webCalibStatus == 1) {
     currentStatus.webCalibStatus = 3;// Ошибка/Не найден
             Serial.println("[WebCalib] Not Found / Timeout");
             logger.log("[WebCalib] Not Found / Timeout");
        }
    }
        // === ПРОВЕРКА ТАЙМЕРОВ ТЕСТОВ (РАЗДЕЛЬНАЯ) ===
    if (headTestStatus.active) {
        unsigned long elapsed = (millis() - headTestStatus.startTime) / 1000;
        if (elapsed >= headTestStatus.durationSec) {
    outputManager->stopHeadValveTest();
    headTestStatus.active = false;
    headTestStatus.awaitingInput = true;
    headTestStatus.startTime = millis(); // переиспользуем для таймаута ожидания
    Serial.println("[Process] Head Test Finished - Awaiting ml input");
    logger.log("[Process] Head Test Finished - Awaiting ml input");
}
    }
    if (headTestStatus.awaitingInput && millis() - headTestStatus.startTime > 300000) {
        headTestStatus.awaitingInput = false;
        Serial.println("[Process] Head Test input timeout (5 min) - auto cleared");
        logger.log("[Process] Head Test input timeout - auto cleared");
    }
    
    if (bodyTestStatus.active) {
        unsigned long elapsed = (millis() - bodyTestStatus.startTime) / 1000;
        if (elapsed >= bodyTestStatus.durationSec) {
    outputManager->stopBodyValveTest();
    bodyTestStatus.active = false;
    bodyTestStatus.awaitingInput = true;
    bodyTestStatus.startTime = millis(); // переиспользуем для таймаута ожидания
    Serial.println("[Process] Body Test Finished - Awaiting ml input");
    logger.log("[Process] Body Test Finished - Awaiting ml input");
}
    }
    if (bodyTestStatus.awaitingInput && millis() - bodyTestStatus.startTime > 300000) {
        bodyTestStatus.awaitingInput = false;
        Serial.println("[Process] Body Test input timeout (5 min) - auto cleared");
        logger.log("[Process] Body Test input timeout - auto cleared");
    }
    
    // === СИНХРОНИЗАЦИЯ СОСТОЯНИЯ КАЛИБРОВКИ КЛАПАНОВ ===
    if (valveCalMenu) {
        // Обновляем состояние мастера (таймеры, переходы)
        valveCalMenu->update();
        
        // Копируем состояние в статус для Web
        CalibWizardState& ws = valveCalMenu->getWizardState();
        currentStatus.calibWizard.valve = (int)ws.valve + 1;  // 0-based to 1-based
        currentStatus.calibWizard.step = (int)ws.step;
        currentStatus.calibWizard.isRunning = ws.isTestRunning;
        currentStatus.calibWizard.totalSec = ws.testDurationSec;
        currentStatus.calibWizard.remainingSec = valveCalMenu->getTestRemaining();
        currentStatus.calibWizard.volume = ws.enteredVolume;
        currentStatus.calibWizard.capacity = ws.calculatedCapacity;

    }
    // ====================================================
        
    if (emergencyState) return;
    updateDisplayData();

    switch (currentStage) {
        case Stage::IDLE: handleIdleState(); break;
        case Stage::WATER_TEST: handleWaterTest(); break;
        case Stage::RAZGON: handleRazgon(); break;
        case Stage::WAITING: handleWaiting(); break;
        case Stage::OTBOR: handleDistOtbor(); break;
        case Stage::REPLACEMENT: handleDistReplacement(); break;
        case Stage::BAKSTOP: handleDistBakstop(); break;
        case Stage::NASEBYA: handleNasebya(); break;
        case Stage::VALVE_CAL:
        case Stage::SET_PW_AS:
        case Stage::GOLOVY:
        case Stage::GOLOVY_OK:
        case Stage::TELO: handleRectProcess(); break;
        case Stage::FINISHING_WORK: handleFinishingWork(); break;
        default: break;
    }
    
    if (activeProcess == PROCESS_RECT) {
        updateRectWebInfo();
    }
    if (processRunning) {
        currentStatus.processTimeSec = (procNow() - processStartTime) / 1000;
        currentStatus.stageTimeSec = (procNow() - stageStartTime) / 1000;
    }

    // === Этап 2.1: АВТО-СТОП РАБОЧЕГО ХОДА SIM (60 мин РЕАЛЬНОГО времени) ===
    // Защита забытого на стенде процесса: движок видит синтетические температуры
    // и может «греть» бесконечно. По истечении — штатный путь СТОП (как кнопка):
    // changeStage(FINISHING_WORK) с полным завершением (охлаждение, вода).
    // Дедлайн ставится в startProcess() только для рабочего хода (сухой ход
    // физически безопасен). Проверка в РЕАЛЬНОМ времени, не в сим-времени.
    if (simAutoStopAt != 0 && processRunning && currentStage != Stage::FINISHING_WORK) {
        SimSensors* sim = SimSensors::getInstance();
        if (sim->isActive() && !sim->isDryRun() && sim->isAutoStop() &&
            (long)(millis() - simAutoStopAt) >= 0) {
            simAutoStopAt = 0; // одноразово
            Serial.println("[SIM] АВТО-СТОП: 60 минут рабочего хода — переход в ФИНИШ");
            logger.log("[SIM] АВТО-СТОП: 60 мин рабочего хода SIM (защита стенда) — ФИНИШ");
            changeStage(Stage::FINISHING_WORK);
        }
    }
    
    // === Этап 4 (C2): публикация снимка статуса для другого ядра ===
    // В конце каждого update() статус ЦЕЛИКОМ копируется в «задний» буфер
    // (вне мьютекса — копирование небыстрое), затем указатель «переднего»
    // буфера атомарно переключается под мьютексом. Читатель на ядре 0
    // (getStatusCopy) всегда видит только ЦЕЛИКОМ готовый снимок.
    publishStatus();
}

// ==================== ПУБЛИКАЦИЯ СТАТУСА (этап 4, C2) ====================

// Копирует текущий статус в задний буфер и переключает front-указатель.
// Вызывается ТОЛЬКО из ProcessEngine::update() (ядро 1, писатель).
void ProcessEngine::publishStatus() {
    SystemStatus& back = (publishFront == &publishA) ? publishB : publishA;
    back = currentStatus;              // Глубокая копия (String переиспользуют буферы — без аллокаций в установившемся режиме)
    if (statusMutex && xSemaphoreTake(statusMutex, pdMS_TO_TICKS(10))) {
        publishFront = &back;          // Атомарное переключение снимка (микросекунды)
        xSemaphoreGive(statusMutex);
    }
}

// Потокобезопасное чтение статуса (для Web-задачи на ядре 0).
// Возвращает согласованную копию последнего опубликованного снимка.
void ProcessEngine::getStatusCopy(SystemStatus& out) const {
    if (statusMutex && xSemaphoreTake(statusMutex, pdMS_TO_TICKS(50))) {
        out = *publishFront;           // Копия целиком готового снимка
        xSemaphoreGive(statusMutex);
    } else {
        out = *publishFront;           // Фоллбек: мьютекс занят/не создан — читаем как есть
    }
}

// ==================== SAFETY ====================

void ProcessEngine::checkSafety() {
    const SensorData& data = sensorAdapter->getData();
    SystemConfig& cfg = configManager->getConfig();
    
    // --- 1. Проверка TSA (Приоритет выше) ---
    if (data.isTsaValid() && data.tsa.value > cfg.tsaLimit) {  // если датчик не валиден — тревога не срабатывает
        if (!alarmTSA_Active) {
            alarmTSA_Active = true; 
            alarmStartTime = procNow();  // Этап 2.1: аварийный таймер в сим-времени (полный разгон)
            currentStatus.safety = SafetyState::WARNING_TSA;
            currentStatus.alarm = AlarmType::ALARM_TSA;
            outputManager->alarmBeep(AlarmType::ALARM_TSA);
            Serial.println("[Safety] TSA LIMIT EXCEEDED! Countdown started.");
             // === ЛОГИРОВАНИЕ ===
            logger.log("ALARM! TSA LIMIT > " + String(cfg.tsaLimit) + "C");
            // ==================
        }
        
        // Обратный отсчет
        unsigned long limitSec = (unsigned long)cfg.emergencyTime * 60;
        unsigned long elapsedSec = (procNow() - alarmStartTime) / 1000;
        currentStatus.alarmTimerSec = (elapsedSec < limitSec) ? (limitSec - elapsedSec) : 0;
        
        // Если время вышло -> FINISHING WORK (ТЗ: переход к процедуре завершения)
        if (currentStatus.alarmTimerSec == 0 && currentStage != Stage::FINISHING_WORK) {
    Serial.println("[Safety] VREAC time elapsed! -> FINISHING WORK");
    logger.log("[Safety] VREAC time elapsed! -> FINISHING WORK");
    changeStage(Stage::FINISHING_WORK); 
    currentStatus.safety = SafetyState::EMERGENCY;
}
    } else if (alarmTSA_Active && !data.isTsaValid()) {
        // === Этап 6: УДЕРЖАНИЕ ТРЕВОГИ при пропаже датчика TSA ===
        // Как было: если во время аварии датчик кратковременно пропадал
        // (isTsaValid() == false), ветка «температура в норме» мгновенно
        // сбрасывала тревогу и ОБУНУЛЯЛА отсчёт VREAC. Дребезг контакта
        // мог бесконечно откладывать аварийное завершение.
        // Теперь: пока датчик не вернётся — тревога и отсчёт СОХРАНЯЮТСЯ,
        // таймер продолжает тикать от исходной точки (alarmStartTime).
        unsigned long limitSec = (unsigned long)cfg.emergencyTime * 60;
        unsigned long elapsedSec = (procNow() - alarmStartTime) / 1000;
        currentStatus.alarmTimerSec = (elapsedSec < limitSec) ? (limitSec - elapsedSec) : 0;
        
        // Если время вышло, пока датчик пропал — завершаем по правилу VREAC
        if (currentStatus.alarmTimerSec == 0 && currentStage != Stage::FINISHING_WORK) {
            Serial.println("[Safety] VREAC time elapsed (TSA sensor lost)! -> FINISHING WORK");
            logger.log("[Safety] VREAC time elapsed (TSA sensor lost)! -> FINISHING WORK");
            changeStage(Stage::FINISHING_WORK);
            currentStatus.safety = SafetyState::EMERGENCY;
        }
    } else {
        // Температура в норме
        if (alarmTSA_Active) { 
            alarmTSA_Active = false; 
            outputManager->stopAlarm(); 
            Serial.println("[Safety] TSA normalized.");
            // === ЛОГИРОВАНИЕ ===
            logger.log("ALARM CLEARED: TSA Normal");
            // ==================
        }
        if (!alarmBOX_Active) { 
            currentStatus.safety = SafetyState::NORMAL; 
            currentStatus.alarm = AlarmType::NONE; 
        }
    }

    // --- 2. Проверка BOX (Только если нет аварии TSA и BME доступен) ---
    // Если BME недоступен, boxTemp заморожен, проверку пропускаем
    if (!alarmTSA_Active && currentStatus.bmeAvailable) {
        if (data.boxTemp > cfg.boxMaxTemp) {
            if (!alarmBOX_Active) {
                alarmBOX_Active = true; 
                currentStatus.safety = SafetyState::WARNING_BOX;
                currentStatus.alarm = AlarmType::ATTENTION_BOX;
                outputManager->alarmBeep(AlarmType::ATTENTION_BOX);
                Serial.println("[Safety] BOX OVERHEAT!");
                // === ЛОГИРОВАНИЕ ===
                logger.log("WARNING: BOX OVERHEAT > " + String(cfg.boxMaxTemp) + "C");
                // ==================
            }
        } else {
            if (alarmBOX_Active) {
                alarmBOX_Active = false; 
                outputManager->stopAlarm();
                currentStatus.safety = SafetyState::NORMAL; 
                currentStatus.alarm = AlarmType::NONE;
                Serial.println("[Safety] BOX Temp normalized.");
                // === ЛОГИРОВАНИЕ ===
                logger.log("WARNING CLEARED: BOX Normal");
                // ==================
            }
        }
    }
}

// ==================== COMMANDS ====================

// -----------------------------------------------------------------------------
// checkSensorsReady() — проверка готовности датчиков перед запуском процесса.
//
// Логика проверки для каждого из 4 датчиков (TSA, TANK, TSAR, AQUA):
//   1. isCalibrated()  — адрес датчика сохранён в EEPROM (оператор провёл калибровку)
//   2. isConnected()   — датчик отвечает на шине 1-Wire в данный момент
//
// Если хотя бы один датчик не прошёл проверку — возвращает false.
// В errorMsg записываются имена проблемных датчиков через пробел (для LCD, 20 символов).
// Причина также пишется в Serial и на SD-карту через logger.
// -----------------------------------------------------------------------------
bool ProcessEngine::checkSensorsReady(String& errorMsg) {
    SensorManager* sm = SensorManager::getInstance();

    // Таблица проверяемых датчиков: индекс и отображаемое имя
    struct SensorCheck {
        SensorIndex index;
        const char* name;
    };
    const SensorCheck checks[4] = {
        { SENSOR_TSA,  "TSA"  },
        { SENSOR_TANK, "TANK" },
        { SENSOR_TSAR, "TSAR" },
        { SENSOR_AQUA, "AQUA" }
    };

    errorMsg = "";
    bool allReady = true;

    for (int i = 0; i < 4; i++) {
        bool calibrated = sm->isCalibrated(checks[i].index);
        bool connected  = sm->isConnected(checks[i].index);

        if (!calibrated || !connected) {
            // Добавляем имя датчика в строку ошибки (с разделителем-пробелом)
            if (errorMsg.length() > 0) errorMsg += " ";
            errorMsg += checks[i].name;

            // Детальный лог: указываем точную причину для каждого датчика
            if (!calibrated) {
                logger.log("START BLOCKED: " + String(checks[i].name) + " not calibrated");
            } else {
                logger.log("START BLOCKED: " + String(checks[i].name) + " offline (no response)");
            }
            allReady = false;
        }
    }
    return allReady;
}



EngineResponse ProcessEngine::handleCommand(UiCommand command, int param) {
    

        // === ОБРАБОТКА ЗАПУСКА ТЕСТОВ (РАЗДЕЛЬНО) ===
    
    // 1. Тест Голов
    if (command == UiCommand::TEST_HEAD) {
        SystemConfig& cfg = configManager->getConfig();
        outputManager->setBodyValveType(cfg.bodyValveNC); // Синхронизация типа
        
        // Если тест уже шел - перезапускаем
        outputManager->stopHeadValveTest(); 
        headTestStatus.active = false;

        // Запуск
        headTestStatus.active = true;
headTestStatus.startTime = millis();
headTestStatus.durationSec = cfg.active_test;
headTestStatus.openSec = cfg.headOpenSec;
headTestStatus.closeSec = cfg.headCloseSec;
headTestStatus.awaitingInput = false;
outputManager->startHeadValveCycling(cfg.headOpenSec * 1000, cfg.headCloseSec * 1000);
        Serial.println("[Process] HEAD Test Started");
        // === ЛОГИРОВАНИЕ ===
        logger.log("[Process] HEAD Test Started");
        return EngineResponse::OK;
    }
    
    // 2. Тест Тела
    if (command == UiCommand::TEST_BODY) {
        SystemConfig& cfg = configManager->getConfig();
        outputManager->setBodyValveType(cfg.bodyValveNC);
        
        outputManager->stopBodyValveTest();
        bodyTestStatus.active = false;

        // Запуск
        bodyTestStatus.active = true;
bodyTestStatus.startTime = millis();
bodyTestStatus.durationSec = cfg.active_test;
bodyTestStatus.openSec = cfg.bodyOpenSec;
bodyTestStatus.closeSec = cfg.bodyCloseSec;
bodyTestStatus.awaitingInput = false;
outputManager->startBodyValveCycling(cfg.bodyOpenSec * 1000, cfg.bodyCloseSec * 1000);
        Serial.println("[Process] BODY Test Started");
        // === ЛОГИРОВАНИЕ ===
        logger.log("[Process] BODY Test Started");
        return EngineResponse::OK;
    }
    
    // 3. Остановка всех тестов
    if (command == UiCommand::STOP_TEST) {
        // Web просит остановить все активные тесты
        if (headTestStatus.active) outputManager->stopHeadValveTest();
        if (bodyTestStatus.active) outputManager->stopBodyValveTest();
        
        headTestStatus.active = false;
        bodyTestStatus.active = false;
        Serial.println("[Process] All Tests Stopped");
        // === ЛОГИРОВАНИЕ ===
        logger.log("[Process] All Tests Stopped");
        return EngineResponse::OK;
    }
    if (command == UiCommand::CALC_VALVE) {
    // Команда приходит с параметром ml из веба — см. AppNetwork.cpp
    // ml передаётся через отдельный API endpoint /api/calcvalve
    return EngineResponse::OK;
}
        // === КОМАНДА ЗАВЕРШИТЬ КАЛИБРОВКУ (ДО проверки VALVE_CAL) ===
    if (command == UiCommand::FINISH_CALIBRATION) {
        if (currentStage == Stage::VALVE_CAL) {
            Serial.println("[WebCmd] Finish Calibration -> SET PW & AS");
            logger.log("[WebCmd] Finish Calibration -> SET PW & AS");
            // === СБРОС АВАРИИ ПРИ ЗАВЕРШЕНИИ КАЛИБРОВКИ ===
            alarmTSA_Active = false;
            alarmBOX_Active = false;
            currentStatus.alarm = AlarmType::NONE;
            currentStatus.safety = SafetyState::NORMAL;
            outputManager->stopAlarm();
            outputManager->resetEmergency();
            // ===============================================
            changeStage(Stage::SET_PW_AS);
            if (setPwAsMenu) setPwAsMenu->display(); 
            return EngineResponse::SHOW_PROCESS_SCREEN;
        }
        // Если мы не в VALVE_CAL, просто игнорируем
        return EngineResponse::OK;
    }

    // === КОМАНДЫ КАЛИБРОВКИ ИЗ WEB (работают в любой момент, ДО проверки VALVE_CAL) ===
    if (command == UiCommand::CALIB_START_DRY) {
        if (valveCalMenu) {
            valveCalMenu->startDryRunFromWeb(param);
            Serial.printf("[WebCmd] Calib DRY: valve=%d\n", param);
        }
        return EngineResponse::OK;
    }
    
    if (command == UiCommand::CALIB_START_CAPACITY) {
        if (valveCalMenu) {
            valveCalMenu->startCapacityFromWeb(param);
            Serial.printf("[WebCmd] Calib CAPACITY: valve=%d\n", param);
        }
        return EngineResponse::OK;
    }
    
    if (command == UiCommand::CALIB_CANCEL) {
        if (valveCalMenu) {
            valveCalMenu->cancelCalibFromWeb();
            Serial.println("[WebCmd] Calib CANCELLED");
        }
        return EngineResponse::OK;
    }
    // === CALIB_SET_VOLUME: передать измеренный объём для расчёта capacity ===
    if (command == UiCommand::CALIB_SET_VOLUME) {
        if (valveCalMenu) {
            valveCalMenu->setVolumeFromWeb((float)param);
            Serial.printf("[WebCmd] Calib SET_VOLUME: %d ml\n", param);
            logger.log("[WebCmd] Calib SET_VOLUME: " + String(param) + " ml");
        }
        return EngineResponse::OK;
    }
    // ================================================================

    // === НОВАЯ КОМАНДА ДЛЯ WEB (Кнопка "ДАЛЕЕ") — ДО проверки VALVE_CAL ===
    if (command == UiCommand::NEXT_STAGE) {
        Serial.printf("[WebCmd] NEXT_STAGE received, currentStage=%d\n", (int)currentStage);
        // === Сессия 20: гвард — ручной переход действует только при запущенном процессе
        // и вне аварии. В IDLE команда бессмысленна, в аварии безопаснее игнорировать. ===
        if (!processRunning || emergencyState || currentStage == Stage::IDLE) {
            Serial.println("[WebCmd] NEXT_STAGE ignored: no running process");
            return EngineResponse::ERROR_NO_PROCESS;
        }
        if (currentStage == Stage::VALVE_CAL) {
            Serial.println("[Web] VALVE CAL -> SET PW & AS");
            // === ЛОГИРОВАНИЕ ===
        logger.log("CMD: VALVE CAL -> SET PW & AS");
            changeStage(Stage::SET_PW_AS);
            // Инициализируем меню, чтобы LCD показал настройки
            if (setPwAsMenu) setPwAsMenu->display();
            return EngineResponse::SHOW_PROCESS_SCREEN;
        }
        else if (currentStage == Stage::SET_PW_AS) {
            Serial.println("[Web] SET PW & AS -> GOLOVY");
            // === ЛОГИРОВАНИЕ ===
        logger.log("CMD:  SET PW & AS -> GOLOVY");
            // Сбрасываем стадию голов перед стартом
            currentGolovyStage = GolovyStage::IDLE;
            changeStage(Stage::GOLOVY);
            return EngineResponse::SHOW_PROCESS_SCREEN;
        }
        // === Сессия 20: ручной переход на следующий этап (одобрено автором) ===
        // Для этапов с «естественным условием завершения» ставим одноразовый флаг:
        // штатное условие на следующем цикле update() сработает раньше (|| skipStageRequested),
        // и переход выполнится РОВНО тем же кодом, что и естественное завершение.
        // RAZGON->WAITING; WAITING->OTBOR/NASEBYA; OTBOR->REPLACEMENT (или BAKSTOP после смены тары);
        // BAKSTOP->FINISHING; NASEBYA->CAL/SET_PW_AS (первый вход) или TELO (после Залёта);
        // FINISHING->досрочное завершение охлаждения (одобрено автором).
        else if (currentStage == Stage::RAZGON || currentStage == Stage::WAITING ||
                 currentStage == Stage::OTBOR  || currentStage == Stage::BAKSTOP  ||
                 currentStage == Stage::NASEBYA || currentStage == Stage::FINISHING_WORK) {
            skipStageRequested = true;
            logger.log(String("CMD: NEXT_STAGE (manual skip) at ") + getStageName(currentStage));
            return EngineResponse::SHOW_PROCESS_SCREEN;
        }
        else if (currentStage == Stage::GOLOVY) {
            // Головы завершены досрочно: штатная процедура finishGolovyStage() —
            // клапан продолжает импульсить до подтверждения (по дизайну GOLOVY_OK)
            logger.log("CMD: NEXT_STAGE (manual skip) at GOLOVY -> GOLOVY_OK");
            finishGolovyStage();
            return EngineResponse::SHOW_PROCESS_SCREEN;
        }
        else if (currentStage == Stage::TELO) {
            // Тело завершено досрочно: штатная процедура finishTelo() —
            // стоп импульсов, закрытие клапанов голов/тела, -> FINISHING_WORK
            logger.log("CMD: NEXT_STAGE (manual skip) at TELO -> FINISHING_WORK");
            finishTelo(configManager->getConfig());
            return EngineResponse::SHOW_PROCESS_SCREEN;
        }
        else if (currentStage == Stage::GOLOVY_OK) {
            // Эквивалент штатного подтверждения «ДА» в диалоге GOLOVY_OK
            return handleCommand(UiCommand::DIALOG_YES);
        }
    }
    // ================================================================

    if (currentStage == Stage::VALVE_CAL) {
        if (command == UiCommand::DIALOG_YES) valveCalMenu->handleSetButton();
        else if (command == UiCommand::DIALOG_NO) valveCalMenu->handleBackButton();
        return EngineResponse::OK;
    }
    // ==============================================================

    if (currentStage == Stage::GOLOVY_OK) {
        if (command == UiCommand::DIALOG_YES) {
            Serial.println("[Process] GOLOVY OK -> TELO");
            const SensorData& data = sensorAdapter->getData();
            logger.log("CMD: GOLOVY OK -> TELO. TSAR: " + String(data.tsar.value, 1) + "C"
                     + "  confirmed by operator");
            outputManager->stopValveCycling(); 
            outputManager->closeHeadValve();
            outputManager->closeBodyValve();
            changeStage(Stage::TELO);
            return EngineResponse::SHOW_PROCESS_SCREEN;
        }
    }

    if (currentStage == Stage::REPLACEMENT) {
        if (command == UiCommand::DIALOG_YES) {
            outputManager->openBodyValve();
            logger.log("REPLACEMENT: confirmed by operator. Resuming OTBOR.");
            changeStage(Stage::OTBOR);
            return EngineResponse::SHOW_PROCESS_SCREEN;
        } else if (command == UiCommand::DIALOG_NO) {
            outputManager->closeBodyValve();
            logger.log("REPLACEMENT: skipped by operator. -> BAKSTOP.");
            changeStage(Stage::BAKSTOP);
            return EngineResponse::SHOW_PROCESS_SCREEN;
        }
    }
        // === ОБРАБОТКА КАЛИБРОВКИ ДАТЧИКОВ (WEB) ===
    if (command == UiCommand::IDENTIFY_TSA || command == UiCommand::IDENTIFY_AQUA || 
    command == UiCommand::IDENTIFY_TSAR || command == UiCommand::IDENTIFY_TANK) {
    
    String name = "TSA";
    if (command == UiCommand::IDENTIFY_AQUA) name = "AQUA";
    else if (command == UiCommand::IDENTIFY_TSAR) name = "TSAR";
    else if (command == UiCommand::IDENTIFY_TANK) name = "TANK";

    currentStatus.webCalibSensorName = name;
    currentStatus.webCalibStatus = 1; // Сразу поиск
    SensorManager::getInstance()->startCalibration(sensorNameToIndex(name));
    Serial.print("[WebCalib] Started for "); Serial.println(name);
    logger.log("CMD: [WebCalib] Started for " + name);
    return EngineResponse::OK;
}
    
     if (command == UiCommand::DIALOG_NO) {
    if (currentStatus.webCalibStatus >= 1 && currentStatus.webCalibStatus <= 3) {
        SensorIndex idx = sensorNameToIndex(currentStatus.webCalibSensorName);
        SensorManager::getInstance()->cancelCalibration(idx);
        currentStatus.webCalibStatus = 0;
        currentStatus.webCalibSensorName = "";
        Serial.println("[WebCalib] Cancelled");
        logger.log("[WebCalib] Cancelled");
        return EngineResponse::OK;
    }
}

    if (command == UiCommand::DIALOG_YES) {
    if (currentStatus.webCalibStatus == 2) { // Найден — сохраняем
        SensorIndex idx = sensorNameToIndex(currentStatus.webCalibSensorName);
        SensorManager::getInstance()->confirmCalibrationSave(idx);
        currentStatus.webCalibStatus = 0;
        currentStatus.webCalibSensorName = "";
        Serial.println("[WebCalib] Saved");
        logger.log("[WebCalib] Saved");
        return EngineResponse::OK;
    }
    if (currentStatus.webCalibStatus == 3) { // Не найден — просто закрываем
        currentStatus.webCalibStatus = 0;
        currentStatus.webCalibSensorName = "";
        return EngineResponse::OK;
    }
    // ... остальной DIALOG_YES (WATER_TEST и т.д.)
}
    if (dialogPending && currentStage == Stage::WATER_TEST) {
        if (command == UiCommand::DIALOG_YES) {
            outputManager->closeWaterValve();
            outputManager->stopMixer();
            dialogPending = false;
            logger.log("WATER TEST: confirmed by operator");
            changeStage(Stage::RAZGON);
            currentStatus.stageName = "RAZGON"; 
            return EngineResponse::SHOW_PROCESS_SCREEN;
        } else if (command == UiCommand::DIALOG_NO) {
            outputManager->closeWaterValve();
            outputManager->stopMixer();
            dialogPending = false;
            // === ЛОГИРОВАНИЕ ===
            logger.log("Process CANCELLED by user (Water Test)");
            stopCurrentProcess(); 
            return EngineResponse::SHOW_PROCESS_MENU;
        }
    }

        if (command == UiCommand::STOP_PROCESS) {
            logger.log("Command: STOP PROCESS (Manual Stop)");
        // Запускаем этап завершения, но НЕ останавливаем процесс таймером!
        // processRunning должен остаться true, чтобы update() крутил логику FINISHING_WORK
        changeStage(Stage::FINISHING_WORK);
        return EngineResponse::SHOW_PROCESS_SCREEN;
    }

    // === Сессия 20: ручное управление клапаном ВОДА из веб-мониторинга ===
    // Доступно ТОЛЬКО когда процесс не запущен: после IND-финала вода остаётся
    // открытой (безопасность индукции) — оператор выключает индукцию вручную
    // и закрывает воду этой кнопкой. Во время процесса вода управляется
    // логикой этапов — ручные команды игнорируются (иначе логика этапа
    // тут же переоткрыла бы клапан, оператор вводился бы в заблуждение).
    if (command == UiCommand::MANUAL_VALVE_WATER_OPEN || command == UiCommand::MANUAL_VALVE_WATER_CLOSE) {
        if (processRunning) {
            Serial.println("[WebCmd] Manual WATER command ignored: process running");
            return EngineResponse::ERROR_BUSY;
        }
        if (command == UiCommand::MANUAL_VALVE_WATER_OPEN) {
            outputManager->openWaterValve();   // внутри гвард emergencyState — при аварии не откроет
            logger.log("CMD: Manual WATER valve OPEN (web)");
        } else {
            // Закрытие разрешено и в аварии (closeWaterValve без гвардов):
            // оператор должен иметь возможность закрыть воду в любой ситуации
            outputManager->closeWaterValve();
            logger.log("CMD: Manual WATER valve CLOSE (web)");
        }
        return EngineResponse::OK;
    }
    
    // --- Запуск DIST ---
    if (command == UiCommand::START_DIST && !processRunning) {
        String errMsg;
        if (!checkSensorsReady(errMsg)) {
            // Сохраняем текст ошибки в статус — меню прочитает его и покажет экран ошибки
            currentStatus.sensorErrorMsg = errMsg;
            Serial.println("[Process] START_DIST BLOCKED. Problem sensors: " + errMsg);
            return EngineResponse::ERROR_INVALID_STATE;
        }
        currentStatus.sensorErrorMsg = ""; // Сброс: датчики в норме
        startProcess(PROCESS_DIST);
        return EngineResponse::SHOW_WATER_TEST;
    }

    // --- Запуск RECT ---
    if (command == UiCommand::START_RECT && !processRunning) {
        String errMsg;
        if (!checkSensorsReady(errMsg)) {
            currentStatus.sensorErrorMsg = errMsg;
            Serial.println("[Process] START_RECT BLOCKED. Problem sensors: " + errMsg);
            return EngineResponse::ERROR_INVALID_STATE;
        }
        currentStatus.sensorErrorMsg = ""; // Сброс: датчики в норме
        startProcess(PROCESS_RECT);
        return EngineResponse::SHOW_WATER_TEST;
    }
    
    return EngineResponse::OK;
}

bool ProcessEngine::startProcess(ProcessType type) {
    if (processRunning) return false;
    activeProcess = type; // Сначала запоминаем тип процесса
    processRunning = true;
    processStartTime = procNow();  // Этап 2.1: часы процесса идут в сим-времени
    counter = 0;
    nasebTimeOverride = 0;   // ФИКС L1: сброс одноразовой подмены от прошлого процесса
    
    emergencyState = false; alarmTSA_Active = false; alarmBOX_Active = false;
    outputManager->stopAlarm(); outputManager->resetEmergency();
    
    razgonMixerStarted = false;
    midtermHandled = false;
    
    // Сброс переменных TELO при старте
    rtsarM = 0.0f;
    adPressM = 0.0f;
    teloBmeReferenceCaptured = false;
    teloBmeWasAvailable = true;
    teloLastOpenMs = -1;
    teloLastCloseMs = -1;
    // Сессия 16: сброс отложенного захвата опорных значений
    teloRefCaptured = false;
    teloRefTimerStart = 0;

    // === НОВОЕ: Сброс накопленного объема голов ===
    headsVolDone = 0.0f;
    lastVolCalcTime = procNow();  // Этап 2.1: интегратор объёма — на сим-часы
    // ==============================================
    if (type == PROCESS_DIST) {
        outputManager->setBodyValveType(false); 
    } else {
        outputManager->setBodyValveType(configManager->getConfig().bodyValveNC);
    }
    
    configManager->startProcess(type); 
String procName = getProcessName();
    Serial.print("[Process] START: ");
    Serial.println(getProcessName()); // Вывод названия процесса (исправлено)
 // === ДОБАВИТЬ ЛОГИРОВАНИЕ ===
    logger.log("Process START: " + procName);
    // Ключевые параметры конфигурации
    SystemConfig& cfg = configManager->getConfig();
    if (type == PROCESS_DIST) {
        // Сессия 10: midterm в десятых долях — лог с одним знаком + крепость отбора.
        // Сессия 11: уставка приведена к 760 мм рт.ст. (указываем в логе для ясности)
        logger.log("  razgonTemp: " + String(cfg.razgonTemp) + "C"
                 + "  bakStopTemp: " + String(cfg.bakStopTemp) + "C"
                 + "  midterm: " + String(cfg.midterm * 0.1f, 1) + "C ref760"
                 + " (" + String(cfg.midterm_abv * 0.1f, 1) + "%)" );
    } else {
        logger.log("  razgonTemp: " + String(cfg.razgonTemp) + "C"
                 + "  asVolume: " + String(cfg.asVolume) + "L"
                 + "  nasebTime: " + String(cfg.nasebTime) + "min"
                 + "  reklapTime: " + String(cfg.reklapTime) + "min");
    }
    // ============================
    changeStage(Stage::WATER_TEST);

    // === Этап 2.1: авто-стоп РАБОЧЕГО хода SIM — 60 минут РЕАЛЬНОГО времени ===
    // Защита забытого на стенде процесса: движок видит синтетические температуры
    // и может «греть» бесконечно. Вооружается только при активном SIM в рабочем
    // ходе; сухой ход физически безопасен — дедлайн не ставится. Отключается
    // тумблером SIM_AUTOSTOP в панели (проверка — каждый тик update()).
    {
        SimSensors* sim = SimSensors::getInstance();
        if (sim->isActive() && !sim->isDryRun()) {
            simAutoStopAt = millis() + 3600000UL;  // 60 мин реального времени (не сим!)
            logger.log("SIM: РАБОЧИЙ ход — авто-стоп через 60 мин реального времени (тумблер в панели)");
        } else {
            simAutoStopAt = 0;
            if (sim->isActive()) logger.log("SIM: СУХОЙ ход — выходы физически не переключаются");
        }
    }
    return true;
}

bool ProcessEngine::stopCurrentProcess() {
    if (!processRunning) return false;
    processRunning = false;
    activeProcess = PROCESS_NONE;
    configManager->stopProcess();
    changeStage(Stage::IDLE);
    return true;
}

void ProcessEngine::emergencyStop() {
    emergencyState = true;
    processRunning = false;
    outputManager->emergencyStop();
    // === ЛОГИРОВАНИЕ ===
    logger.log("!!! EMERGENCY STOP TRIGGERED !!!");
    // ==================
    changeStage(Stage::IDLE);
    currentStatus.stageName = "EMERGENCY";
}

// ==================== STAGE HANDLERS ====================
void ProcessEngine::printStartupInfo() {
    Serial.println(F("\n========================================"));
    Serial.println(F("       SYSTEM STARTUP REPORT"));
    Serial.println(F("========================================"));
    
    // 1. Загрузка конфигурации
    SystemConfig cfg = configManager->getConfig();
    
    // 2. Прогрев датчиков
    Serial.println(F("Sensors warm-up..."));
    sensorAdapter->update(); 
    delay(1000);             
    sensorAdapter->update(); 
    
    const SensorData& data = sensorAdapter->getData();

    // --- БЛОК 1: СИСТЕМА ---
    Serial.println(F("--- SYSTEM CONFIG ---"));
    Serial.print(F("  Heater Type    : ")); Serial.println(cfg.heaterType);
    Serial.print(F("  Power (W)      : ")); Serial.println(cfg.power);
    Serial.print(F("  Full Power     : ")); Serial.println(cfg.fullPwr ? "YES" : "NO");

    // --- БЛОК 2: ДИСТИЛЛЯЦИЯ (DIST) ---
    Serial.println(F("\n--- DISTILLATION SETTINGS ---"));
    Serial.print(F("  Valve Use      : ")); Serial.println(cfg.valveuse ? "YES" : "NO");
    Serial.print(F("  Midterm Temp   : ")); Serial.print(cfg.midterm * 0.1f, 1); Serial.println(" C");
    Serial.print(F("  BakStop Temp   : ")); Serial.print(cfg.bakStopTemp); Serial.println(" C");
    Serial.print(F("  Mixer Enabled  : ")); Serial.println(cfg.mixerEnabled ? "YES" : "NO");
    if (cfg.mixerEnabled) {
        Serial.print(F("  Mixer On (s)   : ")); Serial.println(cfg.mixerOnTime);
        Serial.print(F("  Mixer Off (s)  : ")); Serial.println(cfg.mixerOffTime);
    }

    // --- БЛОК 3: РЕКТИФИКАЦИЯ (RECT) ---
    Serial.println(F("\n--- RECTIFICATION SETTINGS ---"));
    Serial.print(F("  AS_Volume      : ")); Serial.println(cfg.asVolume);
    Serial.print(F("  Cycle Limit    : ")); Serial.println(cfg.cycleLim);
    Serial.print(F("  Calibraton     : ")); Serial.println(cfg.calibration ? "YES" : "NO");
    Serial.print(F("  Razgon Temp    : ")); Serial.print(cfg.razgonTemp); Serial.println(" C");
    Serial.print(F("  Naseb Time(m)  : ")); Serial.println(cfg.nasebTime);
    Serial.print(F("  Reklap Time(m) : ")); Serial.println(cfg.reklapTime);
    
    // --- БЛОК 4: КЛАПАНА (VALVES) ---
    Serial.println(F("\n--- VALVE TIMINGS & CAPACITY ---"));
    // Головы
    Serial.print(F("  Use Head Valve : ")); Serial.println(cfg.useHeadValve ? "YES" : "NO");
    Serial.print(F("  Heads Type KSS : ")); Serial.println(cfg.headsTypeKSS ? "YES" : "NO");
    Serial.print(F("  Head Open (s)  : ")); Serial.println(cfg.headOpenSec);
    Serial.print(F("  Head Close (s) : ")); Serial.println(cfg.headCloseSec);
    Serial.print(F("  Head Cap (ml/m): ")); Serial.println(cfg.valve_head_capacity);
    // Тело
    Serial.print(F("  Body Valve NC  : ")); Serial.println(cfg.bodyValveNC ? "NC" : "NO");
    Serial.print(F("  Body Open (s)  : ")); Serial.println(cfg.bodyOpenSec);
    Serial.print(F("  Body Close (s) : ")); Serial.println(cfg.bodyCloseSec);
    Serial.print(F("  Body Cap (ml/m): ")); Serial.println(cfg.valve_body_capacity);
    Serial.print(F("  Body Cap0(NO)  : ")); Serial.println(cfg.valve0_body_capacity);
    
    // Параметры TELO
    Serial.print(F("  Delta (C)      : ")); Serial.println(cfg.delta);
    Serial.print(F("  Histeresis (C) : ")); Serial.println(cfg.histeresis);
    // Correlation теперь константа, но выводим то, что в памяти для информации
    Serial.print(F("  Correlation(E) : ")); Serial.println(cfg.correlation); 

    // --- БЛОК 5: БЕЗОПАСНОСТЬ И СЕТЬ ---
    Serial.println(F("\n--- SAFETY & NETWORK ---"));
    Serial.print(F("  TSA Limit (C)  : ")); Serial.println(cfg.tsaLimit);
    Serial.print(F("  Box Max Temp(C): ")); Serial.println(cfg.boxMaxTemp);
    Serial.print(F("  Emergency (min): ")); Serial.println(cfg.emergencyTime);
    Serial.print(F("  WiFi Check(m)  : ")); Serial.println(cfg.chekwifi);     // ИСПРАВЛЕНО
    Serial.print(F("  Active Test(s) : ")); Serial.println(cfg.active_test);  // ИСПРАВЛЕНО

    // --- БЛОК 6: ДАТЧИКИ ---
    Serial.println(F("\n--- SENSORS (CURRENT) ---"));
    Serial.print(F("  TSA (Cube)     : ")); Serial.print(data.tsa.value); Serial.println(" C");
    Serial.print(F("  TSAR (Column)  : ")); Serial.print(data.tsar.value); Serial.println(" C");
    Serial.print(F("  AQUA (Water)   : ")); Serial.print(data.aqua.value); Serial.println(" C");
    Serial.print(F("  TANK (Def)     : ")); Serial.print(data.tank.value); Serial.println(" C");
    Serial.print(F("  Pressure (hPa) : ")); Serial.println(data.pressure);
    Serial.print(F("  Box Temp       : ")); Serial.print(data.boxTemp); Serial.println(" C");
    
    Serial.println(F("========================================"));
    Serial.println(F("System Ready. Waiting for command..."));
    Serial.println();
    logger.log("System Ready. Waiting for command...");
}
void ProcessEngine::handleIdleState() {}

void ProcessEngine::handleWaterTest() {
    currentStatus.stageName = "WATER_TEST"; 
    if (!dialogPending) {
        outputManager->openWaterValve(); 
        if (activeProcess == PROCESS_DIST && configManager->getConfig().mixerEnabled) outputManager->startMixer();
        dialogPending = true;
        
    }
}

void ProcessEngine::handleRazgon() {
    currentStatus.stageName = "RAZGON";
    const SensorData& data = sensorAdapter->getData();
    SystemConfig& cfg = configManager->getConfig(); 

    if (cfg.heaterType == 0) { 
        if (activeProcess == PROCESS_RECT) outputManager->setHeater(true, true); 
        else outputManager->setHeater(true, cfg.fullPwr);
    } else {
        outputManager->setHeater(false, false);
    }

    if (activeProcess == PROCESS_DIST && cfg.mixerEnabled) {
        if (!outputManager->isMixerCycling()) outputManager->startMixerCycling(cfg.mixerOnTime, cfg.mixerOffTime);
    } else if (outputManager->isMixerCycling()) outputManager->stopMixer();

    // === Сессия 20: || skipStageRequested — ручной переход «ДАЛЕЕ» (кнопка в веб).
    // Переход выполняется этим же кодом: нагрев на поддержание, вода, инициализация клапанов ===
    if (data.tank.value >= cfg.razgonTemp || skipStageRequested) {
        if (skipStageRequested && data.tank.value < cfg.razgonTemp) {
            logger.log("RAZGON: skipped by operator (TANK " + String(data.tank.value, 1) + "C < set " + String(cfg.razgonTemp) + "C)");
        }
        Serial.println("[Process] RAZGON complete.");
        logger.log("[Process] RAZGON complete."
                 + String("  TSA: ") + String(data.tsa.value, 1) + "C"
                 + "  time: " + String(procNow() / 60000) + "min");
        if (cfg.heaterType == 0) outputManager->setHeater(true, false);
        outputManager->openWaterValve();

                if (activeProcess == PROCESS_RECT) {
            // Инициализация клапанов для RECT
            if (cfg.useHeadValve) outputManager->closeHeadValve(); // Головы всегда NC -> Close = LOW
            outputManager->closeBodyValve(); // Close учитывает тип (NC->LOW, NO->HIGH)
        } else {
            // Инициализация клапанов для DIST
            if (cfg.useHeadValve) outputManager->closeHeadValve();
            // В DIST используется только НО клапан.
            // "Открыть" для НО -> LOW. Функция openBodyValve сделает это, если в конфиге NO.
            if (cfg.valveuse) outputManager->openBodyValve(); 
        }
        changeStage(Stage::WAITING);
    }
}

void ProcessEngine::handleWaiting() {
    currentStatus.stageName = "WAITING";
    const SensorData& data = sensorAdapter->getData();
    SystemConfig& cfg = configManager->getConfig(); 

    outputManager->openWaterValve();

    if (activeProcess == PROCESS_DIST && cfg.mixerEnabled) {
        if (!outputManager->isMixerCycling()) outputManager->startMixerCycling(cfg.mixerOnTime, cfg.mixerOffTime);
    } else if (outputManager->isMixerCycling()) outputManager->stopMixer();

    if (activeProcess == PROCESS_RECT && !cfg.bodyValveNC) outputManager->closeBodyValve();

    if (previousStage != Stage::WAITING) { 
        waitingRefCaptured = false;   // Новый заход в этап: точку отсчёта берём заново
        if (data.isTsarValid()) {
            initialTsarTemp = data.tsar.value;   // Датчик исправен — точка отсчёта сразу
            waitingRefCaptured = true;
        } else {
            // ФИКС L2: НЕ ставим initialTsarTemp = 0.0f (старый код).
            // Порог выхода был бы 0 + 5 = 5 °C, и этап завершился бы сразу
            // после восстановления датчика: любая горячая колонна выше 5 °C,
            // реальный прогрев не проверялся бы вовсе.
            logger.log("WARNING: TSAR not valid at WAITING start! Waiting for sensor...");
            Serial.println("[WAITING] TSAR invalid at start, waiting for sensor recovery.");
        }
        logger.log("WAITING: start. TSAR: " + String(data.tsar.value, 1) + "C"
                 + "  TSA: " + String(data.tsa.value, 1) + "C");
        previousStage = Stage::WAITING; 
    }

    // Динамический захват точки отсчёта: если на входе датчик был не готов,
    // берём ПЕРВЫЙ валидный замер как точку отсчёта (выполняется один раз).
    if (!waitingRefCaptured && data.isTsarValid()) {
        initialTsarTemp = data.tsar.value;
        waitingRefCaptured = true;
        logger.log("WAITING: TSAR ready. Reference captured: " + String(initialTsarTemp, 1) + "C");
        Serial.println("[WAITING] TSAR ready, reference captured: " + String(initialTsarTemp, 1) + "C");
    }

    // Выход только если точка отсчёта захвачена, датчик валиден и прогрелся на 5°C
    // === Сессия 20: || skipStageRequested — ручной переход «ДАЛЕЕ» (кнопка в веб) ===
    if (skipStageRequested || (waitingRefCaptured && data.isTsarValid() && data.tsar.value >= (initialTsarTemp + 5.0f))) {
        if (skipStageRequested && !(waitingRefCaptured && data.tsar.value >= (initialTsarTemp + 5.0f))) {
            logger.log("WAITING: skipped by operator (TSAR " + String(data.tsar.value, 1) + "C)");
        }
        logger.log("WAITING: complete. TSAR: " + String(data.tsar.value, 1) + "C"
                 + "  time: " + String(currentStatus.stageTimeSec / 60) + "min");
        if (activeProcess == PROCESS_DIST) changeStage(Stage::OTBOR);
        else changeStage(Stage::NASEBYA);
    }
}

// ==================== DIST LOGIC ====================

// Статические переменные для Midterm (смена тары)
// Сессия 11: уставка cfg.midterm хранится как температура куба, ПРИВЕДЁННАЯ к 760 мм рт.ст.
// (эталон таблицы крепостей). Поэтому триггер использует ЖИВОЕ давление на всём протяжении
// этапа OTBOR: оно обновляется при каждом доступном опросе BME; при пропаче датчика
// остаётся последнее известное значение (data.pressure хранит последний корректный отсчёт);
// если BME не было доступно ни разу — используется 760 (коррекция отсутствует).
// Раньше давление замораживалось на старте OTBOR, а уставка в web считалась по давлению
// в момент сохранения настроек — при их рассогласовании сдвиг срабатывания доходил
// до 0.037*C на каждый мм рт.ст. (~1.1C при 30 мм рт.ст.).
static bool distBmeReferenceCaptured = false;   // BME был доступен хотя бы раз за этап
static bool distBmeWasAvailable = true;         // состояние на предыдущей итерации
static float distMidtermPressureMmHg = 760.0f;  // ЖИВОЕ (или последнее известное) давление, мм рт.ст.

void ProcessEngine::handleDistOtbor() {
    currentStatus.stageName = "OTBOR";
    const SensorData& data = sensorAdapter->getData();
    SystemConfig& cfg = configManager->getConfig(); 

    if (previousStage != Stage::OTBOR) {
        logger.log("OTBOR: start. TANK: " + String(data.tank.value, 1) + "C");
        previousStage = Stage::OTBOR;
        
        // === СТАРТ ОТСЛЕЖИВАНИЯ ДАВЛЕНИЯ ДЛЯ MIDTERM (Сессия 11: живое давление) ===
        if (currentStatus.bmeAvailable) {
            distMidtermPressureMmHg = data.pressure * 0.75006f; // гПа -> мм рт.ст.
            distBmeReferenceCaptured = true;
            distBmeWasAvailable = true;
            logger.log("OTBOR: BME pressure tracking for Midterm. Pressure: " + String(distMidtermPressureMmHg, 1) + " mmHg");
        } else {
            distMidtermPressureMmHg = 760.0f; // коррекция без BME невозможна — считаем уставку эталонной
            distBmeReferenceCaptured = false;
            distBmeWasAvailable = false;
            logger.log("WARNING: BME280 not available at OTBOR start! Midterm correction DISABLED (P=760).");
        }
        // ===========================================================================
    }
    
    // Живое давление: обновляем на КАЖДОЙ итерации при доступном BME (Сессия 11).
    // При пропаче датчика просто перестаём обновлять — переменная хранит последнее
    // известное значение (заморозка). При восстановлении/первом появлении — продолжаем.
    if (currentStatus.bmeAvailable) {
        bool bmeJustCameOnline = !distBmeWasAvailable;
        distMidtermPressureMmHg = data.pressure * 0.75006f; // гПа -> мм рт.ст.
        distBmeReferenceCaptured = true;
        distBmeWasAvailable = true;
        if (bmeJustCameOnline) {
            logger.log("OTBOR: BME online. Midterm pressure: " + String(distMidtermPressureMmHg, 1) + " mmHg");
        }
    } else if (distBmeWasAvailable && distBmeReferenceCaptured) {
        logger.log("OTBOR: BME lost! Midterm pressure frozen at: " + String(distMidtermPressureMmHg, 1) + " mmHg");
        distBmeWasAvailable = false;
    }

    if (cfg.mixerEnabled) {
        if (!outputManager->isMixerCycling()) outputManager->startMixerCycling(cfg.mixerOnTime, cfg.mixerOffTime);
    } else if (outputManager->isMixerCycling()) outputManager->stopMixer();

        // Логика Midterm (Смена посуды)
    if (!midtermHandled) {
        // Сессия 10: уставка хранится x10 — рабочий порог float без округления до целого.
        // Сессия 11: уставка — температура куба, приведённая к 760 мм рт.ст.; сравниваем
        // с ней ЖИВУЮ приведённую температуру. Поправка: T_прив = T_изм + (760 - P)*0.037,
        // т.е. при давлении ниже 760 срабатывание происходит при более НИЗКОЙ сырой
        // температуре куба (та же концентрация — кипение ниже). Предварительный фильтр
        // по сырой T убран: при P<760 он блокировал коррекцию (поправка положительная,
        // но фильтр не пропускал, пока сырая T не дойдёт до уставки — поправка инертна).
        float midtermSet = cfg.midterm * 0.1f;

        // Приведённая к 760 мм рт.ст. температура куба (живое/последнее известное давление)
        float tankCorrected = data.tank.value + (760.0 - distMidtermPressureMmHg) * 0.037;

        // === Сессия 20: || skipStageRequested — ручной переход «ДАЛЕЕ»: форс смены тары ===
        if (tankCorrected >= midtermSet || skipStageRequested) {
            if (skipStageRequested && tankCorrected < midtermSet) {
                logger.log("OTBOR: midterm skipped by operator (T760 " + String(tankCorrected, 1) + "C < set " + String(midtermSet, 1) + "C)");
            }
            if (cfg.valveuse) outputManager->closeBodyValve();
            midtermHandled = true;
            logger.log("OTBOR: midterm reached. T=" + String(data.tank.value, 1) + "C (Reduced to 760: " + String(tankCorrected, 1) + "C, set " + String(midtermSet, 1) + "C/" + String(cfg.midterm_abv * 0.1f, 1) + "%, P=" + String(distMidtermPressureMmHg, 0) + " mmHg)");
            changeStage(Stage::REPLACEMENT);
            return;
        }
    }

    // Логика остановки по температуре бака
    // === Сессия 20: (skipStageRequested && midtermHandled) — после смены тары «ДАЛЕЕ»
    // ведёт в БАКСТОП (форс bakStop). До смены тары «ДАЛЕЕ» перехватывается блоком
    // midterm выше (там стоит return), сюда флаг не доходит ===
    if (data.tank.value >= cfg.bakStopTemp || (skipStageRequested && midtermHandled)) {
        if (skipStageRequested && data.tank.value < cfg.bakStopTemp) {
            logger.log("OTBOR: bakStop skipped by operator (TANK " + String(data.tank.value, 1) + "C < set " + String(cfg.bakStopTemp) + "C)");
        }
        if (cfg.valveuse) outputManager->closeBodyValve();
        logger.log("OTBOR: bakStop reached. TANK: " + String(data.tank.value, 1) + "C");
        changeStage(Stage::BAKSTOP);
    }
}

void ProcessEngine::handleDistReplacement() { currentStatus.stageName = "REPLACEMENT"; }

void ProcessEngine::handleDistBakstop() {
    currentStatus.stageName = "BAKSTOP";

    if (previousStage != Stage::BAKSTOP) {
        const SensorData& data = sensorAdapter->getData();
        outputManager->setHeaterPowerOff();
        logger.log("BAKSTOP: start. TANK: " + String(data.tank.value, 1) + "C");
        logger.log("BAKSTOP: Heater power OFF (contactor kept)");
        Serial.println("[BAKSTOP] Heater power pins OFF");
        previousStage = Stage::BAKSTOP;
    }

    // === Сессия 20: || skipStageRequested — ручной переход «ДАЛЕЕ»: форс выхода из БАКСТОП ===
    if (currentStatus.stageTimeSec >= configManager->getConfig().bakstopDelaySec || skipStageRequested) changeStage(Stage::FINISHING_WORK);
}

// ==================== RECT LOGIC ====================

void ProcessEngine::handleNasebya() {
    currentStatus.stageName = "NASEBYA";
    SystemConfig& cfg = configManager->getConfig();
    outputManager->openWaterValve();

    if (previousStage != Stage::NASEBYA) {
        const SensorData& data = sensorAdapter->getData();
        // ФИКС L1: показываем фактическую цель этапа (после залёта это reklapTime)
        int effNaseb = (nasebTimeOverride > 0) ? nasebTimeOverride : cfg.nasebTime;
        logger.log("NASEBYA: start. TSAR: " + String(data.tsar.value, 1) + "C"
                 + "  target: " + String(effNaseb) + "min");
        previousStage = Stage::NASEBYA;
    }
    
    // ФИКС L1: таймер этапа использует одноразовую подмену, если она активна
    unsigned long targetSeconds = (unsigned long)((nasebTimeOverride > 0) ? nasebTimeOverride : cfg.nasebTime) * 60;
    
    // === ЛОГИКА ЗАВЕРШЕНИЯ СТАБИЛИЗАЦИИ ===
    // === Сессия 20: || skipStageRequested — ручной переход «ДАЛЕЕ»: форс завершения стабилизации ===
    if (currentStatus.stageTimeSec >= targetSeconds || skipStageRequested) {
        const SensorData& data = sensorAdapter->getData();
        Serial.println("[Process] NASEBYA complete.");
        logger.log("[Process] NASEBYA complete. TSAR: " + String(data.tsar.value, 1) + "C");

        // 1. Первый вход (counter == 0) -> переход к настройкам или калибровке
        if (counter == 0) {
            if (cfg.calibration) {
                changeStage(Stage::VALVE_CAL);
                valveCalMenu->display(); 
            } else {
                changeStage(Stage::SET_PW_AS);
                if (setPwAsMenu) setPwAsMenu->display();
            }
        } 
        // 2. Повторный вход (только для метода Стандарт)
        // Шпора сюда не попадает, она сразу финишит при Залёте.
        else {
            const SensorData& data = sensorAdapter->getData();
            
            // Пересчитываем поправку давления (актуальная на текущий момент)
            float pCorr = (data.pressure - adPressM) * cfg.pressureCoeff;
            
            // Порог возврата: должна упасть ниже уставки Залёта (rtsarM + Histeresis)
            float threshold = rtsarM + cfg.histeresis + pCorr;

            logger.log("NASEBYA (zalyot): TSAR: " + String(data.tsar.value, 2) + "C"
                     + "  threshold: " + String(threshold, 2) + "C"
                     + "  time: " + String(currentStatus.stageTimeSec / 60) + "min");

            // === Сессия 20: || skipStageRequested — после Залёта «ДАЛЕЕ» форсирует возврат
            // в ТЕЛО даже если TSAR ещё не упала ниже порога (решение оператора, логируем) ===
            if (data.tsar.value < threshold || skipStageRequested) {
                if (skipStageRequested && data.tsar.value >= threshold) {
                    logger.log("NASEBYA: return to TELO forced by operator (TSAR " + String(data.tsar.value, 2) + "C still above threshold " + String(threshold, 2) + "C)");
                }
                Serial.println("[Process] TSAR normalized. Resuming TELO.");
                logger.log("TSAR normalized. Resuming TELO.");
                // Сброс таймера расчёта объёма: без этого первый dt_h
                // после NASEBYA охватит всё время "на себя" (клапан был закрыт),
                // и фантомный объём (скорость × время_NASEBYA) прибавится к bodyVolDone
                lastVolCalcTime = procNow();  // Этап 2.1: тот же сим-базис, что у интегратора
                changeStage(Stage::TELO);
            } else {
                Serial.println("[Process] TSAR still high! Finishing process.");
                logger.log("TSAR still high after stabilization! Finishing process.");
                changeStage(Stage::FINISHING_WORK);
            }
        }
    }
}

// ==================== GOLOVY LOGIC ====================

// === РАСЧЁТ ТАЙМИНГОВ КЛАПАНА (с уменьшением износа) ===
void ProcessEngine::calcValveTiming(float targetSpeed, float capacity, int& openMs, int& closeMs) {
    SystemConfig& cfg = configManager->getConfig();
    int minOpen = cfg.minOpenTime > 0 ? cfg.minOpenTime : 100;
    
    if (capacity <= 0) {
        openMs = minOpen;
        closeMs = 1000;
        return;
    }
    
    float dutyCycle = targetSpeed / (capacity * 60.0f);
    if (dutyCycle > 0.9f) dutyCycle = 0.9f;
    if (dutyCycle < 0.001f) dutyCycle = 0.001f;
    
    // === ОПТИМИЗАЦИЯ ИЗНОСА КЛАПАНА ===
    // Используем minOpen как базу для длины цикла
    // Если нужна большая скорость - увеличиваем время открытия (меньше срабатываний)
    // Если нужна маленькая скорость - используем minOpen как раньше
    
    float idealOpenMs = dutyCycle * minOpen;  // Идеальное время открытия для данного duty cycle
    
    if (idealOpenMs >= minOpen) {
        // Большая скорость: увеличиваем время открытия, уменьшаем износ
        openMs = (int)(idealOpenMs + 0.5f);
        closeMs = minOpen - openMs;  // closeMs теперь меньше
    } else {
        // Маленькая скорость: используем минимум
        openMs = minOpen;
    }
    
    // Рассчитываем closeMs для маленькой скорости
    float closeMsCalc = (float)openMs * (1.0f - dutyCycle) / dutyCycle;
    
    if (idealOpenMs < minOpen) {
        closeMs = (int)(closeMsCalc + 0.5f);
    }
    
    if (closeMs < 100) closeMs = 100;
}

void ProcessEngine::handleGolovy() {
    currentStatus.stageName = "GOLOVY";
    SystemConfig& cfg = configManager->getConfig();

    // === Расчет накопленного объема голов (Вариант A) ===
    // Скорость рассчитывается по реальному расходу клапана с учётом duty cycle
    unsigned long now = procNow();  // Этап 2.1: объёмы интегрируются в сим-времени
    float dt_h = (float)(now - lastVolCalcTime) / 3600000.0f;
    lastVolCalcTime = now;

    // Расчёт реальной скорости отбора
    float accumSpeed = 0.0f;
    float corrFactor = cfg.speedHeadCorr / 100.0f;  // Коррекция скорости голов (0-200%)
    
    // === ВАЖНО: Рассчитываем скорости ВСЕГДА ===
    koff = cfg.power / 1000.0f;
    speedGolovy = koff * (float)cfg.speedGolovyBase;
    speedTelo = koff * (float)cfg.speedTeloBase;
    // ===============================================================
    
    if (currentGolovyStage != GolovyStage::IDLE) {
        if (currentGolovyStage == GolovyStage::KSS_SPIT) {
            // Spit: клапан открыт постоянно → реальная пропускная способность
            float cap = cfg.useHeadValve    ? (float)cfg.valve_head_capacity :
                        cfg.bodyValveNC     ? (float)cfg.valve_body_capacity :
                                              (float)cfg.valve0_body_capacity;
            accumSpeed = cap * 60.0f;  // перевести мл/мин в мл/ч
        }
        else {
            // Standard/AkaTelo: используем эталонную скорость
            // speedGolovy уже рассчитана как 50 * koff для голов
            // speedTelo рассчитана как 500 * koff для тела
            if (currentGolovyStage == GolovyStage::KSS_STANDARD || 
                currentGolovyStage == GolovyStage::ST_MAIN) {
                accumSpeed = speedGolovy * corrFactor;
            } else {
                // KSS_AKATELO - используем скорость тела
                accumSpeed = speedTelo * (cfg.speedBodyCorr / 100.0f);
            }
        }
    }
    headsVolDone += accumSpeed * dt_h;
    headsVolSub += accumSpeed * dt_h;  // Также считаем объём для текущего подэтапа

    // Обновляем статус для веба
    currentStatus.headsVolDone = headsVolDone;
    currentStatus.headsVolSub = headsVolSub;  // Добавлено: объём для подэтапа
    currentStatus.headsSpeed = accumSpeed;        // Реальная скорость по capacity клапана
    currentStatus.headsSpeedCalc = speedGolovy;   // Расчётная скорость для времени этапа
    currentStatus.bodySpeed = 0.0f;
    // ==============================================
    
    if (currentGolovyStage == GolovyStage::IDLE) {
        const SensorData& data = sensorAdapter->getData();
        logger.log("GOLOVY: init. TSAR: " + String(data.tsar.value, 1) + "C"
                 + "  koff: " + String(koff, 2) + "  speed: " + String(speedGolovy, 1) + " ml/h");

        if (cfg.headsTypeKSS) startKssSpit(cfg);
        else startStandardGolovy(cfg);
    }

    switch (currentGolovyStage) {
        case GolovyStage::ST_MAIN:
            if (headsVolSub >= currentStatus.rectVolumeTarget) {
                Serial.println("[GOLOVY] ST Main complete.");
                logger.log("GOLOVY: Standard Stage Complete");
                finishGolovyStage(); 
            }
            break;

        case GolovyStage::KSS_SPIT:
            if (headsVolSub >= currentStatus.rectVolumeTarget) {
                Serial.println("[GOLOVY] KSS Spit complete. Vol: " + String(headsVolSub, 1) + " ml");
                logger.log("[GOLOVY] KSS Spit complete. Vol: " + String(headsVolSub, 1) + " ml");
                if (cfg.useHeadValve) outputManager->closeHeadValve();
                else outputManager->closeBodyValve();
                
                startKssStandard(cfg);
            }
            break;

        case GolovyStage::KSS_STANDARD:
            if (headsVolSub >= currentStatus.rectVolumeTarget) {
                Serial.println("[GOLOVY] KSS Standard complete. Vol: " + String(headsVolSub, 1) + " ml");
                logger.log("[GOLOVY] KSS Standard complete. Vol: " + String(headsVolSub, 1) + " ml");
                outputManager->stopValveCycling();
                startKssAkaTelo(cfg);
            }
            break;

        case GolovyStage::KSS_AKATELO:
            if (headsVolSub >= currentStatus.rectVolumeTarget) {
                Serial.println("[GOLOVY] KSS AkaTelo complete. Vol: " + String(headsVolSub, 1) + " ml");
                logger.log("[GOLOVY] KSS AkaTelo complete. Vol: " + String(headsVolSub, 1) + " ml");
                finishGolovyStage();
            }
            break;
        default: break;
    }
}

void ProcessEngine::handleGolovyOk() {
    currentStatus.stageName = "GOLOVY_OK";  // Исправлено: было "GOLOVY OK?" (с пробелом)
    outputManager->openWaterValve();
}

// --- Вспомогательные функции GOLOVY ---

// --- Standard ---
void ProcessEngine::startStandardGolovy(SystemConfig& cfg) {
    // Сессия 14: явный объём голов (web «ГОЛОВЫ (ml)»). Если задан (>0) — отбираем
    // ровно его, без привязки к АС. Скорость прежняя (от мощности: speedGolovy = koff*base).
    // 0 = авто — прежний расчёт от АС. KSS этот параметр не использует (см. updateRectWebInfo).
    float headVol = (cfg.headsManualMl > 0) ? (float)cfg.headsManualMl
                                            : cfg.asVolume * cfg.headsShareStd;
    float vHeadMin = (headVol / speedGolovy) * 60.0f;
    golovyTargetTime = (unsigned long)(vHeadMin * 60.0f); 

    currentGolovyStage = GolovyStage::ST_MAIN;
    stageStartTime = procNow();  // Этап 2.1: таймер этапа в сим-времени
    
    // === СБРОС СЧЁТЧИКА ОБЪЁМА ПОДЭТАПА ===
    headsVolSub = 0.0f;
    currentStatus.headsVolTarget = (int)headVol;
    currentStatus.rectVolumeTarget = (int)headVol;  // Используется для проверки завершения
    // =====================================

    // === ЛОГИРОВАНИЕ ===
    logger.log("GOLOVY: Standard Start");
    logger.log("  Target Vol: " + String(headVol, 1) + " ml");
    logger.log("  Duration: " + String(vHeadMin, 1) + " min");
    // ==================
    
    Serial.print("[GOLOVY] ST Method. Time: "); Serial.print(vHeadMin); Serial.println(" min");
    Serial.print("[GOLOVY] ST Method. Speed: "); Serial.print(speedGolovy, 1); Serial.println(" ml/h");

    if (cfg.useHeadValve) {
        // Конфиг 1 или 2: Есть клапан голов
        int openMs, closeMs;
        float targetSpeed = speedGolovy * (cfg.speedHeadCorr / 100.0f);
        calcValveTiming(targetSpeed, (float)cfg.valve_head_capacity, openMs, closeMs);
        Serial.printf("[GOLOVY] ST: Calc timing - open=%dms, close=%dms, target=%.1f ml/h\n", 
            openMs, closeMs, targetSpeed);
        outputManager->startHeadValveCycling(openMs, closeMs);
        outputManager->closeBodyValve(); // Тело закрыто
    } else {
        // Нет клапана голов, работаем через тело
        if (cfg.bodyValveNC) {
            // Конфиг 3: Body(NC). Импульсный режим с capacity для голов
            // Сессия 18: capacity берём от ТОГО клапана, через который идёт отбор.
            // При откалиброванном BCH (старые платы с 2-точечной калибровкой) — он;
            // иначе BCAP (valve_body_capacity) — откалиброванная capacity этого же
            // НЗ клапана. Прежний fallback на valve_head_capacity был ошибкой:
            // клапана голов в этой конфигурации НЕТ, и тайминги считались от
            // дефолтной/чужой capacity — фактическая скорость отличалась от
            // настроенной в BCAP/HCAP раз, а счётчик объёма считал по цели.
            int openMs, closeMs;
            float targetSpeed = speedGolovy * (cfg.speedHeadCorr / 100.0f);
            float bodyCapHeads = cfg.valve_body_capacity_heads > 0 ? (float)cfg.valve_body_capacity_heads : (float)cfg.valve_body_capacity;
            calcValveTiming(targetSpeed, bodyCapHeads, openMs, closeMs);
            logger.log("GOLOVY ST: BodyNC heads timing: target=" + String(targetSpeed, 1)
                     + " ml/h, cap=" + String(bodyCapHeads, 1) + " ml/min");
            outputManager->startBodyValveCycling(openMs, closeMs);
        } else {
            // Конфиг 4: Body(NO). Ручной режим.
            outputManager->openBodyValve(); // Открыть (LOW)
            Serial.println("[GOLOVY] Manual mode (NO valve)");
            logger.log("[GOLOVY] Manual mode (NO valve)");
        }
    }
}

// --- KSS Spit ---
void ProcessEngine::startKssSpit(SystemConfig& cfg) {
    float headVol = cfg.asVolume * cfg.headsShareKssSpit;
float vHeadMin = 0;

// Определяем актуальную пропускную способность в зависимости от конфига клапана
// Сессия 18: клапан открыт НАСТОЯЩУЮ (не импульсит) — течёт его полная
// пропускная способность: HCAP для клапана голов, BCAP для НЗ клапана тела,
// B0CAP для НО клапана. BCH (импульсная capacity на скорости голов) тут не
// применим, а главное — ЗНАЧЕНИЕ должно совпадать со счётчиком объёма в
// handleGolovy (строка ~1152), иначе длительность этапа и накопленный объём
// расходятся.
float cap = cfg.useHeadValve    ? (float)cfg.valve_head_capacity :
            cfg.bodyValveNC     ? (float)cfg.valve_body_capacity :
                                  (float)cfg.valve0_body_capacity;

// Защита от деления на ноль: если capacity не откалиброван или = 0,
// подставляем минимум 1 мл/мин и пишем предупреждение в лог
if (cap < 1.0f) {
    cap = 1.0f;
    logger.log("WARNING: KSS Spit capacity = 0! Using 1 ml/min. Check VALVE CAL settings.");
    Serial.println("[GOLOVY] WARNING: valve capacity = 0, using fallback 1 ml/min");
}

vHeadMin = headVol / cap;

    golovyTargetTime = (unsigned long)(vHeadMin * 60.0f); 
    currentGolovyStage = GolovyStage::KSS_SPIT;
    stageStartTime = procNow();  // Этап 2.1: таймер этапа в сим-времени
    
    // === СБРОС СЧЁТЧИКА ОБЪЁМА ПОДЭТАПА ===
    headsVolSub = 0.0f;
    currentStatus.headsVolTarget = (int)headVol;
    currentStatus.rectVolumeTarget = (int)headVol;  // Используется для проверки завершения
    // =====================================

    Serial.print("[GOLOVY] KSS Spit. Time: "); Serial.print(vHeadMin); Serial.println(" min");
    Serial.print("[GOLOVY] KSS Spit. Speed: "); Serial.print(cap, 1); Serial.println(" ml/min (full flow)");
    // === ЛОГИРОВАНИЕ ===
    logger.log("GOLOVY: KSS Spit Start");
    logger.log("  Target Vol: " + String(headVol, 1) + " ml");
    logger.log("  Duration: " + String(vHeadMin, 1) + " min");
    // ==================

    if (cfg.useHeadValve) {
        outputManager->openHeadValve(); // Открыть Головы
        outputManager->closeBodyValve();
    } else {
        // Работаем через тело
        outputManager->openBodyValve(); // Открыть (учитывает NC/NO)
    }
}

// --- KSS Standard ---
void ProcessEngine::startKssStandard(SystemConfig& cfg) {
    float headVol = cfg.asVolume * cfg.headsShareKssStd;
    float vHeadMin = (headVol / speedGolovy) * 60.0f;
    golovyTargetTime = (unsigned long)(vHeadMin * 60.0f); 
    
    currentGolovyStage = GolovyStage::KSS_STANDARD;
    stageStartTime = procNow();  // Этап 2.1: таймер этапа в сим-времени
    
    // === СБРОС СЧЁТЧИКА ОБЪЁМА ПОДЭТАПА ===
    headsVolSub = 0.0f;
    currentStatus.headsVolTarget = (int)headVol;
    currentStatus.rectVolumeTarget = (int)headVol;  // Используется для проверки завершения
    // =====================================

    Serial.print("[GOLOVY] KSS Standard. Time: "); Serial.print(vHeadMin); Serial.println(" min");
    Serial.print("[GOLOVY] KSS Standard. Speed: "); Serial.print(speedGolovy, 1); Serial.println(" ml/h");
    Serial.printf("[GOLOVY] DEBUG: headCap=%d, koff=%.2f, speedHeadCorr=%d\n",
        cfg.valve_head_capacity, koff, cfg.speedHeadCorr);
    // === ЛОГИРОВАНИЕ ===
    logger.log("GOLOVY: KSS Standard Start");
    logger.log("  Target Vol: " + String(headVol, 1) + " ml");
    logger.log("  Duration: " + String(vHeadMin, 1) + " min");
    // ==================

    if (cfg.useHeadValve) {
        int openMs, closeMs;
        float targetSpeed = speedGolovy * (cfg.speedHeadCorr / 100.0f);
        calcValveTiming(targetSpeed, (float)cfg.valve_head_capacity, openMs, closeMs);
        Serial.printf("[GOLOVY] KSS_STD: Calc timing - open=%dms, close=%dms, target=%.1f ml/h\n", 
            openMs, closeMs, targetSpeed);
        outputManager->startHeadValveCycling(openMs, closeMs);
        outputManager->closeBodyValve();
    } else {
        if (cfg.bodyValveNC) {
            // Сессия 18: как в startStandardGolovy — capacity ТОГО клапана, что
            // импульсит (BCH при наличии, иначе BCAP этого же НЗ клапана).
            // Прежний fallback на valve_head_capacity (клапана голов нет) давал
            // неверные тайминги — см. комментарий в startStandardGolovy.
            int openMs, closeMs;
            float targetSpeed = speedGolovy * (cfg.speedHeadCorr / 100.0f);
            float bodyCapHeads = cfg.valve_body_capacity_heads > 0 ? (float)cfg.valve_body_capacity_heads : (float)cfg.valve_body_capacity;
            calcValveTiming(targetSpeed, bodyCapHeads, openMs, closeMs);
            logger.log("GOLOVY KSS_STD: BodyNC heads timing: target=" + String(targetSpeed, 1)
                     + " ml/h, cap=" + String(bodyCapHeads, 1) + " ml/min");
            outputManager->startBodyValveCycling(openMs, closeMs);
        }
    }
}

// --- KSS AkaTelo ---
void ProcessEngine::startKssAkaTelo(SystemConfig& cfg) {
    float headVol = cfg.asVolume * cfg.headsShareKssAkatelo;
    float vHeadMin = (headVol / speedTelo) * 60.0f;
    golovyTargetTime = (unsigned long)(vHeadMin * 60.0f); 
    
    currentGolovyStage = GolovyStage::KSS_AKATELO;
    stageStartTime = procNow();  // Этап 2.1: таймер этапа в сим-времени
    
    // === СБРОС СЧЁТЧИКА ОБЪЁМА ПОДЭТАПА ===
    headsVolSub = 0.0f;
    currentStatus.headsVolTarget = (int)headVol;
    currentStatus.rectVolumeTarget = (int)headVol;  // Используется для проверки завершения
    // =====================================

    Serial.print("[GOLOVY] KSS AkaTelo. Time: "); Serial.print(vHeadMin); Serial.println(" min");
    Serial.print("[GOLOVY] KSS AkaTelo. Speed: "); Serial.print(speedTelo, 1); Serial.println(" ml/h");
    // === ЛОГИРОВАНИЕ ===
    logger.log("GOLOVY: KSS AkaTelo Start");
    logger.log("  Target Vol: " + String(headVol, 1) + " ml");
    logger.log("  Duration: " + String(vHeadMin, 1) + " min");
    // ==================

    if (cfg.useHeadValve) {
        int openMs, closeMs;
        float targetSpeed = speedTelo * (cfg.speedBodyCorr / 100.0f);
        // Сессия 18: импульс идёт по КЛАПАНУ ГОЛОВ — его собственная capacity
        // (HCAP). Прежний valve_body_capacity (BCAP — клапан ТЕЛА) давал
        // фактическую скорость target*HCAP/BCAP вместо target: duty считался
        // от чужой пропускной способности.
        float cap = (float)cfg.valve_head_capacity;
        calcValveTiming(targetSpeed, cap, openMs, closeMs);
        Serial.printf("[GOLOVY] KSS_AKATELO: Calc timing - open=%dms, close=%dms, target=%.1f ml/h\n", 
            openMs, closeMs, targetSpeed);
        outputManager->startHeadValveCycling(openMs, closeMs);
        outputManager->closeBodyValve();
    } else {
        if (cfg.bodyValveNC) {
            int openMs, closeMs;
            float targetSpeed = speedTelo * (cfg.speedBodyCorr / 100.0f);
            float cap = (float)cfg.valve_body_capacity;
            calcValveTiming(targetSpeed, cap, openMs, closeMs);
            outputManager->startBodyValveCycling(openMs, closeMs);
        } else {
            // Body(NO) -> Ручной
            outputManager->openBodyValve();
            Serial.println("[GOLOVY] Manual mode (KSS AkaTelo)");
        }
    }
}

void ProcessEngine::finishGolovyStage() {
    currentGolovyStage = GolovyStage::IDLE; 
    Serial.println("[Process] -> GOLOVY OK?");
    
    // Клапан (голова или тело) ПРОДОЛЖАЕТ работать в том же режиме до подтверждения
    // После подтверждения -> TELO, где будет доотбор голов (если есть клапан голов) и старт клапана тела
    
    // === ЛОГИРОВАНИЕ ===
    logger.log("GOLOVY: All Heads Stages Complete. Waiting for user confirmation.");
    // ==================
    changeStage(Stage::GOLOVY_OK);
}

// ==================== TELO LOGIC ====================

void ProcessEngine::handleTelo() {
    currentStatus.stageName = "TELO";
    
    SystemConfig& cfg = configManager->getConfig();
    const SensorData& data = sensorAdapter->getData();

    // 1. Инициализация при входе в ТЕЛО (первичный вход или возврат из NASEBYA).
    // Сессия 16: условие упрощено до (previousStage != TELO) — прежний член
    // «rtsarM < 0.1f» при отложенном захвате был бы истинен ВСЁ время ожидания
    // (rtsarM=0) и перезапускал бы инициализацию каждый цикл loop, обнуляя
    // bodyVolDone/скорость. Теперь вход сюда — ровно один раз на заход в ТЕЛО.
    if (currentStage == Stage::TELO && previousStage != Stage::TELO) { 
        koff = cfg.power / 1000.0f; 
        
        // === ОТЛОЖЕННЫЙ ЗАХВАТ ОПОРНОЙ ТЕМПЕРАТУРЫ (Сессия 16) ===
        // Опорная температура царги (rtsarM) и опорное давление (adPressM)
        // фиксируются НЕ сразу, а через cfg.teloRefDelayMin минут (инженерное
        // меню): за это время колонка стабилизируется после перехода с голов
        // на тело. Отбор тела при этом идёт с начальной скоростью, объём
        // копится. teloRefDelayMin = 0 -> захват на первом же обороте ниже
        // (пройдёт проверка таймера мгновенно) — прежнее поведение.
        teloRefTimerStart = procNow();  // Этап 2.1: задержка захвата опоры — сим-время
        teloRefCaptured = false;
        // Референс давления захватывается ВМЕСТЕ с температурой (через задержку):
        // поправка давления применяется к порогам rtsarM + delta/histeresis,
        // поэтому оба референса должны быть согласованы по времени.
        teloBmeReferenceCaptured = false;
        teloBmeWasAvailable = currentStatus.bmeAvailable;
        // =========================================================
        
        bodyOpenCor = cfg.bodyOpenSec * koff;
        speedShpora = 500.0 * koff; 
        lastShporaAdjustTime = procNow();  // Этап 2.1: сим-время
        bodyVolDone = 0.0f;  // Сброс накопленного объёма тела
        shporaReductionCount = 0; // Сброс счётчика снижений скорости 

        // === ЛОГИРОВАНИЕ СТАРТА ТЕЛО ===
        bool isShpora = (cfg.cycleLim == 1 && cfg.bodyValveNC);
        logger.log("TELO Start. Method: " + String(isShpora ? "SPORA" : "STANDARD")
                 + " (cycleLim=" + String(cfg.cycleLim)
                 + ", bodyValveNC=" + String(cfg.bodyValveNC ? "true" : "false") + ")");
        // rtsarM ещё не зафиксирован — покажем план захвата
        logger.log("  rtsarM: pending (capture in " + String(cfg.teloRefDelayMin) + " min)"
                 + "  BME: " + String(currentStatus.bmeAvailable ? "OK" : "NOT AVAILABLE"));
        logger.log("  bodyOpenCor: " + String(bodyOpenCor, 1) + "s"
                 + "  Initial Speed: " + String(speedShpora, 1) + "ml/h");
        // ==============================

        // ФИКС C1: помечаем, что вход в этап ТЕЛО обработан.
        // Без этой строки условие ре-инициализации (previousStage != Stage::TELO)
        // было истинным на КАЖДОМ обороте loop(): инициализация (сброс rtsarM,
        // speedShpora, bodyVolDone) выполнялась сотни раз в секунду, из-за чего
        // адаптивная логика Шпора/Стандарт не работала, а объём тела не
        // накапливался. Остальные обработчики этапов (handleWaiting,
        // handleDistOtbor, handleDistBakstop, handleNasebya) делают то же самое.
        previousStage = Stage::TELO;
        
        
    }

    // 1b. Сессия 16: отложенный захват опорных значений ТЕЛО.
    // Срабатывает ОДИН раз, когда с момента входа в ТЕЛО прошло
    // cfg.teloRefDelayMin минут (0 = сразу, прежнее поведение).
    // Кламп локальной копии: отрицательное значение из EEPROM/профиля
    // не превратится в огромный unsigned-интервал (захват бы никогда не случился).
    int refDelayMin = cfg.teloRefDelayMin;
    if (refDelayMin < 0) refDelayMin = 0;
    if (!teloRefCaptured && procNow() - teloRefTimerStart >= (unsigned long)refDelayMin * 60000UL) {
        teloRefCaptured = true;
        rtsarM = data.tsar.value;

        // === ЛОГИКА ЗАХВАТА РЕФЕРЕНСА ДАВЛЕНИЯ (перенесена из блока инициализации) ===
        if (currentStatus.bmeAvailable) {
            // BME работает - захватываем реальное давление
            adPressM = data.pressure;
            teloBmeReferenceCaptured = true;
            teloBmeWasAvailable = true;
            logger.log("TELO: BME reference captured. adPressM: " + String(adPressM, 1) + " hPa");
        } else {
            // BME НЕ работает - коррекция отключена на весь этап, давление = 760 мм рт.ст. (1013.25 гПа)
            adPressM = 1013.25f; // 760 мм рт.ст. в гПа
            teloBmeReferenceCaptured = false;
            teloBmeWasAvailable = false;
            logger.log("WARNING: BME280 not available at TELO reference capture! Pressure correction DISABLED for entire stage.");
            Serial.println("[TELO] BME missing! Correction disabled, using 760 mmHg.");
        }
        // ==========================================

        logger.log("TELO: Reference captured after " + String(refDelayMin) + " min stabilization. rtsarM: " + String(rtsarM, 2) + "C");
        Serial.printf("[TELO] Reference captured: rtsarM=%.2fC (delay %d min)\n", rtsarM, refDelayMin);
    }

    // 2. Расчет поправки давления
    float pressureCorrection = 0.0f;
    
    if (teloBmeReferenceCaptured) {
        // Референс был захвачен - работаем с коррекцией
        
        // Мониторинг потери/восстановления BME
        if (teloBmeWasAvailable && !currentStatus.bmeAvailable) {
            // BME пропал - используем последние данные
            logger.log("ERROR: BME280 connection lost during TELO! Using frozen pressure: " + String(data.pressure) + " hPa");
            Serial.println("[TELO] BME LOST! Pressure frozen at: " + String(data.pressure) + " hPa");
        }
        else if (!teloBmeWasAvailable && currentStatus.bmeAvailable) {
            // BME восстановился - обновляем референс и восстанавливаем динамическую коррекцию
            adPressM = data.pressure;
            logger.log("INFO: BME280 restored. Dynamic correction resumed. New adPressM: " + String(adPressM, 1) + " hPa");
            Serial.println("[TELO] BME Restored. Dynamic correction resumed.");
        }
        teloBmeWasAvailable = currentStatus.bmeAvailable;
        
        // Расчёт коррекции (при потере BME data.pressure = замороженное значение)
        pressureCorrection = (data.pressure - adPressM) * cfg.pressureCoeff;
    }
    // Иначе: референс НЕ был захвачен -> коррекция = 0 на весь этап
    
    // 3. Расчёт накопленного объёма тела
    unsigned long now = procNow();  // Этап 2.1: объём тела интегрируется в сим-времени
    float dt_h = (float)(now - lastVolCalcTime) / 3600000.0f;
    lastVolCalcTime = now;
    
    float bodySpeedMlH = currentStatus.bodySpeed;
    bodyVolDone += bodySpeedMlH * dt_h;
    currentStatus.bodyVolDone = bodyVolDone;

    // 3. Логика тела
    // Метод Шпора доступен только для NC клапана! И если установлен 1 цикл в настройках Иначе работаем как Overhist
    bool isShpora = (cfg.cycleLim == 1 && cfg.bodyValveNC);

    // --- УПРАВЛЕНИЕ КЛАПАНОМ ТЕЛА ---
    if (isShpora) {
        // === МЕТОД 2: ШПОРА (Только NC) ===
        
        // Реакция на Delta
        // Сессия 16: до захвата опорной температуры (первые teloRefDelayMin мин)
        // порог не имеет смысла — не от чего считать отклонение. Пока
        // teloRefCaptured == false, скорость остаётся начальной.
        if (teloRefCaptured && data.tsar.value >= (rtsarM + cfg.delta + pressureCorrection)) {
            
            // ПРОВЕРКА ТАЙМЕРА: Прошло ли достаточно времени с прошлого снижения?
            if (procNow() - lastShporaAdjustTime >= cfg.shporaStabMs) {
                bodyOpenCor /= cfg.shporaCorr;
                speedShpora /= cfg.shporaCorr;
                shporaReductionCount++;
                
                lastShporaAdjustTime = procNow(); // Запоминаем время корректировки (сим-время)
                
                Serial.print("[TELO] Shpora Delta! New Speed: "); 
                Serial.println(speedShpora);

                // === РАСШИРЕННОЕ ЛОГИРОВАНИЕ СНИЖЕНИЯ СКОРОСТИ ===
                float threshold = rtsarM + cfg.delta + pressureCorrection;
                unsigned long stageTimeSec = (procNow() - stageStartTime) / 1000;
                unsigned long hours = stageTimeSec / 3600;
                unsigned long mins = (stageTimeSec % 3600) / 60;
                
                logger.log("TELO: Delta breach! TSAR=" + String(data.tsar.value, 2) + "C > threshold=" + String(threshold, 2) + 
                           "C (rtsarM=" + String(rtsarM, 2) + " + delta=" + String(cfg.delta, 2) + " + corr=" + String(pressureCorrection, 2) + ")");
                logger.log("TELO: Speed " + String(speedShpora * cfg.shporaCorr, 1) + " -> " + String(speedShpora, 1) + 
                           " ml/h (reduction #" + String(shporaReductionCount) + ", time: " + String(hours) + "h " + String(mins) + "m)");
                // ========================================================
            }
        }

        // Реакция на Залёт
        // Сессия 16: гвард teloRefCaptured — см. комментарий выше (референс ещё
        // не зафиксирован — Залёт определить невозможно, ложных срабатываний нет).
        if (teloRefCaptured && data.tsar.value >= (rtsarM + cfg.histeresis + pressureCorrection)) {
            // Вариант А: Закрываем всё при Залёте
            finishTelo(cfg);
            // === ЛОГИРОВАНИЕ ЗАЛЁТА ===
            logger.log("TELO: HYSTERESIS BREACH! T=" + String(data.tsar.value, 2) + "C");
            // =========================
            return;
        }

        // === ПРОВЕРКА МИНИМАЛЬНОЙ СКОРОСТИ ===
        float minBodySpeed = (float)cfg.minBodySpeed;
        if (speedShpora < minBodySpeed) {
            logger.log("TELO: Min speed " + String(minBodySpeed, 0) + " ml/h reached! Finishing.");
            Serial.println("[TELO] Min speed reached! Finishing TELO.");
            finishTelo(cfg);
            return;
        }
        // ======================================

        // Управление клапаном тела (через calcValveTiming)
        int openMs, closeMs;
        float targetSpeed = speedShpora * (cfg.speedBodyCorr / 100.0f);
        calcValveTiming(targetSpeed, (float)cfg.valve_body_capacity, openMs, closeMs);
        
        // Выводим только при изменении
        if (openMs != teloLastOpenMs || closeMs != teloLastCloseMs) {
            Serial.printf("[TELO] Shpora: open=%ums, close=%ums, speed=%.1f ml/h\n", 
                openMs, closeMs, speedShpora);
            teloLastOpenMs = openMs;
            teloLastCloseMs = closeMs;
        }
        outputManager->startBodyValveCycling(openMs, closeMs);

    }

    else {
        // === МЕТОД 1: OVERHIST ===
        
        if (cfg.bodyValveNC) {
            // NC Клапан: Импульсный режим
            int openMs, closeMs;
            float targetSpeed = speedTelo * (cfg.speedBodyCorr / 100.0f);
            calcValveTiming(targetSpeed, (float)cfg.valve_body_capacity, openMs, closeMs);
            outputManager->startBodyValveCycling(openMs, closeMs);
        } else {
            // NO Клапан: Ручной режим (Просто Открыть)
            outputManager->openBodyValve();
        }

        // Реакция на Залёт
        // Сессия 16: гвард teloRefCaptured — референс ещё не зафиксирован,
        // ложных срабатываний в первые teloRefDelayMin минут нет.
        if (teloRefCaptured && data.tsar.value >= (rtsarM + cfg.histeresis + pressureCorrection)) {
            // Вариант А: Закрываем всё при Залёте
            outputManager->stopValveCycling();
            if (cfg.useHeadValve) outputManager->closeHeadValve();
            outputManager->closeBodyValve(); // Закроет и NO, и NC

            // === ЛОГИРОВАНИЕ ЗАЛЁТА ===
            logger.log("TELO: HYSTERESIS BREACH! T=" + String(data.tsar.value, 2) + "C");
            // =========================

            counter++;
            
            if (counter >= cfg.cycleLim) {
                finishTelo(cfg);
            } else {
                // Повторная стабилизация
                
                // ФИКС L1: время повторной стабилизации берём из reklapTime,
                // но НЕ записываем его в общий конфиг (см. nasebTimeOverride):
                // искажённый cfg.nasebTime иначе попал бы в EEPROM при
                // любом последующем сохранении настроек.
                nasebTimeOverride = cfg.reklapTime;   // подмена только на этот заход
                changeStage(Stage::NASEBYA);
            }
            return;
        }
    }

    // === 4. ДООТБОР ГОЛОВ (Всегда в TELO) ===
    // Запускается каждый цикл loop, пока мы в TELO.
    // Если был Залёт -> мы ушли в return выше -> эта часть не выполняется -> клапан закрыт.
    // Если пришли из NASEBYA -> выполняется -> клапан открывается снова.
    // ВАЖНО: Доотбор голов на RECT не зависит от мощности, всегда 50 мл/ч
    if (cfg.useHeadValve) {
        int openMs, closeMs;
        float targetSpeed = (float)cfg.distHeadsSpeed * (cfg.speedHeadCorr / 100.0f);
        calcValveTiming(targetSpeed, (float)cfg.valve_head_capacity, openMs, closeMs);
        outputManager->startHeadValveCycling(openMs, closeMs);
    }
}
void ProcessEngine::finishTelo(SystemConfig& cfg) {
    Serial.println("[Process] -> FINISHING WORK");
    
    outputManager->stopValveCycling();
    if (cfg.useHeadValve) outputManager->closeHeadValve();
    outputManager->closeBodyValve();
    
    changeStage(Stage::FINISHING_WORK);
}

// ==================== RECT PROCESS ROUTER ====================
void ProcessEngine::handleRectProcess() {
    if (currentStage == Stage::VALVE_CAL) {
       // currentStatus.stageName = "VALVE CAL";
        valveCalMenu->update();
        if (valveCalMenu->isReadyToExit()) {
             changeStage(Stage::SET_PW_AS);
             setPwAsMenu->display();
        }
    } 
    else if (currentStage == Stage::SET_PW_AS) {
        currentStatus.stageName = "SET_PW_AS";  // Добавлено для корректного отображения в web
        if (setPwAsMenu->isReadyToRun()) {
            currentGolovyStage = GolovyStage::IDLE; 
            changeStage(Stage::GOLOVY);
        }
    }
    else if (currentStage == Stage::GOLOVY) {
        handleGolovy();
    }
    else if (currentStage == Stage::GOLOVY_OK) {
        handleGolovyOk();
        // НЕ вызываем handleGolovy() - он запускает новые этапы!
    }
    else if (currentStage == Stage::TELO) {
        handleTelo();
    }
}

// ==================== FINISHING ====================

void ProcessEngine::handleFinishingWork() {
    currentStatus.stageName = "FINISHING";
    
    // Первый вход в этап
    if (previousStage != Stage::FINISHING_WORK) {
        // 1. Безопасность: Выключаем нагрев, открываем воду
        outputManager->setHeaterOff();
        outputManager->stopValveCycling();  // ← останавливаем циклы ПЕРЕД закрытием
        outputManager->closeHeadValve();    // ← закрываем клапан голов
        outputManager->closeBodyValve();    // ← закрываем клапан тела
        outputManager->openWaterValve();
        previousStage = Stage::FINISHING_WORK;
        SystemConfig& cfgFin = configManager->getConfig();
        Serial.println("[Process] FINISHING_WORK: Start cooling " + String(cfgFin.coolingDurationSec) + "s");
        logger.log("FINISHING: Start cooling " + String(cfgFin.coolingDurationSec) + "s");
    }

    // Таймер 5 минут (300 сек) — досрочно завершается кнопкой «ДАЛЕЕ» (skipStageRequested,
    // Сессия 20: одобрено автором — оператор сам решает, когда охлаждение можно прервать)
   
    unsigned long elapsedSec = (procNow() - stageStartTime) / 1000;  // Этап 2.1: задержка БАКСТОП в сим-времени
     // === НОВОЕ: Расчет остатка времени для веб-интерфейса ===
    // Если прошло меньше 300 сек, вычисляем разницу. Иначе 0.
    SystemConfig& cfgFin2 = configManager->getConfig();
    currentStatus.finishingRemainSec = (elapsedSec < cfgFin2.coolingDurationSec) ? (cfgFin2.coolingDurationSec - elapsedSec) : 0;
    // ======================================================
    if (elapsedSec >= cfgFin2.coolingDurationSec || skipStageRequested) {
        if (skipStageRequested && elapsedSec < cfgFin2.coolingDurationSec) {
            logger.log("FINISHING: cooling skipped by operator (elapsed " + String(elapsedSec) + "s of " + String(cfgFin2.coolingDurationSec) + "s)");
        }
        // === Сессия 20: БЕЗОПАСНОСТЬ ИНДУКЦИИ (одобрено автором) ===
        // При нагреве индукцией (heaterType=1) система НЕ управляет нагревом —
        // индукцией управляет оператор вручную (см. handleRazgon: при IND команды
        // на нагрев не подаются). Поэтому после ФИНИША воду НЕ закрываем:
        // она продолжает охлаждать куб и колонну, пока оператор вручную не
        // выключит индукцию и не закроет воду кнопкой в веб-мониторинге.
        // Иначе было бы: вода закрыта, индукция греет -> «спиртовая баня».
        // Путь покрывает ВСЕ варианты конца работы: естественный финал,
        // СТОП (уходит сюда же) и аварию TSA/VREAC (тоже уходит сюда).
        // При ТЭН (heaterType=0) поведение прежнее — система гасит ТЭН сама.
        if (cfgFin2.heaterType == 0) {
            outputManager->closeWaterValve();
        } else {
            Serial.println("[Process] FINISHING_WORK complete. IND mode: WATER VALVE LEFT OPEN - turn off induction, then close water in web monitoring!");
            logger.log("FINISH: IND mode - water valve LEFT OPEN (safety). Turn off induction manually, then close water via web monitoring.");
        }
        outputManager->powerOffBodyValve();
        outputManager->stopMixer();
        processRunning = false;
        activeProcess = PROCESS_NONE;
        configManager->stopProcess();
        changeStage(Stage::IDLE);
        currentStatus.stageName = "ENDED";
        Serial.println("[Process] FINISHING_WORK complete.");
        logger.log("Process Finished");
    }
}

// ==================== DISPLAY ====================

void ProcessEngine::changeStage(Stage newStage) {
    previousStage = currentStage;
    currentStage = newStage;
    stageStartTime = procNow();  // Этап 2.1: таймер этапа в сим-времени
    // === Сессия 20: флаг ручного перехода одноразовый — при смене этапа гасим,
    // чтобы он не «протёк» в следующий этап и не вызвал каскад пропусков ===
    skipStageRequested = false;
    if (newStage != Stage::RAZGON) razgonMixerStarted = false;
    currentStatus.stageName = getStageName(newStage);
    
    // Вывод читаемого названия этапа
    Serial.print("[Engine] Stage: ");
    Serial.println(getStageName(newStage)); 
    // === ЛОГИРОВАНИЕ ===
  logger.log(String("Stage change: ") + getStageName(newStage));
    
    // === ИНИЦИАЛИЗАЦИЯ МЕНЮ ПРИ ПЕРЕХОДЕ НА НОВЫЕ ЭТАПЫ ===
    if (newStage == Stage::VALVE_CAL && valveCalMenu) {
        valveCalMenu->display();  // Показать мастер калибровки на LCD
        Serial.println("[Engine] Valve calibration menu displayed");
    }
    else if (newStage == Stage::SET_PW_AS && setPwAsMenu) {
        setPwAsMenu->display();   // Показать меню настройки мощности
    }
}

void ProcessEngine::updateDisplayData() {
    const SensorData& data = sensorAdapter->getData();
    SystemConfig& cfg = configManager->getConfig();

    // === НОВОЕ: Проверка доступности BME ===
    // Если статус не OK, считаем датчик недоступным
    currentStatus.bmeAvailable = (data.bmeStatus == SensorStatus::OK);
    // ======================================
    
    currentStatus.currentTsa = data.tsa.value;
    currentStatus.currentAqua = data.aqua.value;
    currentStatus.currentTsar = data.tsar.value;
    currentStatus.currentTank = data.tank.value;
    // Давление с fallback на 760 мм рт.ст. при неработающем BME
    float pressure = data.getPressureMmHg();
    
    // Расчет крепости (getABV возвращает -1 если температура ниже 78.5°C)
    float abvBak = configManager->getABV(data.tank.value, pressure, false);
    currentStatus.currentStrengthBak = (abvBak >= 0) ? abvBak : 0;
    currentStatus.strengthBakValid = (abvBak >= 0);
    
    float abvOut = 0;
    if (activeProcess == PROCESS_DIST) {
        abvOut = configManager->getABV(data.tank.value, pressure, true);
    } else {
        abvOut = configManager->getABV(data.tsar.value, pressure, true);
    }
    currentStatus.currentStrength = (abvOut >= 0) ? abvOut : 0;
    currentStatus.strengthOutValid = (abvOut >= 0);
    
    static char buf[25]; // Буфер
    
    // === 1. DIST PROCESS ===
    if (activeProcess == PROCESS_DIST) {
        bool showStrength = (currentStage >= Stage::OTBOR);
        
        // --- Строка 0: TSA, DIST, Крепость куба ---
        char strAbvBak[8];
        if (showStrength && currentStatus.strengthBakValid) snprintf(strAbvBak, sizeof(strAbvBak), "%%%.1f", currentStatus.currentStrengthBak);
        else snprintf(strAbvBak, sizeof(strAbvBak), "%%--");
        
        // Используем символы W / A / X для статуса сети
        // Этап 2.1: в активном SIM шапка показывает SIM вместо DIST — громкая
        // индикация симуляции на LCD; ширина строки 20 симв. сохранена (%-4s)
        const char* distLbl = SimSensors::getInstance()->isActive() ? "SIM" : "DIST";
        snprintf(buf, sizeof(buf), "%5.2f %-4s %s %7s", data.tsa.value, distLbl, currentStatus.networkSymbol.c_str(), strAbvBak);
        currentStatus.line0 = String(buf);
        
        // --- Строка 1: AQUA, Этап, Крепость в отборе ---
        char strAbvOut[8];
        if (showStrength && currentStatus.strengthOutValid) snprintf(strAbvOut, sizeof(strAbvOut), "%%%.1f", currentStatus.currentStrength);
        else snprintf(strAbvOut, sizeof(strAbvOut), "%%--");
        
        snprintf(buf, sizeof(buf), "%5.2f %-8.8s%6s", data.aqua.value, currentStatus.stageName.c_str(), strAbvOut);
        currentStatus.line1 = String(buf);

        // --- Строка 2: TSAR, Статус ---
        char statusBuf[15];
        if (currentStatus.safety == SafetyState::WARNING_TSA) {
            snprintf(statusBuf, sizeof(statusBuf), "ALARMTSA %s", formatTimeMMSS(currentStatus.alarmTimerSec).c_str());
        } else if (currentStatus.safety == SafetyState::WARNING_BOX) {
            snprintf(statusBuf, sizeof(statusBuf), "ATTENT %dC", (int)data.boxTemp);
        } else if (currentStatus.safety == SafetyState::EMERGENCY) {
            strcpy(statusBuf, "EMERGENCY");
        } else {
            strcpy(statusBuf, "NORMA");
        }
        snprintf(buf, sizeof(buf), "%5.2f %-14s", data.tsar.value, statusBuf);
        currentStatus.line2 = String(buf);

        // --- Строка 3: TANK, Время, Стоп ---
        unsigned long t = currentStatus.processTimeSec;
        char timeStr[6];
        snprintf(timeStr, sizeof(timeStr), "%02d:%02d", (int)(t/3600), (int)((t%3600)/60));
        snprintf(buf, sizeof(buf), "%5.2f %s %7d", data.tank.value, timeStr, cfg.bakStopTemp);
        currentStatus.line3 = String(buf);
    } 
    // === 2. RECT PROCESS ===
    else if (activeProcess == PROCESS_RECT) {
        if (currentStage == Stage::GOLOVY_OK) {
            currentStatus.line0 = " GOLOVY OK?";
            currentStatus.line1 = "> YES";
            currentStatus.line2 = "";
            currentStatus.line3 = "";
        } else {
            const char* methodStr = "ST"; 
            if (cfg.headsTypeKSS) methodStr = "KSS";
            
            // Этап 2.1: в активном SIM шапка показывает SIM вместо RECT (см. DIST)
            const char* rectLbl = SimSensors::getInstance()->isActive() ? "SIM" : "RECT";
            snprintf(buf, sizeof(buf), "%5.2f %-4s %s %s", data.tsa.value, rectLbl, currentStatus.networkSymbol.c_str(), methodStr);
            currentStatus.line0 = String(buf);
            
            // Строка 1 (TELO / GOLOVY)
            if (currentStage == Stage::TELO) {
                 bool isShpora = (cfg.cycleLim == 1 && cfg.bodyValveNC);
                 if (isShpora) {
                     float speedLh = speedShpora / 1000.0;
                     char teloBuf[15];
                     snprintf(teloBuf, sizeof(teloBuf), "TELO %.2f Sp", speedLh);
                     snprintf(buf, sizeof(buf), "%5.2f %-13s", data.aqua.value, teloBuf);
                     currentStatus.line1 = String(buf);
                 } else {
                     char teloBuf[15];
                     snprintf(teloBuf, sizeof(teloBuf), "TELO %d OV", counter);
                     snprintf(buf, sizeof(buf), "%5.2f %-13s", data.aqua.value, teloBuf);
                     currentStatus.line1 = String(buf);
                 }
            } 
            else if (currentStage == Stage::GOLOVY && golovyTargetTime > 0) {
                 long elapsed = currentStatus.stageTimeSec;
                 long remainSec = (elapsed < (long)golovyTargetTime) ? ((long)golovyTargetTime - elapsed) : 0;
                 int remainMin = (remainSec + 59) / 60; 
                 
                 const char* subName = "GOLOVY";
                 if (currentGolovyStage == GolovyStage::KSS_SPIT) subName = "GOLOVY Sp";
                 else if (currentGolovyStage == GolovyStage::KSS_STANDARD) subName = "GOLOVY St";
                 else if (currentGolovyStage == GolovyStage::KSS_AKATELO) subName = "GOLOVY Ak";
                 
                 snprintf(buf, sizeof(buf), "%5.2f %-10s %3d", data.aqua.value, subName, remainMin);
                 currentStatus.line1 = String(buf);
            } 
            else if (currentStage == Stage::NASEBYA) {
                 // ФИКС L1: остаток стабилизации считаем от фактической цели
                 int totalSec = ((nasebTimeOverride > 0) ? nasebTimeOverride : cfg.nasebTime) * 60;
                 int elapsedSec = currentStatus.stageTimeSec;
                 int remainSec = (elapsedSec < totalSec) ? (totalSec - elapsedSec) : 0;
                 int remainMinNas = (remainSec + 59) / 60;
                 snprintf(buf, sizeof(buf), "%5.2f %-10s %3d", data.aqua.value, "NASEBYA", remainMinNas);
                 currentStatus.line1 = String(buf);
            } else {
                 snprintf(buf, sizeof(buf), "%5.2f %-10s", data.aqua.value, currentStatus.stageName.c_str());
                 currentStatus.line1 = String(buf);
            }
            
            // Строка 2 (Статус)
            char statusBuf[15];
            if (currentStatus.safety == SafetyState::WARNING_TSA) snprintf(statusBuf, sizeof(statusBuf), "ALARMTSA %s", formatTimeMMSS(currentStatus.alarmTimerSec).c_str());
            else if (currentStatus.safety == SafetyState::WARNING_BOX) snprintf(statusBuf, sizeof(statusBuf), "ATTENT %dC", (int)data.boxTemp);
            else if (currentStatus.safety == SafetyState::EMERGENCY) strcpy(statusBuf, "EMERGENCY");
            else strcpy(statusBuf, "NORMA");
            
            snprintf(buf, sizeof(buf), "%5.2f %-14s", data.tsar.value, statusBuf);
            currentStatus.line2 = String(buf);

            // Строка 3
            unsigned long t = currentStatus.processTimeSec;
            char timeStr[6];
            snprintf(timeStr, sizeof(timeStr), "%02d:%02d", (int)(t/3600), (int)((t%3600)/60));
            snprintf(buf, sizeof(buf), "%5.2f %s", data.tank.value, timeStr);
            currentStatus.line3 = String(buf);
        }
    } 
    else {
        currentStatus.line0 = "SYSTEM IDLE";
        currentStatus.line1 = "";
        currentStatus.line2 = "";
        currentStatus.line3 = "";
    }

         // === ОБНОВЛЕНИЕ СТАТУСА ТЕСТОВ ДЛЯ WEB ===
    // Head Test
    currentStatus.headTestActive = headTestStatus.active;
    if (headTestStatus.active) {
        unsigned long elapsed = (millis() - headTestStatus.startTime) / 1000;
        currentStatus.headTestRemainingSec = (elapsed < headTestStatus.durationSec) ? (headTestStatus.durationSec - elapsed) : 0;
        currentStatus.headTestTotalSec = headTestStatus.durationSec;
    } else {
        currentStatus.headTestRemainingSec = 0;
        currentStatus.headTestTotalSec = 0;
    }

    // Body Test
    currentStatus.bodyTestActive = bodyTestStatus.active;
    if (bodyTestStatus.active) {
        unsigned long elapsed = (millis() - bodyTestStatus.startTime) / 1000;
        currentStatus.bodyTestRemainingSec = (elapsed < bodyTestStatus.durationSec) ? (bodyTestStatus.durationSec - elapsed) : 0;
        currentStatus.bodyTestTotalSec = bodyTestStatus.durationSec;
    } else {
        currentStatus.bodyTestRemainingSec = 0;
        currentStatus.bodyTestTotalSec = 0;
    }
    // Флаг ожидания ввода мл
if (headTestStatus.awaitingInput) {
    currentStatus.testAwaitingInput = true;
    currentStatus.testAwaitingType = "head";
} else if (bodyTestStatus.awaitingInput) {
    currentStatus.testAwaitingInput = true;
    SystemConfig& cfg = configManager->getConfig();
    currentStatus.testAwaitingType = cfg.bodyValveNC ? "body_nc" : "body_no";
} else {
    currentStatus.testAwaitingInput = false;
    currentStatus.testAwaitingType = "";
}
}

String ProcessEngine::formatTimeMMSS(unsigned long seconds) const {
    int min = seconds / 60; int sec = seconds % 60;
    char buf[6]; snprintf(buf, sizeof(buf), "%02d:%02d", min, sec);
    return String(buf);
}

const SystemStatus& ProcessEngine::getStatus() const { return currentStatus; }
bool ProcessEngine::isProcessRunning() const { return processRunning; }
ProcessType ProcessEngine::getActiveProcessType() const { return activeProcess; }
String ProcessEngine::getProcessName() const { return (activeProcess == PROCESS_DIST ? "DIST" : "RECT"); }
String ProcessEngine::getStageName() const { return currentStatus.stageName; }

// Функция для получения названия этапа строкой
const char* ProcessEngine::getStageName(Stage stage) {
    switch (stage) {
        case Stage::IDLE: return "IDLE";
        case Stage::WATER_TEST: return "WATER_TEST";
        case Stage::RAZGON: return "RAZGON";
        case Stage::WAITING: return "WAITING";
        case Stage::OTBOR: return "OTBOR";
        case Stage::REPLACEMENT: return "REPLACEMENT";
        case Stage::BAKSTOP: return "BAKSTOP";
        case Stage::NASEBYA: return "NASEBYA";
        case Stage::VALVE_CAL: return "VALVE_CAL";
        case Stage::SET_PW_AS: return "SET_PW_AS";
        case Stage::GOLOVY: return "GOLOVY";
        case Stage::GOLOVY_OK: return "GOLOVY_OK";
        case Stage::TELO: return "TELO";
        case Stage::FINISHING_WORK: return "FINISHING_WORK";
        default: return "UNKNOWN";
    }
}

// === ОБНОВЛЕНИЕ ИНФОРМАЦИИ ДЛЯ WEB (RECT) ===
void ProcessEngine::updateRectWebInfo() {
    SystemConfig& cfg = configManager->getConfig();
    
    // 1. Информация о ГОЛОВАХ
    if (currentStage == Stage::GOLOVY) {
        // Метод
        currentStatus.rectMethodName = cfg.headsTypeKSS ? "KSS" : "STANDARD";
        
        // Расчет объема (AS Volume в мл)
        float asVol = (float)cfg.asVolume;
        float targetVol = 0;
        
        if (cfg.headsTypeKSS) {
            // KSS Logic
            switch (currentGolovyStage) {
                case GolovyStage::KSS_SPIT:
                    currentStatus.rectSubStage = "Spit";
                    targetVol = asVol * cfg.headsShareKssSpit; // KSS Spit
                    break;
                case GolovyStage::KSS_STANDARD:
                    currentStatus.rectSubStage = "Standard";
                    targetVol = asVol * cfg.headsShareKssStd; // KSS Standard
                    break;
                case GolovyStage::KSS_AKATELO:
                    currentStatus.rectSubStage = "AkaTelo";
                    targetVol = asVol * cfg.headsShareKssAkatelo; // KSS AkaTelo
                    break;
                default:
                    currentStatus.rectSubStage = "Wait";
                    break;
            }
        } else {
            // Standard Logic
            currentStatus.rectSubStage = "Main";
            // Сессия 14: явный объём голов (web). Должен совпадать с расчётом в
            // startStandardGolovy() — иначе цель на экране и реальная цель разойдутся.
            targetVol = (cfg.headsManualMl > 0) ? (float)cfg.headsManualMl
                                                : asVol * cfg.headsShareStd; // Standard
        }
        
        currentStatus.rectVolumeTarget = (int)targetVol;
        
        // Время (golovyTargetTime в секундах)
        long elapsed = currentStatus.stageTimeSec;
        long remain = (long)golovyTargetTime - elapsed;
        currentStatus.rectTimeRemaining = (remain > 0) ? (int)remain : 0;
    } 
    // Сброс при выходе из этапа
    else if (currentStage != Stage::GOLOVY_OK) {
        currentStatus.rectMethodName = "";
        currentStatus.headsSpeed = 0.0f;
        currentStatus.rectSubStage = "";
        currentStatus.rectTimeRemaining = 0;
        currentStatus.rectVolumeTarget = 0;
    }

    // 2. Информация о ТЕЛЕ
    if (currentStage == Stage::TELO) {
        // Метод
        bool isShpora = (cfg.cycleLim == 1 && cfg.bodyValveNC);
        currentStatus.bodyMethodName = isShpora ? "Шпора" : "Стандарт";
        
        // Скорость (speedShpora рассчитана в handleTelo, мл/час) с учётом коррекции
        currentStatus.bodySpeed = speedShpora * cfg.speedBodyCorr / 100.0f;
        
        // headsSpeed на TELO не нужен (не показываем) - не перезаписываем
        
        // Цикл
        currentStatus.bodyCycle = counter;
        
        // Расчёт оставшегося времени для TELO
        // Прогноз = AS - Heads - 15% tails
        float asVol = cfg.asVolume;
        float headsVol = headsVolDone;
        float tailsEst = asVol * 0.15f;
        float predictVol = asVol - headsVol - tailsEst;
        
        // Остаток = прогноз - уже отобрано, время при текущей скорости
        float remainVol = predictVol - bodyVolDone;
        if (speedShpora > 0 && remainVol > 0) {
            float timeHours = remainVol / speedShpora;
            currentStatus.rectTimeRemaining = (int)(timeHours * 3600.0f);
        } else {
            currentStatus.rectTimeRemaining = 0;
        }
    } else if (currentStage == Stage::NASEBYA) {
        // При "на себя" сохраняем последние данные тела (метод, скорость, цикл)
        // для отображения в WEB мониторинге. bodyVolDone тоже сохраняется (не обнуляется).
        // Это позволяет WEB показывать мониторинг тела даже во время стабилизации.
    } else {
        currentStatus.bodyMethodName = "";
        currentStatus.bodySpeed = 0;
        currentStatus.bodyCycle = 0;
    }
}
