Vlad-alco/BuhloWar/preferences.h

#ifndef PREFERENCES_H
#define PREFERENCES_H

#include <Arduino.h>
#include <EEPROM.h>  // Стандартная EEPROM
#include "common.h"

// Адреса в EEPROM для каждой переменной
#define EEPROM_SIZE 512  // Размер EEPROM

enum EEPROMAddress {
  ADDR_HEATER_TYPE = 0,
  ADDR_POWER = 4,
  ADDR_AS_VOLUME = 8,
  ADDR_TSA_LIMIT = 12,
  ADDR_HISTERESIS = 16,
  ADDR_CORRELATION = 20,
  ADDR_DELTA = 24,
  ADDR_RAZGON_TEMP = 28,
  ADDR_CYCLE_LIM = 32,
  ADDR_USE_HEAD_VALVE = 36,
  ADDR_HEADS_TYPE_KSS = 40,
  ADDR_BODY_VALVE_NC = 44,
  ADDR_BAK_STOP_TEMP = 48,
  ADDR_MIXER_ON_TIME = 52,
  ADDR_MIXER_OFF_TIME = 56,
  ADDR_MIXER_ENABLED = 60,
  ADDR_HEAD_OPEN_SEC = 64,   // Время открытия клапана голов (СЕКУНДЫ, план A)
  ADDR_HEAD_CLOSE_SEC = 68,  // Время закрытия клапана голов (сек)
  ADDR_BODY_OPEN_SEC = 72,   // Время открытия клапана тела (сек)
  ADDR_BODY_CLOSE_SEC = 76,  // Время закрытия клапана тела (сек)
  
  ADDR_EMERGENCY_TIME = 96,
  ADDR_NASEB_TIME = 100,
  ADDR_REKLAP_TIME = 104,
  ADDR_BOX_MAX_TEMP = 108,
  ADDR_ACTIVE_PROCESS = 112,
  ADDR_PROCESS_RUNNING = 116,
  ADDR_PROCESS_START_TIME = 120,
  ADDR_VALVE_CAL = 124, // Удалено, но адрес зарезервирован для совместимости
  ADDR_SYNC_IN_PROGRESS = 140,
  
  // Адреса датчиков
  ADDR_TSA_ADDRESS = 144,    // 8 байт (144-151)
  ADDR_AQUA_ADDRESS = 152,   // 8 байт (152-159)  
  ADDR_TSAR_ADDRESS = 160,   // 8 байт (160-167)
  ADDR_TANK_ADDRESS = 168,   // 8 байт (168-175)

  // --- НОВЫЕ АДРЕСА (вместо ZATOR/AUTOCLAVE) ---
  ADDR_CHEKWIFI = 176,       // Интервал проверки WiFi (мин)
  ADDR_VALVE_USE = 180,      // Использование клапана при DIST (bool)
  ADDR_MIDTERM = 184,        // Температура смены посуды (DIST)
  ADDR_CALIBRATION = 188,    // Флаг калибровки клапанов (bool)
  ADDR_ACTIVE_TEST = 192,    // Время теста клапана (сек)
  
  // Пропускные способности клапанов
  ADDR_VALVE_HEAD_CAP = 196,    // HCAP (мл/мин)
  ADDR_VALVE_BODY_CAP = 200,    // BCAP (мл/мин)
  ADDR_VALVE0_BODY_CAP = 204,   // B0CAP (мл/мин) для НО клапана
  ADDR_VALVE_BODY_CAP_HEADS = 482,  // BCH (мл/мин) — capacity BODY NC на скорости голов
  ADDR_FULL_PWR = 208,
  ADDR_MIDTERM_ABV = 212,   // Крепость смены тары (%)     
  
  // === НОВЫЕ ПАРАМЕТРЫ КАЛИБРОВКИ КЛАПАНОВ ===
  ADDR_MIN_OPEN_TIME = 216,    // minOpenTime (мс), по умолчанию 100
  ADDR_SPEED_HEAD_CORR = 220,  // speedHeadCorr (%), 10-200, по умолчанию 100
  ADDR_SPEED_BODY_CORR = 224,  // speedBodyCorr (%), 10-200, по умолчанию 100
  
  // === ОБЛАЧНОЕ ПОДКЛЮЧЕНИЕ ===
  ADDR_CLOUD_ENABLED = 228,   // cloudEnabled (bool)
  ADDR_CLOUD_URL = 230,       // cloudUrl (128 bytes)
  ADDR_CLOUD_API_KEY = 358,    // cloudApiKey (64 bytes)

  // === ИНЖЕНЕРНОЕ МЕНЮ ===
  ADDR_ENG_SPEED_GOL_base = 422,     // speedGolovyBase (int) — default 50
  ADDR_ENG_SPEED_TELO_base = 426,    // speedTeloBase (int) — default 500
  ADDR_ENG_DIST_HEADS_SPEED = 430,   // distHeadsSpeed (int) — default 50
  ADDR_ENG_SHPORA_CORR = 434,        // shporaCorr (float) — default 1.13
  ADDR_ENG_SHPORA_STAB_MS = 438,     // shporaStabMs (int) — default 60000
  ADDR_ENG_MIN_BODY_SPEED = 442,     // minBodySpeed (int) — default 300
  ADDR_ENG_HEADS_SHARE_STD = 446,    // headsShareStd (float) — default 0.10
  ADDR_ENG_HEADS_SHARE_KSS_SPIT = 450, // headsShareKssSpit (float) — default 0.02
  ADDR_ENG_HEADS_SHARE_KSS_STD = 454,  // headsShareKssStd (float) — default 0.03
  ADDR_ENG_HEADS_SHARE_KSS_AKATELO = 458, // headsShareKssAkatelo (float) — default 0.15
  ADDR_ENG_PRESSURE_COEFF = 462,     // pressureCoeff (float) — default 0.028
  ADDR_ENG_COOLING_SEC = 466,        // coolingDurationSec (int) — default 300
  ADDR_ENG_BAKSTOP_DELAY = 470,      // bakstopDelaySec (int) — default 5
  ADDR_ENG_CALIB_DRY_SEC = 474,      // calibDrySec (int) — default 10
  ADDR_ENG_CALIB_CAP_SEC = 478,      // calibCapacitySec (int) — default 60
  ADDR_CONFIG_VERSION = 486,         // Версия формата конфига (1 байт; миграция единиц *Ms→*Sec)
  ADDR_HEADS_MANUAL_ML = 487,        // Сессия 14: явный объём голов, мл (0 = авто; 487..490, EEPROM 512)
  ADDR_ENG_TELO_REF_DELAY = 491      // Сессия 16: задержка захвата опорной T царги в ТЕЛО, мин (0 = сразу; 491..494, EEPROM 512)
};

// Структура для хранения всех переменных
struct SystemConfig {
  // Основные настройки
  int heaterType = 0;
  int power = 3500;
  int asVolume = 5000;
  // Сессия 14: явный объём голов для ректификации (мл). Задаётся только через web.
  // 0 = авто — считать от АС как раньше (ST: АС*headsShareStd; KSS: доли KSS).
  // Используется ТОЛЬКО в методе ST (startStandardGolovy / updateRectWebInfo).
  int headsManualMl = 0;
  int tsaLimit = 40;
  float histeresis = 0.24f;
  float correlation = 1.13f;
  float delta = 0.06f;
  
  // Настройки дистилляции/ректификации
  int razgonTemp = 78;
  int cycleLim = 3;
  bool useHeadValve = true;
  bool headsTypeKSS = false;
  bool bodyValveNC = true;
  int bakStopTemp = 99;
  
  // Настройки миксера
  int mixerOnTime = 30;
  int mixerOffTime = 300;
  bool mixerEnabled = true;
  
  // --- Калибровка клапанов (единицы измерения: СЕКУНДЫ) ---
  // Этап 3 (план A): переименованы *Ms → *Sec — значения всегда были в секундах
  // (меню, TEST_HEAD, Web передают секунды; основной процесс умножает на 1000).
  // Старые имена обманывали: «миллисекунды» при значениях 1/10/2/10 сек.
  int headOpenSec = 1;          // Время открытия клапана голов (сек), по ТЗ: 1
  int headCloseSec = 10;        // Время закрытия клапана голов (сек), по ТЗ: 10
  int bodyOpenSec = 2;          // Время открытия клапана тела (сек), по ТЗ: 2
  int bodyCloseSec = 10;        // Время закрытия клапана тела (сек), по ТЗ: 10

  // Адреса датчиков температуры (по 8 байт каждый)
  uint8_t tsaAddress[8] = {0};
  uint8_t aquaAddress[8] = {0};
  uint8_t tsarAddress[8] = {0};
  uint8_t tankAddress[8] = {0};
  
  // Безопасность
  int emergencyTime = 3;  // VREAC
  int nasebTime = 10;
  int reklapTime = 10;
  int boxMaxTemp = 60;
  
  // --- НОВЫЕ ПЕРЕМЕННЫЕ ---
  int chekwifi = 5;             // Интервал проверки WiFi (мин)
  bool valveuse = false;        // Использовать клапан при DIST
  // Сессия 10: midterm/midterm_abv хранятся в ДЕСЯТЫХ долях (x10):
  // midterm 920 = 92.0°C, midterm_abv 430 = 43.0%. Целые градусы не давали
  // задать точный момент смены тары по крепости отбора (ошибка до ±2.3% об.).
  // JSON API и профили по-прежнему в °C/% с одним знаком (совместимость).
  int midterm = 920;            // Температура смены посуды, °C x10 (92.0°C)
  int midterm_abv = 0;          // Крепость смены тары, % x10 (0 = не задана)
  bool calibration = true;      // Калибровка клапанов (флаг запуска этапа)
  int active_test = 60;         // Время теста клапана (сек)
  int timezoneOffset = 3;
  
  // Пропускные способности
  int valve_head_capacity = 100; // HCAP
  int valve_body_capacity = 100; // BCAP — capacity для скорости тела
  int valve0_body_capacity = 100; // B0CAP
  int valve_body_capacity_heads = 0; // BCH — capacity BODY NC на скорости голов (0 = не калибровано)
  // Внутри struct SystemConfig, после int active_test = 60;
  bool fullPwr = true; // Использовать полную мощность при разгоне (DIST)
  
  // === НОВЫЕ ПАРАМЕТРЫ КАЛИБРОВКИ КЛАПАНОВ ===
  int minOpenTime = 100;        // Минимальное время открытия клапана (мс), по умолчанию 100
  int speedHeadCorr = 100;      // Коррекция скорости голов (%), 10-200
  int speedBodyCorr = 100;      // Коррекция скорости тела (%), 10-200
  // ==========================================

  // === ИНЖЕНЕРНОЕ МЕНЮ ===
  int speedGolovyBase = 50;          // Базовая скорость голов (мл/ч/кВт)
  int speedTeloBase = 500;           // Базовая скорость тела (мл/ч/кВт)
  int distHeadsSpeed = 50;           // Скорость доотбора голов в TELO (мл/ч)
  float shporaCorr = 1.13f;          // Коэффициент снижения скорости Шпора
  int shporaStabMs = 60000;          // Пауза стабилизации Шпора (мс)
  int minBodySpeed = 300;            // Мин. скорость тела Шпора (мл/ч)
  float headsShareStd = 0.10f;       // Доля голов (Стандарт)
  float headsShareKssSpit = 0.02f;   // Доля КСС Спит
  float headsShareKssStd = 0.03f;    // Доля КСС Стандарт
  float headsShareKssAkatelo = 0.15f;// Доля КСС Акатело
  float pressureCoeff = 0.028f;      // Коэффициент коррекции давления (°C/hPa)
  int coolingDurationSec = 300;      // Время охлаждения при финишинге (сек)
  int bakstopDelaySec = 5;           // Задержка перед FINISHING при BAKSTOP (сек)
  int calibDrySec = 10;              // Время сухого теста калибровки (сек)
  int calibCapacitySec = 60;         // Время теста capacity калибровки (сек)
  // Сессия 16: задержка фиксации опорной температуры царги (rtsarM) и опорного
  // давления (adPressM) при входе в этап ТЕЛО, минут. Колонка успевает
  // стабилизироваться после перехода с голов на тело. 0 = фиксировать сразу
  // (прежнее поведение). Настраивается в инженерном меню web.
  int teloRefDelayMin = 5;           // Задержка захвата опорной T царги в ТЕЛО (мин), 0 = сразу
  // =========================

  // Служебные
  unsigned long localChangeTimestamp = 0;
  unsigned long webChangeTimestamp = 0;
  bool configChangedLocally = false;
  bool syncInProgress = false;
  
  // Текущий активный процесс
  ProcessType activeProcess = PROCESS_NONE;
  bool processRunning = false;
  unsigned long processStartTime = 0;
  
  // === ОБЛАЧНОЕ ПОДКЛЮЧЕНИЕ ===
  char cloudUrl[128] = "";      // URL облачного сервера (напр. https://control.alcodist.ru)
  char cloudApiKey[64] = "";    // API ключ для авторизации
  bool cloudEnabled = false;      // Включить облачное подключение
  // =============================
};

class ConfigManager {
private:
  SystemConfig currentConfig;
  
public:
  ConfigManager() {}
  
  void begin();
  void loadConfig();
  void saveConfig();
  
  SystemConfig& getConfig();
  // Этап 4 (C2): потокобезопасная копия конфига для задачи на другом ядре.
  // Копируется под мьютексом — читающий поток не увидит «половину» записи.
  void getConfigCopy(SystemConfig& out);
  void setConfig(const SystemConfig& newConfig);
  
  bool startProcess(ProcessType process);
  void stopProcess();
  
  ProcessType getActiveProcess();
  bool isProcessRunning();
  bool isDistProcessRunning();
  bool isRectProcessRunning();
  
  // Отдельные методы для сохранения
  void saveDistConfig();
  void saveRectConfig();

  // Методы для работы с адресами датчиков
  void saveSensorAddress(int address, uint8_t* addr);
  void loadSensorAddress(int address, uint8_t* addr);
  
  // Функция расчета крепости
  float getABV(float temp, float pressure_mmHg, bool isOutput);
   // === НОВОЕ: Расчет температуры для смены тары ===
    // targetAbv - желаемая крепость в струе (например, 43.0)
    // pressure_mmHg - текущее давление в мм рт.ст.
    // Возвращает температуру куба, при которой нужно менять тару
    float getTempForOutputABV(float targetAbv, float pressure_mmHg);
    // Расчет крепости в струе по температуре куба
    float getOutputABVForTemp(float temp, float pressure_mmHg);
    // ================================================

private:
  // Вспомогательные методы для работы с EEPROM
  void writeInt(int address, int value);
  int readInt(int address, int defaultValue);
  void writeFloat(int address, float value);
  float readFloat(int address, float defaultValue);
  void writeBool(int address, bool value);
  bool readBool(int address, bool defaultValue);
  void writeULong(int address, unsigned long value);
  unsigned long readULong(int address, unsigned long defaultValue);
  void writeString(int address, const char* value, int maxLen);
  void readString(int address, char* value, int maxLen);
};

extern ConfigManager configManager;

#endif
