Vlad-alco/BuhloWar/ProcessCommon.h

#ifndef PROCESS_COMMON_H
#define PROCESS_COMMON_H

#include <Arduino.h>
#include "common.h"

// ==================== СТАТУСЫ ДАТЧИКОВ ====================
enum class SensorStatus {
    OK,         // Данные валидны
    OFF,        // Датчик не отвечает (потеря связи)
    NOT_FOUND,  // Датчик не обнаружен при инициализации
    N_USE       // Не используется в текущем процессе
};

// ==================== СОСТОЯНИЯ БЕЗОПАСНОСТИ ====================
enum class SafetyState {
    NORMAL,             // Все в норме
    WARNING_TSA,        // TSA > tsaLimit, идет отсчет vreac
    WARNING_BOX,        // boxTemp > boxMaxTemp
    EMERGENCY           // Авария (истек vreac, TSA все еще превышена)
};

// ==================== ТИПЫ АВАРИЙ ====================
enum class AlarmType {
    NONE,
    ALARM_TSA,          // 3 коротких сигнала каждые 30 сек
    ATTENTION_BOX       // 2 коротких сигнала каждые 30 сек
};

// ==================== СТРУКТУРА ДАННЫХ ДАТЧИКОВ ====================
struct SensorData {
    struct TempSensor {
        float value = -127.0f;         // Фильтрованное значение температуры
        SensorStatus status = SensorStatus::NOT_FOUND;
        String name = "";
    };
    
    // DS18B20 датчики
    TempSensor tsa;     // Температура в царге (верх)
    TempSensor aqua;    // Температура дистиллята/воды
    TempSensor tsar;    // Температура в царге (для ректификации)
    TempSensor tank;    // Температура в кубе
    
    // BME280 данные
    float boxTemp = -127.0f;    // Температура окружающей среды
    float pressure = 0.0f;      // Атмосферное давление (гПа)
    float humidity = 0.0f;      // Влажность (%)
    SensorStatus bmeStatus = SensorStatus::NOT_FOUND;
    
    unsigned long timestamp = 0; // Время считывания (мс)
    
    // Методы валидации
    bool isTsaValid() const { return tsa.status == SensorStatus::OK; }
    bool isTsarValid() const { return tsar.status == SensorStatus::OK; }
    bool isTankValid() const { return tank.status == SensorStatus::OK; }
    bool isAquaValid() const { return aqua.status == SensorStatus::OK; }
    bool isBmeValid() const { return bmeStatus == SensorStatus::OK; }
    
    // Возвращает давление в мм рт.ст. с fallback на 760 при неработающем датчике
    float getPressureMmHg() const {
        return isBmeValid() ? pressure * 0.75006f : 760.0f;
    }
};

// ==================== СТАТУС СИСТЕМЫ ДЛЯ UI ====================
struct SystemStatus {
    // Текущий процесс
    ProcessType activeProcess = PROCESS_NONE;
    bool isRunning = false;
    bool isPaused = false;
    
    // Этап процесса
    String stageName = "IDLE";         // "RAZGON", "WAITING", "OTBOR", "TELO" и т.д.
    String stageInfo = "";             // Доп. информация: "ST", "1", "1.33", "300"
    
    // Отформатированные строки для LCD (20 символов каждая)
    String line0 = ""; // Пример: "36.19 DIST  -     40"
    String line1 = ""; // Пример: "23.81 OTBOR       85"
    String line2 = ""; // Пример: "34.06 NORMA       "
    String line3 = ""; // Пример: "23.81 00:56       98"
    
    // Безопасность
    SafetyState safety = SafetyState::NORMAL;
    AlarmType alarm = AlarmType::NONE;
    int alarmTimerSec = 0;             // Остаток времени vreac (секунды)
    
     // === НОВОЕ: Флаг доступности BME280 ===
    bool bmeAvailable = true; 
    // ====================================
    
    // Сеть
    bool isOnline = false;
    String networkSymbol = "X";        // 'W' = роутер, 'A' = AP, 'X' = офлайн

    // Блокировка запуска процесса (заполняется при отказе checkSensorsReady)
    String sensorErrorMsg = "";        // Список датчиков с проблемой, например "TSA TANK"
        // === Статус калибровки датчиков (для Web) ===
    int webCalibStatus = 0;      // 0=IDLE, 1=ПОИСК, 2=НАЙДЕН, 3=ОШИБКА
    String webCalibSensorName = ""; // Имя датчика
    bool headTestActive = false;
int headTestRemainingSec = 0;
int headTestTotalSec = 0;

bool bodyTestActive = false;
int bodyTestRemainingSec = 0;
int bodyTestTotalSec = 0;

// Ожидание ввода мл после теста
bool testAwaitingInput = false;   // true = тест завершён, ждём ввода мл от оператора
String testAwaitingType = "";     // "head", "body_nc", "body_no"

    // === НОВЫЕ ПОЛЯ ДЛЯ ИНФОРМАЦИИ О ПРОЦЕССЕ (WEB) ===
    String rectMethodName = "";      // "KSS" или "STANDARD"
    String rectSubStage = "";        // "Spit", "Standard", "AkaTelo"
    int rectTimeRemaining = 0;       // Секунды до конца этапа
    int rectVolumeTarget = 0;        // Объем текущего под-этапа (мл)

    String bodyMethodName = "";      // "Шпора" или "Стандарт"
    float bodySpeed = 0.0f;          // Текущая скорость тела (мл/час)
    float bodyVolDone = 0.0f;        // Накопленный объём тела (мл)
    float headsSpeed = 0.0f;         // Реальная скорость голов (мл/час) - по capacity клапана
    float headsSpeedCalc = 0.0f;     // Расчётная скорость голов (мл/час) - эмпирическая для времени
    float headsVolDone = 0.0f;       // Накопленный объём голов (мл) - общий за все подэтапы
    float headsVolSub = 0.0f;        // Накопленный объём голов в текущем подэтапе (мл)
    int headsVolTarget = 0;          // Целевой объём для текущего подэтапа (мл) - расчётный
    int bodyCycle = 0;               // Номер цикла (для Стандарта)
    // ================================================
    // Завершение процесса
    unsigned long finishingRemainSec = 0; // Остаток таймера охлаждения (сек)
    // Время
    unsigned long processTimeSec = 0;  // COUNTALL (общее время процесса)
    unsigned long stageTimeSec = 0;    // Время текущего этапа
    
    // Текущие значения (для расчетов в UI)
    float currentTsa = 0.0f;
    float currentAqua = 0.0f;
    float currentTsar = 0.0f;
    float currentTank = 0.0f;
    float currentStrength = 0.0f;      // Текущая крепость
    float currentStrengthBak = 0.0f;   // Крепость в баке
    bool strengthOutValid = false;    // Крепость в струе определена (температура >= 78.5°C)
    bool strengthBakValid = false;    // Крепость в баке определена (температура >= 78.5°C)

    // Статус теста клапанов (для Web)
    struct {
        bool active = false;
        int type = 0;  // 0=none, 1=head, 2=body
        int remainingSec = 0;
        int totalSec = 0;
    } valveTest;
    
    // === СОСТОЯНИЕ МАСТЕРА КАЛИБРОВКИ КЛАПАНОВ ===
    struct CalibWizard {
        int valve = 0;           // 0=none, 1=heads, 2=body_nc, 3=body_no
        int step = 0;            // 0=idle, 1=dry_run, 2=capacity, 3=input_volume, 4=result
        bool isRunning = false;  // true = идёт таймер (пролив или capacity)
        int remainingSec = 0;    // Оставшиеся секунды
        int totalSec = 0;        // Общее время теста
        float volume = 0.0f;     // Введённый объём (мл)
        float capacity = 0.0f;   // Рассчитанный capacity (мл/мин)
    } calibWizard;
    // ==============================================
};

// ==================== КОМАНДЫ ОТ UI ====================
enum class UiCommand {
    // Нет команды
    NONE,
    UP,
    DOWN,
    // Запуск процессов
    START_DIST,
    START_RECT,
    
    // Управление процессами
    STOP_PROCESS,
    PAUSE_PROCESS,
    RESUME_PROCESS,
    
    // Ответы на диалоги
    DIALOG_YES,         // Общий ответ "ДА"
    DIALOG_NO,          // Общий ответ "НЕТ"
    NEXT_STAGE,
    TEST_HEAD,   // <--- Добавить
    TEST_BODY,
    STOP_TEST,
    CALC_VALVE, 
    // Специальные меню (RECT)
    ENTER_VALVE_CAL,
    ENTER_SET_PW_AS,
    SAVE_VALVE_CAL,
    SAVE_SET_PW_AS,
    
    // Ручное управление (только когда процесс не запущен)
    MANUAL_HEATER_ON,
    MANUAL_HEATER_OFF,
    MANUAL_VALVE_WATER_OPEN,
    MANUAL_VALVE_WATER_CLOSE,
    MANUAL_VALVE_HEAD_OPEN,
    MANUAL_VALVE_HEAD_CLOSE,
    MANUAL_VALVE_BODY_OPEN,
    MANUAL_VALVE_BODY_CLOSE,
    MANUAL_MIXER_ON,
    MANUAL_MIXER_OFF,
    
    // Команды для Web калибровки
    IDENTIFY_TSA,
    IDENTIFY_AQUA,
    IDENTIFY_TSAR,
    IDENTIFY_TANK,
    CANCEL_CALIBRATION,
    FINISH_CALIBRATION,
    
    // Команды мастера калибровки клапанов
    CALIB_START_DRY,           // Начать пролив (10 сек)
    CALIB_START_CAPACITY,      // Начать измерение capacity (60 сек, цикл 1с/1с)
    CALIB_SET_VOLUME,          // Ввести измеренный объём
    CALIB_CANCEL               // Отмена калибровки
};

// ==================== ОТВЕТЫ PROCESSENGINE ====================
enum class EngineResponse {
    // Результат выполнения
    OK,
    ERROR_BUSY,             // Уже запущен другой процесс
    ERROR_NO_PROCESS,       // Нет активного процесса для команды
    ERROR_INVALID_STATE,    // Команда недопустима в текущем состоянии
    ERROR_EMERGENCY,        // Система в аварийном состоянии
    
    // Требуется показать UI-состояние
    SHOW_WATER_TEST,
    SHOW_REPLACEMENT,
    SHOW_GOLOVY_OK,
    SHOW_VALVE_CAL,
    SHOW_SET_PW_AS,
    
    // Навигация
    SHOW_PROCESS_SCREEN,
    SHOW_PROCESS_MENU,      // НОВОЕ: Возврат в меню процесса
    SHOW_MAIN_MENU,
    
    // Аварии
    SHOW_EMERGENCY_SCREEN,
    
    // Ручное управление
    MANUAL_MODE_ENABLED,
    MANUAL_MODE_DISABLED
};

// ==================== КОНФИГУРАЦИОННЫЕ СТРУКТУРЫ ====================

// Общая глобальная конфигурация (меню SETTINGS)
// ПРИМЕЧАНИЕ (аудит): рабочая структура — SystemConfig (preferences.h). Эта
// структура в коде не используется. Дефолт tsaLimit согласован с рабочим
// диапазоном 40-55 °C (решение автора по Q1).
struct GlobalConfig {
    float tsaLimit = 45.0f;          // Макс. температура TSA (рабочий диапазон 40-55 °C)
    float boxMaxTemp = 45.0f;        // Макс. температура бокса
    int vreacDelay = 300;            // Время аварийной задержки (сек)
    float razgonTemp = 60.0f;        // Температура разгона
    int checkWifiInterval = 5;       // Интервал проверки WiFi (мин)
    bool wifiEnabled = true;         // Включить WiFi
    bool telegramEnabled = true;     // Включить уведомления
    bool soundEnabled = true;        // Включить звук
    int timezoneOffset = 3;          // Часовой пояс (UTC+3)
    bool use24hFormat = true;        // 24-часовой формат времени
    bool autoSyncTime = true;        // Автосинхронизация времени
    float pressureCorrection = 0.0f; // Коррекция давления
};

// Конфигурация процесса DIST (меню DIST_SETUP)
struct DistConfig {
    float bakStopTemp = 98.0f;       // Температура остановки бака
    float midtermTemp = 92.0f;       // Температура смены посуды
    bool useValve = true;            // Использовать клапан отбора
    bool fullPower = false;          // Полная мощность ТЭНа
    bool mixerEnabled = false;       // Включить мешалку
    int mixerOnTime = 60;            // Время работы мешалки (сек)
    int mixerOffTime = 180;          // Время паузы мешалки (сек)
    bool useHeadValve = false;       // Использовать клапан голов
    int headCollectTime = 10;        // Время сбора голов (мин)
    bool autoStop = false;           // Автоостановка при достижении крепости
    float stopStrength = 40.0f;      // Крепость для автоостановки
};

// ПРИМЕЧАНИЕ (аудит, этап 3): мёртвая структура RectConfig удалена.
// Рабочая конфигурация — SystemConfig (preferences.h): в ней хранились
// те же поля с ДРУГИМИ дефолтами и единицами — «ловушка для будущих правок».
// ==================== МЕЖЗАДАЧНАЯ ОЧЕРЕДЬ КОМАНД ====================
#include <freertos/FreeRTOS.h>
#include <freertos/queue.h>

struct CommandMessage {
    UiCommand command;
    int param = 0;
    
    CommandMessage() : command(UiCommand::NONE), param(0) {}
    CommandMessage(UiCommand cmd, int p) : command(cmd), param(p) {}
};

// Глобальная очередь: AppNetwork (Core 0) → loop() (Core 1)
// Объявляем extern, определяем в .ino
extern QueueHandle_t commandQueue;
#endif // PROCESS_COMMON_H
