Vlad-alco/BuhloWar/ProcessEngine.h

#ifndef PROCESS_ENGINE_H
#define PROCESS_ENGINE_H

#include "SensorAdapter.h"
#include "OutputManager.h"
#include "ProcessCommon.h"
#include "preferences.h"
#include "ValveCalMenu.h"
#include "SetPwAsMenu.h"  
enum class TestType { NONE, HEAD, BODY };

struct TestStatus {
    bool active = false;
    TestType type = TestType::NONE;
    unsigned long startTime = 0;
    int durationSec = 0;
    // Снимок параметров на момент старта теста (для расчёта после завершения)
    int openSec = 0;    // headOpenSec или bodyOpenSec (секунды)
    int closeSec = 0;   // headCloseSec или bodyCloseSec (секунды)
    bool awaitingInput = false;  // тест завершён, ждём мл от оператора
};
class ProcessEngine {
public:
    // ИЗМЕНЕНО: Добавлен lcd
    void begin(LiquidCrystal_I2C* lcd, SensorAdapter* sensors, OutputManager* outputs, ConfigManager* cfgMgr);
    void update(); 
    EngineResponse handleCommand(UiCommand command, int param = 0);  // param для команд калибровки
    const SystemStatus& getStatus() const;
    // === Этап 4 (C2): потокобезопасное чтение статуса из другого ядра ===
    // Web-задача (ядро 0) обязана читать статус ТОЛЬКО через этот метод:
    // он возвращает согласованную копию из опубликованного снимка.
    // Прямая ссылка getStatus() остаётся для использования на ядре 1
    // (меню, loop) — там писатель и читатель в одной задаче.
    void getStatusCopy(SystemStatus& out) const;
    const SensorData& getSensorData() { return sensorAdapter->getData(); } // Геттер датчиков
    bool startProcess(ProcessType type);
    bool stopCurrentProcess();
    void emergencyStop();
    
    bool isProcessRunning() const;
    ProcessType getActiveProcessType() const;
    String getProcessName() const;
    String getStageName() const;
    // Методы для получения статуса теста
        // === НОВЫЕ МЕТОДЫ ДЛЯ РАЗДЕЛЬНЫХ ТЕСТОВ ===
    bool isHeadTestActive() const { return headTestStatus.active; }
    int getHeadTestRemaining() const { 
        if (!headTestStatus.active) return 0;
        unsigned long elapsed = (millis() - headTestStatus.startTime) / 1000;
        return (elapsed < headTestStatus.durationSec) ? (headTestStatus.durationSec - elapsed) : 0;
    }
    int getHeadTestTotal() const { return headTestStatus.durationSec; }

    bool isBodyTestActive() const { return bodyTestStatus.active; }
    int getBodyTestRemaining() const { 
        if (!bodyTestStatus.active) return 0;
        unsigned long elapsed = (millis() - bodyTestStatus.startTime) / 1000;
        return (elapsed < bodyTestStatus.durationSec) ? (bodyTestStatus.durationSec - elapsed) : 0;
    }
    int getBodyTestTotal() const { return bodyTestStatus.durationSec; }
    // Геттеры снимка параметров теста
int getHeadTestOpenSec()    const { return headTestStatus.openSec; }
int getHeadTestCloseSec()   const { return headTestStatus.closeSec; }
int getHeadTestDuration()   const { return headTestStatus.durationSec; }
int getBodyTestOpenSec()    const { return bodyTestStatus.openSec; }
int getBodyTestCloseSec()   const { return bodyTestStatus.closeSec; }
int getBodyTestDuration()   const { return bodyTestStatus.durationSec; }

void clearHeadTestAwait()   { headTestStatus.awaitingInput = false; }
void clearBodyTestAwait()   { bodyTestStatus.awaitingInput = false; }
    // Публичные методы для кнопок (для menu_rect.h)
    void handleUiUp();
    void handleUiDown();
    void handleUiSet();
    void handleUiBack();
    void updateNetworkStatus(char networkSymbol);  // 'W' / 'A' / 'X'
    // Геттеры состояния выходов (для JSON веб-интерфейса)
    bool isHeaterOn()       const { return outputManager ? outputManager->isHeaterOn()      : false; }
    bool isMixerOn()        const { return outputManager ? outputManager->isMixerOn()        : false; }
    bool isWaterValveOpen() const { return outputManager ? outputManager->isWaterValveOpen() : false; }
    // Геттеры референтных значений TELO
    float getRtsarM()  const { return rtsarM; }
    float getAdPressM() const { return adPressM; }

    // === Этап 2.1: УСКОРЕННЫЕ ЧАСЫ ПРОЦЕССА ===
    // В активном SIM возвращают сим-время (растёт speed× быстрее реального),
    // вне SIM — обычный millis(). ВСЕ таймеры этапов и объёмные интеграторы
    // движка таймятся от procNow() — поэтому полный разгон охватывает и
    // таймерные/объёмные этапы, а не только кривые датчиков. Таймеры тестов
    // клапанов и авто-стоп (реальная безопасность) остаются на millis().
    static unsigned long procNow();
private:
    SensorAdapter* sensorAdapter;
    OutputManager* outputManager;
    ConfigManager* configManager;
    ValveCalMenu* valveCalMenu;
    SetPwAsMenu* setPwAsMenu;
    TestStatus headTestStatus;
    TestStatus bodyTestStatus;
    DistConfig distConfig;  // ПРИМЕЧАНИЕ (аудит): не используется — кандидат на удаление (отдельное согласование)
    
    SystemStatus currentStatus;
    
    // === Этап 4 (C2): двойной буфер статуса ===
    // Как это работает (для новичка): ядро 1 непрерывно пишет в currentStatus.
    // Если ядро 0 читает те же поля в этот момент (String внутри!), можно
    // получить «порванное» значение и упасть. Поэтому в конце update()
    // готовый статус целиком копируется в один из двух буферов-снимков,
    // и указатель front переключается под мьютексом (микросекунды).
    // Читатель (ядро 0) всегда забирает ЦЕЛИКОМ готовый снимок.
    SystemStatus publishA;             // Снимок A
    SystemStatus publishB;             // Снимок B
    const SystemStatus* publishFront = &publishB;  // Текущий «передний» снимок для читателей
    void publishStatus();              // Публикация снимка в конце update() (ядро 1)
    // =========================================
    
    ProcessType activeProcess = PROCESS_NONE;
    
    bool processRunning = false;
    bool processPaused = false;
    bool emergencyState = false;
    bool dialogPending = false;
    // === Сессия 20: ручной переход на следующий этап (кнопка «ДАЛЕЕ» в веб) ===
    // Одноразовый флаг: ставится командой NEXT_STAGE, подхватывается ШТАТНЫМ
    // условием завершения текущего этапа (|| skipStageRequested) и сбрасывается
    // в changeStage(). Благодаря этому переход выполняется ровно тем же кодом,
    // что и естественное завершение этапа — все инициализации клапанов,
    // логирование и побочные эффекты сохраняются 1:1, дублирования логики нет.
    bool skipStageRequested = false;
    unsigned long lastShporaAdjustTime = 0; // Время последней корректировки Шпоры
    int shporaReductionCount = 0; // Количество снижений скорости в Шпоре
    unsigned long processStartTime = 0;
    unsigned long stageStartTime = 0;
    // === Этап 2.1: дедлайн авто-стопа РАБОЧЕГО хода SIM (РЕАЛЬНОЕ время,
    // защита забытого на стенде процесса). 0 = не вооружён (SIM выключен
    // или выбран сухой ход). Ставится в startProcess() ===
    unsigned long simAutoStopAt = 0;
    
    enum class Stage {
        IDLE,
        WATER_TEST,
        RAZGON,
        WAITING,
        OTBOR,
        REPLACEMENT,
        BAKSTOP,
        NASEBYA,
        VALVE_CAL,
        SET_PW_AS,
        GOLOVY,
        GOLOVY_OK, // Новый этап
        TELO,
        FINISHING_WORK
    };

    // Подэтапы GOLOVY
    enum class GolovyStage {
        IDLE,
        ST_MAIN,        // Стандартный метод (10%)
        KSS_SPIT,       // КСС этап 1: Плевок (2%)
        KSS_STANDARD,   // КСС этап 2: Стандарт (3%)
        KSS_AKATELO     // КСС этап 3: Добор (15%)
    };
    
    GolovyStage currentGolovyStage = GolovyStage::IDLE;
    
            // Переменные для GOLOVY
    unsigned long golovyTargetTime = 0; // Время цели для этапов GOLOVY (сек)
    
    // Переменные для TELO
    float rtsarM = 0.0f;          // Запомненная температура TSAR (Reference Temp)
    float adPressM = 0.0f;         // Запомненное давление (гПа)
    // BME-статус на этапе TELO (member вместо static)
    bool teloBmeReferenceCaptured = false;
    bool teloBmeWasAvailable = true;
    // Сессия 16: отложенный захват опорных значений ТЕЛО (rtsarM + adPressM).
    // teloRefCaptured — референс уже зафиксирован (до этого реакции на Δ/Залёт
    // отключены: отклонение не от чего считать). teloRefTimerStart — момент
    // входа в ТЕЛО, от него отсчитывается cfg.teloRefDelayMin минут.
    bool teloRefCaptured = false;
    unsigned long teloRefTimerStart = 0;
    int teloLastOpenMs = -1;
    int teloLastCloseMs = -1;
    
    // Переменные для метода Шпора
    float bodyOpenCor = 0.0f;      // Скорректированное время открытия клапана тела (СЕКУНДЫ × koff)
    float speedShpora = 0.0f;      // Текущая скорость отбора для Шпоры (л/ч)
    
    // Вспомогательные переменные расчета
    float koff = 0.0f;
    float speedGolovy = 0.0f; // Скорость голов (мл/ч)
    float speedTelo = 0.0f;   // Скорость тела (мл/ч)
    
    // Накопленный объём голов и таймер расчёта
    float headsVolDone = 0.0f;    // Общий объём голов за все подэтапы
    float headsVolSub = 0.0f;     // Объём голов в текущем подэтапе
    float bodyVolDone = 0.0f;     // Накопленный объём тела (мл)
    unsigned long lastVolCalcTime = 0;
    
    Stage currentStage = Stage::IDLE;
    Stage previousStage = Stage::IDLE;
    
    int counter = 0;
    int nasebTimeOverride = 0;    // Одноразовая подмена времени стабилизации (мин).
                                  // 0 = использовать cfg.nasebTime. Ставится при залёте
                                  // (повторная стабилизация = reklapTime), сбрасывается
                                  // в startProcess(). Нужна, чтобы НЕ портить общий
                                  // конфиг: старый код писал reklapTime прямо в
                                  // cfg.nasebTime, и искажённое значение попадало
                                  // в EEPROM при любом последующем сохранении.
    float initialTsarTemp = 0.0f;
    bool waitingRefCaptured = false; // Точка отсчёта этапа WAITING захвачена валидным замером
    bool razgonMixerStarted = false;
    bool midtermHandled = false;
    
    void checkSafety();
    // Проверка готовности датчиков перед запуском процесса.
    // Возвращает true если все 4 датчика откалиброваны и отвечают.
    // При false заполняет errorMsg именами проблемных датчиков (для LCD и лога).
    bool checkSensorsReady(String& errorMsg);
    unsigned long alarmStartTime = 0;
    bool alarmTSA_Active = false;
    bool alarmBOX_Active = false;
    
    void printStartupInfo();
    
    void handleIdleState();
    void handleWaterTest();
    void handleRazgon();
    void handleWaiting();
    
    void handleDistOtbor();
    void handleDistReplacement();
    void handleDistBakstop();
    
    void handleNasebya();
    void handleRectProcess(); 
    void handleGolovyOk();
    void handleFinishingWork();
    
    void updateDisplayData();
    void syncConfig();
    void changeStage(Stage newStage);
    String formatTimeMMSS(unsigned long seconds) const;

    void handleGolovy();
    void calcValveTiming(float targetSpeed, float capacity, int& openMs, int& closeMs);
    void startStandardGolovy(SystemConfig& cfg);
    void startKssSpit(SystemConfig& cfg);
    void startKssStandard(SystemConfig& cfg);
    void startKssAkaTelo(SystemConfig& cfg);
    void finishGolovyStage();
    void handleTelo();
    void finishTelo(SystemConfig& cfg);
    const char* getStageName(Stage stage);
    void updateRectWebInfo();
};

#endif
