Vlad-alco/BuhloWar/SDLogger.h

#ifndef SDLOGGER_H
#define SDLOGGER_H

#include <Arduino.h>
#include <FS.h>
#include <SD.h>
#include <time.h> 
#include <freertos/FreeRTOS.h>
#include <freertos/semphr.h>

// === ИЗМЕНЕНО: Уменьшен лимит до 100 КБ ===
// 100 КБ хватит на ~1 час детального лога
const unsigned long MAX_LOG_SIZE = 102400; 
// ==================================================

// === ГЛОБАЛЬНЫЙ МЬЮТЕКС ДЛЯ SD КАРТЫ ===
// Объявлен в .ino файле, создаётся в setup()
// Защищает SPI шину от одновременного доступа с разных ядер ESP32
extern SemaphoreHandle_t sdMutex;
// =======================================

// === КЛАСС ДЛЯ АВТОМАТИЧЕСКОГО ЗАХВАТА МЬЮТЕКСА ===
// При создании - захватывает мьютекс
// При уничтожении (выход из области видимости) - освобождает
class SDScopeLock {
public:
    bool locked = false;  // Флаг: мьютекс успешно захвачен

    SDScopeLock() {
        if (sdMutex) {
            // Таймаут 500 мс вместо 5000 мс (Причина №4).
            // Вызывается из Core 1 (logger.log) и Core 0 (readLastLog).
            // Если мьютекс недоступен — лучше пропустить операцию,
            // чем блокировать поток на 5 секунд.
            locked = xSemaphoreTake(sdMutex, pdMS_TO_TICKS(500));
        }
    }
    ~SDScopeLock() {
        if (sdMutex && locked) {
            xSemaphoreGive(sdMutex);
        }
    }
    // Запрещаем копирование
    SDScopeLock(const SDScopeLock&) = delete;
    SDScopeLock& operator=(const SDScopeLock&) = delete;
};
// ==================================================

class SDLogger {
public:
    void init() {
        // Ничего не делаем. SD должна быть инициализирована раньше (в AppNetwork).
    }

    void log(const String &message) {
        // === БЕЗОПАСНАЯ ПРОВЕРКА SD ===
        // Если SD ещё не проверяли - проверяем один раз
        if (!sdChecked) {
            // Первичная проверка - без мьютекса, т.к. вызывается только из Core 1
            sdAvailable = (SD.cardSize() > 0);
            sdChecked = true;
            
            // === Этап 6: восстанавливаем РЕАЛЬНЫЙ размер /system.log после ребута ===
            // Как было: currentFileSize стартовал с 0, хотя файл мог содержать
            // до 100 КБ лога. Ротация не срабатывала, пока не дописывалось ещё
            // 100 КБ — файл распухал вдвое сверх лимита.
            if (sdAvailable) {
                SDScopeLock lock;
                if (lock.locked) {
                    File f = SD.open("/system.log", FILE_READ);
                    if (f) {
                        currentFileSize = f.size();
                        f.close();
                        Serial.printf("[SDLogger] Existing log size: %u bytes\n", (unsigned)currentFileSize);
                    }
                }
            }
        }
        
        if (!sdAvailable) {
            // SD недоступна - выводим только в Serial
            Serial.println("[NO SD] " + message);
            return;
        }

        // === ОПТИМИЗАЦИЯ: Проверка размера ===
        // Проверяем, превысил ли *отслеживаемый* размер лимит.
        // Это быстрее, чем открывать файл и вызывать .size() каждый раз.
        if (currentFileSize > MAX_LOG_SIZE) {
            rotateLogs();
            currentFileSize = 0; // Сбрасываем счетчик после ротации
        }
        // =====================================

        // Формируем строку (это быстро, мьютекс не нужен)
        String timeStr = getTimeStr();
        String logLine = "[" + timeStr + "] " + message;

        // === КРИТИЧЕСКАЯ СЕКЦИЯ: работа с SD ===
        {
            SDScopeLock lock;  // Захват мьютекса (автоматически, таймаут 500мс)
            if (!lock.locked) {
                // Мьютекс не получен — пропускаем запись лог-строки.
                // Лог не критичен, лучше пропустить чем блокировать Core 1.
                Serial.println("[SDLogger] Mutex busy, log line skipped");
                Serial.println("[NO SD] " + logLine);
                return;
            }

            // Пишем на SD карту с retry
            const int maxRetries = 3;
            File file;
            for (int retry = 0; retry < maxRetries; retry++) {
                file = SD.open("/system.log", FILE_APPEND);
                if (file) break;
                delay(10);  // Пауза между попытками
            }
            
            if (file) {
                file.println(logLine);
                // Обновляем счетчик размера (длина строки + 2 байта на \r\n)
                currentFileSize += logLine.length() + 2; 
                file.close();
            }
            // При выходе из блока lock уничтожается -> мьютекс освобождается
        }
        // ======================================

        // Выводим в Serial (не требует мьютекса)
        Serial.println(logLine);
    }

    void log(const String &label, int value) { log(label + String(value)); }
    void log(const String &label, float value) { log(label + String(value, 2)); }

    String readLastLog() {
        if (!sdAvailable) return "SD Error";
        
        // === КРИТИЧЕСКАЯ СЕКЦИЯ: чтение с SD ===
        SDScopeLock lock;  // Захват мьютекса (таймаут 500мс)
        if (!lock.locked) {
            return "Log unavailable (SD busy)";
        }
        
        File file = SD.open("/system.log");
        if (!file) return "Log file not found";
        
        String content = "";
        
        // === Буфер 16 КБ ===
        const int bufferSize = 16384; 
        
        if (file.size() > bufferSize) {
            file.seek(file.size() - bufferSize);
        }
        
        content.reserve(bufferSize); 
        
        while (file.available()) {
            content += (char)file.read();
        }
        file.close();
        
        return content;
    }

    // === НОВЫЙ МЕТОД: последние N строк лога как JSON-массив ===
    // Сессия 9: окно чтения 1KB → 4KB, лимит по умолчанию 10 → 30 строк.
    // Зачем: старт этапа пишет 4-6 строк подряд, окно в 10 строк «выталкивало»
    // важные записи (Stage change) за секунды, а серии >10 строк между опросами
    // /api/status вообще не доходили до веб-интерфейса. 4KB вмещает ~30-40 строк.
    // Нагрузка: чтение 4KB с SD на каждый опрос остаётся быстрым (полный
    // readLastLog для кнопки ЛОГИ и так читает 16KB по требованию).
    // Возвращает: ["строка1","строка2",...] (новые сверху, старые внизу)
    String getLastLogLinesJson(int maxLines = 30) {
        if (!sdAvailable) return "[]";
        
        SDScopeLock lock;
        if (!lock.locked) return "[]";
        
        File file = SD.open("/system.log");
        if (!file) return "[]";
        
        // Читаем последнее окно 4KB — хватит на maxLines строк с запасом
        const int readSize = 4096;
        // Флаг: файл обрезан с начала (окно меньше файла) → первая строка
        // в окне может быть неполной («надкусанной» посередине).
        bool fileCut = (file.size() > (unsigned long)readSize);
        String content = "";
        content.reserve(readSize);
        
        if (fileCut) {
            file.seek(file.size() - readSize);
        }
        
        while (file.available()) {
            content += (char)file.read();
        }
        file.close();
        
        // === Фикс «надкусанной» первой строки (Сессия 9) ===
        // Если файл больше окна, чтение начинается с середины строки.
        // Пропускаем неполный фрагмент до первого '\n' — в JSON попадают
        // только целые строки. Если '\n' нет вовсе — фрагмент мусорный целиком.
        // При fileCut=false файл прочитан с начала — ничего не пропускаем.
        int startIdx = 0;
        if (fileCut) {
            int nl = content.indexOf('\n');
            startIdx = (nl >= 0) ? (nl + 1) : content.length();
        }
        
        // Разбиваем на строки, собираем ПОСЛЕДНИЕ maxLines (новые сверху).
        // Сканируем ВСЕ строки в окне без остановки по maxLines: каждая новая
        // строка сдвигает предыдущие вниз — после прохода lines[0..lineCount-1] =
        // последние maxLines строки, новейшая в index 0.
        // (Раньше цикл останавливался на maxLines, а всё, что оставалось после
        // него, приклеивалось в «хвост» одной склейкой из нескольких строк —
        // с окном 4KB и длинными строками это становилось достижимо.)
        String lines[maxLines];
        int lineCount = 0;
        
        for (int i = startIdx; i < content.length(); i++) {
            if (content.charAt(i) == '\n') {
                String line = content.substring(startIdx, i);
                line.trim();
                if (line.length() > 0) {
                    for (int j = maxLines - 1; j > 0; j--) {
                        lines[j] = lines[j - 1];
                    }
                    lines[0] = line;
                    if (lineCount < maxLines) lineCount++;
                }
                startIdx = i + 1;
            }
        }
        // Последняя строка (если нет \n в конце)
        if (startIdx < content.length()) {
            String line = content.substring(startIdx);
            line.trim();
            if (line.length() > 0) {
                for (int j = maxLines - 1; j > 0; j--) {
                    lines[j] = lines[j - 1];
                }
                lines[0] = line;
                if (lineCount < maxLines) lineCount++;
            }
        }
        
        // Формируем JSON-массив с экранированием
        String json = "[";
        for (int i = 0; i < lineCount; i++) {
            if (i > 0) json += ",";
            String escaped = lines[i];
            escaped.replace("\\", "\\\\");
            escaped.replace("\"", "\\\"");
            json += "\"" + escaped + "\"";
        }
        json += "]";
        
        return json;
    }
    
    // Читает только НОВЫЕ записи с момента последнего вызова (для облака)
    String readNewLog(unsigned long &lastSize) {
        if (!sdAvailable) return "";
        
        SDScopeLock lock;
        // Этап 5: без проверки lock.locked чтение шло бы В ОБХОД мьютекса —
        // параллельный SPI-доступ с ядром 1 повреждает шину.
        if (!lock.locked) return "";
        
        File file = SD.open("/system.log");
        if (!file) return "";
        
        unsigned long fileSize = file.size();
        
        // Если файл уменьшился (ротация) - сбрасываем
        if (fileSize < lastSize) {
            lastSize = 0;
        }
        
        // Нет новых данных
        if (fileSize <= lastSize) {
            file.close();
            return "";
        }
        
        // Читаем только новую часть
        file.seek(lastSize);
        
        const int maxNewBytes = 2048;  // Макс 2KB за раз
        String newContent = "";
        newContent.reserve(maxNewBytes);
        
        int bytesRead = 0;
        while (file.available() && bytesRead < maxNewBytes) {
            newContent += (char)file.read();
            bytesRead++;
        }
        
        file.close();
        
        // Обновляем позицию
        lastSize = fileSize;
        
        return newContent;
    }
    
    bool isSdAvailable() { return sdAvailable; }

private:
    bool sdAvailable = false;
    bool sdChecked = false;  // Флаг: уже проверяли SD
    // === НОВАЯ ПЕРЕМЕННАЯ ===
    unsigned long currentFileSize = 0; 
    // ========================

    String getTimeStr() {
        time_t now = time(nullptr);
        if (now > 1609459200) {
            struct tm* timeinfo = localtime(&now);
            char buffer[20];
            strftime(buffer, 20, "%d.%m.%Y %H:%M:%S", timeinfo);
            return String(buffer);
        } else {
            return String(millis() / 1000) + "s";
        }
    }

    void rotateLogs() {
        // === КРИТИЧЕСКАЯ СЕКЦИЯ: ротация логов ===
        // Вызывается из log(), который уже держит мьютекс
        // Поэтому здесь мьютекс НЕ захватываем повторно!
        
        Serial.println("[Logger] Rotating logs...");
        // Удаляем самый старый
        if (SD.exists("/system5.log")) SD.remove("/system5.log");
        if (SD.exists("/system4.log")) SD.rename("/system4.log", "/system5.log");
        if (SD.exists("/system3.log")) SD.rename("/system3.log", "/system4.log");
        if (SD.exists("/system2.log")) SD.rename("/system2.log", "/system3.log");
        if (SD.exists("/system1.log")) SD.rename("/system1.log", "/system2.log");
        
        // Переименовываем текущий лог
        SD.rename("/system.log", "/system1.log");
        
        // sdAvailable остается true, счетчик currentFileSize сбрасывается в log()
    }
};

extern SDLogger logger;

#endif
