Vlad-alco/BuhloWar/(commit log)

2026-03-28 Оптимизация CloudManager: ротация запросов (один за вызов)
    - Макс. блокировка loop снижена с 6 сек до 2 сек
    - Интервал settings увеличен с 30 сек до 60 сек
    - Удалён неиспользуемый ProcessConfigs.h (дубликат структур)
    Подробности в CHANGELOG.md
2026-03-28 LCD обновление: интервал 500 мс (было 200 мс)
    - Снижена нагрузка на I2C шину в 2.5 раза
    - Обновление 2 раза/сек достаточно для процесса
2026-03-29 Web-интерфейс: адаптивность через CSS media queries
    - Телефон (портрет): 1 колонка меню, компактные элементы
    - Телефон (ландшафт): компактный режим
    - Планшет: увеличенные элементы
    - ПК: широкий контейнер (1024px)
    - Большой монитор: максимальная ширина (1280px)
2026-03-29 Web-интерфейс: исправление мобильной адаптивности (портрет + ландшафт)
2026-03-29 Инфопанель: убрано давление (есть отдельный блок), grid-cols-5
2026-03-29 Fix: null guard для pressure-value (updateUI падал без элемента)
2026-03-29 Fix: облако показывает -1 сек назад (Math.max(0, floor(...)))
2026-03-29 Мониторинг: блок АД перемещён внутрь карточки с диаграммой (справа от температур)
2026-03-29 Все фиксы + АД внутри диаграммы + адаптивность (из актуального файла пользователя)
2026-03-29 Актуальная версия пользователя (все фиксы + АД внутри диаграммы + адаптивность)
2026-03-29 Мониторинг: АД перемещён внутрь карточки с диаграммой
2026-03-31 fix: калибровка из Web + блок ТЕЛО мониторинг
    ProcessEngine.cpp:
    - Перенёс обработку CALIB_START_DRY/CAP/CANCEL ДО проверки VALVE_CAL stage,
    иначе команды калибровки перехватывались и не доходили до startCalibFromWeb()
    index.html:
    - Блок ТЕЛО мониторинг: добавлен расч/факт (--/-- мл) по аналогии с ГОЛОВЫ
    - Убраны дублирующие ОТОБРАНО и ПРОГНОЗ
    - Добавлен null-check для bodyPredictEl (исправление TypeError)
    - Мастер калибровки: fetch запросы теперь р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
    [ProcessEngine.cpp]
2026-03-31 fix: мастер калибровки закрывается + отладка NEXT_STAGE
    - Мастер калибровки автоматически закрывается через 2 сек после расчёта capacity
    - Добавлен лог для отладки NEXT_STAGE: показывает currentStage при получении команды
    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
    [ProcessEngine.cpp]
2026-03-31 CHANGELOG: изменения 31.03.2026
2026-03-31 fix: NEXT_STAGE command blocked by early return in VALVE_CAL block
    Moved NEXT_STAGE handler BEFORE the VALVE_CAL early-return block.
    Previously, when currentStage==VALVE_CAL, the return on line 411
    prevented NEXT_STAGE from being processed, making the DALEE button
    non-functional after valve calibration.
    [ProcessEngine.cpp]
2026-03-31 fix: kernel panic, remove Telegram deps, fix calib volume input
    1. CloudManager: reuse single WiFiClientSecure instead of creating
    new one per request (prevents heap fragmentation / kernel panic)
    2. AppNetwork: remove UniversalTelegramBot.h include, bot creation,
    and TELEGRAM_CERTIFICATE_ROOT loading (saves ~20KB RAM)
    3. ValveCalMenu: integer volume input (step 1 ml instead of 0.1),
    initialize enteredVolume from current cap value on step 3
    4. index.html: integer volume display, initialize from config cap,
    prevent reset to 0 when transitioning to input step
    [AppNetwork.cpp, AppNetwork.h, CloudManager.h, ValveCalMenu.h]
2026-03-31 fix: remove orphan Telegram method implementations from AppNetwork.cpp
    Removed queueMessage, isTelegramReady, sendTelegramNow, processMessageQueue
    implementations that no longer have declarations in AppNetwork.h
    [AppNetwork.cpp]
2026-03-31 fix: restore TELO block changes (total/done format like GOLOVY)
    - TELO header: ТЕЛО: прогноз/отобрано мл (like ГОЛОВЫ format)
    - Removed separate 'Отобрано' and 'Прогноз' lines
    - Replaced bodyPredictEl/bodyVolEl with bodyTotalEl/bodyDoneEl
    - All null-checks preserved
2026-04-03 Обновление рабочих
2026-04-03 обновление
2026-04-03 fix: TELO remaining time recalculation in Shpora method
    Old formula: predictVol / speedShpora - elapsedSec
    This assumed current (reduced) speed was used from the start,
    overestimating remaining time after each speed reduction.
    New formula: (predictVol - bodyVolDone) / speedShpora
    Correctly calculates how much volume is left at current speed.
    bodyVolDone accumulates at actual speed, so this is always accurate.
    [ProcessEngine.cpp]
2026-04-05 fix: prevent 3-min loop freeze when cloud server unreachable
    1. _client.stop() before each http.begin() — closes stale TCP
    connection, prevents TCP retransmission timeouts (1→2→4→8→16s)
    that blocked loop for up to 3 minutes
    2. Exponential backoff on errors — intervals increase: 2s → 4s → 8s → 16s → 32s
    (max multiplier x5). Reset to normal on first success.
    3. Update lastCheckMs even on error — prevents hammering dead server
    on every loop iteration
    4. Added backoff logging: [Cloud] Backoff: errorCount=N, next interval=X ms
    CloudManager.h only, no other files changed.
    [CloudManager.h]
2026-04-05 fix: _client.stop() only on error, reuse connection on success
    Previous version called _client.stop() before every request, forcing
    new TLS handshake each time (2-5 sec overhead) even when server was
    working fine. This caused web interface from SD card to lag.
    Now _client.stop() is called only when errorCount > 0 (previous request
    failed = dead TCP connection). On success the connection is reused with
    zero overhead, same as before the backoff changes.
    [CloudManager.h]
2026-04-05 refactor: move all HTTP to FreeRTOS task on core 0
    update() no longer does HTTP — zero loop blocking.
    Architecture:
    - Main loop (core 1): update() copies telemetry via mutex (~2μs),
    reads command/settings queues, calls callbacks. Zero delay.
    - Cloud task (core 0, priority 0): does HTTP requests, backoff,
    _client management. Blocked only in this task.
    - Commands/settings go through FreeRTOS queues (cloud → main).
    - Callbacks (onCommand, onSettings) called from main loop — safe.
    Benefits:
    - Loop never blocks on HTTP regardless of server state
    - LCD and web from SD: zero latency
    - Server down: cloud task backs off, main loop unaffected
    - Connection reuse preserved (no unnecessary T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
    [CloudManager.h]
2026-04-05 Add files via upload
    файл с хостинга
2026-04-05 fix: eliminate false errorCount from disabled settings check + add settings_last_update to api.php
    - checkSettings() returned false when onSettings callback was nullptr,
    causing cloud task to count it as network error every 60 sec
    - Changed to return true (not an error, feature just not used)
    - api.php GET settings now returns settings_last_update timestamp,
    previously missing which made cloud->device settings mechanism dead
    [CloudManager.h]
2026-04-05 fix: prevent Kernel Panic from early HTTP requests during boot
    - NetworkTask starts on core 0 before processEngine.begin(), creating
    a ~1-2 sec window where browser requests crash via nullptr dereference
    (processEngine->getSensorData() -> sensorAdapter = nullptr)
    - Added systemReady flag to AppNetwork
    - All server->handleClient() calls guarded by systemReady check
    - appNetwork.setSystemReady(true) called after ALL initialization
    - Protected: update(), beginNetwork(), connectToWiFi() (both SSIDs),
    checkInternet()
    [AppNetwork.cpp, AppNetwork.h]
2026-04-05 fix: WEB body monitoring visible during NASEBYA + phantom volume fix
    - Problem 1: WEB showed '--' for body method/speed/cycle/volume during
    NASEBYA (on self) in Standard method
    - C++: updateRectWebInfo() now preserves body data at NASEBYA stage
    - JS: three places changed to show body block at TELO||NASEBYA
    - NASEBYA shows cycle indicator with 'on self' marker
    - Problem 2: phantom volume accumulated during NASEBYA
    - lastVolCalcTime was frozen during NASEBYA, first dt_h after return
    covered entire NASEBYA duration, adding speed*NASEBYA_time to bodyVolDone
    - Fix: lastVolCalcTime = millis() before changeStage(TELO) in handleNasebya()
    - Shpora unaffected: it calls finishTelo() o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
    [ProcessEngine.cpp]
2026-04-05 CHANGELOG: REF TSAR/REF АД и коррекция давления в TELO - документация
2026-04-05 PowerManager.md - архитектура управления мощностью (ZMPT101B + DIMMERLINK)
2026-04-05 DisplayUpgrade.md - анализ вариантов 7" сенсорного монитора
2026-04-05 ESP32S3_DisplayUpgrade.md - анализ Waveshare ESP32-S3 + 7" дисплей
2026-04-05 favicon добавлен
2026-04-05 index_mobile.html - мобильная адаптация (тестовая копия)
2026-04-05 index_mobile.html - Top Control Bar: одна строка на мобилке (gap уменьшен)
2026-04-05 index_mobile.html - Control Bar: flex вместо grid, уменьшены кнопки/шрифт на мобилке
2026-04-05 index.html - мобильная адаптация: header, control bar, gauge
2026-04-05 CHANGELOG: мобильная адаптивность WEB интерфейса + favicon
2026-04-06 index_landscape.html - футуристичный HUD интерфейс (landscape)
2026-04-06 fix: полный рефакторинг layout для горизонтального интерфейса
    - viewport: width=device-width вместо width=1024
    - .hud-container: явный grid-template-columns: 1fr, width: 100%
    - .hud-main: width: 100%, min-width: 0 (убран бесполезный flex:1)
    - .page-monitoring: 3 ряда (1fr 1fr auto), minmax() для колонок
    - gauge-panel: grid-row 1/3, адаптивный gauge-wrapper (100%, max 400px)
    - baro+sys обёрнуты в .monitor-right-col (flex-column)
    - bottom calc: .monitor-bottom-row с явным grid-row:3, grid-column:1/-1
    - min-width: 0 на всех grid-элементах для предотвращен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
2026-04-06 fix: масштабируемость - minmax снижены, overflow:auto
    - .hud-main: overflow:hidden -> overflow:auto (прокрутка вместо обрезки)
    - .page-monitoring: minmax снижены (160/220/120 вместо 180/280/140)
    - .page-monitoring: min-width: 540px (появится скролл при сужении)
    - .monitor-bottom-row: min-width: 400px
    - .page-secondary: min-width: 540px
    - Минимальная комфортная ширина: ~580px
    - Минимальная комфортная высота: ~440px
2026-04-06 feat: полный функционал - все страницы, диалоги, JS функции
    Новые HTML-элементы:
    - Дистилляция: mixerOnTime, mixerOffTime
    - Ректификация: rect-golovy-info, rect-telo-info (vol/method/speed/cycle)
    - Ректификация: полный блок калибровки клапанов (minOpenTime, 3 клапана)
    - Настройки: облачный режим, профили, инструкция, логи
    - Мониторинг: ПОДЭТ. ОБЪЁМ (head-vol-target, head-vol)
    - 6 диалоговых панелей (dialog, alert, save/load profile, calc, calib wizard)
    Новые JS-функции (34):
    - C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
2026-04-06 Full landscape HUD: all pages, fixes, dialogs, calibration wizard
2026-04-06 fix: исправлена вложенность page-secondary divs — страницы были скрыты внутри друг друга
2026-04-06 UI доработки: шапка, яркий текст, цветные заголовки, анимация диаграммы, тест звука в настройках
2026-04-06 [2026-04-07] Сессия - последние штрихи интерфейса
    Задача:
    1. Исправить подписи клапанов в ректификации
    2. Унифицировать размер кнопок на всех страницах
    3. Компактное размещение кнопок в окне Настройки
    Решение:
    - КЛ.ГОЛОВ → ИСП.КЛ.ГОЛОВ, КЛ.ТЕЛО → ТИП.КЛ.ТЕЛО
    - Добавлен CSS класс .action-btn (padding:10px, font-size:12px) с цветными вариантами (amber/green/blue/purple)
    - Все кнопки в Настройках переведены на .action-btn, одинако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
2026-04-06 [2026-04-07] CHANGELOG: последние штрихи интерфейса
2026-04-06 [2026-04-07] Диаграмма: риски БАК СТОП/РАЗГОН, ярче разметка, toast СОХРАНЕНО, индикатор интернета
    1. Нет рисок БАК СТОП и РАЗГОН ДО на диаграмме
    2. Нет подтверждения сохранения настроек
    3. Внешняя разметка диаграммы тусклая
    4. Индикатор интернета в шапке
    1. Диаграмма: добавлены риски БАК СТОП (фиолетовый, метка СТОП) и РАЗГОН ДО (оранжевый, метка РАЗГ) по аналогии с TSA (красный).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
2026-04-06 [2026-04-07] Фикс: РАЗГОН→СМЕНА ТАРЫ, риски на своих кольцах
    Исправление: вместо razgonTemp теперь midterm (температура смены тары в кубе).
    Риски теперь на своих кольцах как в старом интерфейсе:
    - TSA (красный) на кольце TSA
    - СТОП (оранжевый #f97316) на кольце БАК
    - ТARA (жёлтый #facc15) на кольце БАК
    Изменённые файлы:
    index_landscape.html: markers array в drawGauge()
2026-04-06 [2026-04-07] Фикс: online не копировался, подписи индикаторов, LOK/CLD
    Баг: поле online не было в списке копируемых полей syncData — обе точки всегда красные.
    Фикс: добавлен online в массив полей.
    Шапка индикаторы:
    - Каждая точка теперь с подписью: [●API] [●INET] [W LOK]
    - API = подключение к ESP32 (зелёный если syncData успешен)
    - INET = доступ к интернету (green/red из поля online)
    - W/A/C/X + подпись LOK (локальный, серый) или CLD (облачный, си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
2026-04-06 [2026-04-07] Фикс: прогресс-бар калибровки не двигался
    Баг: переменная elapsed объявлялась внутри if(dryTime&&...) и была
    недоступна в if(dryBar&&...) — прогресс-бар и таймер не обновлялись.
    То же самое для шага 2 (capacity).
    Фикс: elapsed вынесена в общий if(cw.totalSec>0) блок,
    доступный и для таймера и для прогресс-бара.
    index_landscape.html: updateCalibWizardUI()
    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
2026-04-07 [2026-04-08] Инженерное меню: C++ backend + WEB UI + фикс NTP таймзоны
    - preferences.h/cpp: 15 новых полей в SystemConfig (engineering menu)
    - ProcessEngine.cpp: замена ~20 хардкодов на cfg.поля (скорости, доли, времена, давление)
    - OutputManager.h/cpp: SAFE_SHUTDOWN_DURATION стал настраиваемым
    - AppNetwork.cpp: NTP таймзона читается из config (был хардкод UTC+3)
    - AppNetwork.cpp: API: eng{} block в buildCfgJson + handleApiSettings
    - index_landscape.html: инженерное меню (wrench в настройках, диалог с подтверждением)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
2026-04-08 [2026-04-08] Доработки инженерного меню: переименования, перенос кнопки, фикс shporaStabMs мс↔сек
2026-04-08 [2026-04-08] Диапазоны настроек: cfgRanges для всех 21 параметров WEB, emergencyTime max 5→10 LCD
2026-04-08 [2026-04-08] Диапазоны всех параметров WEB: power max 7000, minOpenTime max 2000, midterm/[abv] max 98, cycleLim max 5; LCD синхронизация
2026-04-08 [2026-04-08] CHANGELOG: запись о диапазонах всех 21 параметра WEB + LCD
2026-04-09 [2026-04-08] Фикс: minOpenTime ограничивался 1000 при загрузке из API, speedHeadCorr/BodyCorr min был 0 — приведено к cfgRanges
2026-04-09 [2026-04-09] CHANGELOG: фикс minOpenTime хардкода при загрузке
2026-04-09 [2026-04-09] Добавлен .gitignore: skills/, .env, submodule-папки убраны из трекинга
    [astro.csv, charts.csv, colors.csv, flutter.csv, html-tailwind.csv, icons.csv, jetpack-compose.csv, landing.csv]
2026-04-09 [2026-04-09] Power Knob v2: реалистичная ручка-потенциометр, шкала наружу, без кнопок
2026-04-09 [2026-04-09] Power Knob v3: шкала ближе к ручке, убрано отображение значения
2026-04-09 [2026-04-09] Power Knob: фикс поворота указателя +90° для совпадения со шкалой
2026-04-09 [2026-04-09] Power Knob: нулевая риска, убран 'k', мелкие-голубые/крупные-оранжевые
2026-04-09 [2026-04-09] Power Knob: подписи 1-7 (без нулей), яркие цвета #ff8c00/#00f0ff
2026-04-09 [2026-04-09] Power Knob: внедрение в index_landscape.html, отдельный power_knob.js
2026-04-09 [2026-04-09] Power Knob: интеграция в копию index_landscape_knob.html (оригинал не тронут)
2026-04-09 [2026-04-09] Power Knob: инлайн-код вместо внешнего JS, автозагрузка без ESP32
2026-04-09 [2026-04-09] CHANGELOG: Power Knob + очистка репо
2026-04-09 [2026-04-10] index_landscape_knob.html: компоновка, 2 знака temps, навбар к контенту
2026-04-09 [2026-04-10] CHANGELOG: компоновка index_landscape_knob.html
2026-04-09 [2026-04-10] index_landscape_knob.html: навбар к контенту, убран margin-top:auto
2026-04-09 [2026-04-10] CHANGELOG: уточнение fixes навбар и margin-top:auto
2026-04-09 [2026-04-10] Gauge: шкала температур в стиле PowerKnob (amber/cyan)
2026-04-09 [2026-04-10] CHANGELOG: добавлен пункт 4 — шкала диаграммы в стиле PowerKnob
2026-04-09 [2026-04-10] Gauge: убрано фоновое свечение кольца шкалы
2026-04-09 [2026-04-10] Gauge: убран декоративный контур, только деления как у PowerKnob
2026-04-09 [2026-04-10] Gauge: убраны фоновые дуги колец температур
2026-04-09 [2026-04-10] Gauge: возвращены фоновые дуги колец температур, убран только фон шкалы
2026-04-09 [2026-04-10] Gauge: риски внутрь, мелкие 6px, средние 12px cyan
2026-04-09 [2026-04-10] CHANGELOG: детали шкалы диаграммы
2026-04-09 [2026-04-10] ВОДА: серая риска 50°C + красное кольцо при t>50°C
2026-04-09 [2026-04-10] Царга: риска расчётной температуры окончания ТЕЛО (real-time)
2026-04-09 [2026-04-10] CHANGELOG: риска окончания ТЕЛО на царге
2026-04-09 [2026-04-10] Мониторинг: сохранение объёмов голов/тела после FINISHWORK
2026-04-09 [2026-04-10] AI_RULES: заметка на будущее — финальные объёмы при FINISHWORK
2026-04-09 [2026-04-10] Фикс: конверсия единиц давления в расчёте teloEnd
2026-04-09 [2026-04-10] CHANGELOG: фикс конверсии давления в teloEnd
2026-04-09 Update CHANGELOG.md
    переделать риска окончания отбора на кольце тела не информативна
2026-04-09 решение с риской на полоске диаграммы царга не удачное
2026-04-09 [2026-04-10] Полосковый индикатор контроля ЦАРГИ (zoomed bar)
2026-04-09 [2026-04-10] Фикс: страница мониторинг не сползает вниз
2026-04-09 [2026-04-10] Фикс: max-height для monitoring вместо height:100%
2026-04-09 [2026-04-10] Фикс: мерцание tsar bar — ресайз canvas только при изменении размеров
2026-04-10 Fix: округление диапазона шкалы ЦАРГИ до 0.1°C для устранения мерцания
2026-04-10 Docs: запись о фикс мерцания шкалы ЦАРГИ в CHANGELOG
2026-04-10 Fix: полоска ЦАРГИ активна только при установленном rtsarM + защита от нулевого rangeW
2026-04-10 Docs: запись о фиксе логики активации полоски ЦАРГИ
2026-04-10 Fix: значения рисок правее шкалы, полоска сдвинута влево, минимальные отступы
2026-04-10 Docs: запись о компоновке шкалы и значений в CHANGELOG
2026-04-10 Fix: подписи рисок B/D/H, увеличен отступ слева
2026-04-10 Docs: обновлена геометрия блока ЦАРГИ
2026-04-10 New: тестовый файл для дугового барометра
2026-04-10 Fix: дуга сверху, стрелка по дуге, полноценная шкала с подписями
2026-04-11 Fix: увеличен таймаут WiFi подключения при холодном старте (3 попытки по 3 сек)
    [AppNetwork.cpp]
2026-04-11 Docs: запись о фикс WiFi таймаута в CHANGELOG
2026-04-11 Web UI: индикатор облачных данных + кнопка LANDSCAPE
    - index_landscape_knob.html: добавлен "Данные: X сек назад" после CLD в шапке
    - index_mobile.html: кнопка LANDSCAPE в блоке облачного режима для перехода к landscape-интерфейсу
    - CHANGELOG.md: запись о изменениях
2026-04-11 feat: add BME status indicator to UI
    - Add bmeWorking field to JSON API response (AppNetwork.cpp)
    - Add BME +/- status badge in Atmosphere block (index_landscape_knob.html)
    - Add BME +/- status badge in header after HEATER/MIXER/WATER icons (index_mobile.html)
    - BME + shown in cyan when sensor working, BME - in red when failed
    [AppNetwork.cpp]
2026-04-11 fix: add bmeWorking to buildTelemetryJson and add debug output
    - Add bmeWorking field to buildTelemetryJson() for cloud mode
    - Add debug Serial output for bmeStatus in handleApiStatus()
    - This fixes BME status showing undefined in some cases
    [AppNetwork.cpp]
2026-04-11 chore: remove debug Serial.print from AppNetwork.cpp
2026-04-11 fix: critical - add pressure fallback to 760 mmHg when BME not working
    - Added getPressureMmHg() method to SensorData with fallback
    - When BME fails (pressure=0), correction was giving +28°C error!
    - Fixed all pressure calculation points in ProcessEngine.cpp, AppNetwork.cpp
    - Now uses 760 mmHg as default when sensor not available
    - Updated CHANGELOG with critical fix details
    [AppNetwork.cpp, ProcessCommon.h, ProcessEngine.cpp]
2026-04-11 feat: proper BME pressure correction logic for TELO and Midterm
    Rules:
    1. No reference at stage start → correction disabled for entire stage, pressure = 760 mmHg
    2. Reference captured + BME lost → use frozen last values
    3. BME lost + restored → dynamic correction resumes
    Implementation:
    - TELO (rectification): bmeReferenceCaptured flag, pressure freeze/restore logic
    - OTBOR/Midterm (distillation): distBmeReferenceCaptured, distMidtermPressureMmHg
    - Updated CHANGELOG with detailed documentation
    [ProcessEngine.cpp]
2026-04-12 Create SSR.md `docs: добавить документацию по SSR и клапанам`
    `docs: добавить документацию по SSR и клапанам`
2026-05-31 Fix: AP→STA mode transition when WiFi connects in background
    - WiFi.disconnect(true) before WiFi.begin() for clean start on new AP
    - Increased connect timeout: 3×5sec=15sec (was 3×3sec=9sec)
    - Added AP→STA detection in update(): if WiFi.status()==WL_CONNECTED
    while in AP_MODE, switch to STA_MODE with internet check + NTP sync
    - Faster network check in AP mode: 10sec interval (was 30+sec)
    Fixes: system gets IP but stays in mode A instead of W, telemetry not sent
    [AppNetwork.cpp]
2026-05-31 Fix: Kernel Panic - WiFi.disconnect(true) kills AP mode + CloudManager stack overflow
    - WiFi.disconnect(true) -> WiFi.disconnect(false) + WiFi.mode(WIFI_AP_STA)
    disconnect(true) sets WIFI_OFF which kills AP mode that's already running.
    WebServer/DNS bound to dead interface -> Kernel Panic.
    disconnect(false) only disconnects from STA, keeps AP alive.
    - CloudManager stack: 8KB -> 16KB
    SSL/TLS requires 6-10KB stack, JSON+buffers ~4KB more.
    8KB was insufficient -> stack overflow -> Kernel Panic.
    - Added stack monitoring in CloudManager (every 60s)
    Logs free stack via uxTaskGetStackHighWaterMark.
    Warning if < 2KB free.
    [AppNetwork.cpp, CloudManager.h]
2026-05-31 Fix: CloudManager not initialized on AP->STA background transition + LCD symbol
    - Added didSwitchToSTA() flag in AppNetwork (edge-trigger, auto-reset)
    - CloudManager initialization in loop() when AP->STA detected
    Same config (URL, API key, command callbacks) as in setup()
    Guard: !cloudManager.isConfigured() prevents double init
    - LCD network symbol updated in idle mode (not only when process running)
    Static lastNetSymbol tracks changes, updates on transition
    [AppNetwork.cpp, AppNetwork.h]
2026-06-03 docs: Метод Горбунова - дистилляция зерновой браги
2026-06-03 docs: метод Горбунова — дистилляция зерновой браги (на основе реальных источников)
2026-06-03 docs: обновлённое описание метода Горбунова на основе реальных данных VK-обсуждения
2026-06-10 Аналитика: сравнение DS18B20 vs Pt100 + алгоритмы обнаружения шпоры
2026-06-10 docs: архитектура управления мощностью для BuhloWar v3.0 (Burst fire + SSR + PZEM-004T)
2026-06-29 Refactor DistSetupMenu class and settings items
    бакстоп до 100
2026-06-29 Add files via upload
    актуальные
2026-06-29 Update CHANGELOG.md
    открытая проблема со скоростью отбора
2026-07-08 Анализ системы
2026-07-08 fix: Web-интерфейс зависание — checkInternet() блокирует WebServer (Причина №1 из 5)
    - checkInternet(): 1 попытка вместо 3 (макс ~1 сек вместо 3 сек блокировки)
    - AP→STA переход: checkInternet/syncNTP отложены в следующий цикл update()
    (мгновенный переход вместо до 5 сек блокировки)
    - CHANGELOG: запись от 2026-07-09
    [AppNetwork.cpp]
2026-07-08 Fix: Причина №2 — пошаговый реконнект WiFi вместо блокирующего connectToWiFi() (до 9 сек)
    [AppNetwork.cpp, AppNetwork.h]
2026-07-08 Fix: Причина №3 — syncNTP таймаут getLocalTime() 2000→500мс
    [AppNetwork.cpp]
2026-07-08 Fix: Причина №4 — убран sdMutex из обработчика /, SDScopeLock таймаут 5000→500мс
    [AppNetwork.cpp, SDLogger.h]
2026-07-08 Fix: Причина №5 — handleListProfiles лимиты, буферное чтение, закрытие директории
    [AppNetwork.cpp]
2026-07-08 feat: двухточечная калибровка клапанов (HEADS импульс, BODY NC 2 точки, BODY NO 100%)
    - HEADS: калибровка на скорости отбора голов (импульсный режим вместо 100% open)
    - BODY NC: двухточечная калибровка — отдельно capacity для голов и тела
    Шаг 2/4: импульс на скорости голов → valve_body_capacity_heads (BCH)
    Шаг 3/4: импульс на скорости тела → valve_body_capacity (BCAP)
    - BODY NO: без изменений (100% open, 60 сек)
    - Обратный расчёт capacity: cap_true = V * 60 / (dutyCycle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
2026-07-08 feat: Web UI — двухточечная калибровка клапанов
    index.html + index_landscape_knob.html:
    - BODY NC: 4-шаговый wizard (dry → cap heads → input → cap body → input → result)
    - HEADS: 3-шаговый с импульсным режимом вместо 100% open
    - BODY NO: 3-шаговый без изменений (100% open)
    - Новые команды: CALIB_START_CAP_HEADS, CALIB_START_CAP_BODY
    - Двойной результат для BODY NC (H: / B:)
    - BODY NC статус показывает (H:xxx) при калиброванных головах
    - Адаптивные labels: Шаг 1/3 или 1/4 в зависимости от клап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
2026-07-08 docs: CHANGELOG — записи о двухточечной калибровке
2026-07-14 Update CHANGELOG.md
    Изменение web файлов интерфейса под новый стиль
2026-07-14 Rename index.html to index_old.html
    старая версия портретного интерфейса
2026-07-14 Rename index_landscape_knob.html to index_landscape_knob_old.html
    Старая версия ландшафтного интерфейса
2026-07-14 Rename index_mobile.html to index_mobile_old.html
    старая версия
2026-07-22 Рестайлинг интерфейса + температуры на SVG + блок Логи + новая компоновка дистилляции
    Сессии 1-9 (2026-07-14 — 2026-07-15):
    Landscape (index_landscape_knob.html):
    - Полный рестайлинг в dark glassmorphism (референс rect.marz-ban.ru)
    - Замена круговой диаграммы на анимированный SVG-аппарат
    - Две компоновки: ректификация (колонна с тарелками) + дистилляция (П-труба, перевёрнутый дефлегматор)
    - Бак Domspirt 37L по образцу domspirt.ru
    - Плашка Контр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
2026-07-22 Восстановление оригинального CHANGELOG.md + добавление записей сессий 8-9
2026-07-22 fix: CHANGELOG — новые записи (Сессия 8-9) перенесены в начало файла
2026-07-22 fix: даты в CHANGELOG исправлены на 22.07.2026
2026-07-22 fix: стабильность инициализации, big-endian EEPROM, статика→члены
    [AppNetwork.cpp, ProcessEngine.cpp, ProcessEngine.h, preferences.cpp]
2026-07-22 fix: убран блокирующий checkInternet() из update() — online=WiFi.status()
    [AppNetwork.cpp]
2026-08-27 fix: begin() now tries SSID2 after SSID1 fails at startup
    [AppNetwork.cpp]
2026-08-27 Fix: калибровка клапанов — расчёт capacity через ESP + импульсы при 500мс
    1. Web-мастер теперь отправляет CALIB_SET_VOLUME в ESP вместо прямого
    сохранения сырого объёма в /api/settings. ESP рассчитывает реальный
    capacity через backCalculateCapacity() и сохраняет в EEPROM.
    2. startCyclingForTest() использует фиксированный minOpen=500мс вместо
    cfg.minOpenTime, что даёт ~7 импульсов за 60с вместо 1-2.
    3. Добавлено поле capacityHeads в JSON-статус calibWizard.
    Файлы: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
    [AppNetwork.cpp, ProcessEngine.cpp, ValveCalMenu.h]
2026-08-27 Fix: восстановлено объявление cfg в startCyclingForTest()
    [ValveCalMenu.h]
2026-08-27 Update CHANGELOG: фикс cfg в startCyclingForTest
2026-08-27 Refactor: упрощённая калибровка клапанов — цикл 1с/1с для всех клапанов
2026-08-29 Update AI_RULES.md
    правка по работе
2026-08-29 Fix: этап 1 аудита — C1 (ре-инициализация TELO каждый цикл), L1 (мутация cfg.nasebTime), L2 (точка отсчёта WAITING)
    [ProcessEngine.cpp, ProcessEngine.h]
2026-08-29 Fix: этап 2 аудита — C3 (сбор телеметрии раз в 2с вместо каждого оборота loop), WDT (подписка loopTask на сторожевой таймер 30с, авто-перезагрузка при зависании), комментарий L3
    [OutputManager.cpp]
2026-08-29 Fix: этапы 3-6 аудита — единицы *Ms→*Sec + миграция EEPROM, C2 (мьютексы + двойной буфер статуса), C4 (api.php: ключ/LOCK_EX/дебаунс FCM/SSL), надёжность (BME-ретрай, удержание TSA, currentFileSize, 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
    [AppNetwork.cpp, ProcessCommon.h, ProcessEngine.cpp, ProcessEngine.h, SDLogger.h, SensorAdapter.cpp, SensorAdapter.h, SensorManager.cpp]
2026-08-30 Docs: плановые работы (бэклог) — время DS3231 (RTC отстаёт на 3ч до NTP) и медленное первое открытие веб-интерфейса (гейт systemReady). Диагностика + план; код не менялся
2026-08-30 UI+FW: блок ЛОГИ на место КОРРЕКЦИИ (макс. ширина), клиентский буфер 50 строк, окно лога 30 строк/4KB (SDLogger+AppNetwork), строки без даты, перенос на 2 строки, блок ДАННЫЕ, Коррекция % в заголовка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
2026-08-30 FW+UI: точность смены тары 0.1 — midterm/midterm_abv в десятых долях (миграция EEPROM v1->v2), триггер по float-порогу, крепость с 1 знаком на экранах (веб ±0.1/toFixed(1), LCD 0.1C, %.1f в статусе и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
2026-08-30 FW: согласование давления — уставка смены тары в приведённой T к 760 мм рт.ст. Триггер по живому давлению BME (заморозка при пропаче), web-конверсия крепость<->T по эталону 760, убран предфильтр сыро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
2026-08-30 UI: SVG-схема аппарата — дистилляция: бак x1.45->x1.7 (центр 290->260, нагрев под ним), температуры 28/24 (+подстрочники 12), верхняя строка-заголовок СМЕНА ТАРЫ (ОТБОР %, КУБ град прив.760, из cfg т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
2026-08-30 UI: SVG-схема — доработка по фидбеку: дистилляция бак x1.7->x2.0 с перестановкой (П-труба y320->66, дефлегматор/бутыль подняты в пустую верхнюю треть, баку освобождена ширина), правая колонка показан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
2026-08-30 FW+UI: ректификация — явный объём голов 'ГОЛОВЫ (ml)' для метода ST: задан (>0) — отбор ровно его без привязки к АС, после GOLOVY_OK -> ТЕЛО; 0 = авто (АС*доля, как раньше). KSS и оба расчёта сохране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
2026-09-07 Update BuhloWar.ino укорачивание вывода на LCD в стартовом экране
2026-10-03 BUGFIX(web-landscape): калибровка клапанов — пропускная способность не сохранялась (EEPROM затирался 0). _calibSend(cmd) игнорировала второй аргумент: submitCalibVolume передавала {volume} в никуда, 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
2026-10-03 FW+UI: ректификация — отложенный захват опорной температуры царги (rtsarM) и давления (adPressM) при старте отбора тела: фиксируются через cfg.teloRefDelayMin (инженерное меню, дефолт 5 мин, 0 = сраз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
2026-10-03 DOCS: руководство оператора-новичка — интерактивный HTML docs/USER_GUIDE.html. 16 раскрывающихся разделов: первое включение (SD, /www, AP ESP32/192.168.4.1), калибровка датчиков (нагрев +5°C), клапан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
2026-10-03 FW: ректификация — тайминги отбора голов для НЗ клапана во всех конфигурациях. Суть бага: duty=target/(capacity*60) требует capacity ТОГО клапана, который импульсит; в 3 местах подставлялась чужая — 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
2026-10-03 UI: веб-настройки — устранено 'не сохраняются значения инженерного меню' + откат значений кнопкой СОХРАНИТЬ. Причина (диагноз 22b, воспроизведён headless-тестом): флаг configDirty ставился любым ±/ту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
2026-10-13 FW+UI: безопасность индукции (вода после ФИНИША открыта при IND) + ручной переход «ДАЛЕЕ» на любой этап + ручная вода из веба. (1) IND-вода: при heaterType=1 система не управляет индукцией (оператор 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
2026-10-25 FW+UI: сигнальные гарды SensorManager — медиана-5, гейт правдоподобия, детектор подвисания 1-Wire, счётчики в вебе (Этап 1 плана 'точные датчики'). Повод: замечены скачки/подвисания показаний DS18B20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
2026-10-25 FW+UI: Этап 2 — режим SIM: синтетические датчики (сценарии дистилляции/ректификации), инжекция аномалий и панель «СИМУЛЯТОР» в вебе. Повод: реальные процессы недоступны до полугода — все изменения пр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
2026-10-25 FW+UI: Этап 2.1 — режим SIM: выбор хода СУХОЙ/РАБОЧИЙ, полное ускорение (сим-часы процесса), авто-стоп рабочего хода 60 мин, метка SIM на LCD. Решения автора: (1) без новых веток/репо — работа в main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
2026-10-27 Update AI_RULES.md добавление правил
2026-10-27 DOC: Этап 3 (MAX31865 + Pt100/Pt1000) — раскладка «что, зачем, как» без кода + ответы автора по железу. (1) Новый docs/STAGE3_MAX31865_PLAN.md: зачем (шпора 0.06C = квант DS18B20; Pt1000+MAX31865 даю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
